pranshukesavmishra/SIH-2026/docs/media/site/hero_poster.jpg

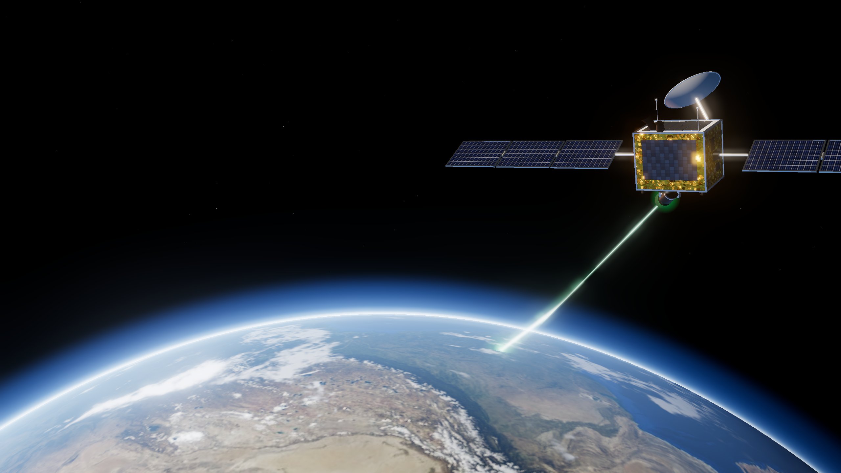
docs/media/site/hero_poster.jpg
