pranshukesavmishra/SIH-2026/docs/media/zerodrift_film_poster.jpg

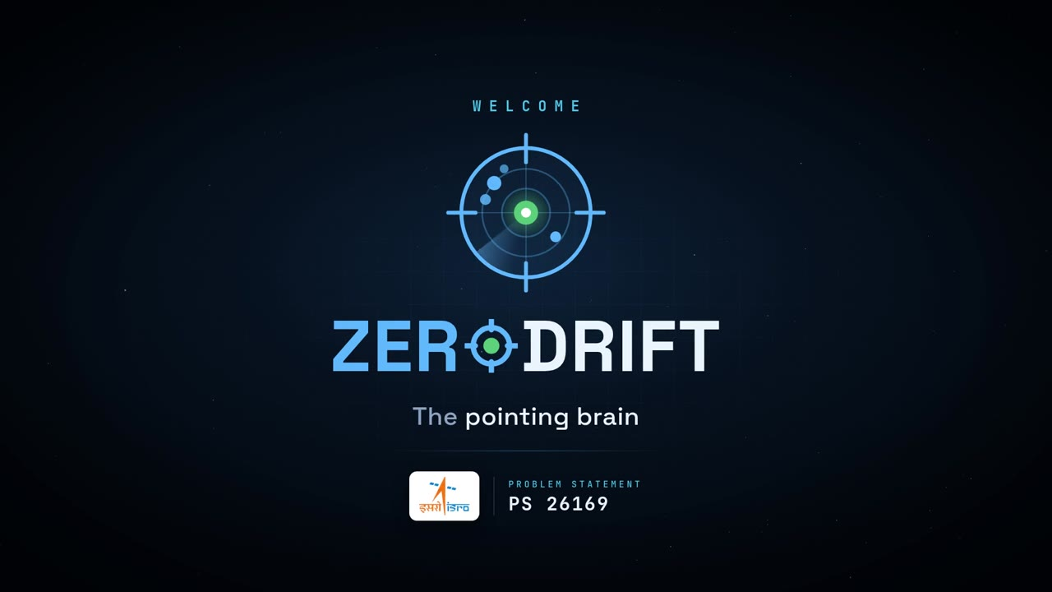
docs/media/zerodrift_film_poster.jpg
