pranshukesavmishra/SIH-2026/docs/cad/README.md

# ZeroDrift Mk3 — CAD

Parametric models of the build, written in OpenSCAD (free,
[openscad.org](https://openscad.org)) so they are text, diffable, and
regenerate from one source rather than being a binary someone has to
trust.

| File | What it is |
|---|---|
| `geometry.scad` | The numbers the mechanism imposes: the **picture-guide build** (no coupler, discs glued on with M-Seal, magnet on the shaft tip, M3 x 40 stilts under the bracket, head flat and centred on the small disc) |
| `geometry_legacy.scad` | Frozen copy of the earlier coupler + 14 mm riser + brass standoff layout, used only by `animate.scad`. The video and the PNG stills in `renders/` still show that earlier layout and have not been regenerated |
| `parts_lib.scad` | One module per BOM item, drawn at its real catalogue size |
| `zerodrift_full_assembly.scad` | Places those parts: rig, bench electronics, beacon, decoy |
| `animate.scad` | `$t` timeline: parts fly together, then the mechanism runs |
| `zerodrift_gimbal.scad` | Earlier single-axis model. **Superseded** by the full assembly; kept as a clean encoder illustration, and corrected so it no longer contradicts it |
| `renders/` | Rendered views, regenerated by the commands below |
| `*.stl` | Meshes for viewing or import; **see the printing warning** |

## Regenerating

`--colorscheme` is pinned on every line. Left off, OpenSCAD uses
whatever the local default is, and the four stills come back with
different backgrounds — which is exactly what happened once.

```sh
S="--colorscheme=Tomorrow --autocenter --viewall"
xvfb-run -a openscad -D 'view="all"'     $S -o renders/01_full_scene.png        --imgsize=2200,1400 zerodrift_full_assembly.scad
xvfb-run -a openscad -D 'view="rig"'     $S -o renders/02_rig.png               --imgsize=1600,1300 zerodrift_full_assembly.scad
xvfb-run -a openscad -D 'view="head"'    $S -o renders/03_head_detail.png       --imgsize=1500,1150 zerodrift_full_assembly.scad
xvfb-run -a openscad -D 'view="explode"' $S -o renders/04_exploded_labelled.png --imgsize=1700,2000 zerodrift_full_assembly.scad
```

## Regenerating the animation

```sh
for i in $(seq -w 0 179); do
  t=$(python3 -c "print($((10#$i))/180)")
  xvfb-run -a openscad -D "\$t=$t" -D 'LOWPOLY=true' --colorscheme=Tomorrow \
    --camera=0,-20,50,66,0,25,660 --imgsize=1120,840 \
    -o frames/f$i.png animate.scad
done
ffmpeg -framerate 30 -i frames/f%03d.png -c:v libx264 -pix_fmt yuv420p \
  renders/zerodrift_assembly.mp4
```

`LOWPOLY=true` is what makes this practical: it swaps the hulled
rounded boxes in `parts_lib.scad` for plain cubes, taking a frame from
111 s to about 0.9 s. The camera distance is set by the widest moment
of the fly-in, not by the assembled rig.

## Checking it

```sh
tools/cad/check_clearance.sh            # sweeps pan -180..180, tilt -25..25
```

It intersects the rig's three kinematic groups — `rig_fixed()`,
`rig_pan_deck()` and `rig_tilt_group()` — pair by pair at each pose,
and measures the **volume** of the overlap.

Volume, and compared against a baseline, because two kinds of honest
overlap exist. A shaft tip meeting the platform it drives appears as a
coplanar sheet of zero thickness. A shaft seated *inside* its hub — the
tilt magnet disc on the tilt motor shaft — is a real solid, a constant
~136 mm³ at every pose. Both are mounting interfaces. A mounting
interface is pose-independent; a clash shows up as **growth** above the
neutral-pose baseline, which is what the script flags.

The test drives the *shipped* modules rather than a simplified copy,
so it cannot drift away from the model it guards. That is also why
`geometry.scad` exists: the animation and the still model had already
drifted apart once, and both rendered perfectly while they did.

## Why there are no 3MF exports

OpenSCAD discards `color()` when it renders to a mesh, so a 3MF
exported from these files carries geometry and nothing else: its
colour groups come out empty. It would be the STL in a heavier
wrapper. Checked, not assumed — the head export had 21,525 triangles
and zero colour groups. For a coloured view, render a PNG or open the
`.scad` directly.

## Do not print the structural standoff

The STLs are for **viewing and fit-checking**, not for printing every
part. The head standoff specifically must be an **M3 brass standoff**
from the assortment already on the BOM. Printed in PLA at the 42 mm
length this build uses, carrying ~80 g of head:

| Material | Static droop | Natural frequency |
|---|---|---|
| Steel | 54 µrad (0.5 px) | 404 Hz |
| Aluminium / brass | 158 µrad (1.4 px) | 237 Hz |
| **PLA** | **3,109 µrad (28.5 px)** | **53 Hz** |

53 Hz sits on the 47 Hz platform mode `scenarios/ps26169_benchmark.yaml`
injects. A printed standoff is a resonator tuned to the disturbance the
whole design exists to reject.

## What building the model caught

Drawing the parts at real size next to each other surfaced four things
that reading the BOM did not:

1. **The 830-point breadboard does not fit on the base plate.** It is
   165 mm; the 6″ acrylic is 152.4 mm. It belongs on the bench beside
   the rig — which is better practice anyway, since §2E deliberately
   vibrates that plate and the control electronics are the last thing
   that should ride it.
2. **A 32 mm webcam PCB does not fit a 30 mm-tall box.** The head is
   72 × 46 × 42.
3. **The camera has to point out of the enclosure.** An early placement
   had the lens aimed into the box's own interior.
4. **A face-mounted stepper cannot sit shaft-up on a solid plate.** The
   shaft exits the same face that bolts down, so the pan motor hangs
   underneath and the shaft passes through a clearance hole.

## What the clearance sweep caught

Renders did not show any of these. Intersecting the kinematic groups
showed them:

5. **Both AS5600s were 12 mm off the axis they were measuring.** The
   arms reached part-way in and the chips were placed at the arms'
   inner ends rather than on the centreline. The AS5600 reads the
   *direction* of the field through its die; off-axis it returns a
   number that is not an angle, and it does so without complaint. Both
   feedback channels would have been dead on a rig that looked
   perfect. The placements are now derived from `geometry.scad`, with
   an `assert` on the air gap.
6. **The pan encoder post was inside the pan rotation.** It turned with
   the magnet it was supposed to measure — an encoder reading a
   constant.
7. **The tilt encoder arm reached down, through the pan platform.**
   It now reaches up over the shaft.
8. **The tilt bracket clipped the platform** because the platform was
   34 mm and the bracket 30 mm wide at 46 mm out. The platform is now
   60 mm, cut from the second sheet in the pack of two — no new part.
9. **The camera's service loop ran through the base plate.** Slack
   cable drawn to z = −4 mm, in 3 mm acrylic.
10. **The head hit the base plate at +17° of tilt.** The head hangs
    65 mm out from the tilt axis, so tilting down swings it into the
    table. The sweep showed it as interference at +25° at *every* pan
    angle at once, which is the signature of a range limit rather than
    a clash with one part. A plain L-bracket puts the tilt axis
    48 mm up; a **14 mm standoff riser** under the bracket lifts it to
    62 mm, which buys the full ±25° — and, as a side effect, lifts the
    whole tilt stage clear of the pan encoder post.
11. **The head clipped the pan platform at +21° of tilt** — and the
    first version of this test could not see it. It compared the frame
    against everything that moves, but the head and the platform are
    *both* carried by the pan shaft, so that pair was never compared.
    The rig is now split into three groups (frame, pan deck, tilt
    group) and all three pairs are tested.
12. **The superseded `zerodrift_gimbal.scad` had the same encoder
    fault** — chip 6.5 mm off-axis — and its "fixed" post stood at
    15–17 mm radius *inside* the 17 mm platform that sweeps past it.
    Worse, this README used to cite that file as the place to look for
    the encoder detail. Two models that disagree about the most
    failure-prone dimension in the build is how the drift started, so
    it is corrected rather than kept as a second opinion.

### Travel

Both limits below are measured by the sweep, not estimated. PS26169's
widest pattern asks for ±35° of pan and a few degrees of elevation, so
neither costs us anything — but they are real limits of the layout and
belong in the firmware as soft stops.

| Axis | Soft-limit to | First contact | Against |
|---|---|---|---|
| Pan | ±120° | −150° | the tilt bracket reaching the fixed encoder post |
| Tilt, toward the plate | +20° | +21° | **the pan platform** — the base plate is not reached until +30° |
| Tilt, away | −40° | clear past −45° | nothing within the swept range |

Tilt is asymmetric and the reason is worth knowing before anyone
"corrects" it: enlarging the platform to 60 mm, so the tilt bracket had
something to bolt to, is what put a ceiling on downward tilt. The head
meets the platform 9° before it would meet the base plate.

Each soft limit is the largest angle actually swept clear, not an
interpolation toward the contact. Re-run
`tools/cad/check_clearance.sh 10` to resolve the boundaries more finely
than the 30° grid.

Before the 14 mm riser, pan was bounded at +30° and tilt at +17°, which
is what made the riser worth four M3 standoffs from the assortment.

## The interactive page

`docs/assembly.html` is the model as a build guide you can scrub: the
picture guide's build, stage by stage (mechanics, then the wiring), each with the reason it goes there
and the mistake that part invites, then the mechanism runs and you can
orbit it freely.

It loads `docs/cad/web/*.stl` — one binary mesh per part, exported by
the `part=` mode in `zerodrift_full_assembly.scad`. Per part, because a
single fused mesh cannot be taken apart again, and **at zero pan and
zero tilt**, so the page articulates the two axes itself rather than
showing a frozen pose.

```sh
for p in base base_legs pan_motor pan_motor_screws platform platform_glue \
         pan_magnet_n pan_magnet_s pan_post pan_strip pan_sensor stilts bracket \
         tilt_motor tilt_motor_screws tilt_disc tilt_glue head_box head_camera \
         head_laser vibration; do
  xvfb-run -a openscad -D "part=\"$p\"" -D 'LOWPOLY=true' -o /tmp/$p.stl zerodrift_full_assembly.scad
  python3 ../../tools/cad/stl_to_binary.py /tmp/$p.stl web/$p.stl
done
```

Two decisions worth keeping:

- **Each part is exported in its final assembled position.** The page
  only animates an offset that decays to zero, so no transform chain is
  re-derived in JavaScript. Re-deriving one in a second language is
  exactly what put the camera on the ceiling the first time this model
  was built.
- **three.js is vendored under `docs/vendor/three`, not loaded from a
  CDN.** This page is meant to run at the demo table, and a demo that
  needs the internet is a demo that can fail on stage. It also pins the
  version instead of trusting whatever the CDN serves.

`stl_to_binary.py` exists because OpenSCAD only writes ASCII STL, which
is about five times the size. That is irrelevant for a file you open in
a viewer and very relevant for twelve of them over a network.
