pranshukesavmishra/SIH-2026/docs/LOCAL_HANDOFF_MOTORS.md

# Handoff: make the MK2 motors run + first live tracking test (local session)

Written 28 Sept 2026, updated same day once hardware moved to Aryan's **Windows PC**.
Read `CLAUDE.md` and `docs/LOCAL_HANDOFF.md` first (user, tone, tools). Commands below
give the Mac (`brew`, zsh) form first, Windows (PowerShell / Git Bash) form second —
check `arduino-cli version` / `echo $OS` or just ask Aryan which machine he's on before
running anything.

## Windows setup (if this is the Windows PC)
- Arduino CLI: easiest is the **Arduino IDE** installer (arduino.cc/en/software) — it can
  install boards/libraries with a GUI, and Aryan can watch it happen. `arduino-cli` alone
  also works: `winget install ArduinoSDA.arduino-cli` (or download the .zip and put
  `arduino-cli.exe` on PATH).
- `tools/rig/flash.sh` is a **bash script** — on Windows run it from **Git Bash** (installed
  with Git for Windows), not PowerShell/cmd directly. If Git Bash isn't installed, either
  install it, or drive `arduino-cli compile` / `arduino-cli upload` by hand with the same
  flags as in the script, or just use the Arduino IDE's own Upload button after opening
  `tools/rig/rig_firmware_v2.ino` and installing the **AccelStepper** and **Servo** libraries
  via Library Manager, board = "Arduino Nano", processor = **ATmega328P** (try "(Old
  Bootloader)" too if upload fails), port = whatever `COM#` shows up in Device Manager
  once the Nano is plugged in (CH340 driver may be needed for a clone Nano).
- Serial monitor from Git Bash: `arduino-cli monitor -p COM# -c baudrate=115200`.

## Where we are
- Aryan has wired the rig breadboard himself: Nano, 2× A4988 (red boards), TCA9548A mux,
  12 V adapter → 3-leg DC jack → toggle switch → TOP red rail. **His column layout is his own**,
  not `docs/wiring_plan.js`. Do not assume hole numbers; ask for a top-down photo if needed.
- 12 V chain: jack thin pin (+) → switch MIDDLE; switch outer → TOP red rail; jack round pin (−) → TOP blue rail.
- **AS5600 not wired yet.** Its header pins probably need soldering. Firmware runs fine without it
  (reports encoders=no / pan-only). Motors first, sensor later.

## Goal of this session
Motors turn on command from the laptop. Nothing else.

## Steps (do them in order, confirm each with Aryan)
1. **Wiring check with photos + multimeter, power OFF.** Per driver:
   VMOT→TOP red (+12 V), GND beside it→GND, VDD→5 V (NEVER 12 V), other GND→GND,
   EN→GND, MS1/MS2/MS3→5 V, RST↔SLP jumpered, STEP/DIR: pan D2/D3, tilt D4/D5.
   Blue rails joined; red rails NOT joined (beep test TOP red↔BOTTOM red = no beep).
   100 µF across VMOT/GND, stripe to GND. Heat sink on each A4988 chip, clear of the pot.
2. **Motor coil pairs:** multimeter Ω, pair = ~2–4 Ω. Pair 1 → 2B/2A, pair 2 → 1A/1B.
   Never plug/unplug a motor with 12 V on.
3. **Vref:** USB only, 12 V OFF. Black probe GND, red probe on the pot's metal top → 0.55 V. Both drivers.
4. **Flash:** `tools/rig/flash.sh rig` (installs AccelStepper). Serial 115200, newline endings.
5. **Power up:** USB in, then switch 12 V ON. Shafts should go stiff; nothing hot.
6. **Move** (serial monitor, e.g. `arduino-cli monitor -p <port> -c baudrate=115200`):
   `?` status · `!` self-test · `P200 T0` pan +200 steps · `P0 T0` back · `P0 T100` tilt ·
   `C` return to datum · `Z` zero here · `L1`/`L0` laser.
   200 steps = 22.5° at 1/16 microstep (8.889 steps/deg). Soft limits pan ±90°, tilt ±18°.
7. **Then the live page: CONNECT RIG → TEST MOTION.** No Python and no local server needed
   for this — `docs/live.html` does the webcam capture and the tracking math in the
   **browser** itself, and talks to the Nano straight from the page over the **Web Serial
   API**. That only works in **Chrome or Edge** (not Firefox/Safari), and only on a secure
   (https) or localhost page — the deployed site `https://zerodrift-fsoc-pat.netlify.app/live.html`
   already qualifies, so Aryan can just open that URL on the Windows PC, plug in the Nano,
   click **CONNECT RIG**, pick the Nano's port from the browser's own picker, allow the
   camera, then **TEST MOTION**. Pick **MK2** rig mode. Point the webcam at the beacon LED
   (blinking 4 Hz) to see it lock and track for real.
   - The separate Python engine (`pip install -e ".[gui,dev]"`, `python -m fsoc_pat.gui.app`)
     is for offline simulation/tests only — it is **not** part of this live hardware path.

## Troubleshooting
| Symptom | Likely cause |
|---|---|
| Motor buzzes, no turn | coil pair split across 1x/2x; re-pair |
| No holding torque | no 12 V at VMOT, EN not GND, RST↔SLP missing |
| Wrong direction | fine; or swap the two wires of ONE pair |
| Moves 16× too far/short | MS1-3 not all at 5 V |
| Driver hot / cuts out | Vref too high, heat sink missing |
| Upload fails | close other serial monitors; CH340 driver; try another cable |

## Status after 29 Sept 2026 night session — READ THIS FIRST next time

Confirmed working: Nano (COM5 on the Windows PC), firmware flash, serial link, laser
(direct-to-Nano-pin: D7 → laser S, a Nano GND pin → laser −). Motors NOT confirmed
moving yet. Do not repeat this session's mistakes:

1. **Driver 1 is likely damaged.** Its `VDD` pin got 12 V by accident (rail mix-up —
   there are two red rails, one 5 V one 12 V, easy to grab the wrong one) and it
   overheated hard, repeatedly, even on USB power alone afterwards. Set it aside.
   Don't reuse it until it's checked (resistance GND↔VDD and GND↔VMOT, both should be
   high/open, not near 0). Driver 2 (the one with the heatsink) is the one to build on.
2. **Vref was never set on either driver.** This is probably the real root cause of
   the overheating, more than the rail mix-up alone: the pot was left at factory
   default, so the driver was pulling far more current than the small NEMA17 needs.
   **Do not apply 12 V to any driver again until Vref is set to ~0.55 V** (USB only,
   12 V off, black probe GND, red probe on the pot's metal screw top). This needs a
   **small flat screwdriver/pick** (eyeglass-repair screwdriver, SIM eject tool, or
   similar) that wasn't available this session — get one before the next hardware
   session.
3. **A 12 V jumper wire melted** (the jack's − wire, thin dupont wire carrying motor
   current). Thin jumper wire is only rated for ~1 A logic signals, not the 1–2 A a
   NEMA17 can pull. **Get 18–22 AWG stranded hookup wire for the whole 12 V run**
   (jack → switch → VMOT/rail) before testing 12 V again — don't reuse the melted
   section. A cheap interim fix if no thick wire is on hand: 2–3 thin jumper wires
   twisted together in parallel for that run only.
4. **Testing gotcha (mine, not Aryan's):** closing a `System.IO.Ports.SerialPort`
   connection right after writing a command can reset the Nano via DTR before the
   command's effect is visible — looked like "nothing happened" several times when it
   was actually the test script wiping the command. Fix: set `DtrEnable = $false`
   before `Open()`, and hold the connection open for several seconds after sending a
   command before closing it, or don't close it at all until done testing.
5. **Breadboard note:** the first breadboard used had a real gap partway along its
   rails (visually near hole ~30) with no continuity across it, causing a lot of the
   early "nothing works" confusion. Aryan swapped to a second breadboard and confirmed
   its rails are continuous (multimeter continuity check) before rewiring. Use the new
   one; if in doubt on any board, re-check continuity before trusting a rail.

**Next session should do, in order:** get a small screwdriver + thick 12 V wire →
wire driver 2 fresh (VDD→5V rail, GND→5V-side blue, EN→blue, MS1-3→5V rail,
RST↔SLP jumpered, STEP→D2, DIR→D3, VMOT→12V-side red rail, GND-near-VMOT→12V-side
blue) → set Vref to 0.55 V *before* connecting 12 V → power up cautiously (12 V on
a few seconds at a time, checking heat each time) → `P200 T0` pan test.

## AS5600 (later, separate step)
Solder the header (short end into the board). Wire: mux VIN→5 V, GND→GND, SDA→A4, SCL→A5,
A0/A1/A2→GND; mux SD0/SC0 → AS5600 SDA/SCL; AS5600 VCC→5 V, GND→GND, DIR→GND.
Magnet 1–2 mm above the chip, centred. Firmware then reports `encoders=pan`.

## Rules
Power on: USB then 12 V. Off: 12 V then USB. Stop with the switch at any sign of heat or smell.
