pranshukesavmishra/SIH-2026/docs/DELIVERABLES.md

# ZeroDrift Mk3 — everything, in one place

Team ZeroDrift · Jabalpur Engineering College · SIH 2026 · **PS26169 (ISRO)**

---

## 1. Buy this

| File | What it is |
|---|---|
| `submission/ZeroDrift_BuyList_OnePage.pdf` | **₹6,709**, 35 items, one row each, with a picture per row, Amar/Blinkit/Online routing boxes, and 8 scannable QR codes for the parts where the wrong item looks like the right one. Page 2 is tools. |
| `submission/ZeroDrift_StillToBuy.pdf` | **₹1,747, 4 lines** — only what is still missing, one card each with why it's needed, what to check on the listing, and the trap that makes people buy the wrong thing. |
| `data/bom_tier_a.json` | The single source of truth. All three PDFs and the build doc's §2 table generate from it; `tests/test_bom_consistency.py` enforces that they agree. |

### Still to buy — ₹1,747
Full detail with traps and listing checks: **`submission/ZeroDrift_StillToBuy.pdf`**
(generated by `tools/bom/render_tobuy.py` from the same JSON as everything else).

| Item | Qty | Line | Note |
|---|---|---|---|
| AS5600 encoder | **2** | ₹498 | Both are fixed at I²C 0x36 — hence the mux |
| TCA9548A multiplexer | 1 | ₹199 | PCA9548A is interchangeable |
| USB webcam, UVC | 1 | ₹800 | An ordinary webcam, not an M12 "board camera" — those are an industrial category at ₹2,000–5,000, and OV7670/OV2640 are parallel DVP with no USB at all |
| 3S 12.6 V balance charger | 1 | ₹250 | **Not** a single-cell charger — your pack is 3 cells in series |

### Nothing new to buy after the CAD audit
The clearance sweep changed the geometry but **not the shopping list**.
The pan platform grew from 34 mm to 60 mm — cut it from the **second
sheet in the acrylic pack of 2** you are already buying. Both encoder
arms are M3 brass standoff plus an acrylic offcut, from the ₹150
assortment. **Total stays ₹6,709.**

### Three that stop the build dead
1. **Magnets must say DIAMETRIC.** Axial looks identical, reads a constant, both feedback axes dead. Spin one next to a phone compass: the needle must flip twice per rotation.
2. **Buy the 100 µF caps.** ₹20. Without them both A4988s die on first power-up.
3. **Set A4988 Vref to 0.5–0.6 V before attaching a motor.** Needs the multimeter; there is no way to do it by eye.

---

## 2. Build it

| File | What it is |
|---|---|
| `submission/ZeroDrift_Mk3_Build_Guide.pdf` | Full guide: BOM, wiring, build order, calibration |
| `TERMINAL_MK3.md` | The source of that guide, and the authority |
| `cad/renders/04_exploded_labelled.png` | **Start here.** Exploded, numbered 1–9 in the same order as the build stages |
| `cad/renders/05_encoder_detail.png` | The encoder mount close up — match this before gluing a magnet |
| `cad/renders/zerodrift_assembly.mp4` | The assembly animating together, then the mechanism tracking |
| `cad/README.md` | What building and sweeping the model caught — nine faults, none visible in a render |
| `../tools/cad/check_clearance.sh` | Re-runs the interference sweep against the shipped model |
| `cad/renders/01_full_scene.png` | Rig + bench electronics + beacon + decoy |
| `cad/*.scad` | Editable source — `geometry.scad` holds the numbers the mechanism imposes |
| `cad/*.stl` | Meshes for viewing or import. Regenerate after any source change: the ones committed before the clearance audit had both encoders off-axis |

**Travel is mechanically limited — soft-limit it in firmware.**

| Axis | Limit | Stopped by |
|---|---|---|
| Pan | ±120° | tilt bracket vs the fixed encoder post |
| Tilt, down | +20° | **the pan platform** (the base plate is 9° further) |
| Tilt, up | −40° | nothing in range |

The benchmark's widest pattern asks for ±35° of pan and a few degrees
of elevation, so none of this costs us anything — but they are real
limits of the layout, measured by `tools/cad/check_clearance.sh`, not
estimated.

**Do not print the head standoff.** Use an M3 brass standoff from the
assortment. In PLA it droops 28.5 px and resonates at 53 Hz — sitting on
the 47 Hz platform mode the benchmark injects.

---

## 3. Present it

| File | What it is |
|---|---|
| `submission/ZeroDrift_SIH26169.pptx` | The deck. Slide 6 is the PS26169 compliance table |
| `PS26169_COMPLIANCE.md` | Every spec row, what we measured, and what is still open |
| `PPT_COMPLIANCE_SLIDE.md` | Why the compliance table belongs in the deck and the PS text does not |

### Where we stand against the spec — honestly

**Met (11):** camera resolution, FOV, update rate, pan/tilt speed, target
shape and size, ≥4 motion patterns including Figure-of-8, all three noise
types with salt-and-pepper at the specified 10%, camera jitter, linear
platform motion, all five atmospheric conditions, MP4 input bypassing the
PTZ camera.

**Open (3):**

| Row | Spec | Ours |
|---|---|---|
| Acquisition time | ≤ 2 s | 25.3 s → **3.53 s** |
| Tracking error (median) | ≤ 10 px | 2,367 → **170 px** |
| Processing speed | ≥ 20 FPS | **9.2 FPS** |

The arrows are before → after our own fix, **both measured with the full
specified disturbance present**. A constant-velocity platform drift is a
ramp, and a PD loop has finite steady-state error to a ramp — wrong loop
order, not bad tuning. Adding a second integrator (type 2, leaky) cut
acquisition 7× and median error 14×. It is implemented and shipped. It is
not yet enough, and the slide says so.

---

## 4. Run it

```sh
fsoc-pat scenarios/ps26169_benchmark.yaml          # GUI
python -m fsoc_pat.runner scenarios/ps26169_benchmark.yaml   # headless report
python -m fsoc_pat.runner scenarios/ps26169_benchmark.yaml --atmosphere fog
python -m fsoc_pat.hil.serve --video clip.mp4     # Benchmark-2 path
pytest tests/ -q                                   # full suite
```

`scenarios/ps26169_benchmark.yaml` encodes the evaluators' table and
nothing else. Every performance number we publish is measured on it.
