pranshukesavmishra/SIH-2026/docs/submission/ZeroDrift_SIH26169.pptx

## SMART INDIA HACKATHON 2026

TITLE PAGE

- Problem Statement ID – 26169
- Problem Statement Title – AI-Based Virtual Camera Tracking System for Coarse Alignment of Mobile FSOC Terminals
- Theme – Smart Automation
- PS Category – Software
- Team ID – —
- Team Name – ZeroDrift

The problem in one line: a mobile laser (FSOC) terminal must find, verify and continuously point at its partner's beacon with hair-thin accuracy — ISRO asks for this coarse-alignment brain, proven entirely in software.

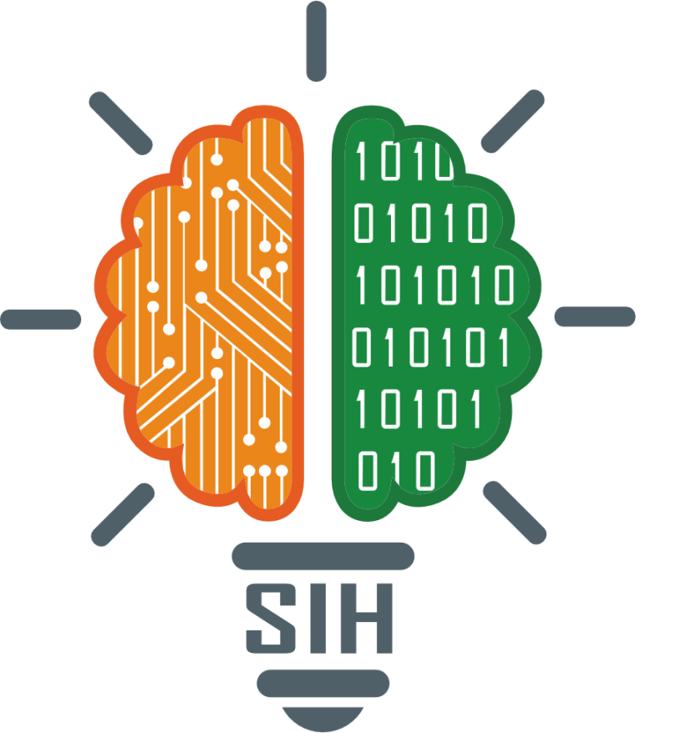
[picture p3: figure]
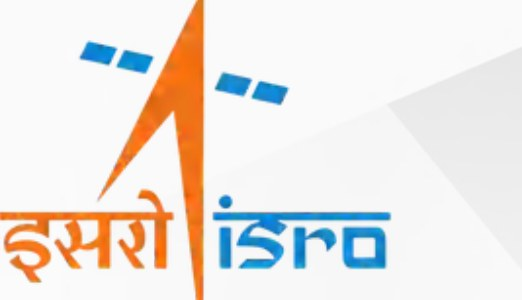
[picture p4: figure]
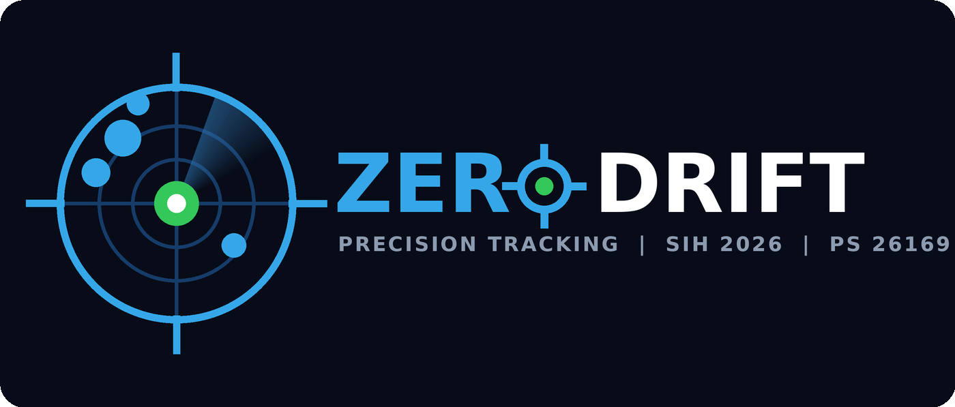
[picture p5: figure]

## IDEA TITLE

- Proposed Solution (Describe your Idea/Solution/Prototype)
- Detailed explanation of the proposed solution
- How it addresses the problem
- Innovation and uniqueness of the solution

ZeroDrift

Problem in one line: find the partner's blinking beacon among stars and glints, verify it, and hold it centred to micro-radian accuracy — automatically, in software.

Our answer — the eyes & neck of a laser terminal: simulate the sky · verify the beacon · track & predict. Built, measured, live.

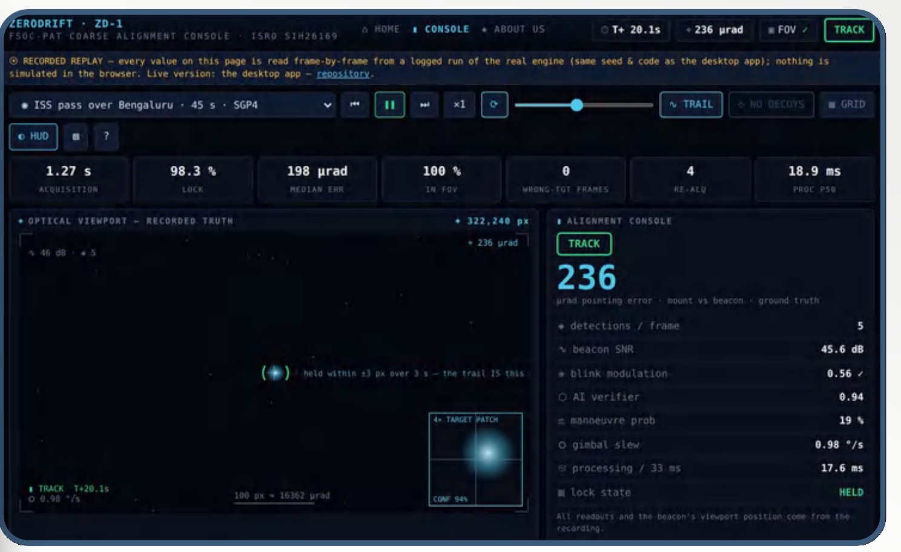
[picture p6: figure]
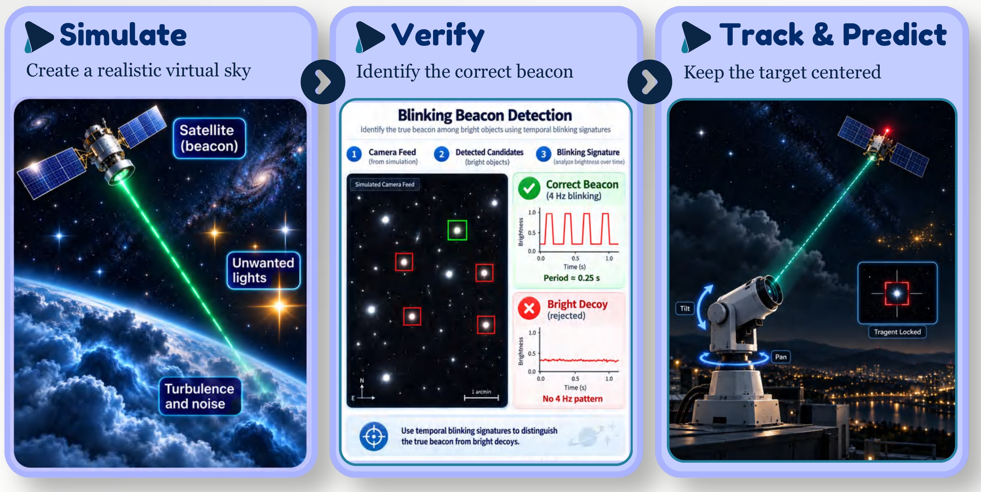
[picture p7: figure]

Our console locked on the beacon — the exact view the live demo link opens

Measured: median 198 µrad in lock · in-FOV 100% · the live-demo run

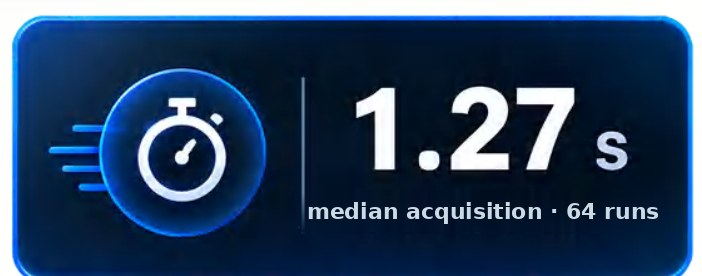
[picture p8: figure]
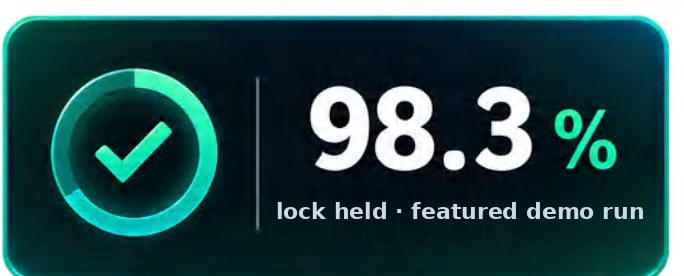
[picture p9: figure]
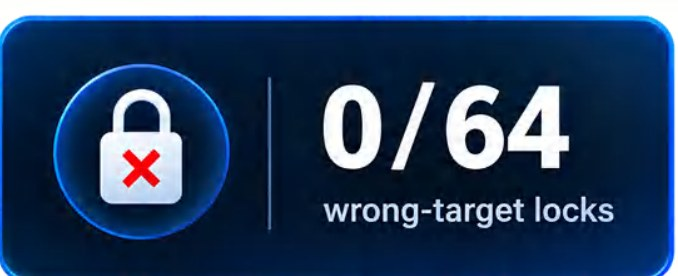
[picture p10: figure]
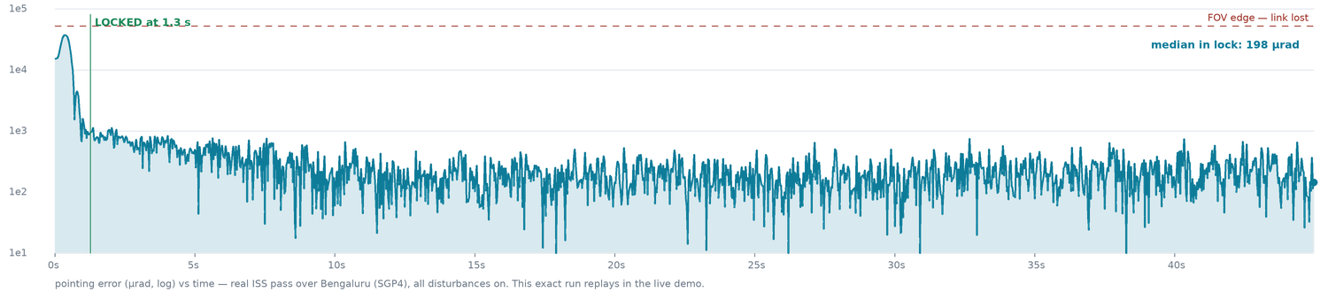
[picture p11: figure]

Team ZeroDrift · SIH 2026 · PS 26169

## TECHNICAL APPROACH

ZeroDrift

- Technologies to be used (e.g. programming languages, frameworks, hardware)
- Methodology and process for implementation (Flow Charts/Images/ working prototype)

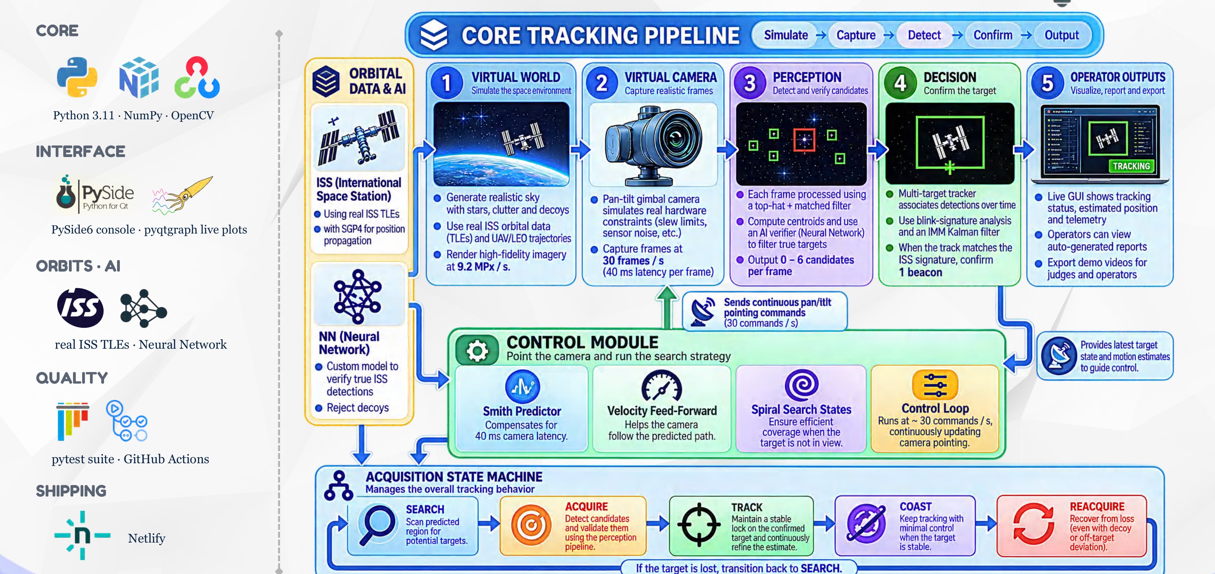
[picture p12: figure]

## FEASIBILITY AND VIABILITY

ZeroDrift

- Analysis of the feasibility of the idea
- Potential challenges and risks
- Strategies for overcoming these challenges

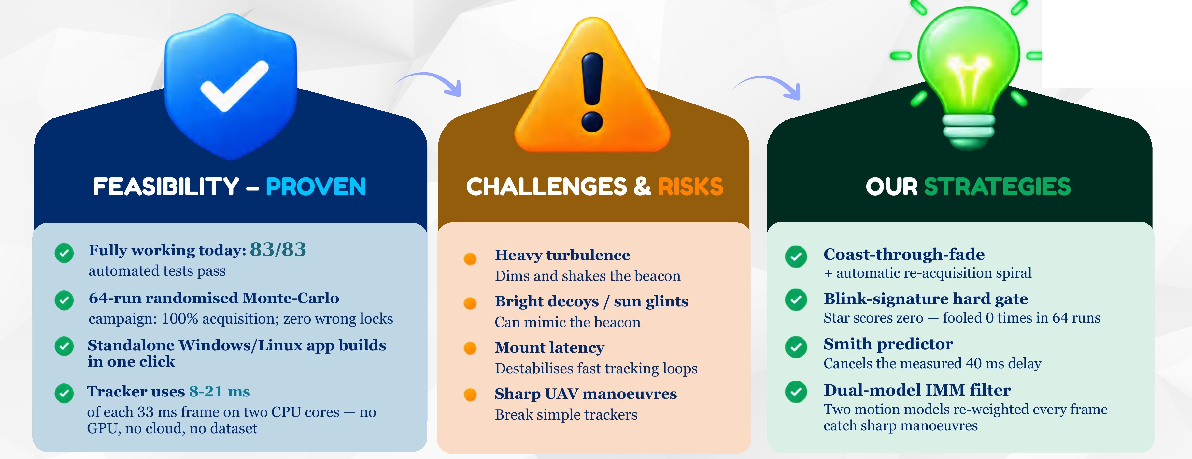
[picture p13: figure]

Worst case, 64 runs → never a wrong lock, never a failed acquisition.

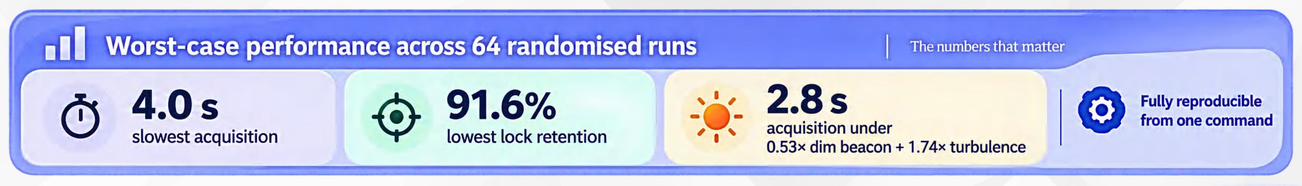
[picture p14: figure]

Reproducible: every number regenerates from one command.

## IMPACT AND BENEFITS

ZeroDrift

ECONOMIC FEASIBILITY — the arithmetic that removes the cost barrier

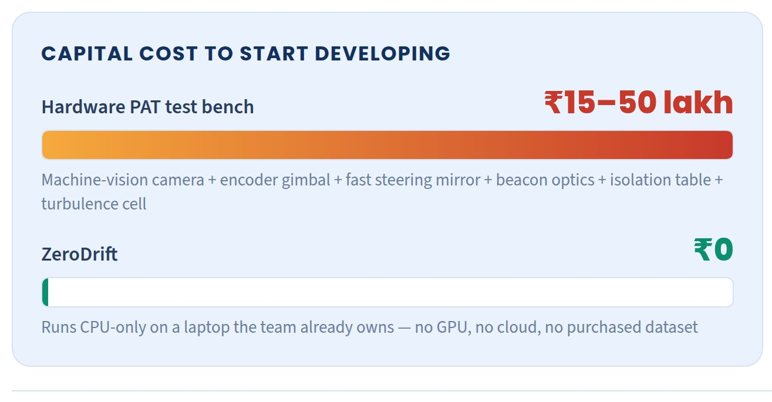
[picture p15: figure]

- Potential impact on the target audience
- Benefits of the solution (social, economic, environmental, etc.)

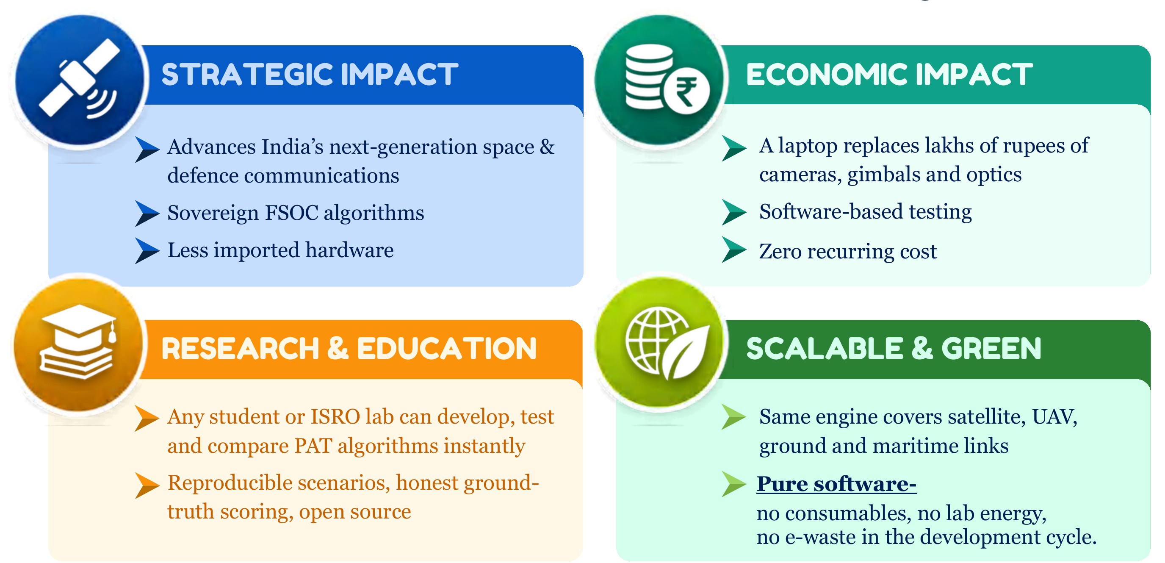
[picture p16: figure]
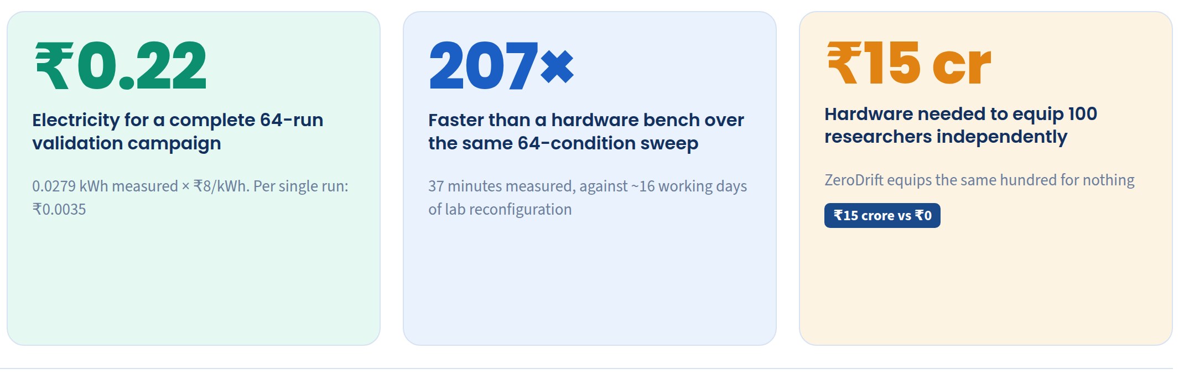
[picture p17: figure]
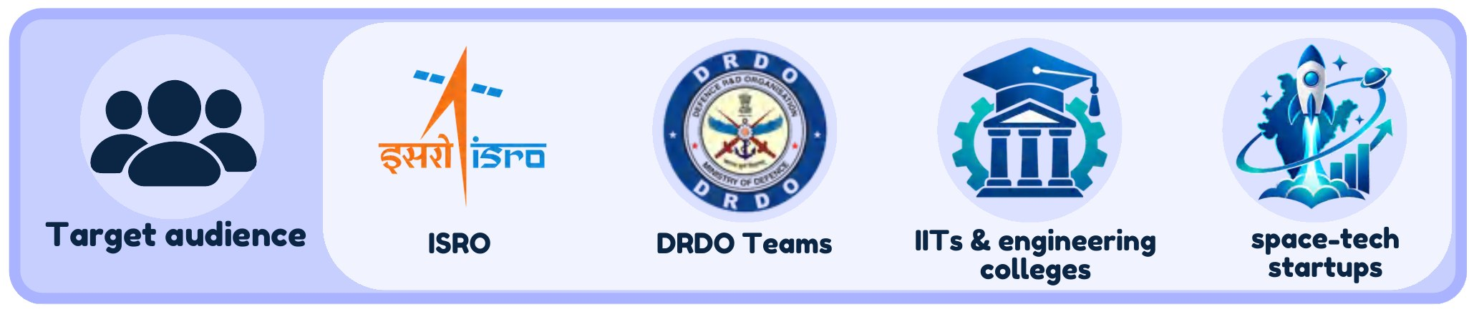
[picture p18: figure]
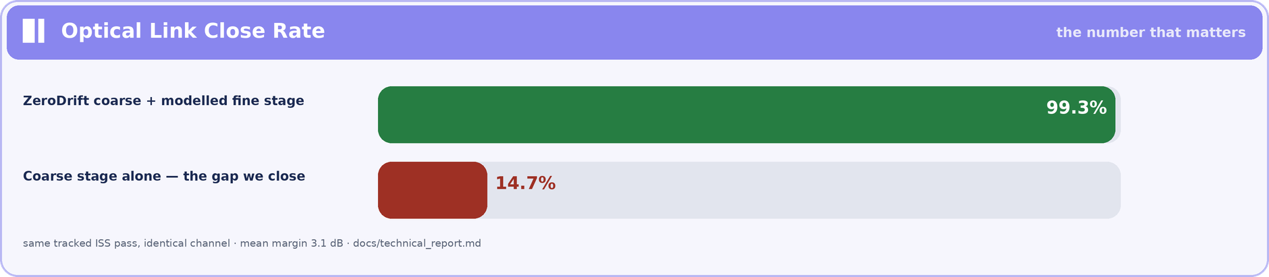
[picture p19: figure]

## RESEARCH AND REFERENCES

ZeroDrift

Research foundations

Kaymak et al., “A Survey on Acquisition, Tracking and Pointing Mechanisms for Mobile FSO,” IEEE Comm. Surveys & Tutorials, 2018. [link] (https://scholar.google.com/scholar)
Kaushal & Kaddoum, “Optical Communication in Space: Challenges and Mitigation Techniques,” IEEE CS&T, 2017. [link] (https://scholar.google.com/scholar)
Blackman & Popoli, Design and Analysis of Modern Tracking Systems — IMM filtering, CFAR detection. [link] (https://scholar.google.com/scholar)
Bar-Shalom et al., Estimation with Applications to Tracking and Navigation — Kalman/IMM theory. [link] (https://scholar.google.com/scholar)
Smith, O.J.M., “Closer Control of Loops with Dead Time” — the Smith predictor, 1957. [link] (https://scholar.google.com/scholar?q=%22Closer+Control+of+Loops+with+Dead+Time+Smith%22)
Vallado & Crawford, “SGP4 Orbit Determination” — AIAA 2008; real ISS TLE propagation. [link] (https://scholar.google.com/scholar?q=%22SGP4+Orbit+Determination+Vallado+Crawford%22)
Andrews & Phillips, Laser Beam Propagation through Random Media — turbulence & scintillation. [link] (https://scholar.google.com/scholar)

- Details / Links of the reference and research work

Our work — open and verifiable

Repository: github.com/pranshukesavmishra/SIH-2026
Live demo (replay console): zerodrift-fsoc-pat.netlify.app
Inside: 5,500+ documented lines · 83 automated tests · 6 validated scenarios · Monte-Carlo logs · technical report · user manual · demo video.
Reproducible: every figure regenerates from one command; every random draw is logged and replayable.

Compared with existing approaches

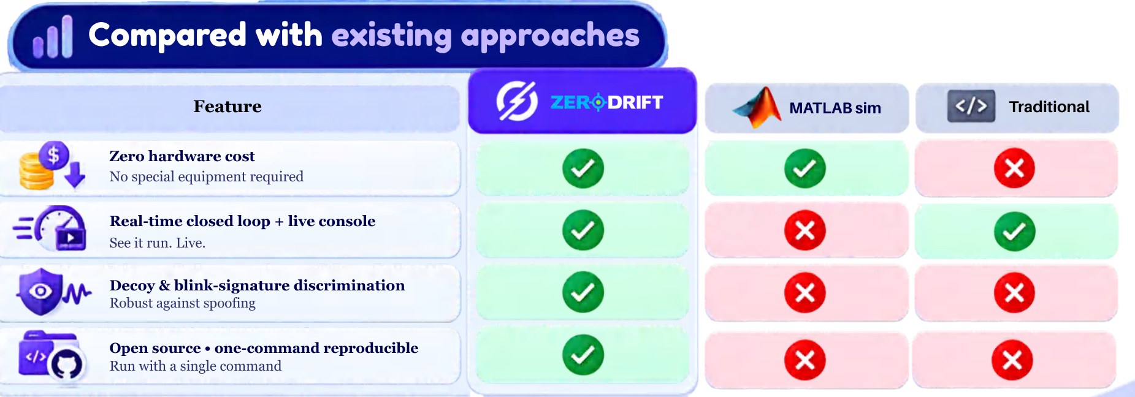
[picture p20: figure]

Why ZeroDrift wins on this problem
✓ All six mandatory deliverables already exist today
✓ Judged numbers, honestly measured against hidden ground truth
✓ AI where it earns its place — benchmarked against classical methods

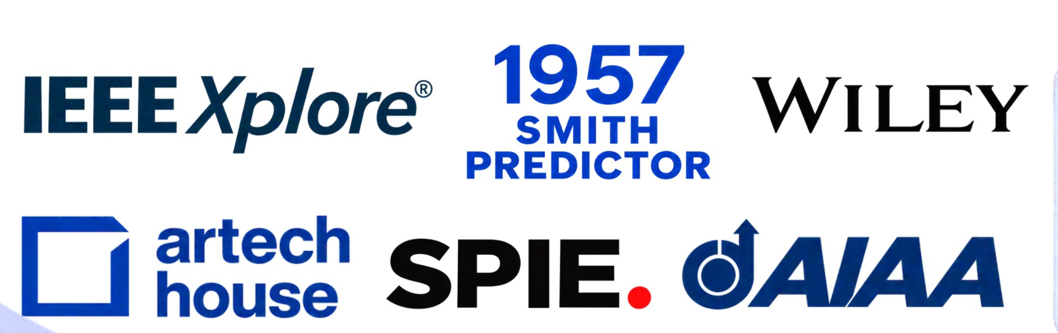
[picture p21: figure]
