pranshukesavmishra/SIH-2026/docs/submission/deck_src/ZeroDrift_SIH26169.pptx

## SMART INDIA HACKATHON 2026

TITLE PAGE

- Problem Statement ID – 26169
- Problem Statement Title – AI-Based Virtual Camera Tracking System for Coarse Alignment of Mobile FSOC Terminals
- Theme – Smart Automation
- PS Category – Software
- Team ID – —
- Team Name – ZeroDrift

The problem in one line: a mobile laser (FSOC) terminal must find, verify and continuously point at its partner's beacon with hair-thin accuracy — ISRO asks for this coarse-alignment brain, proven entirely in software.


## IDEA TITLE

- Proposed Solution (Describe your Idea/Solution/Prototype)
- Detailed explanation of the proposed solution
- How it addresses the problem
- Innovation and uniqueness of the solution

ZeroDrift

THE PROBLEM why pointing is the hard part

Laser beams are hair-thin. Both terminals must stay pointed at each other to micro-radians, on platforms that move and shake.

Kaymak et al., IEEE Commun. Surveys & Tutorials 20(2), 2018

µrad

OUR SOLUTION — ZERODRIFT the eyes and neck of a laser terminal


The record 100 Gbps link to a moving drone stayed up only because a camera tracked the target (10 Hz vision + 200 Hz tip/tilt).

Walsh et al., Scientific Reports 12, 2022

100 Gbps


64 simulated LEO passes

03
Measured, not claimed
250 passing tests. Every number on these slides regenerates from one command.

Free-space optics costs about one-fifth of laying fibre and deploys in hours — India's last-mile and disaster links need it mobile.

TEC / DoT, White Paper on Free Space Optics

ISRO PS26169 asks for the coarse-alignment brain:
find the partner's beacon among stars, glints and decoys, prove it is the right one, and hold it centred — in software.

1/5 cost

01
Identity, not brightness
Locks only on the 4 Hz blink. Lamps, stars, glints and wrong-rate strobes are rejected.

Team ZeroDrift · SIH 2026 · PS 26169

02
Built and running
Live webcam demo, MK1 servo rig, MK2 stepper terminal — ₹6,709 bill of materials.

≤ 2 s acquire

≤ 10 px error

≥ 20 FPS

## TECHNICAL APPROACH

ZeroDrift

6 Gimbal
2× NEMA17 steppers
AS5600 angle feedback

1 Camera
640×480 · 30 fps
rides the gimbal, boresighted

- Technologies to be used (e.g. programming languages, frameworks, hardware)
- Methodology and process for implementation (Flow Charts/Images/ working prototype)

2 Detect
salt & pepper filter
sub-pixel spots · CFAR

3 Identify
4 Hz blink test
decoys + wrong rates vetoed

4 Track
IMM Kalman filter
coasts the dark half-cycle

5 Control
Smith predictor
type-2 loop cancels drift

closed optical loop — the camera moves with the laser, so the error is measured on the image itself

STATE MACHINE

SEARCH

→

ACQUIRE

→

TRACK

⇄

COAST

→

REACQUIRE

BUILT WITH
Engine
Python · NumPy · OpenCV
Web demo
JavaScript · three.js · Web Serial
Hardware
Arduino Nano · A4988 · AS5600
Proof
pytest · 250 tests · GitHub Actions
Acquisition
0.55–1.1 s in the live demo

## FEASIBILITY AND VIABILITY

ZeroDrift

- Analysis of the feasibility of the idea
- Potential challenges and risks
- Strategies for overcoming these challenges

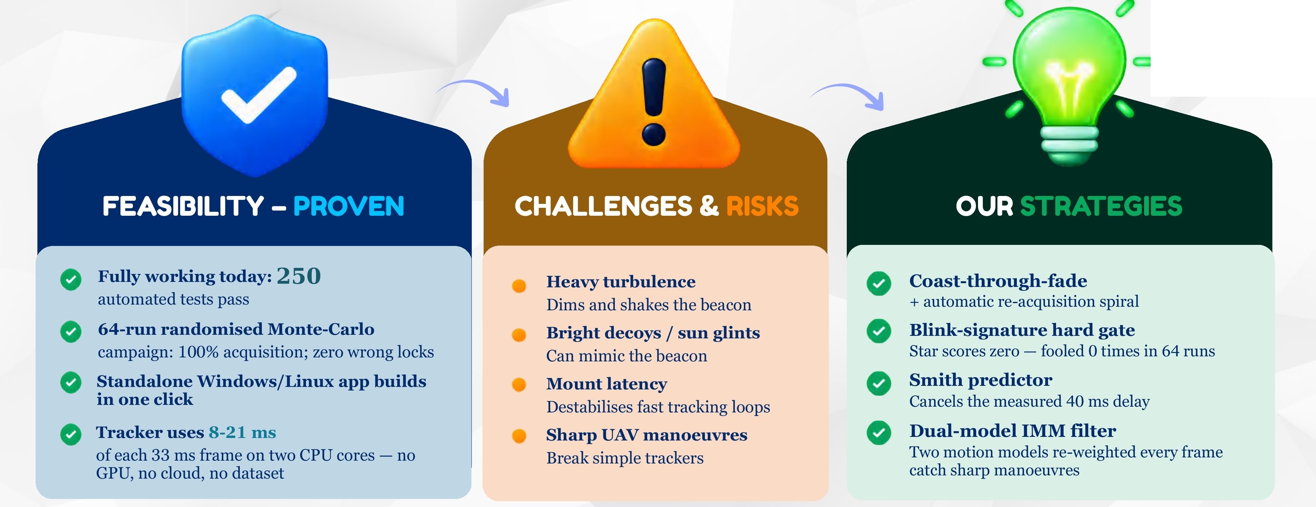
[picture p22: figure]

64 runs, our LEO scenarios → never a wrong lock, never a failed acquisition.


Reproducible: every number regenerates from one command.

## IMPACT AND BENEFITS

ZeroDrift

ECONOMIC FEASIBILITY — the arithmetic that removes the cost barrier


- Potential impact on the target audience
- Benefits of the solution (social, economic, environmental, etc.)


## PS26169 compliance: their table, our values

ZeroDrift

PS26169 PARAMETER

SPECIFIED

ZERODRIFT

Camera resolution

Camera FOV

640 x 480

4° x 3° default

640 x 480

4° x 3°

✓

✓

Camera update rate

Max pan / tilt speed

≥ 30 Hz

5-10°/s, default 5

30 Hz

5°/s

✓

✓

Target shape / size

Motion patterns

square, 10 x 10 px

≥ 4, incl. Figure-of-8

square, 10 x 10 px

7, incl. Figure-of-8

✓

✓

Image noise

Camera jitter

S&P ~10%, Gaussian, Poisson

± 20 px / frame

all three, S&P at 10%

19.8 px p99, measured

✓

✓

Platform motion

Atmospheric conditions

± 20 px / frame, linear

Clear / Haze / Fog / Rain / Low light

linear drift, 6 px / frame

all five

✓

✓

MP4 input, bypassing PTZ

Acquisition time

required (Benchmark-2)

≤ 2 s

--video, working

25.3 s → 3.53 s — open

✓

✗

Tracking error (median)

Processing speed

≤ 10 px

≥ 20 FPS

2,367 → 170 px — open

9.2 → 14.7 FPS — open

✗

✗

The three open rows are open, not footnoted. Arrows are before → after our own fix, both measured with the full specified disturbance present. A constant-velocity platform drift is a ramp, and a PD loop has finite steady-state error to a ramp — wrong loop order, not bad tuning. Adding a second integrator (type 2, leaky) cut acquisition 7x and median error 14x. It is implemented and shipped; it is not yet enough.
Every figure regenerates from scenarios/ps26169_benchmark.yaml, which encodes their table and nothing else.

## RESEARCH AND REFERENCES

ZeroDrift

Research foundations

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

- Details / Links of the reference and research work

Our work — open and verifiable

Repository: github.com/pranshukesavmishra/SIH-2026
Live demo (replay console): zerodrift-fsoc-pat.netlify.app
Inside: 5,500+ documented lines · 250 passing tests · 6 validated scenarios · Monte-Carlo logs · technical report · user manual · demo video.
Reproducible: every figure regenerates from one command; every random draw is logged and replayable.

Compared with existing approaches


Why ZeroDrift wins on this problem
✓ All six mandatory deliverables already exist today
✓ Judged numbers, honestly measured against hidden ground truth
✓ AI where it earns its place — benchmarked against classical methods
