pranshukesavmishra/SIH-2026/docs/submission/ZeroDrift_Slides_2_3.pdf

ZeroDrift | ZERODRIFT

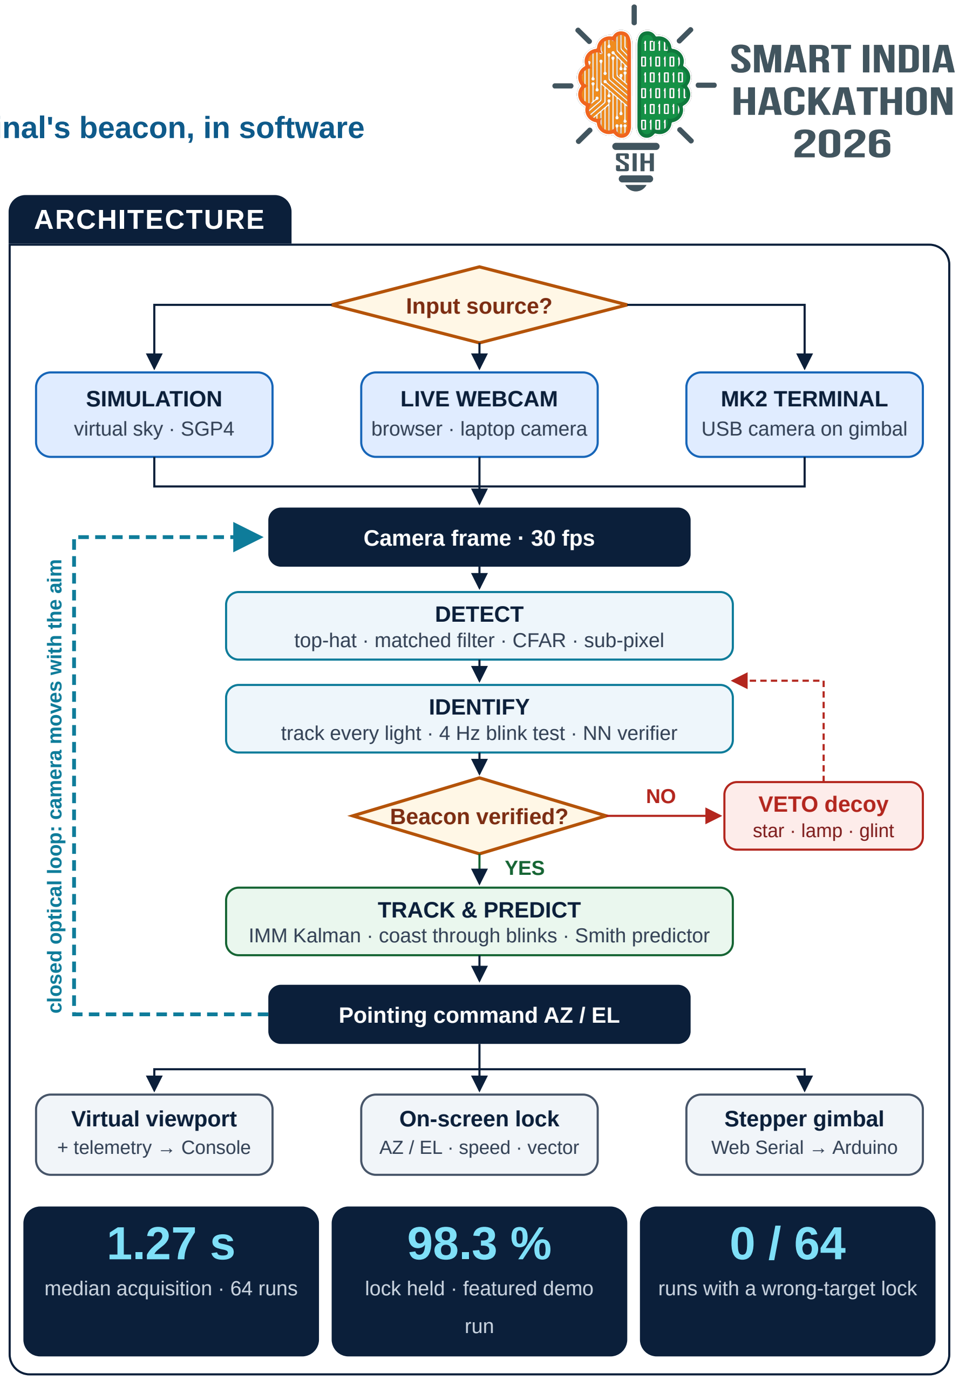
[picture p75: figure]
ARCHITECTURE; Input source?; SIMULATION virtual sky · SGP4; LIVE WEBCAM browser · laptop camera; MK2 TERMINAL USB camera on gimbal; Camera frame · 30 fps; DETECT; IDENTIFY; Beacon verified?; VETO decoy; star · lamp · glint; YES; TRACK & PREDICT; Pointing command AZ / EL; Virtual viewport + telemetry → Console; On-screen lock AZ / EL · speed · vector; Stepper gimbal Web Serial → Arduino; median acquisition · 64 runs; lock held · featured demo; run; runs with a wrong-target lock

| AI virtual-camera tracking that finds, identifies and holds the partner terminal's beacon, in software ❖ Proposed solution · Detailed explanation · How it addresses the problem · Innovation and uniqueness

## PROBLEM EXISTING

## Micro-radian aim

### A hair-thin laser must stay on target while vehicles, drones and masts

move. (Kaymak 2018)

## Wrong-target lock

| Stars, glints and lamps look like the

### beacon; brightness-only trackers

lock the wrong light.

| Delay & dropouts ≈40 ms command lag and blink gaps drop the beam, forcing slow manual re-alignment.

## PROPOSED SOLUTION

We propose ZeroDrift: software that finds the partner's 4 Hz beacon in a camera image, proves it is the right light and steers the terminal to hold it centred: PS26169 solved without special hardware.

### Physics-true virtual camera

SGP4 orbits, turbulence, decoys: tested before hardware

### Detect

| top-hat · matched filter · CFAR · sub-pixel
Identify 4 Hz blink test + neural verifier: 0 / 64 wrong locks | Track & coast IMM Kalman holds through blinks: 98.3 % held

### Control

Smith predictor cancels the command delay: 198 µrad median error, lock in 1.27 s

## UVP (UNIQUE VALUE PROPOSITION)

### Identity, not brightness

Locks only on the blink signature

### Delay-cancelled loop

Error measured on the image itself

### One engine, 3 modes

Simulation · webcam · MK2
terminal

### Measured, not claimed

Open source · 250 passing tests top-hat · matched filter · CFAR · sub-pixel

track every light · 4 Hz blink test · NN verifier

IMM Kalman · coast through blinks · Smith predictor closed optical loop: camera moves with the aim

Team ZeroDrift · SIH 2026 · PS 26169 | 2

ZeroDrift | TECHNICAL APPROACH From camera frame to laser command: the flowchart, the architecture and the stack behind it ❖ Technologies to be used · Methodology and process for implementation (flow charts / images / working prototype)

### SOFTWARE FLOWCHART · src/fsoc_pat (pipeline · detection · tracking · control)

① SENSE: every frame

② DECIDE: identify the beacon

③ ACT: state machine SEARCH → ACQUIRE → TRACK ⇄ COAST → REACQUIRE

START
new frame (33 ms)

PREPROCESS
top-hat removes sky glow,
cloud, sun halo

DETECT
matched filter + CFAR
threshold (fixed false-alarm)

EXTRACT
sub-pixel centroid of
each point (~6 / frame)

Any
candidate? | NO: nothing in view

YES

TRACK ALL
one IMM Kalman
per light

IDENTIFY
Goertzel 4 Hz blink power
+ neural verifier score

Blink signature
matches?
NO | VETO star · lamp · glint · wrong-rate strobe

next candidate

YES: this is the beacon

Error small
for N frames?

NO

ACQUIRE
steer toward it → next frame
YES | TRACK lock confirmed, error measured on the image
PREDICT
Smith predictor + IMM
feed-forward cancel 40 ms

OUTPUT
AZ / EL command to the
gimbal or virtual viewport camera moves with the aim → next frame

checked every frame

Beacon dark /
not detected?
YES | COAST keep following the prediction
Seen again in
coast window?

YES → back to TRACK

NO

REACQUIRE
small spiral at the
last good position

Found?

YES

NO

SEARCH
spiral scan, widens ×1.5 per empty cycle (≤ 25°) → next frame

EVERY FRAME → TELEMETRY LOG

state · error µrad · detections · blink score slew rate · compute time (8–21 ms)

→ Console replay + test record
→ 64-run Monte-Carlo campaign → acceptance tests (pytest, CI)

### SYSTEM ARCHITECTURE · WHAT HAPPENS TO EVERY FRAME

ORBITAL DATA & AI

ORBIT DATA
real ISS TLEs + SGP4

NEURAL VERIFIER
rejects false candidates
CORE TRACKING PIPELINE | one frame every 33 ms

### 1 VIRTUAL WORLD

- decoys

stars, clutter + decoys

### 9.2 MPx / s

### 2 VIRTUAL CAMERA

gimbal limits · sensor noise

### 30 fps · 40 ms lag

### 3 PERCEPTION

top-hat · matched filter · CFAR

≈ 6 candidates / frame

### 4 DECISION

LOCK 4.0 Hz

blink signature + IMM

### 1 verified beacon

### 5 OPERATOR OUTPUTS

TRACK

live status + telemetry

Console + video

⚙ CONTROL MODULE

SMITH PREDICTOR
cancels 40 ms delay

VELOCITY FEED-FWD
follows predicted motion

SPIRAL SEARCH
finds unseen targets

CONTROL LOOP
≈ 30 commands / s

◎ ACQUISITION STATE MACHINE

SEARCH
scan predicted region

ACQUIRE
detect + validate

TRACK
hold lock

COAST
ride the prediction

REACQUIRE
recover target

target lost → SEARCH

### TECH STACK · every item used in the code

ENGINE
Py Python 3.11

Np NumPy

CV OpenCV

Or SGP4 · ISS TLEs

Ym PyYAML scenes

AI / LOGIC
Cf CFAR detector

Km IMM Kalman

Hz Goertzel 4 Hz

NN Neural verifier

Sp Smith predictor

APPS & WEB
Qt PySide6 GUI

Pg PyQtGraph

JS JavaScript

3D three.js twin

Rt WebRTC camera

Se Web Serial

HARDWARE
Ar Arduino C++

As AccelStepper

St A4988 + NEMA17

I2 AS5600 · I²C

QUALITY & DEPLOY
Pt pytest · 250 pass

CI GitHub Actions

Ex PyInstaller app

Nf Netlify site

### PROOF > PROMISE · WORKING PROTOTYPE

Console replay Webcam lock 4 Hz

MK1 closed loop

## 1.27 s

median lock · 64 runs

0 / 64

wrong-target locks

## 198 µrad

median error

8–21 ms

per 33 ms frame

Team ZeroDrift · SIH 2026 · PS 26169 | 3
