pranshukesavmishra/SIH-2026/docs/brand/isro.png

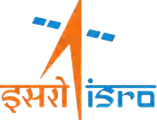
docs/brand/isro.png
