pranshukesavmishra/SIH-2026/docs/brand/sih2026.png

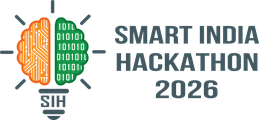
docs/brand/sih2026.png
