pranshukesavmishra/SIH-2026/docs/brand/zerodrift_mark.png

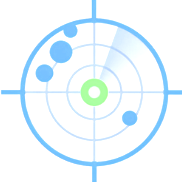
docs/brand/zerodrift_mark.png
