pranshukesavmishra/SIH-2026/docs/cad/renders/01_full_scene.png

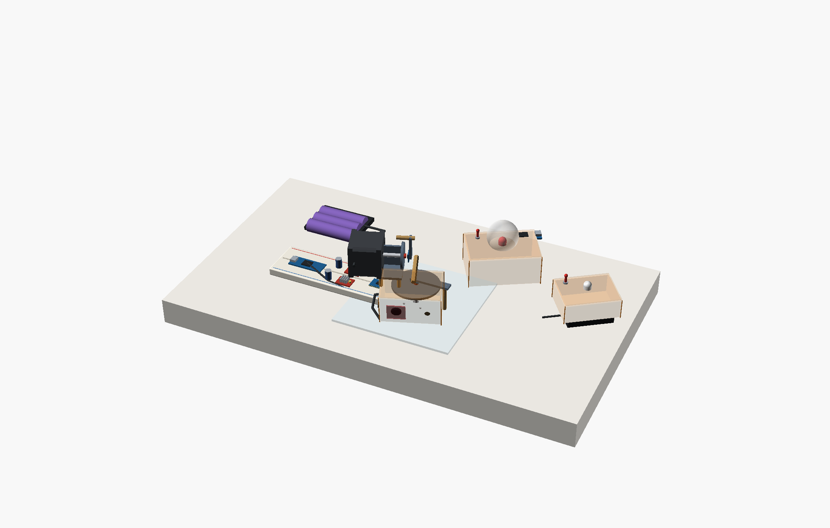
docs/cad/renders/01_full_scene.png
