pranshukesavmishra/SIH-2026/docs/cad/renders/02_rig.png

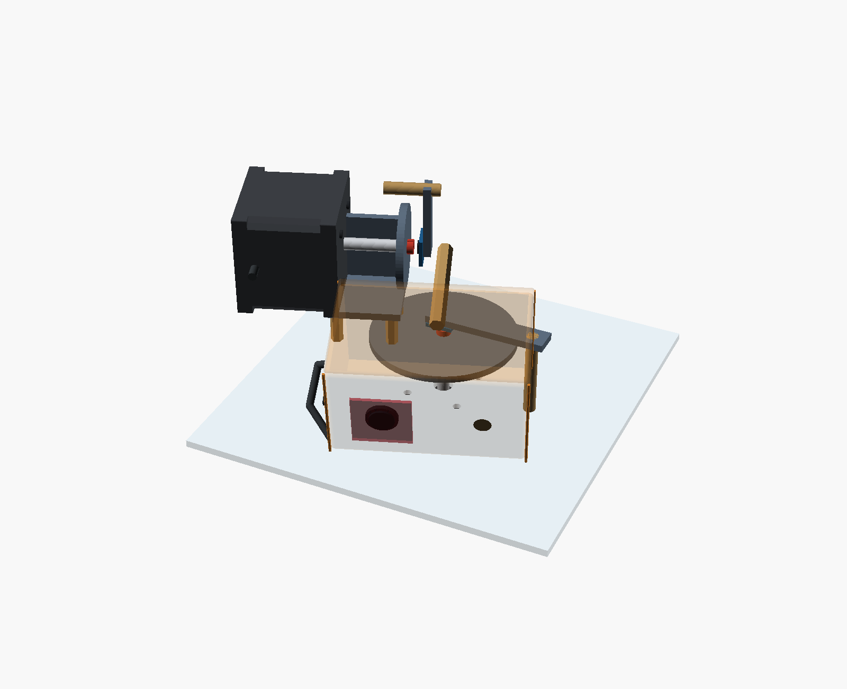
docs/cad/renders/02_rig.png
