pranshukesavmishra/SIH-2026/docs/cad/renders/03_head_detail.png

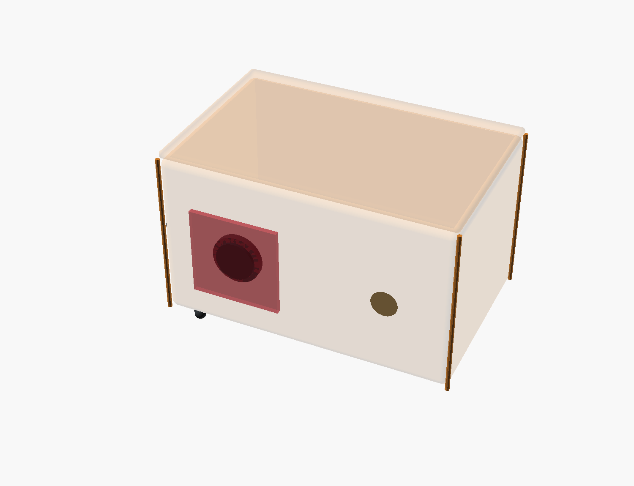
docs/cad/renders/03_head_detail.png
