pranshukesavmishra/SIH-2026/docs/cad/renders/04_exploded_labelled.png

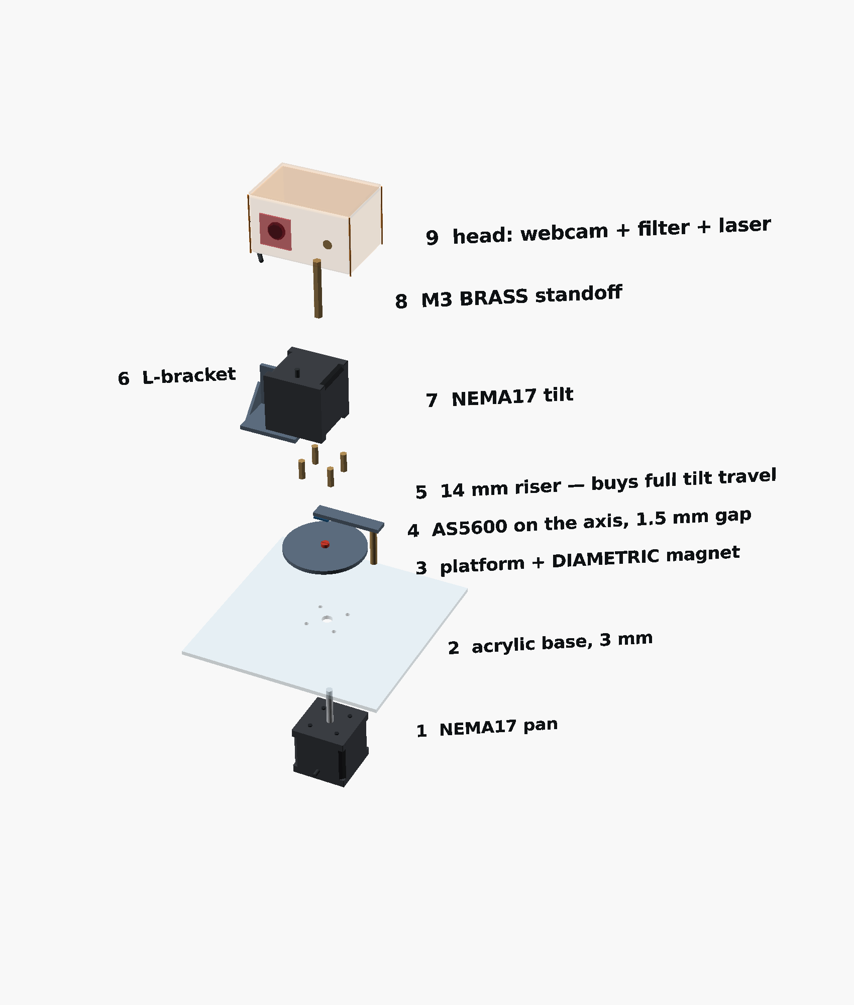
docs/cad/renders/04_exploded_labelled.png
