pranshukesavmishra/SIH-2026/docs/cad/renders/05_encoder_detail.png

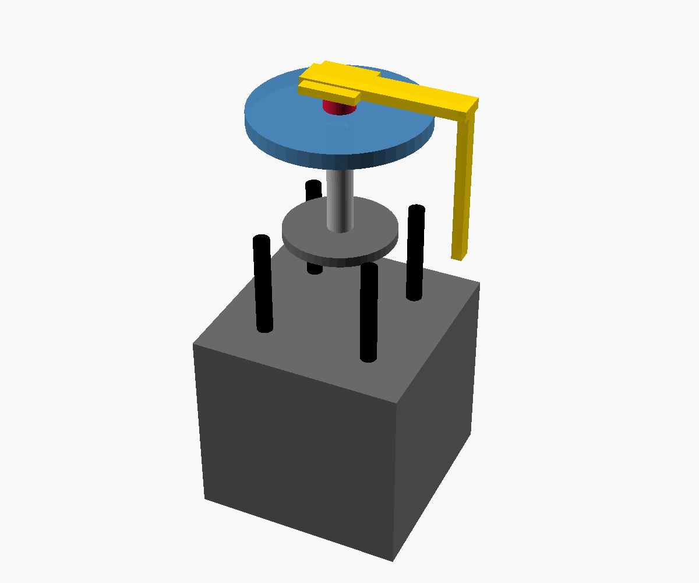
docs/cad/renders/05_encoder_detail.png
