pranshukesavmishra/SIH-2026/docs/media/award_1.jpg

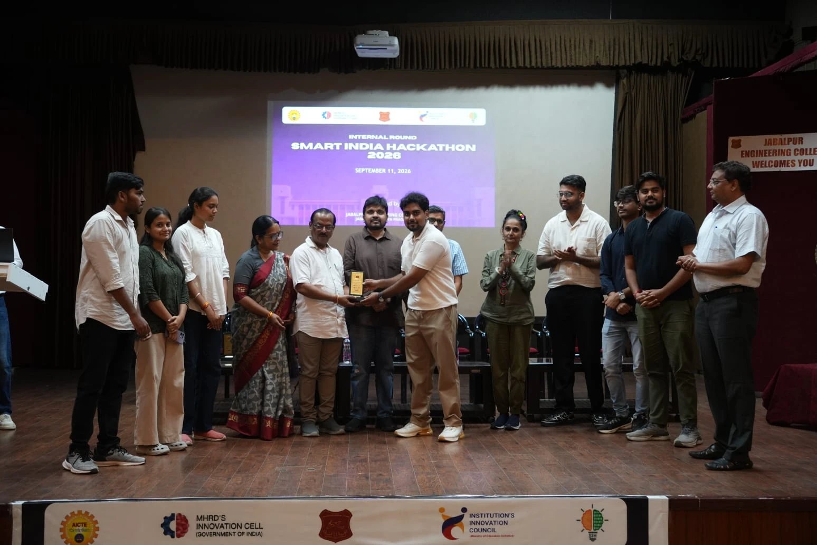
docs/media/award_1.jpg
