pranshukesavmishra/SIH-2026/docs/media/award_2.jpg

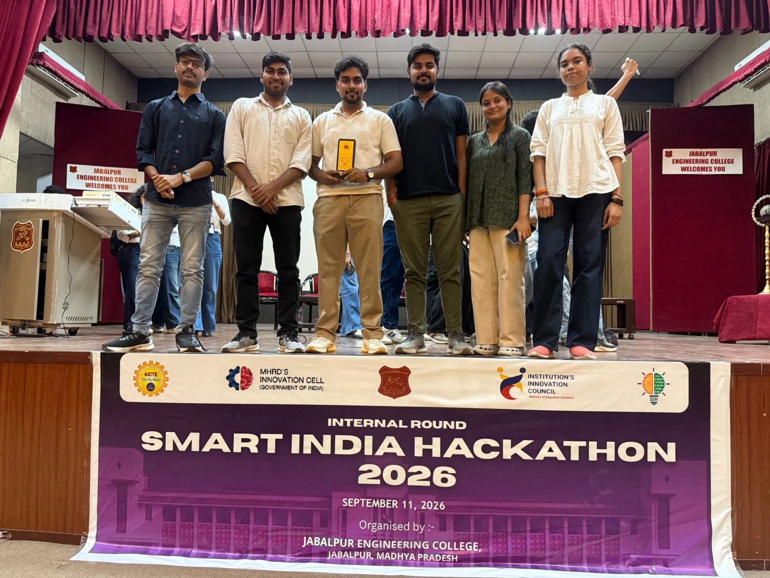
docs/media/award_2.jpg
