pranshukesavmishra/SIH-2026/docs/media/award_3.jpg

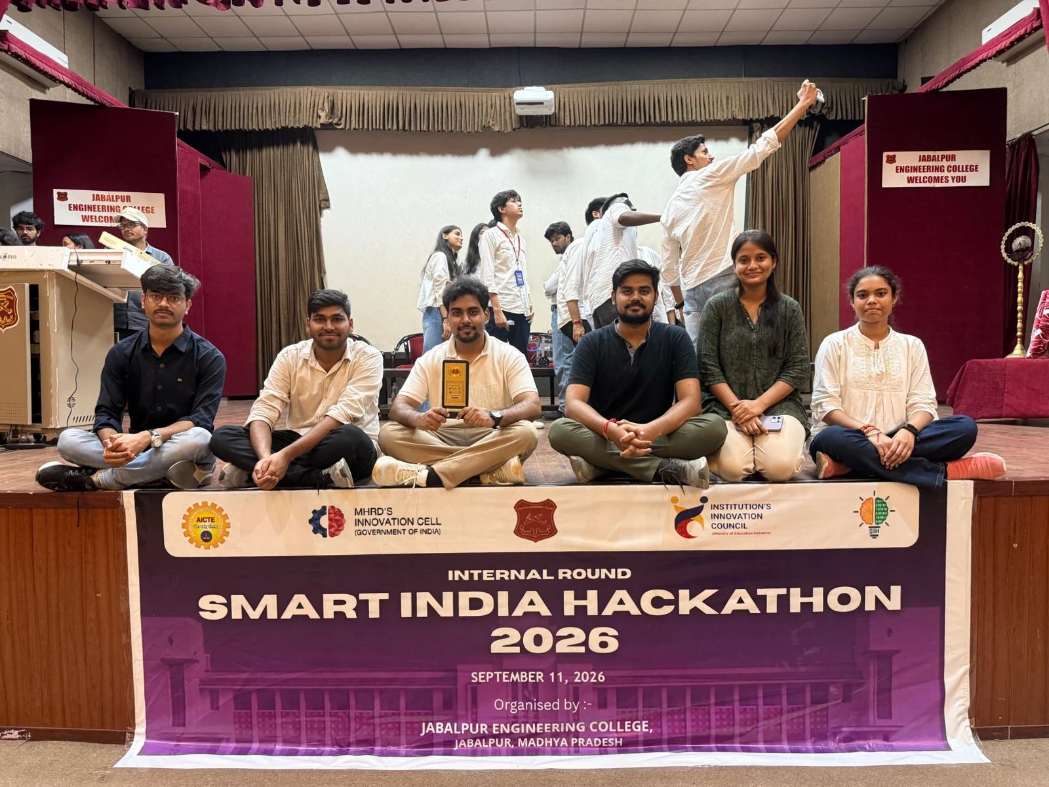
docs/media/award_3.jpg
