pranshukesavmishra/SIH-2026/docs/media/award_4.jpg

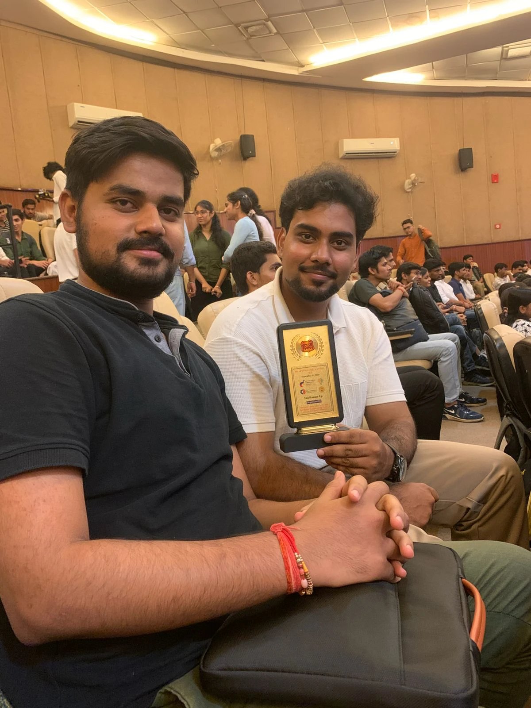
docs/media/award_4.jpg
