pranshukesavmishra/SIH-2026/docs/media/award_5.jpg

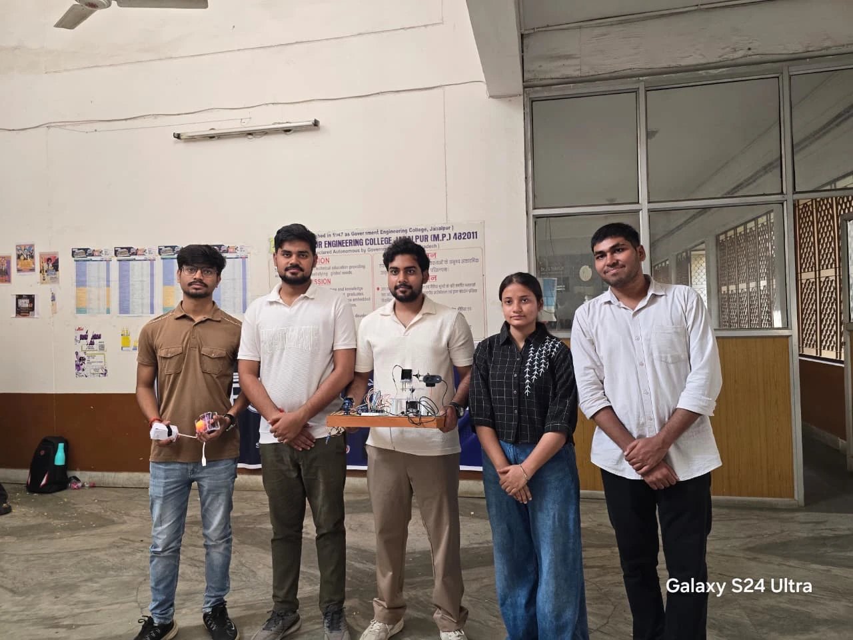
docs/media/award_5.jpg
