pranshukesavmishra/SIH-2026/docs/media/hl/decoy.jpg

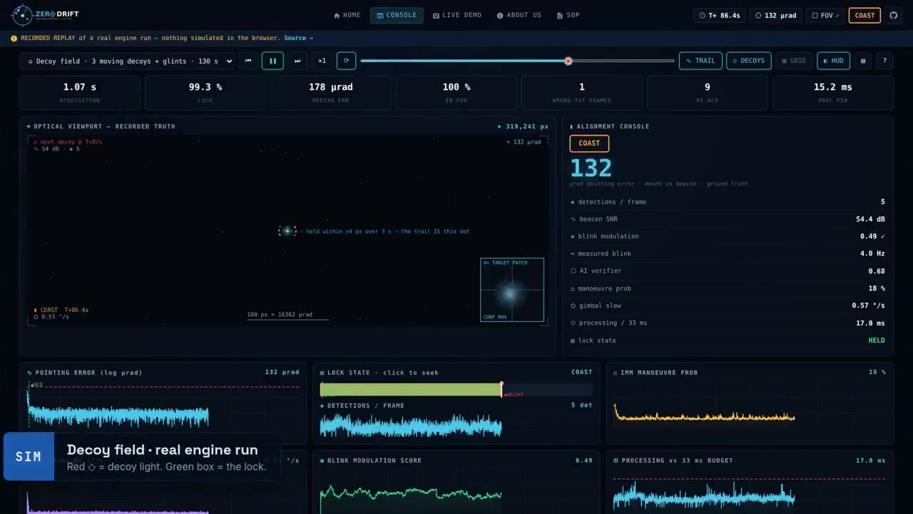
docs/media/hl/decoy.jpg
