pranshukesavmishra/SIH-2026/docs/media/hl/link.jpg

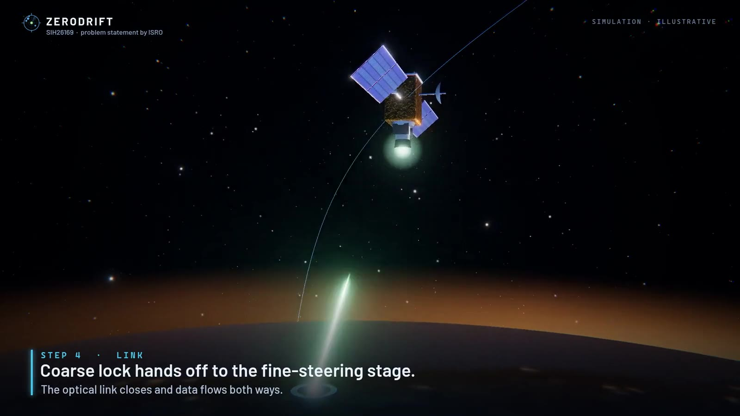
docs/media/hl/link.jpg
