pranshukesavmishra/SIH-2026/docs/media/hl/lock.jpg

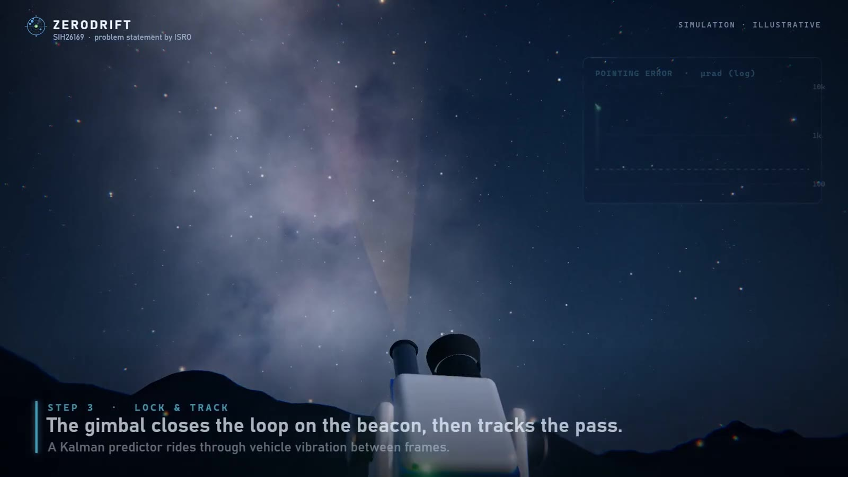
docs/media/hl/lock.jpg
