pranshukesavmishra/SIH-2026/docs/media/hl/mk1.jpg

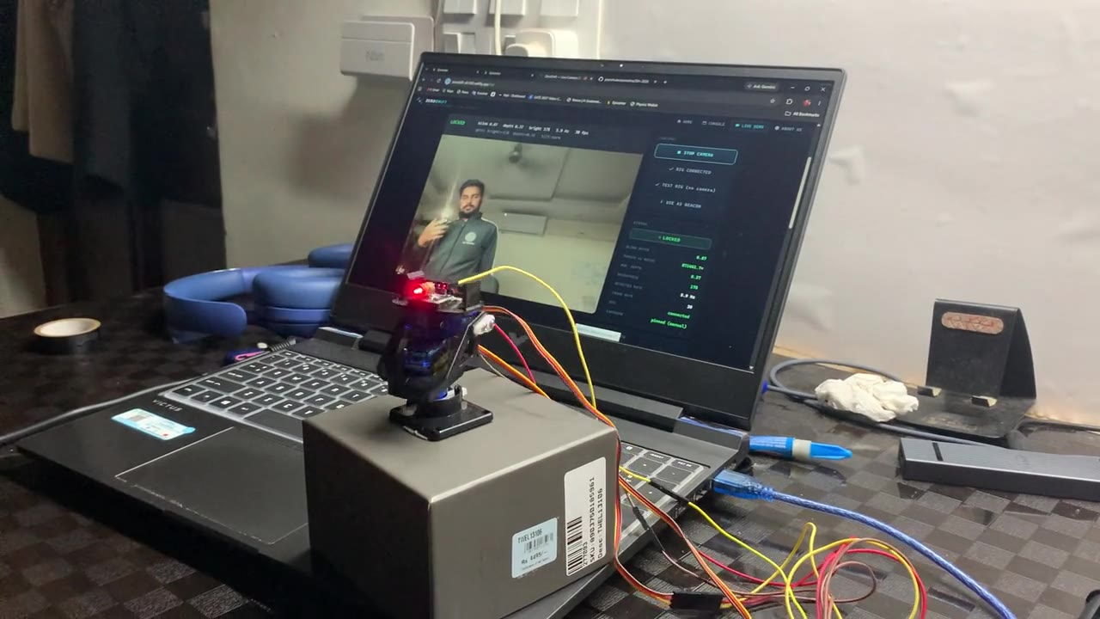
docs/media/hl/mk1.jpg
