pranshukesavmishra/SIH-2026/docs/media/sim3d_poster.jpg

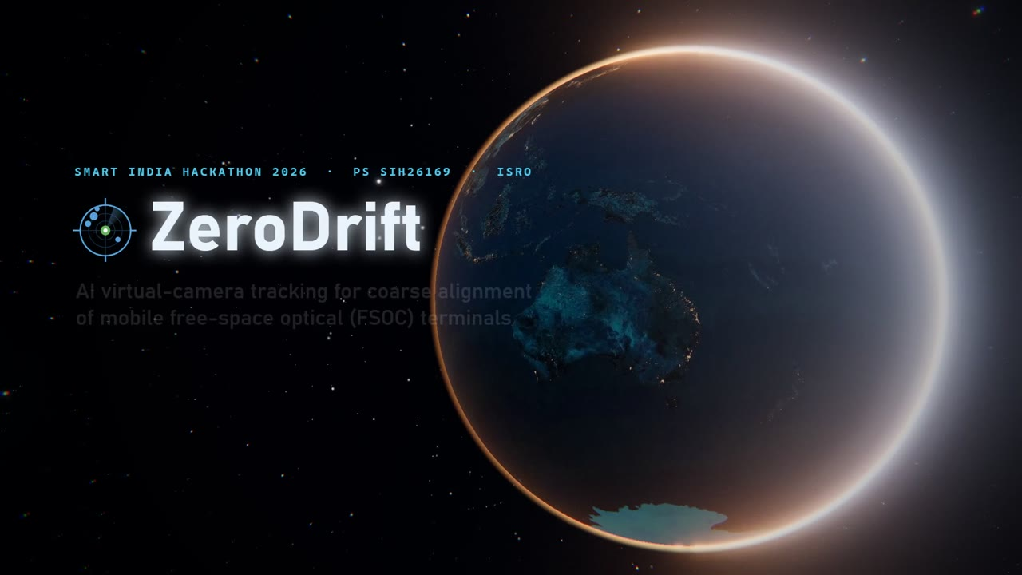
docs/media/sim3d_poster.jpg
