pranshukesavmishra/SIH-2026/docs/media/site/about_poster.jpg

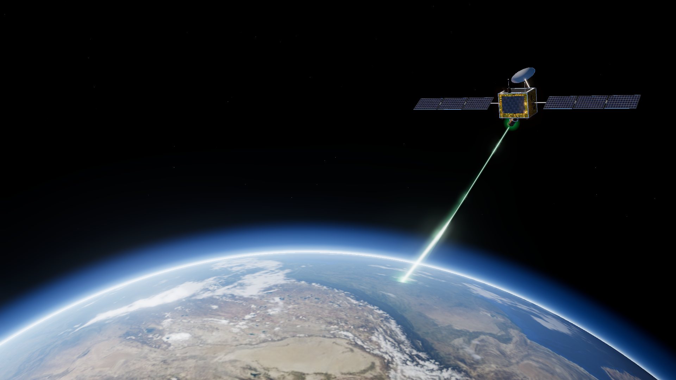
docs/media/site/about_poster.jpg
