pranshukesavmishra/SIH-2026/docs/media/site/earth_data.jpg

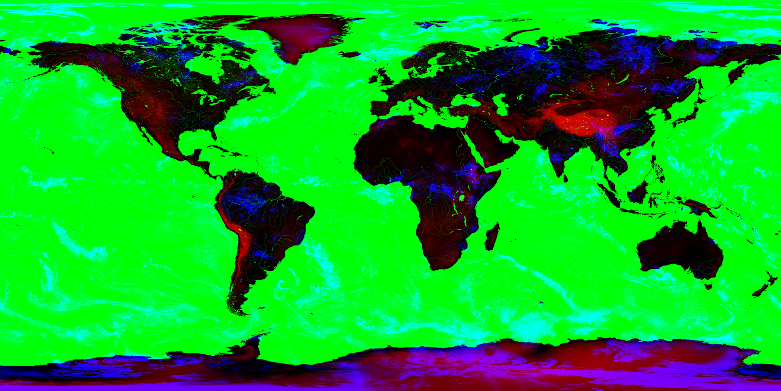
docs/media/site/earth_data.jpg
