pranshukesavmishra/SIH-2026/docs/media/site/earth_end.jpg

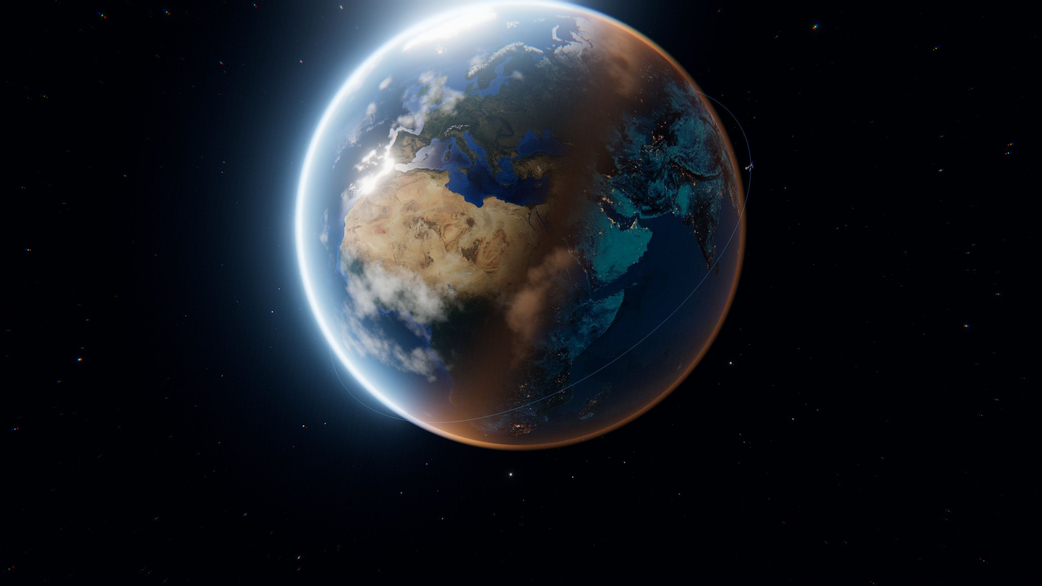
docs/media/site/earth_end.jpg
