pranshukesavmishra/SIH-2026/docs/media/site/gimbal_beam.jpg

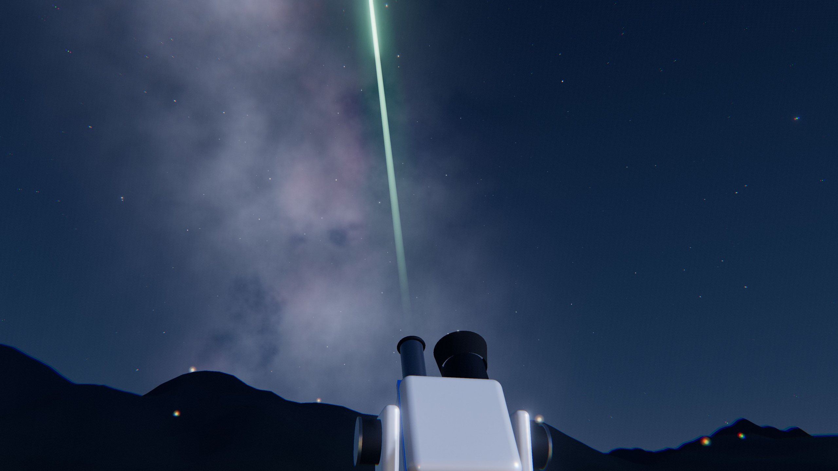
docs/media/site/gimbal_beam.jpg
