pranshukesavmishra/SIH-2026/docs/media/site/hero_link.jpg

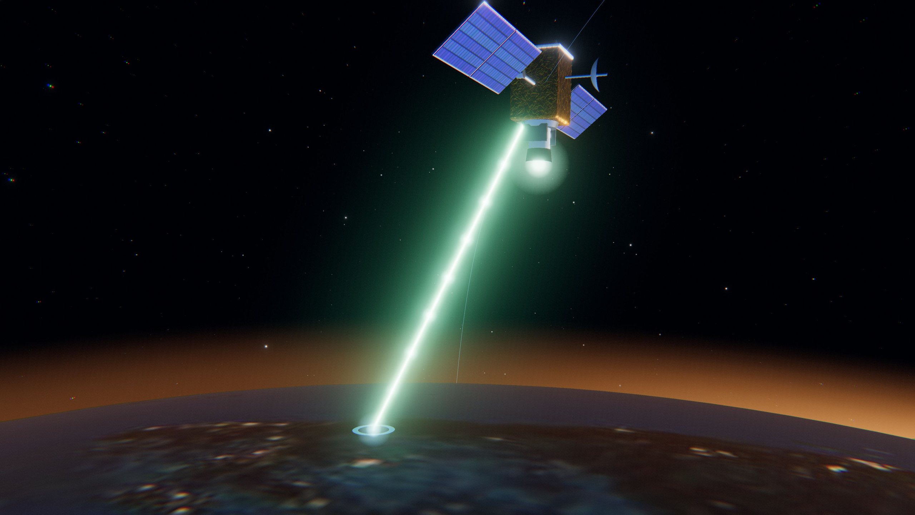
docs/media/site/hero_link.jpg
