pranshukesavmishra/SIH-2026/docs/media/site/leo_sat.jpg

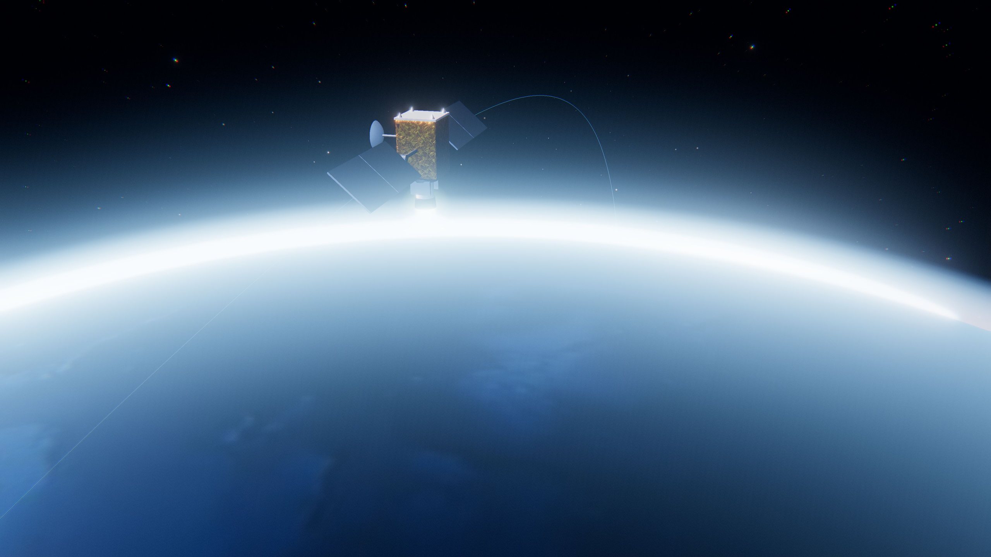
docs/media/site/leo_sat.jpg
