pranshukesavmishra/SIH-2026/docs/media/site/live_poster.jpg

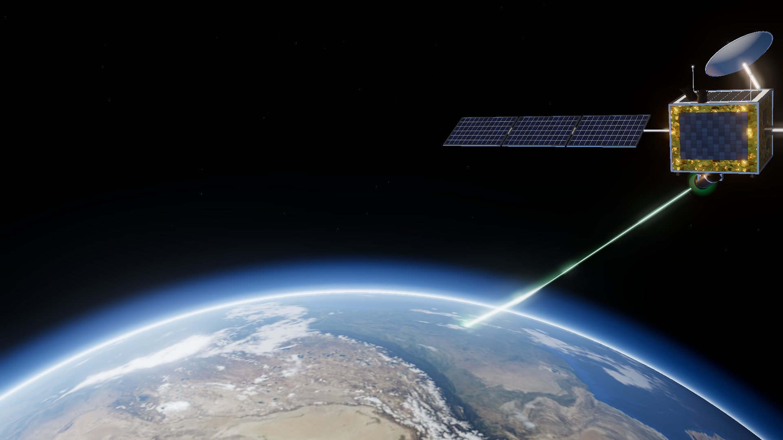
docs/media/site/live_poster.jpg
