pranshukesavmishra/SIH-2026/docs/media/site/orbit_india.jpg

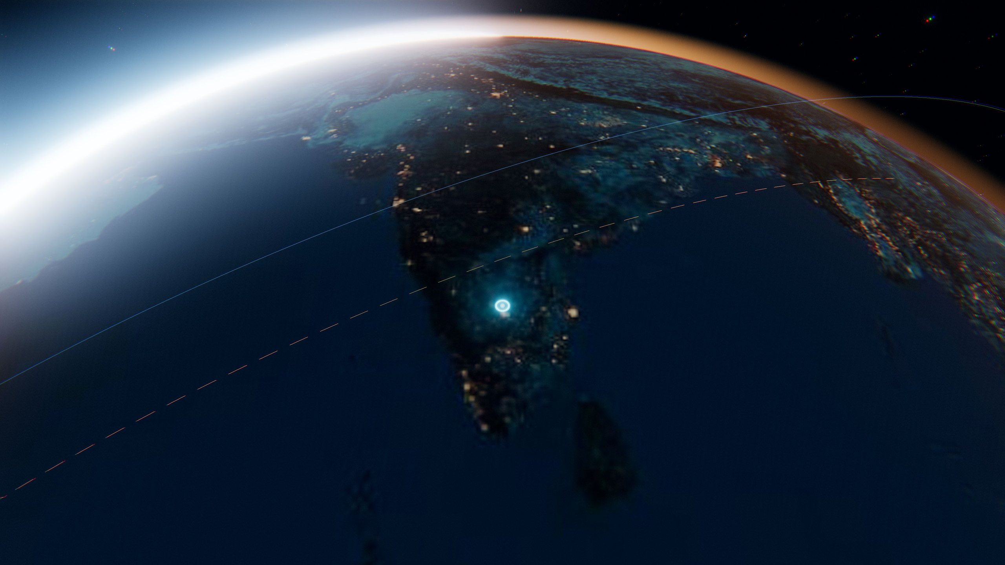
docs/media/site/orbit_india.jpg
