pranshukesavmishra/SIH-2026/docs/media/site/terminal_van.jpg

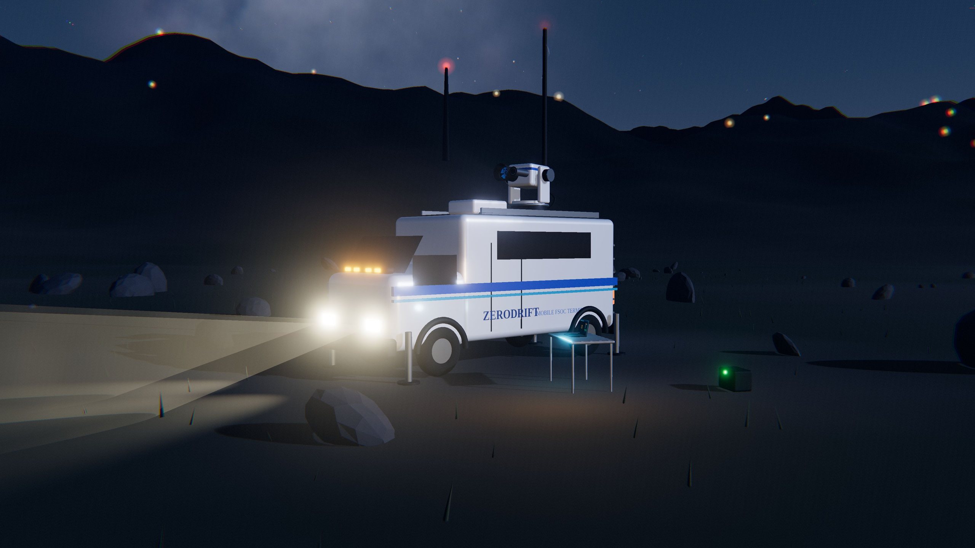
docs/media/site/terminal_van.jpg
