pranshukesavmishra/SIH-2026/docs/media/sop/console.jpg

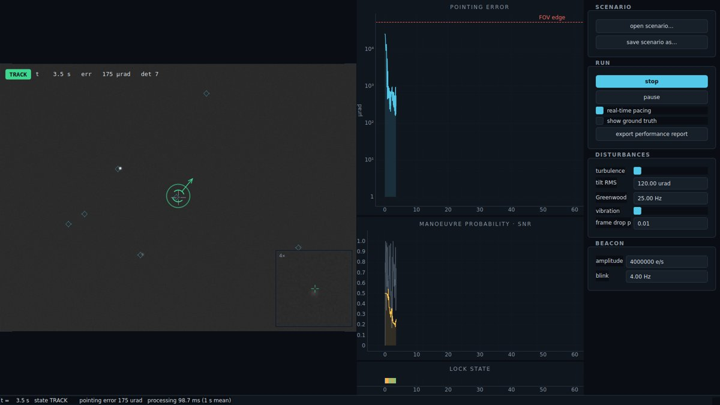
docs/media/sop/console.jpg
