pranshukesavmishra/SIH-2026/docs/media/sop/encoder_card.jpg

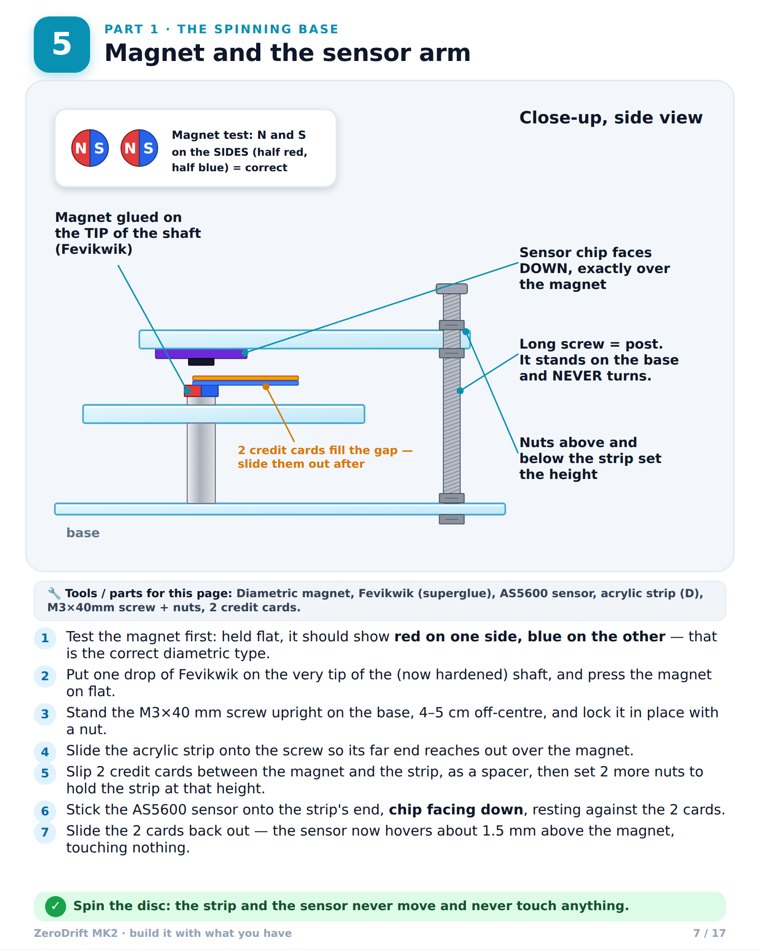
docs/media/sop/encoder_card.jpg
