pranshukesavmishra/SIH-2026/docs/media/sop/mk1_circuit.jpg

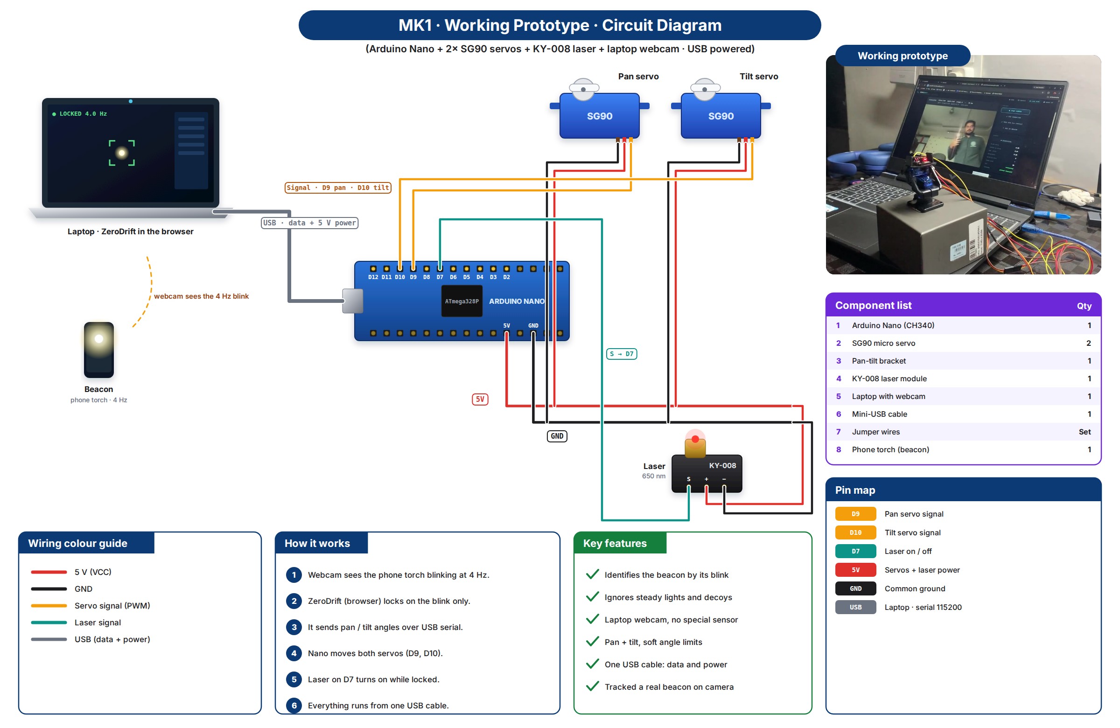
docs/media/sop/mk1_circuit.jpg
