pranshukesavmishra/SIH-2026/docs/media/sop/proof_blink.png

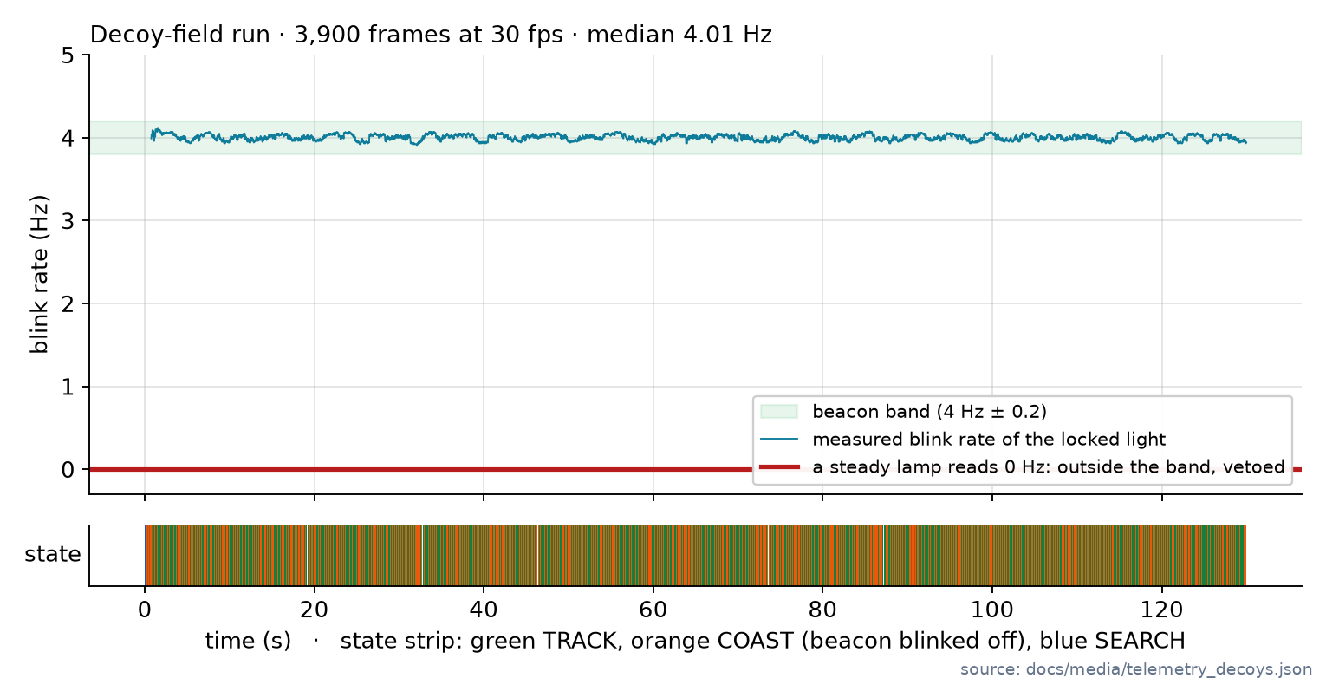
docs/media/sop/proof_blink.png
