pranshukesavmishra/SIH-2026/docs/media/sop/proof_campaign.png

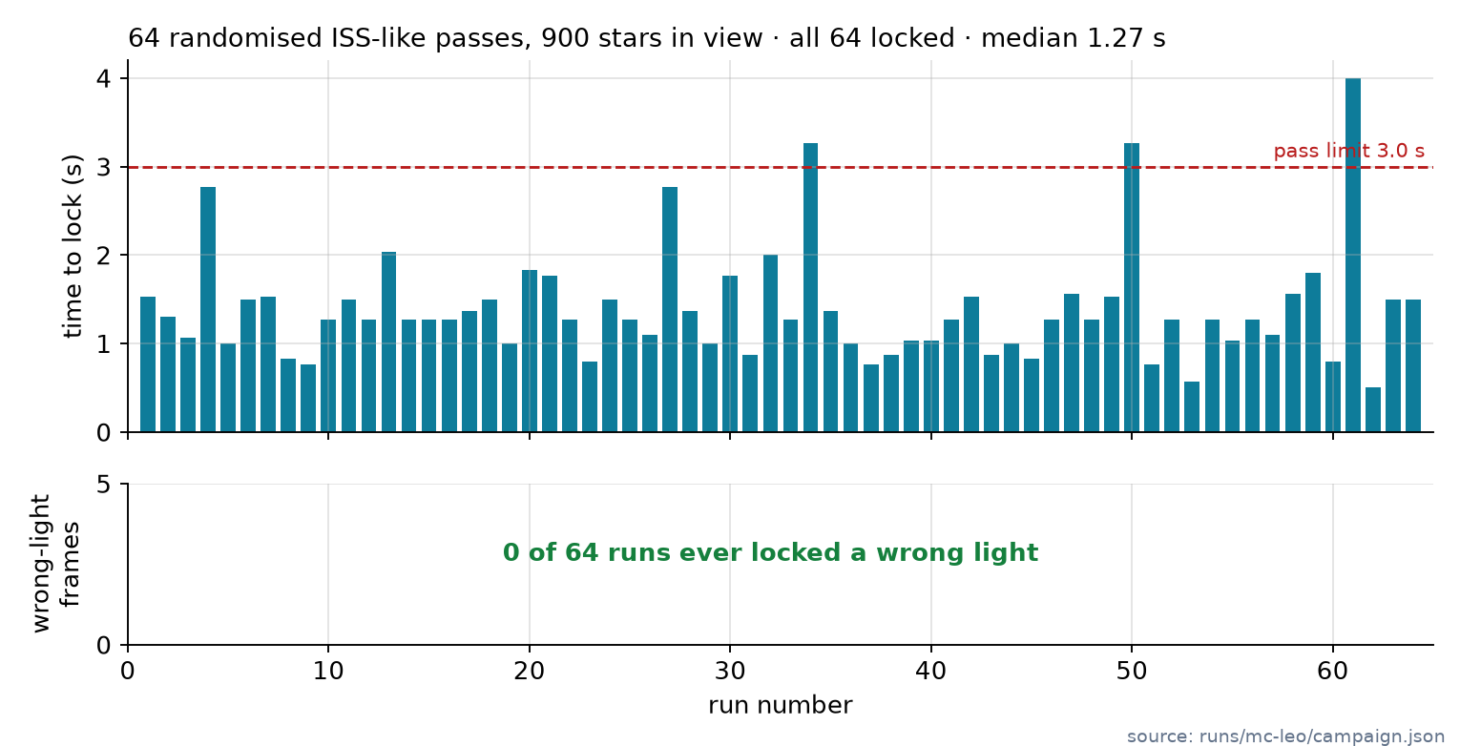
docs/media/sop/proof_campaign.png
