pranshukesavmishra/SIH-2026/docs/mk3/img/asm_head.jpg

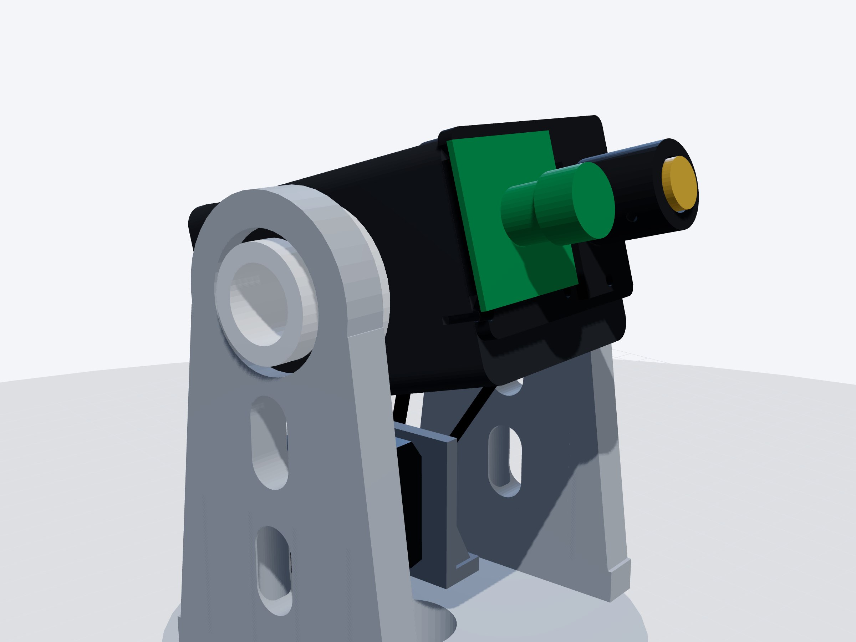
docs/mk3/img/asm_head.jpg
