pranshukesavmishra/SIH-2026/docs/mk3/img/asm_side.jpg

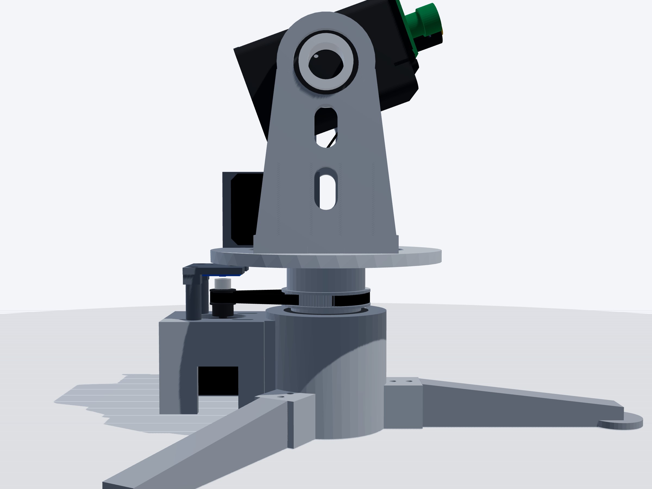
docs/mk3/img/asm_side.jpg
