pranshukesavmishra/SIH-2026/docs/mk3/img/asm_top.jpg

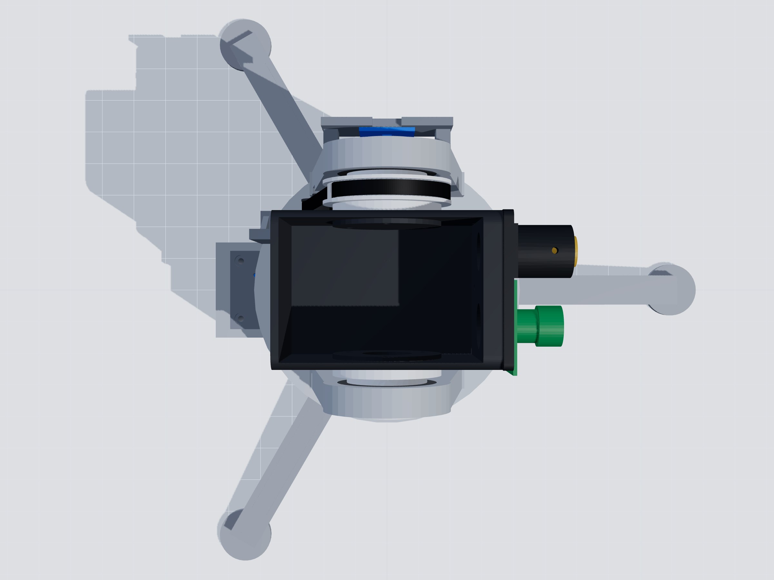
docs/mk3/img/asm_top.jpg
