pranshukesavmishra/SIH-2026/docs/mk3/img/parts/16_electronics_box.jpg

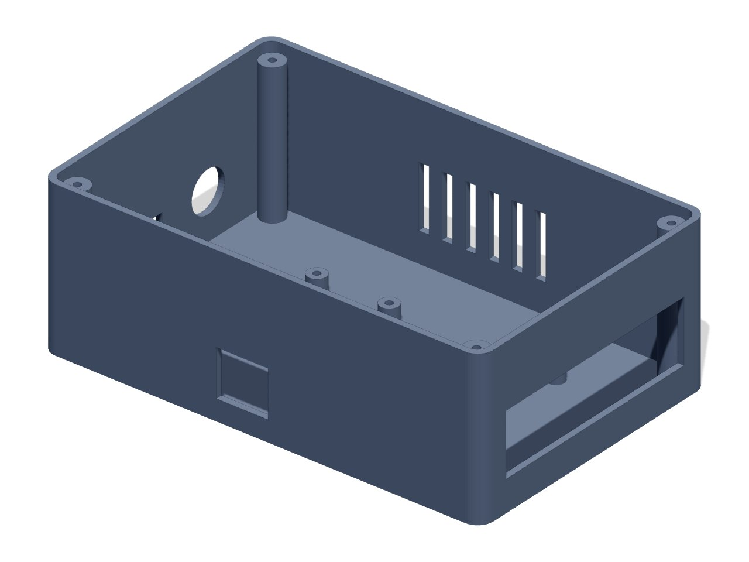
docs/mk3/img/parts/16_electronics_box.jpg
