pranshukesavmishra/SIH-2026/docs/mk3/img/parts/17_electronics_lid.jpg

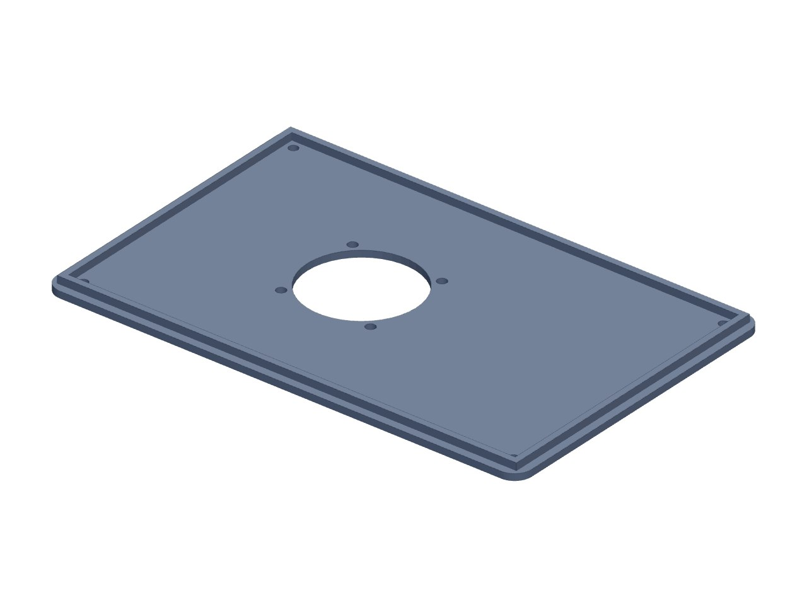
docs/mk3/img/parts/17_electronics_lid.jpg
