pranshukesavmishra/SIH-2026/docs/submission/assets/ref_turret_a.jpg

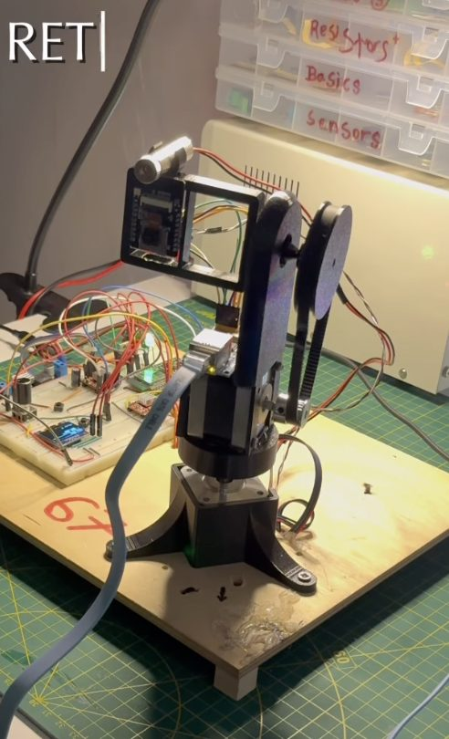
docs/submission/assets/ref_turret_a.jpg
