pranshukesavmishra/SIH-2026/docs/submission/assets/ref_turret_b.jpg

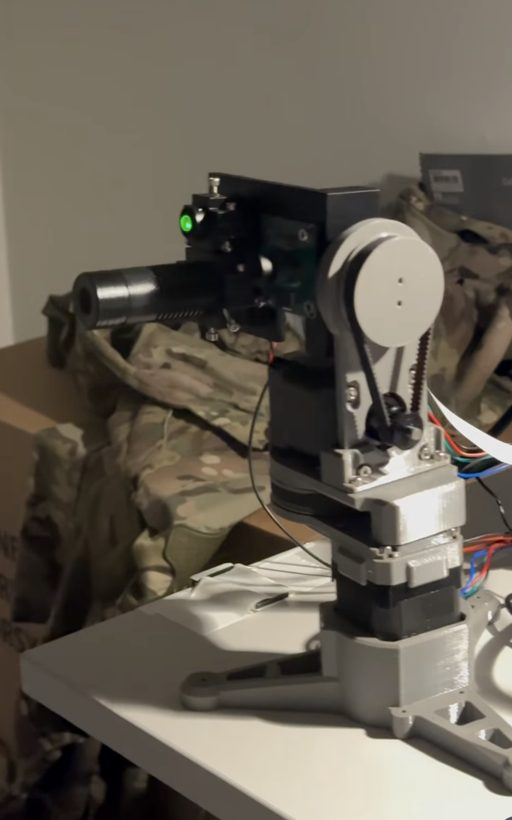
docs/submission/assets/ref_turret_b.jpg
