pranshukesavmishra/SIH-2026/docs/submission/assets/ref_turret_b_pan.jpg

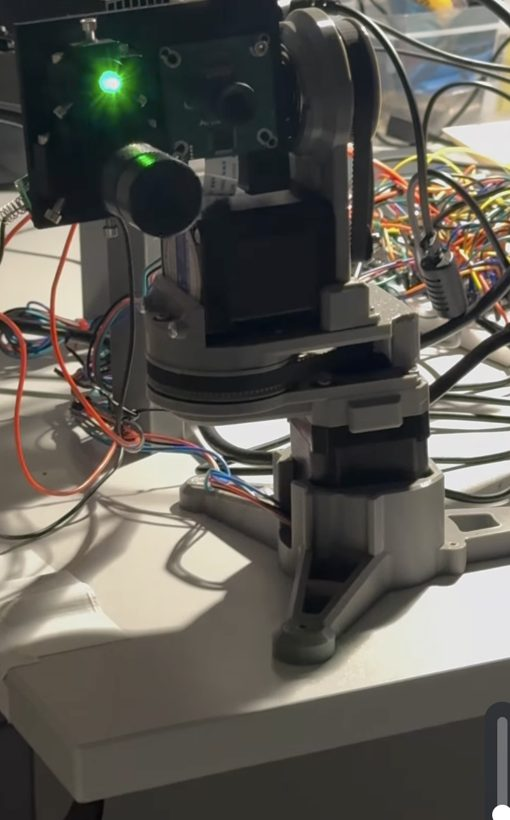
docs/submission/assets/ref_turret_b_pan.jpg
