pranshukesavmishra/SIH-2026/docs/submission/deck_src/slides23/mk1_photo.jpg

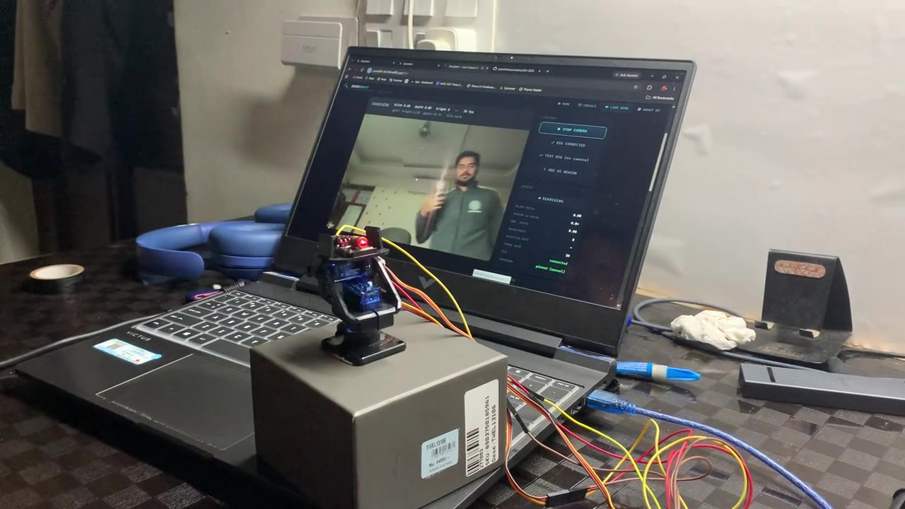
docs/submission/deck_src/slides23/mk1_photo.jpg
