pranshukesavmishra/SIH-2026/docs/submission/deck_src/slides23/software_demo_poster.jpg

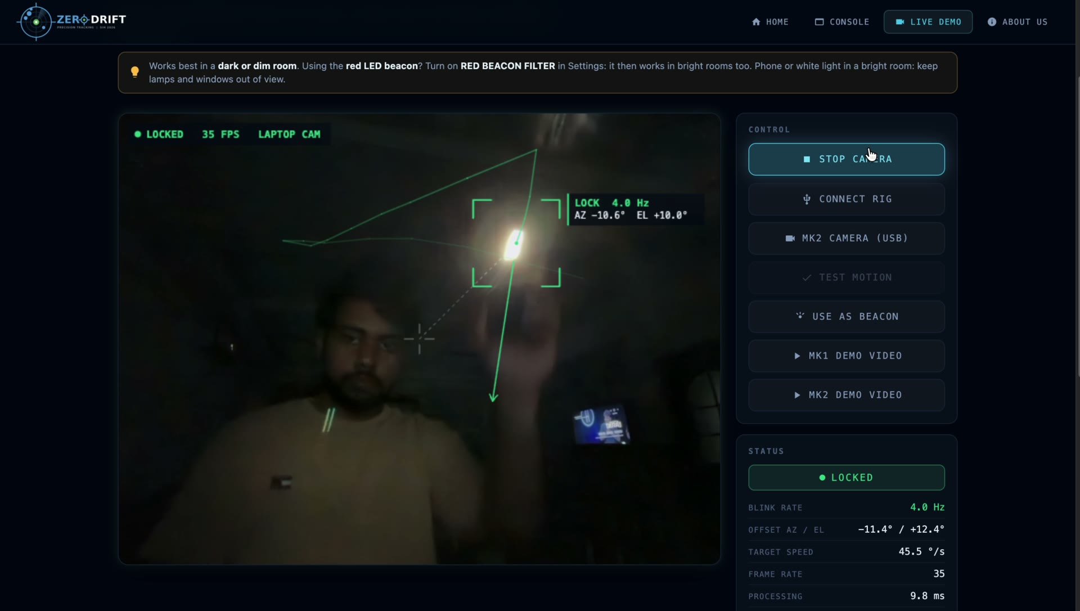
docs/submission/deck_src/slides23/software_demo_poster.jpg
