pranshukesavmishra/SIH-2026/docs/submission/review/s1_marked.png

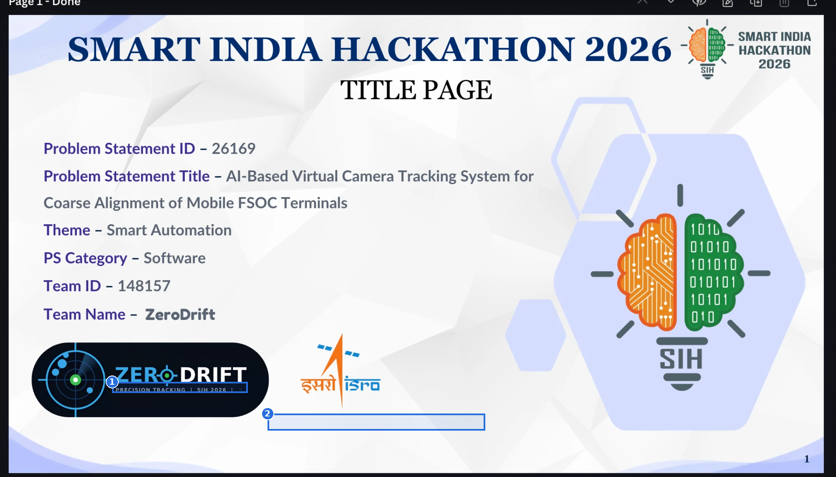
docs/submission/review/s1_marked.png
