pranshukesavmishra/SIH-2026/docs/submission/review/s3_marked.png

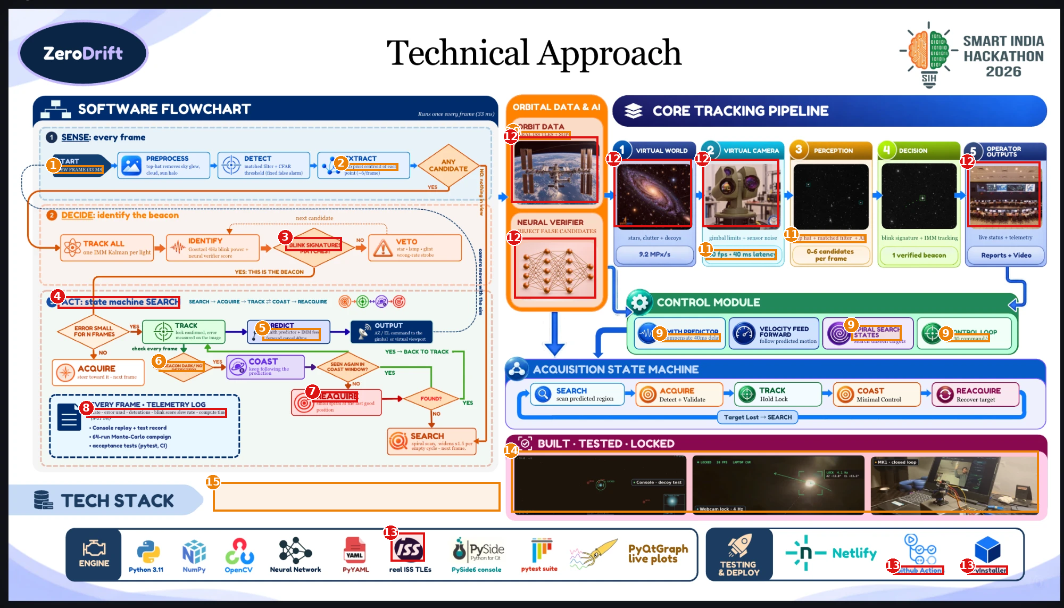
docs/submission/review/s3_marked.png
