pranshukesavmishra/SIH-2026/docs/submission/review/s4_marked.png

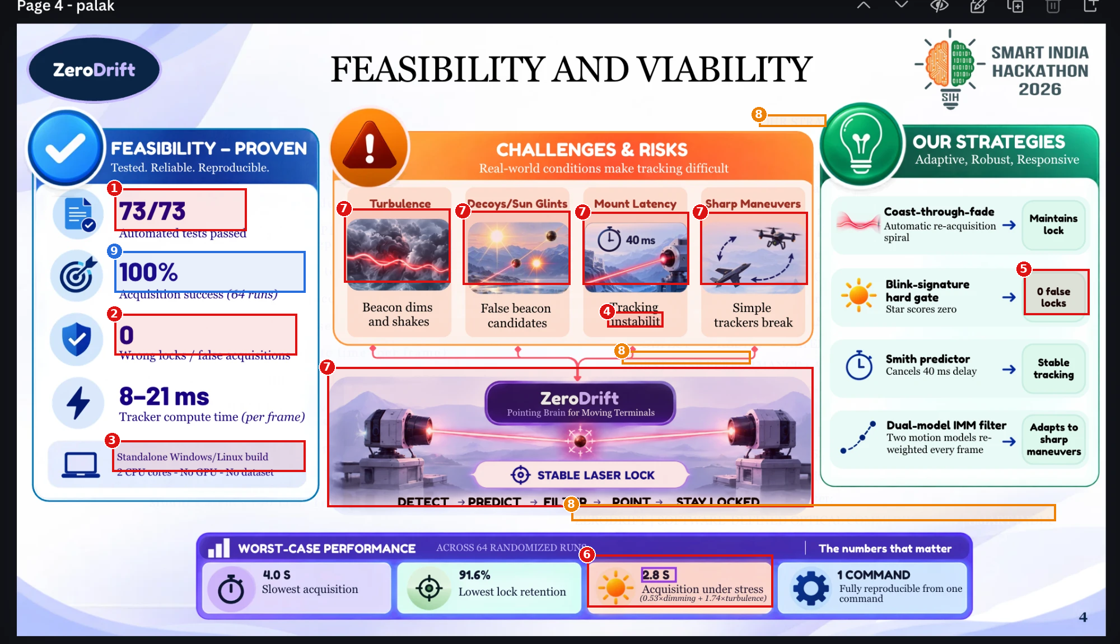
docs/submission/review/s4_marked.png
