pranshukesavmishra/SIH-2026/docs/submission/review/s5_marked.png

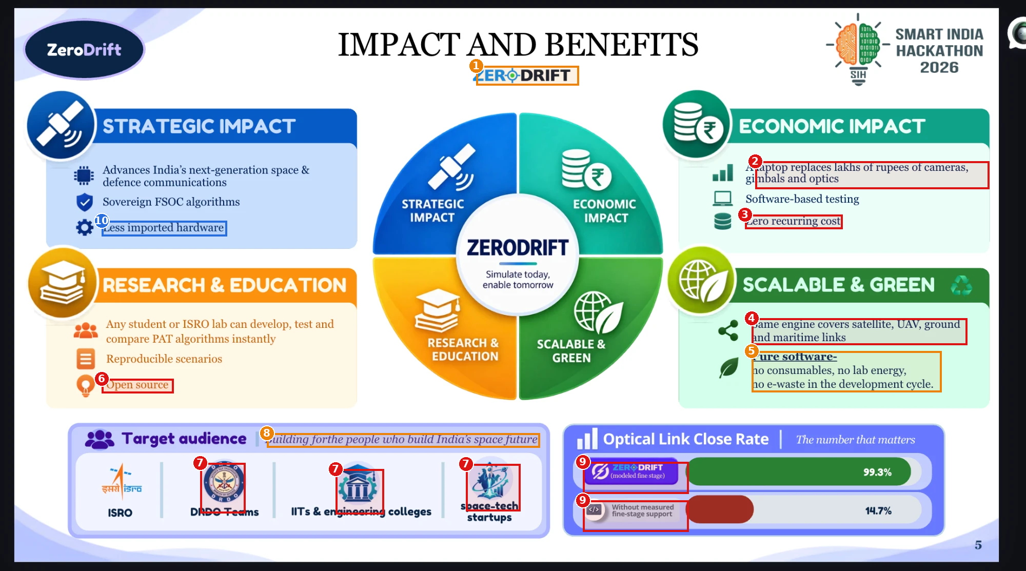
docs/submission/review/s5_marked.png
