pranshukesavmishra/SIH-2026/docs/submission/review/s6_marked.png

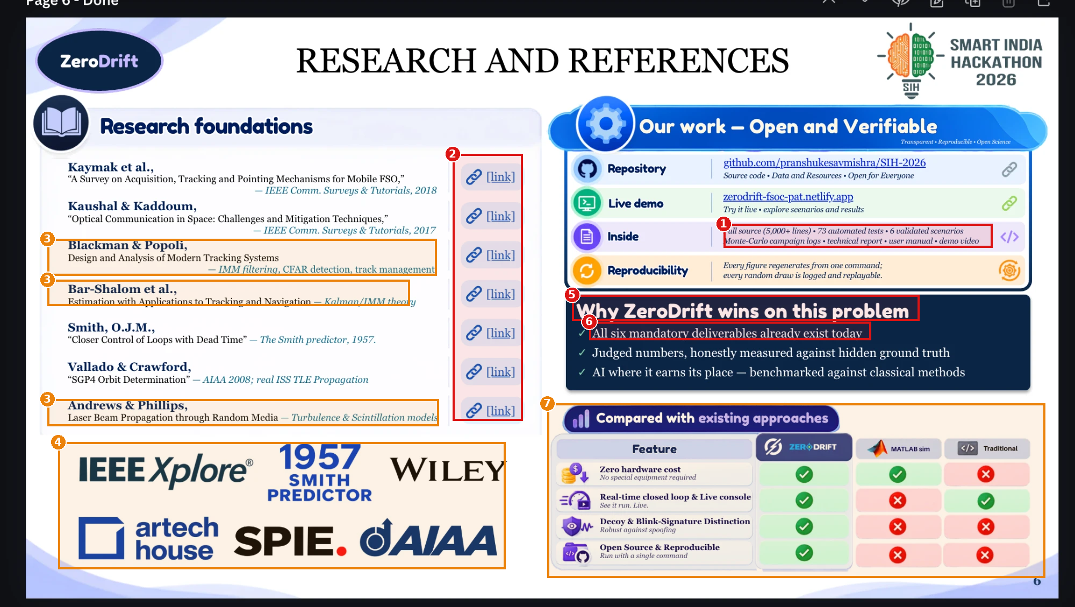
docs/submission/review/s6_marked.png
