pranshukesavmishra/SIH-2026/docs/submission/review/ZeroDrift_IdeaSlide_fixed.png

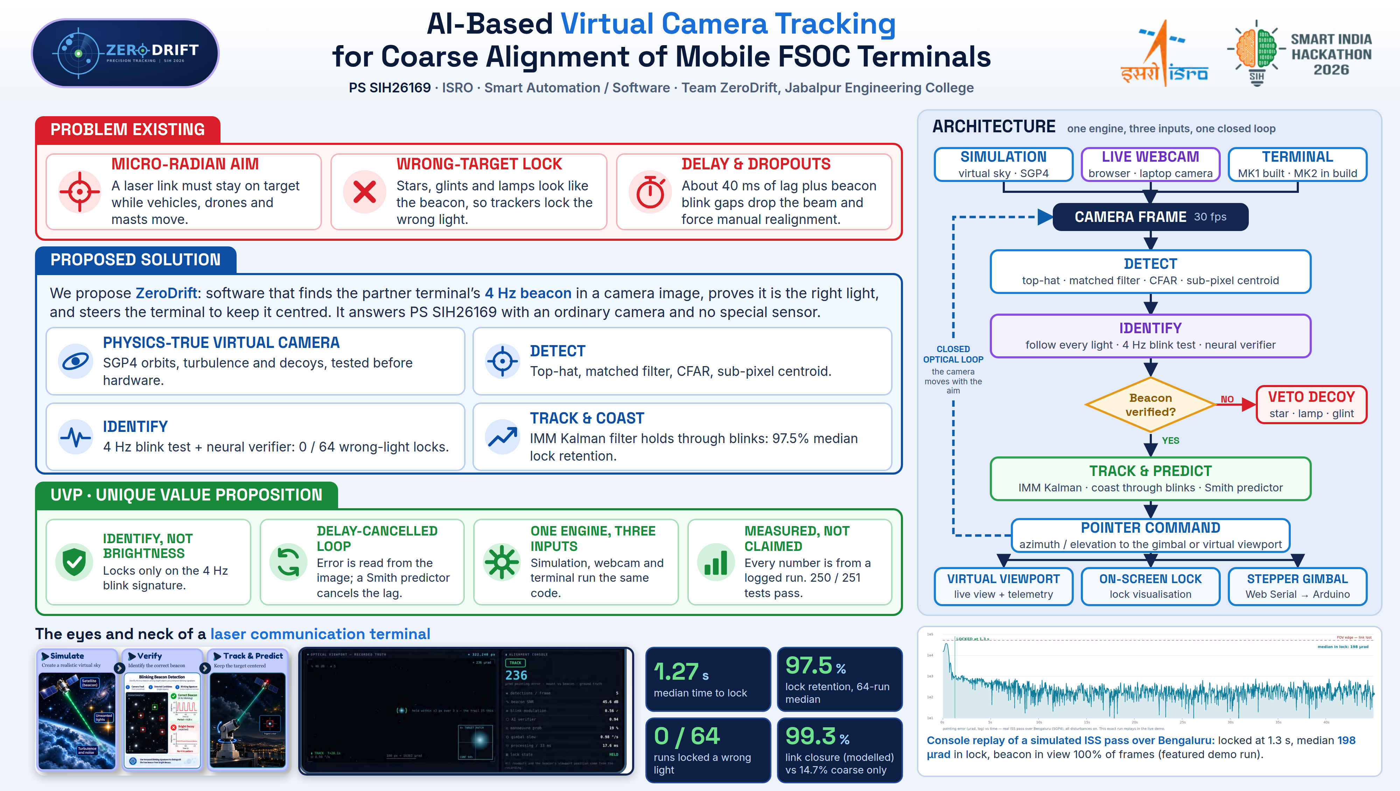
docs/submission/review/ZeroDrift_IdeaSlide_fixed.png
