pranshukesavmishra/SIH-2026/docs/submission/review/ZeroDrift_IdeaSlide_MARKED.png

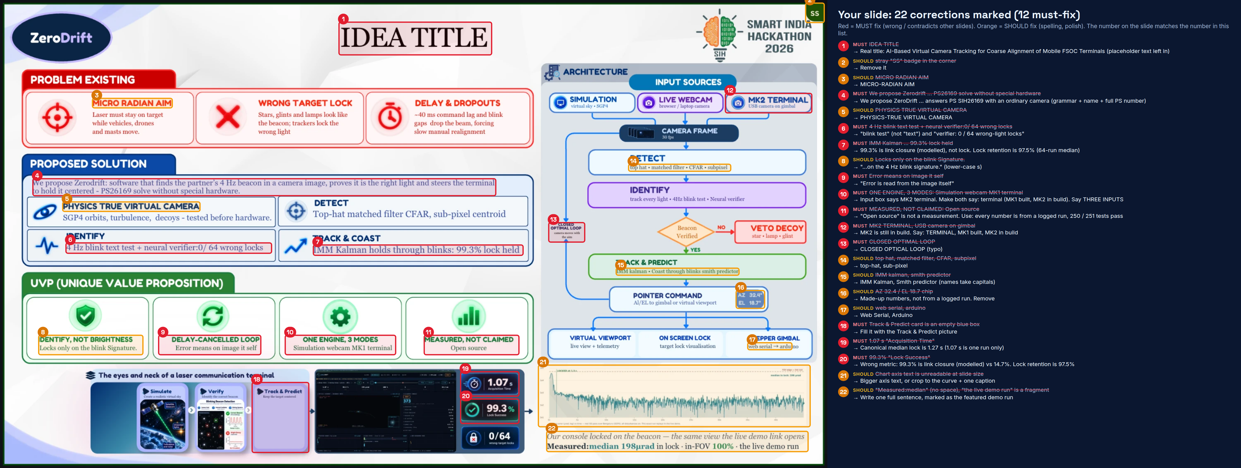
docs/submission/review/ZeroDrift_IdeaSlide_MARKED.png
