pranshukesavmishra/SIH-2026/docs/submission/slide3_own_images/1_orbit_data.png

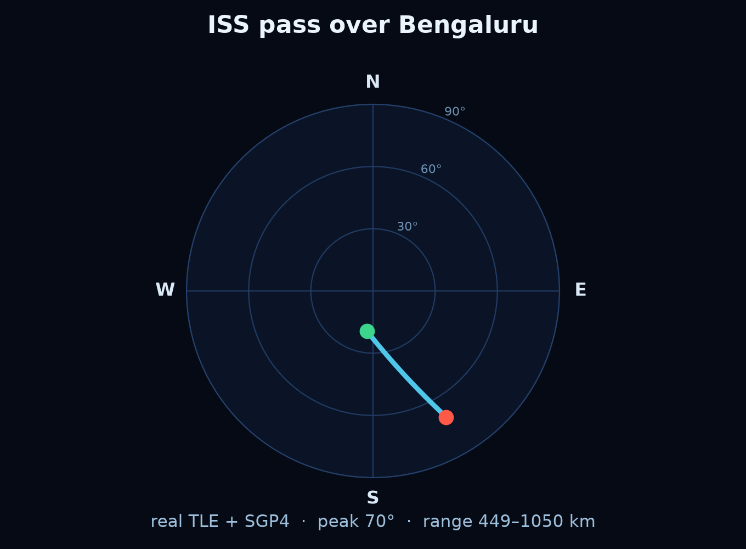
docs/submission/slide3_own_images/1_orbit_data.png
