pranshukesavmishra/SIH-2026/docs/submission/slide3_own_images/3_virtual_world.png

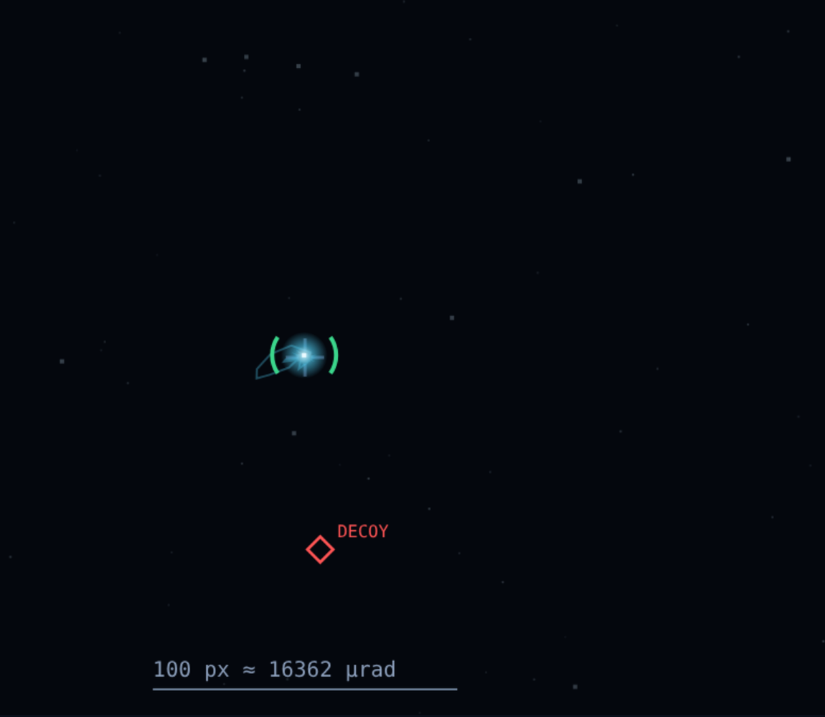
docs/submission/slide3_own_images/3_virtual_world.png
