pranshukesavmishra/SIH-2026/docs/submission/slide3_own_images/4_virtual_camera.png

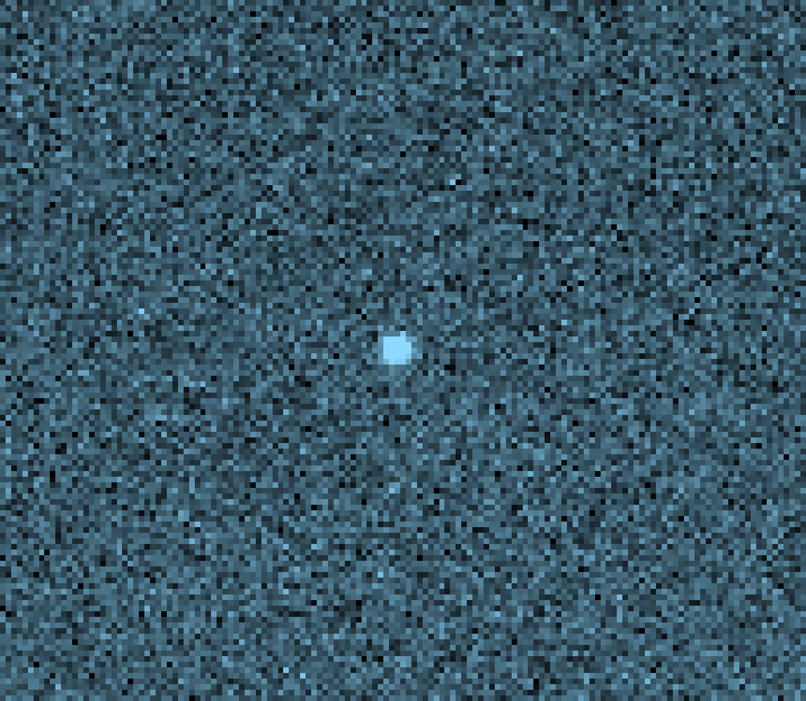
docs/submission/slide3_own_images/4_virtual_camera.png
