pranshukesavmishra/SIH-2026/docs/submission/slide3_own_images/5_operator_outputs.png

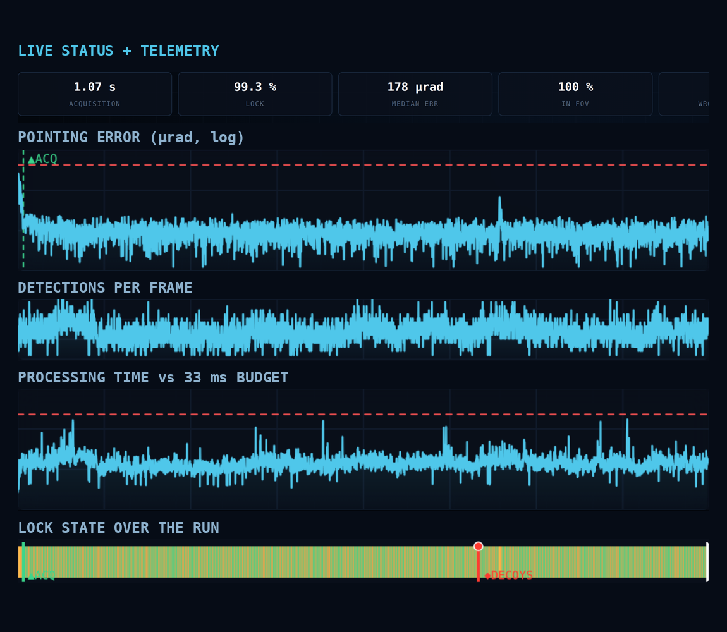
docs/submission/slide3_own_images/5_operator_outputs.png
