pranshukesavmishra/SIH-2026/tools/mk3/tower/img/expl.jpg

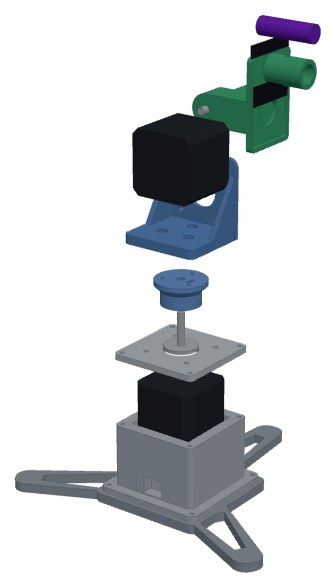
tools/mk3/tower/img/expl.jpg
