pranshukesavmishra/SIH-2026/tools/mk3/tower/img/front.jpg

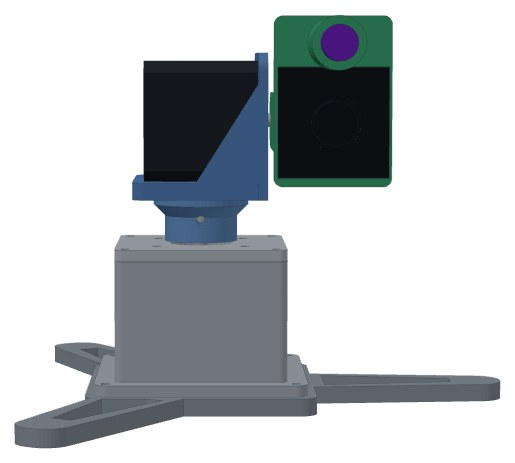
tools/mk3/tower/img/front.jpg
