pranshukesavmishra/SIH-2026/tools/mk3/tower/img/p02.jpg

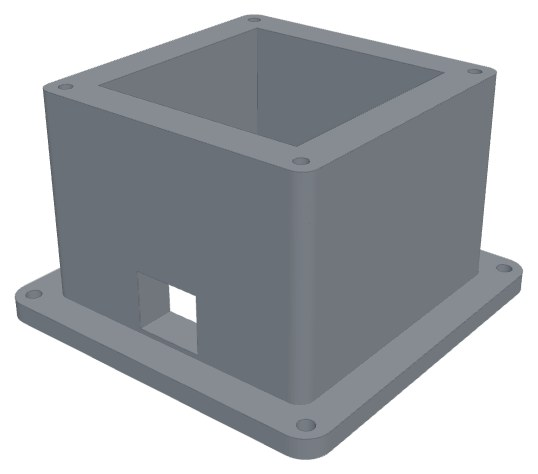
tools/mk3/tower/img/p02.jpg
