pranshukesavmishra/SIH-2026/tools/mk3/tower/img/p05.jpg

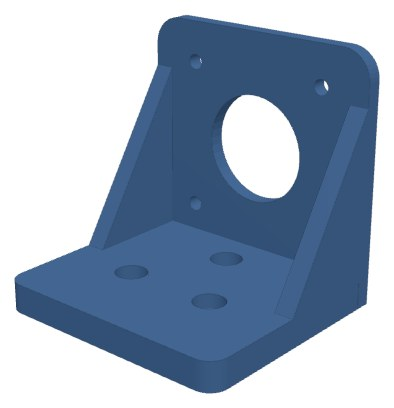
tools/mk3/tower/img/p05.jpg
