pranshukesavmishra/SIH-2026/tools/mk3/tower/img/p06.jpg

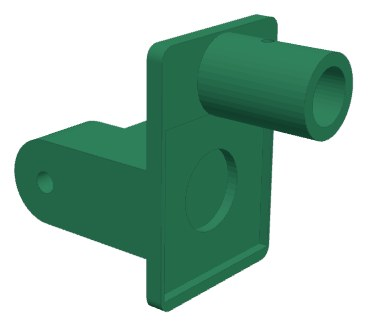
tools/mk3/tower/img/p06.jpg
