pranshukesavmishra/SIH-2026/tools/mk3/tower/img/pan_m90.jpg

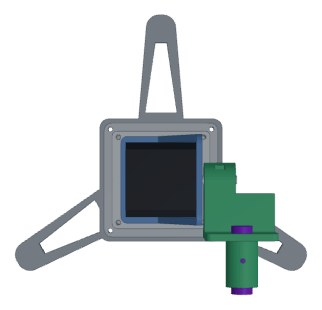
tools/mk3/tower/img/pan_m90.jpg
