pranshukesavmishra/SIH-2026/tools/mk3/tower/img/pan_p90.jpg

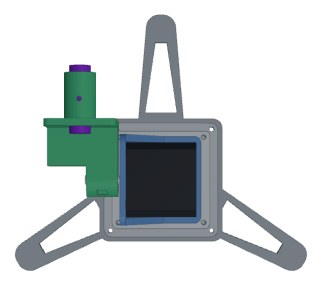
tools/mk3/tower/img/pan_p90.jpg
