pranshukesavmishra/SIH-2026/tools/mk3/tower/img/side_0.jpg

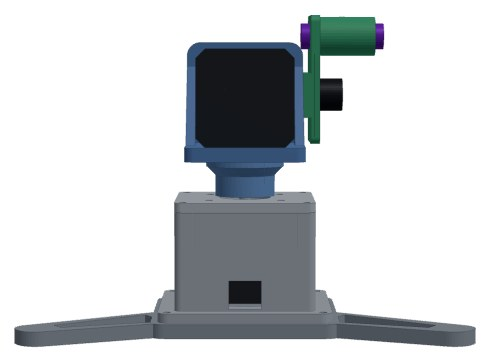
tools/mk3/tower/img/side_0.jpg
