pranshukesavmishra/SIH-2026/tools/mk3/tower/img/side_m30.jpg

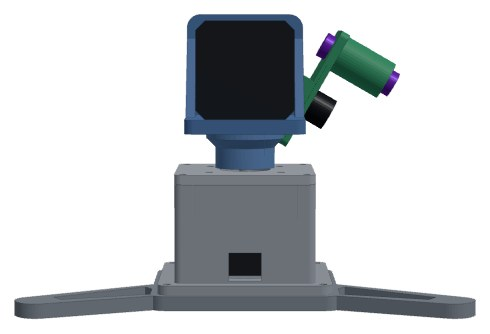
tools/mk3/tower/img/side_m30.jpg
