pranshukesavmishra/SIH-2026/tools/mk3/tower/img/side_p30.jpg

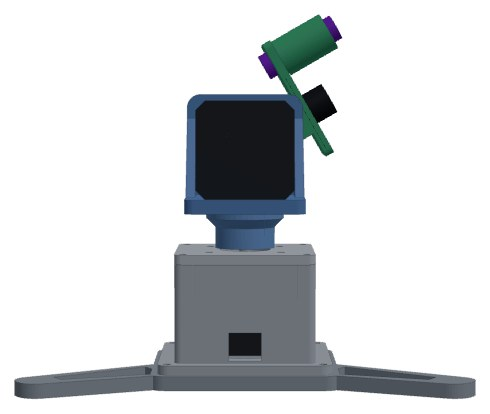
tools/mk3/tower/img/side_p30.jpg
