pranshukesavmishra/SIH-2026/tools/mk3/tower/img/top0.jpg

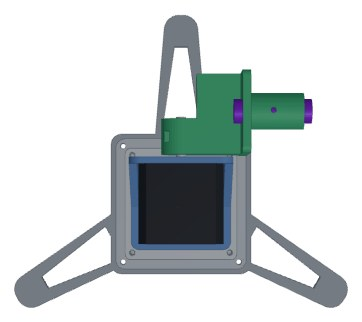
tools/mk3/tower/img/top0.jpg
