pranshukesavmishra/SIH-2026/tools/rig/MK2_connection_diagram.png

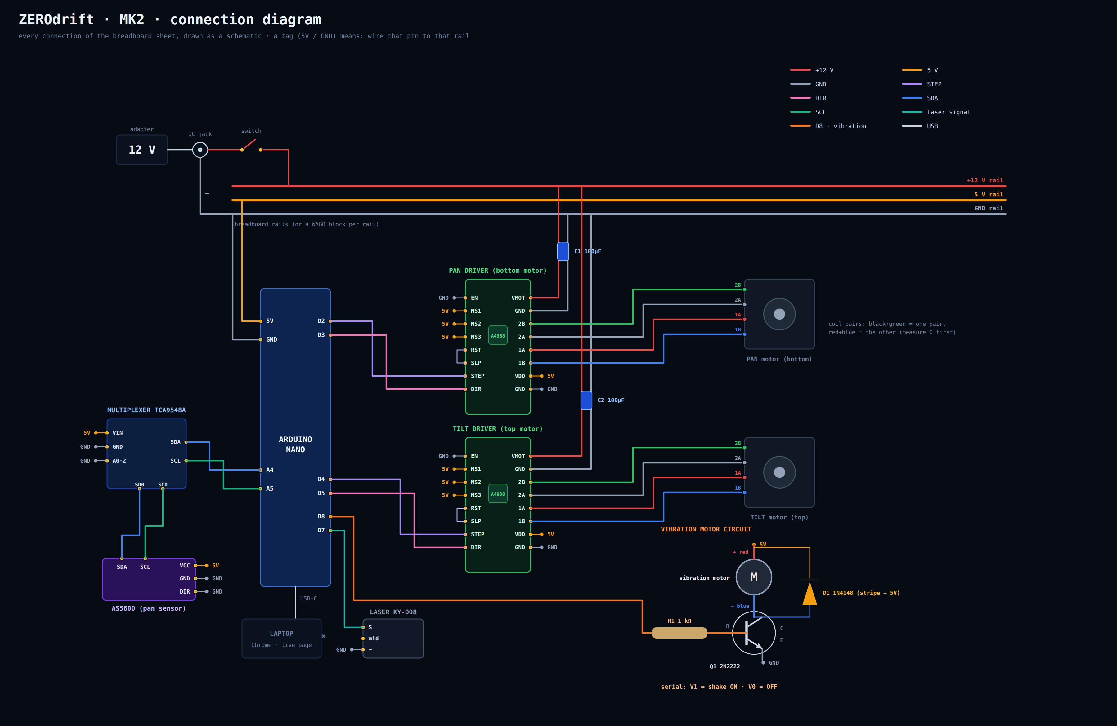
tools/rig/MK2_connection_diagram.png
