pranshukesavmishra/SIH-2026/tools/rig/mk2_infographic.png

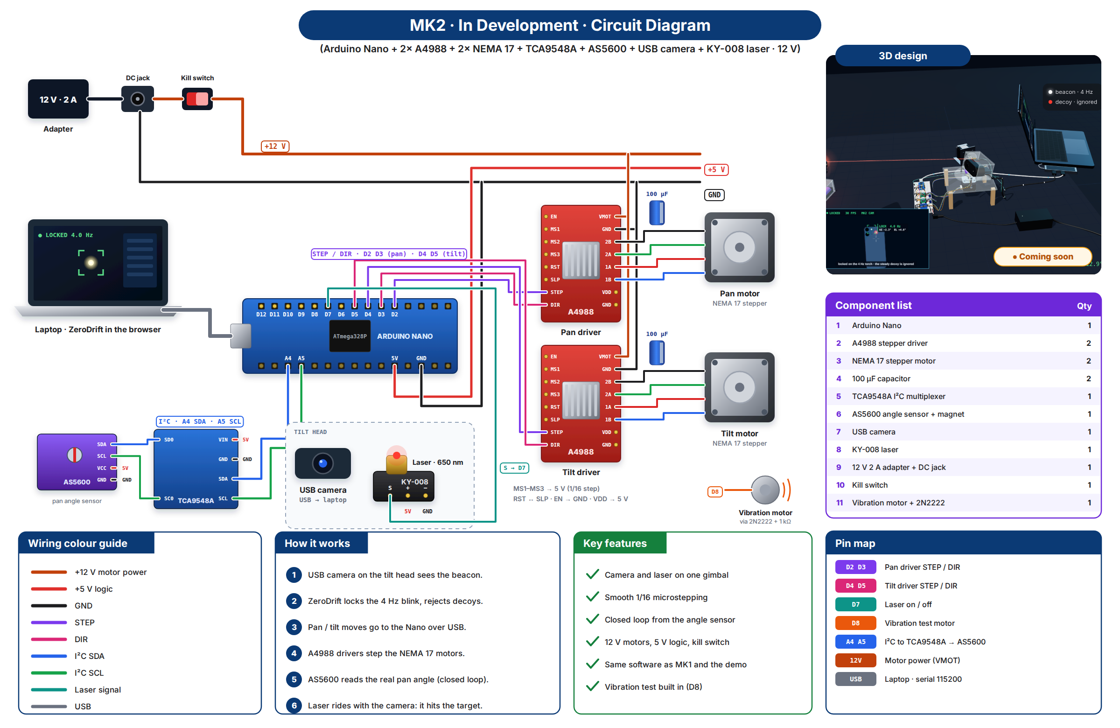
tools/rig/mk2_infographic.png
