pranshukesavmishra/SIH-2026/tools/rig/mk2_render.png

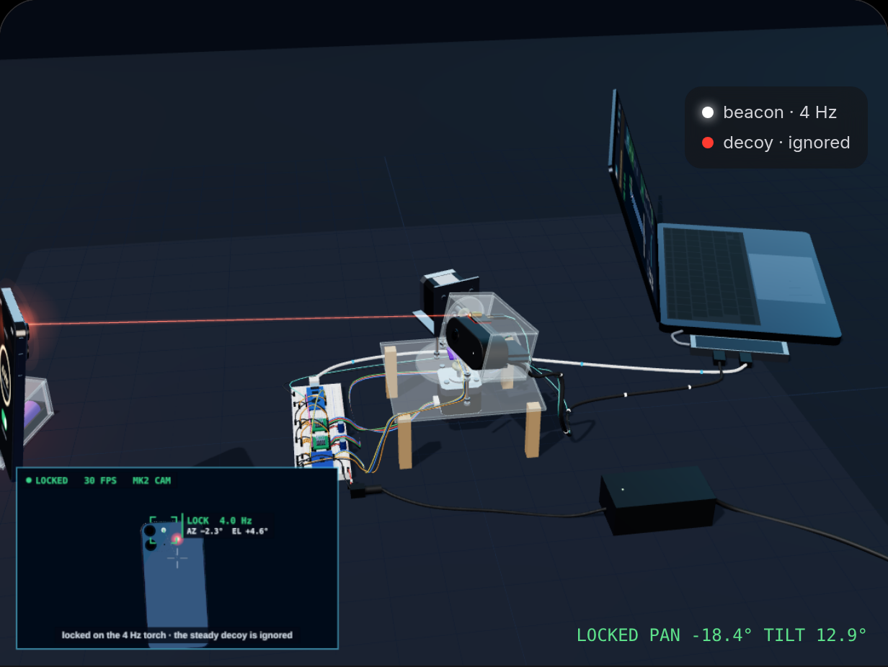
tools/rig/mk2_render.png
