pranshukesavmishra/SIH-2026/tools/rig/MK2_vibration_motor.png

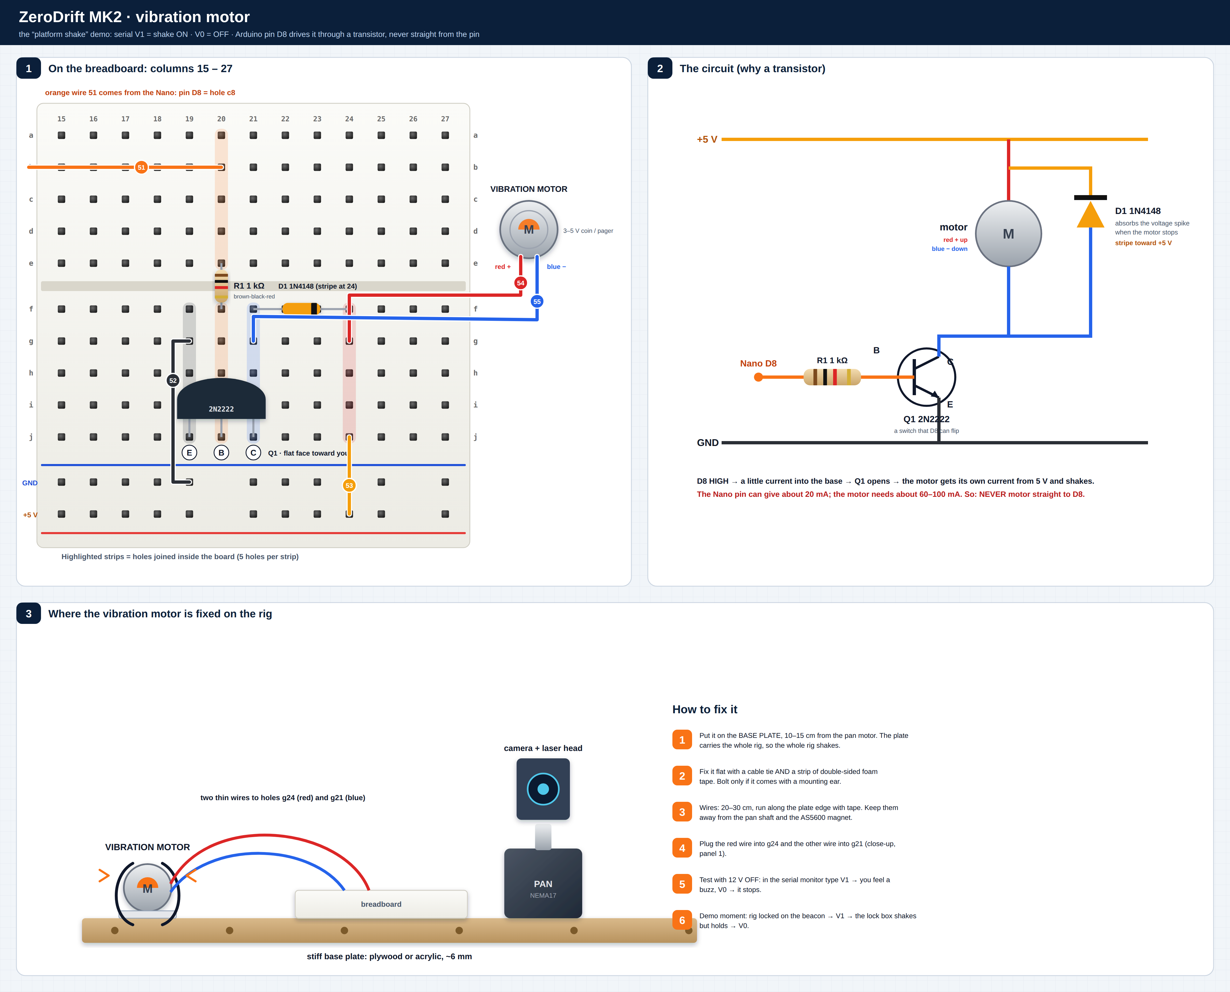
tools/rig/MK2_vibration_motor.png
