pranshukesavmishra/SIH-2026/docs/mk3/img/parts/01_base_hub.jpg

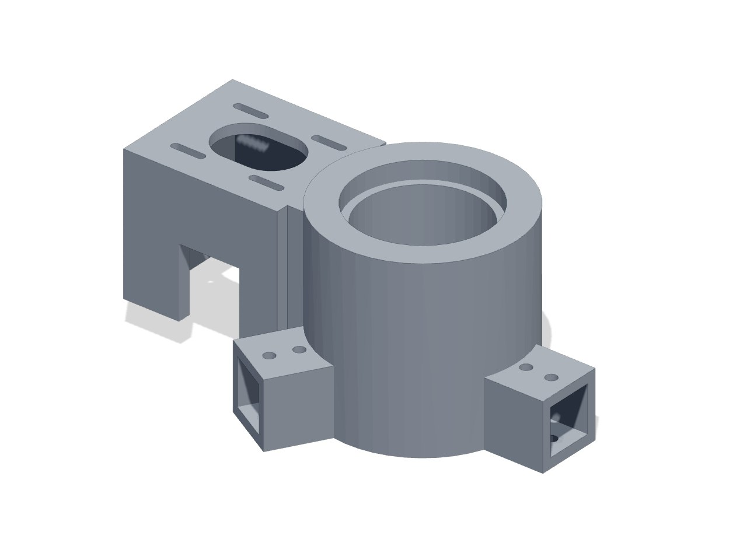
docs/mk3/img/parts/01_base_hub.jpg
