pranshukesavmishra/SIH-2026/docs/mk3/img/parts/02_leg.jpg

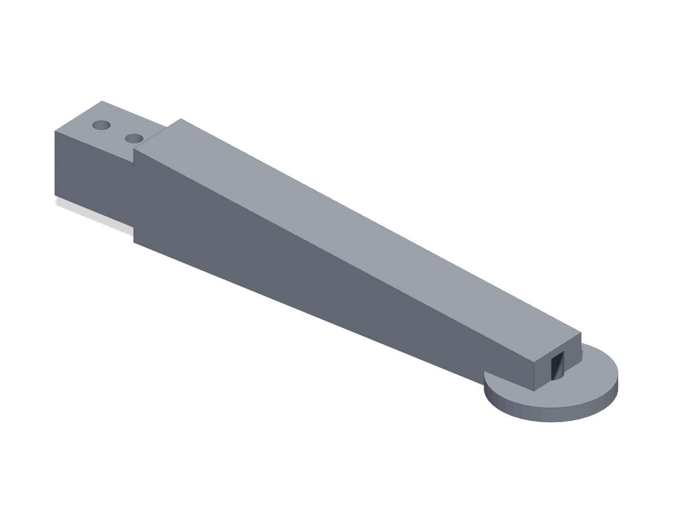
docs/mk3/img/parts/02_leg.jpg
