pranshukesavmishra/SIH-2026/docs/mk3/img/parts/03_pan_sensor_bridge.jpg

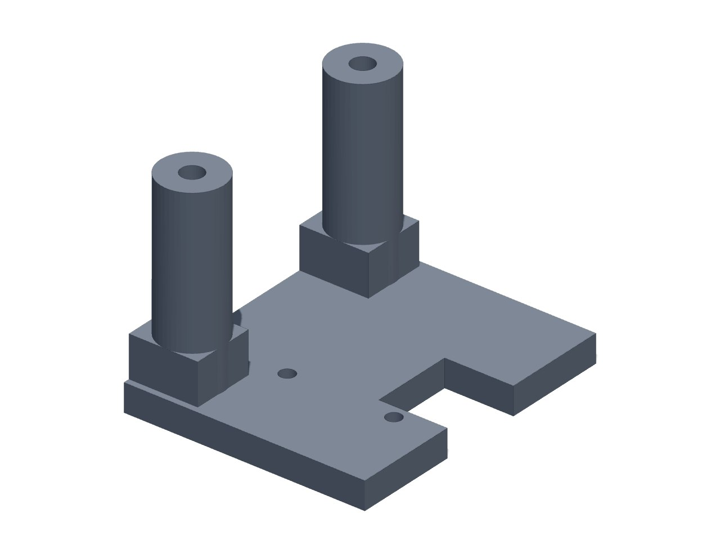
docs/mk3/img/parts/03_pan_sensor_bridge.jpg
