pranshukesavmishra/SIH-2026/docs/mk3/img/parts/04_magnet_cap.jpg

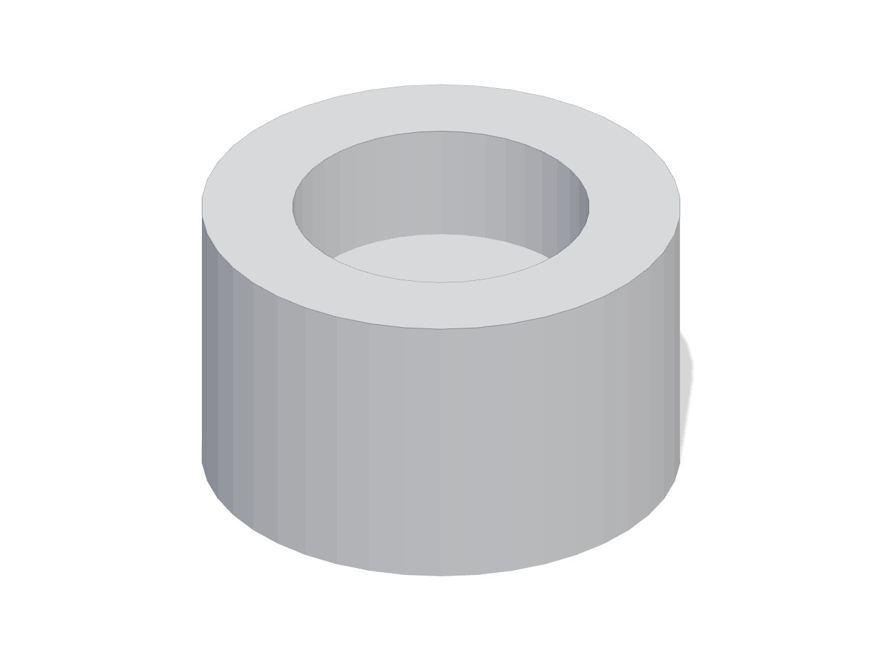
docs/mk3/img/parts/04_magnet_cap.jpg
