pranshukesavmishra/SIH-2026/docs/mk3/img/parts/05_spindle_washer.jpg

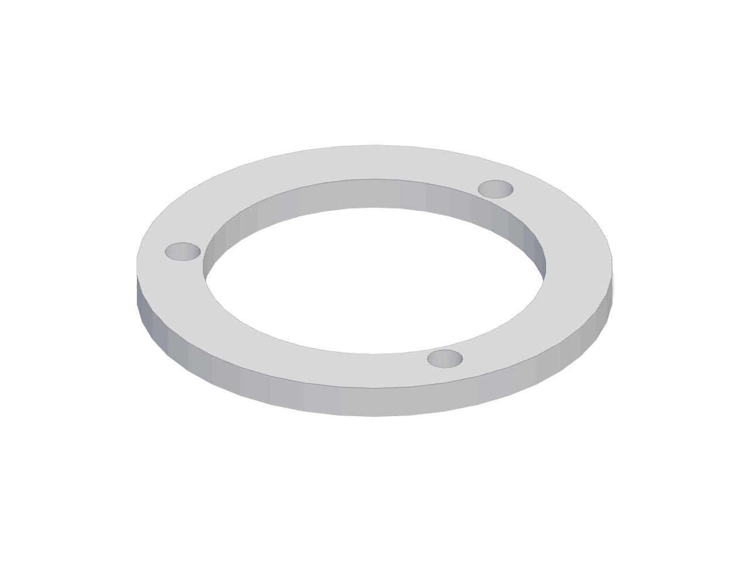
docs/mk3/img/parts/05_spindle_washer.jpg
