pranshukesavmishra/SIH-2026/docs/mk3/img/parts/06_pan_turntable.jpg

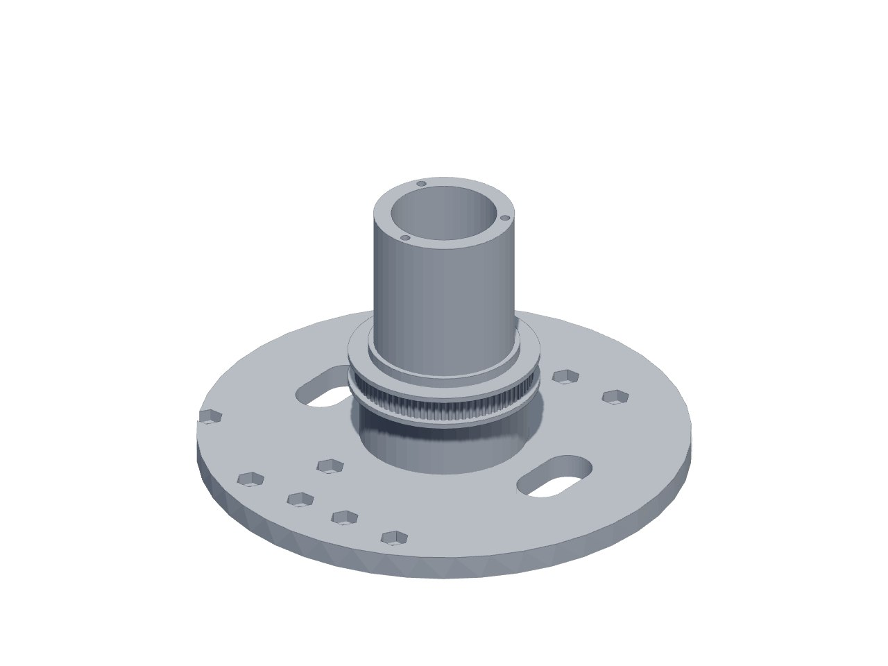
docs/mk3/img/parts/06_pan_turntable.jpg
