pranshukesavmishra/SIH-2026/docs/mk3/img/parts/07_arm_right.jpg

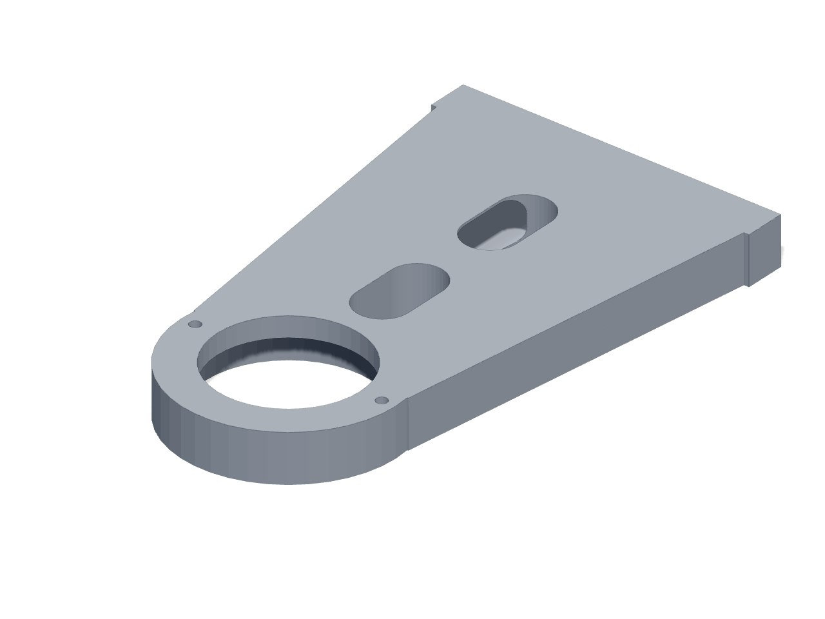
docs/mk3/img/parts/07_arm_right.jpg
