pranshukesavmishra/SIH-2026/docs/mk3/img/parts/09_tilt_motor_plate.jpg

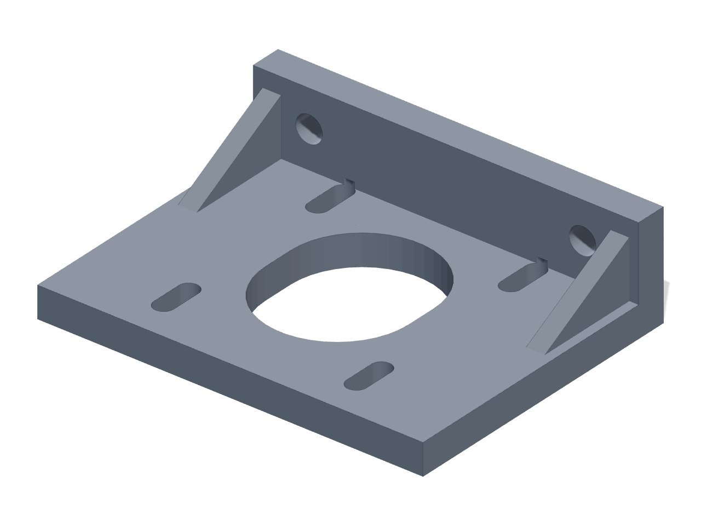
docs/mk3/img/parts/09_tilt_motor_plate.jpg
