pranshukesavmishra/SIH-2026/docs/mk3/img/parts/10_tilt_sensor_bracket.jpg

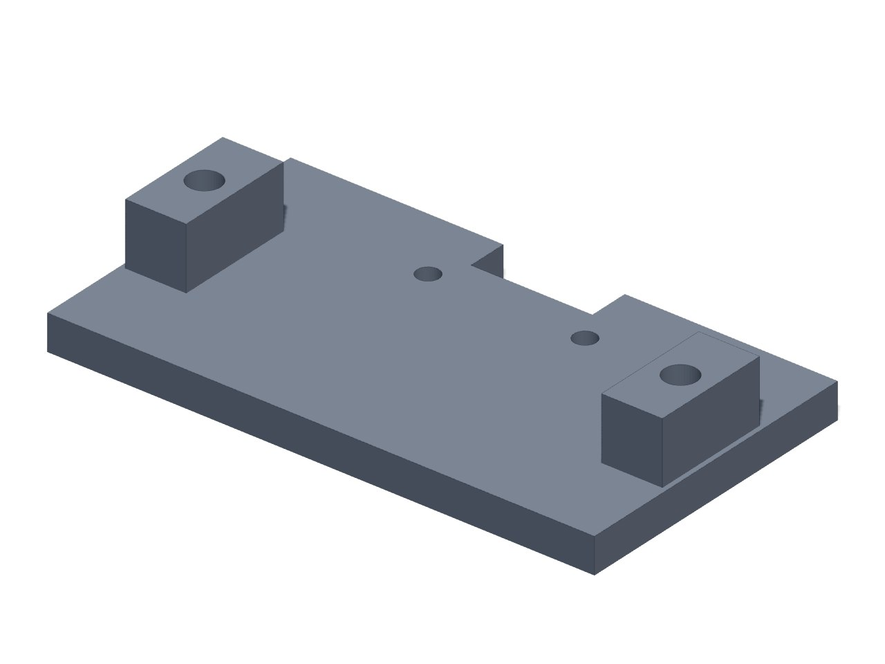
docs/mk3/img/parts/10_tilt_sensor_bracket.jpg
