pranshukesavmishra/SIH-2026/docs/mk3/img/parts/11_head.jpg

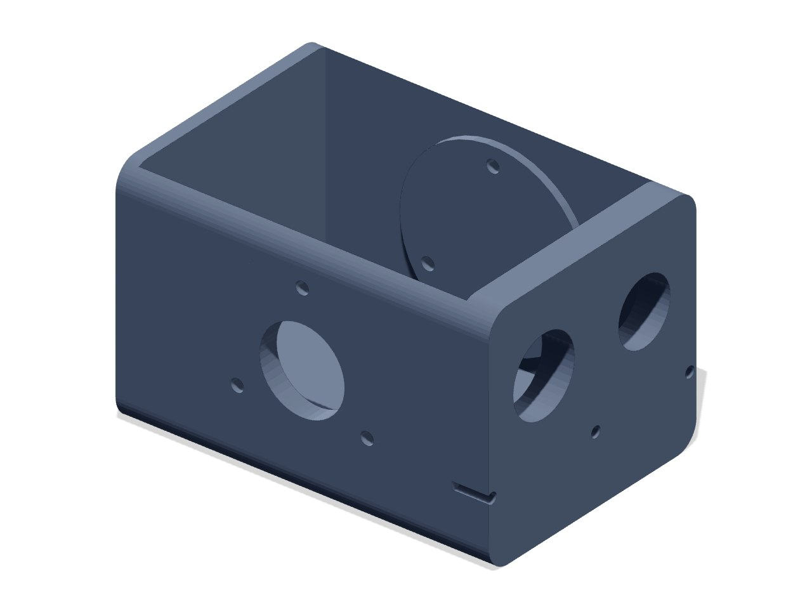
docs/mk3/img/parts/11_head.jpg
