pranshukesavmishra/SIH-2026/docs/mk3/img/parts/12_front_plate.jpg

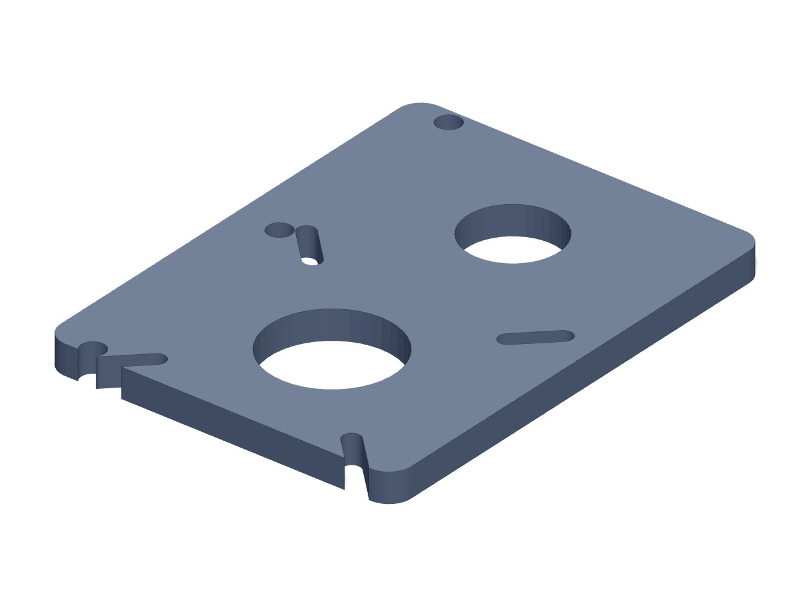
docs/mk3/img/parts/12_front_plate.jpg
