pranshukesavmishra/SIH-2026/docs/mk3/img/parts/13_laser_holder.jpg

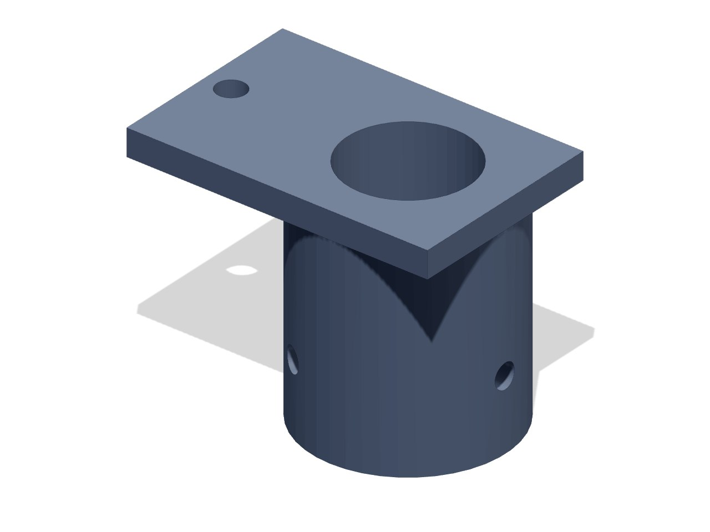
docs/mk3/img/parts/13_laser_holder.jpg
