pranshukesavmishra/SIH-2026/docs/mk3/img/parts/14_trunnion_left.jpg

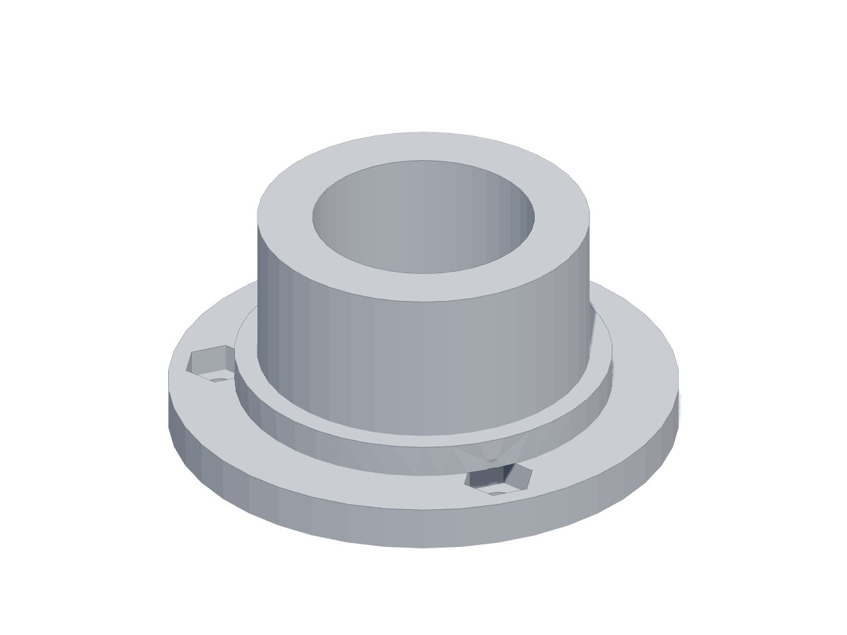
docs/mk3/img/parts/14_trunnion_left.jpg
