pranshukesavmishra/SIH-2026/docs/mk3/img/parts/15_trunnion_right.jpg

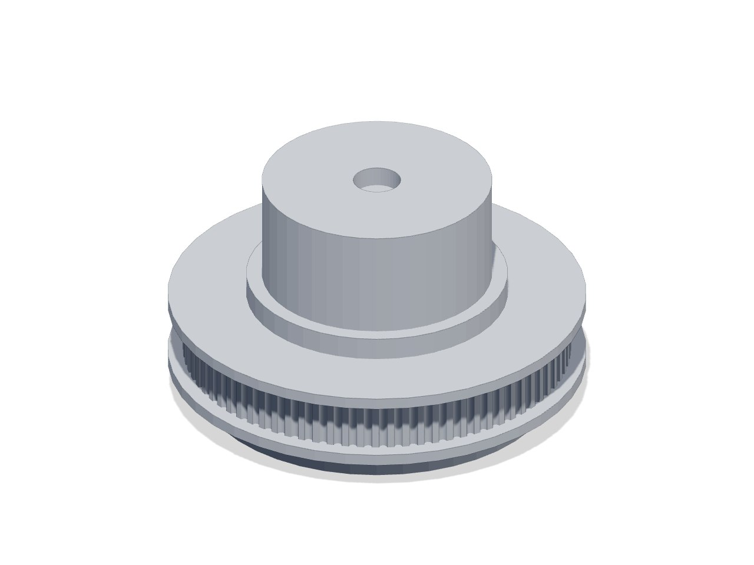
docs/mk3/img/parts/15_trunnion_right.jpg
