pranshukesavmishra/SIH-2026/docs/cad/zerodrift_gimbal_assembly.stl

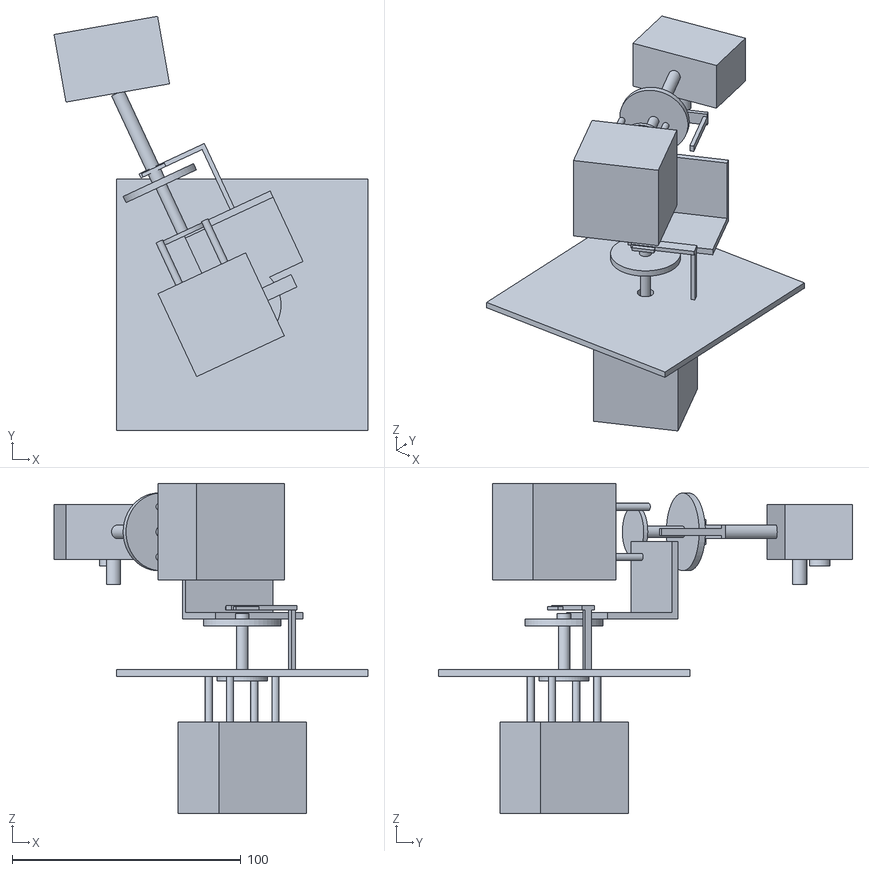
[picture p179: CAD file, 2026-09-24]
docs/cad/zerodrift_gimbal_assembly.stl
137.3 x 181.2 x 144.3
