pranshukesavmishra/SIH-2026/docs/cad/web/pan_strip.stl

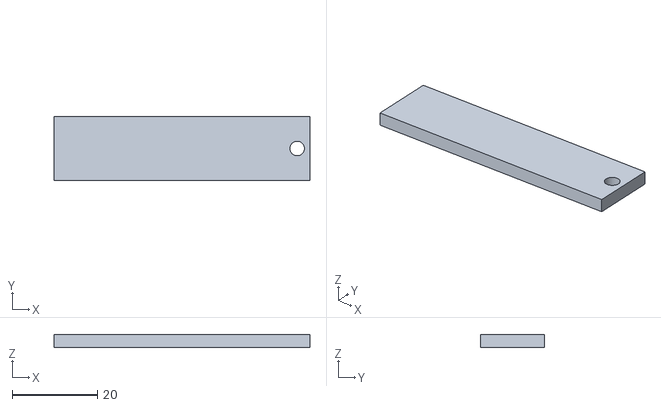
[picture p180: CAD file, 2026-09-26]
docs/cad/web/pan_strip.stl
60.0 x 15.0 x 3.00
