pranshukesavmishra/SIH-2026/docs/cad/zerodrift_head.stl

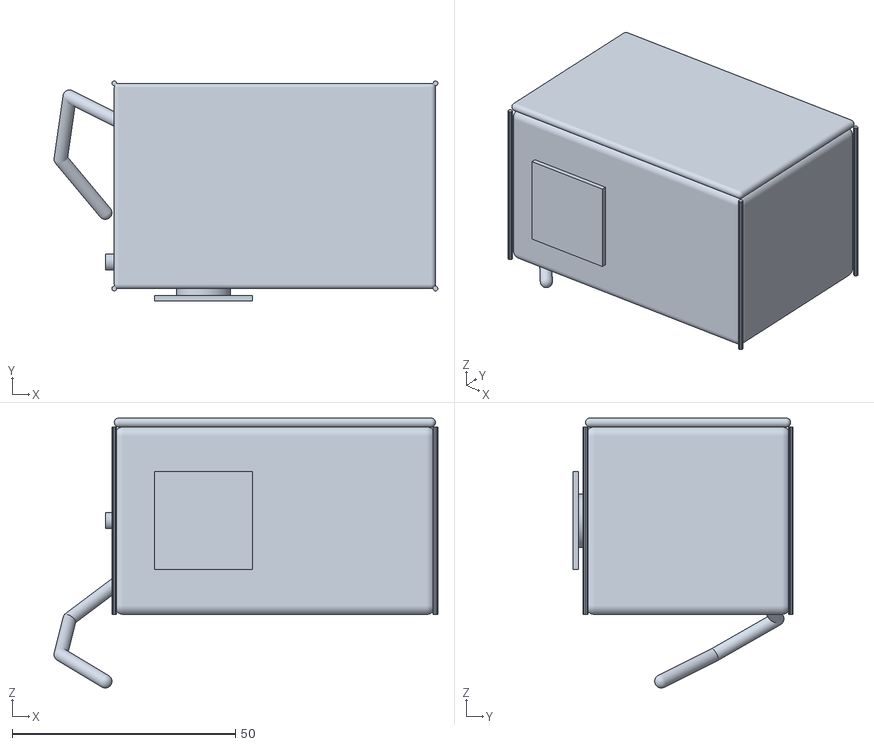
[picture p181: CAD file, 2026-09-24]
docs/cad/zerodrift_head.stl
86.0 x 49.3 x 60.5
