pranshukesavmishra/SIH-2026/docs/mk3/models/13_laser_holder.stl

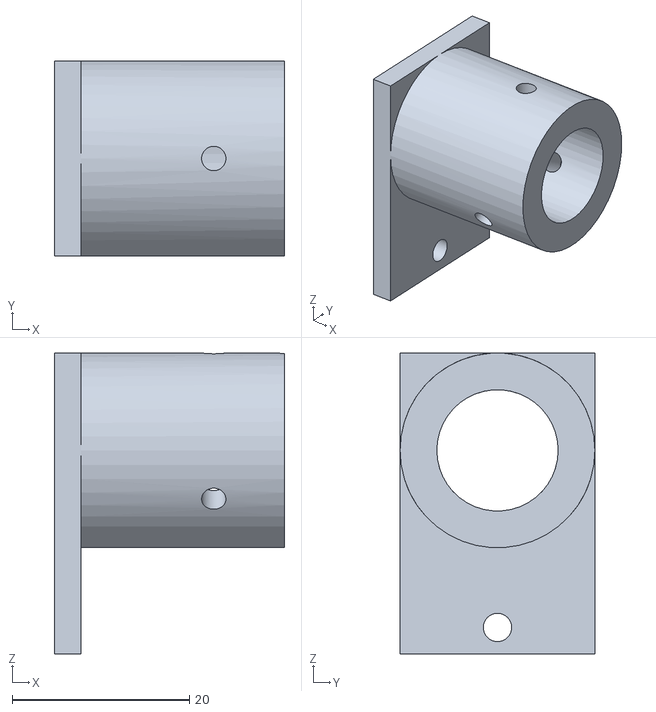
[picture p182: CAD file, 2026-09-30]
docs/mk3/models/13_laser_holder.stl
26.0 x 22.0 x 34.0
