pranshukesavmishra/SIH-2026/tools/mk3/out/step/09_tilt_motor_plate.step

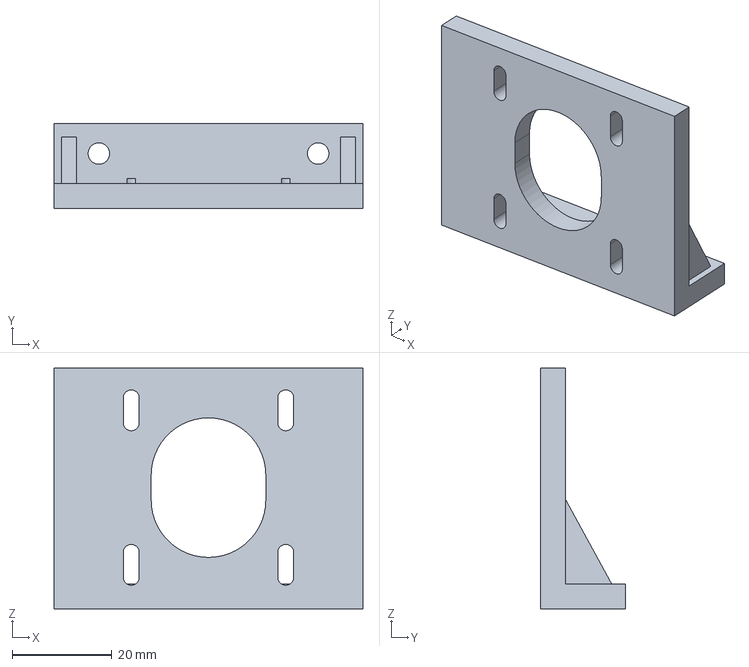
[picture p183: CAD file, 2026-09-30]
tools/mk3/out/step/09_tilt_motor_plate.step
62.0 x 17.0 x 48.3 mm
