pranshukesavmishra/SIH-2026/tools/mk3/tower/out/assembly/06_head.stl

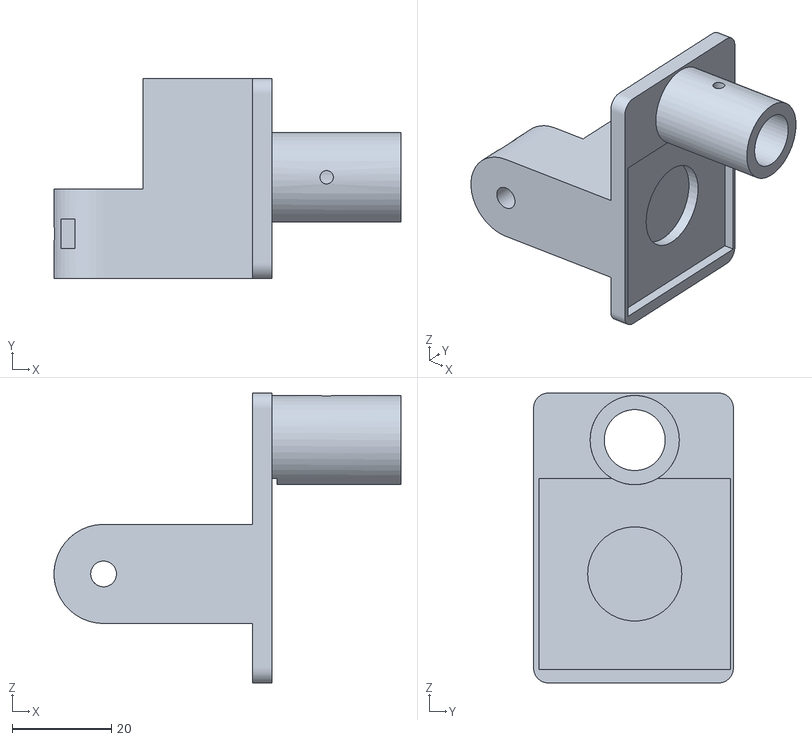
[picture p184: CAD file, 2026-10-03]
tools/mk3/tower/out/assembly/06_head.stl
70.0 x 40.3 x 58.5
