pranshukesavmishra/SIH-2026/tools/mk3/tower/out/step/01_tripod_base.step

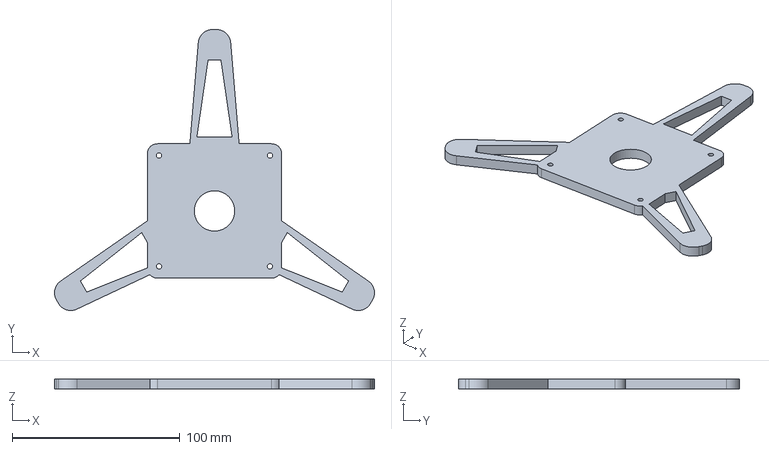
[picture p185: CAD file, 2026-10-03]
tools/mk3/tower/out/step/01_tripod_base.step
190.5 x 167.3 x 6.00 mm
