pranshukesavmishra/SIH-2026/docs/cad/web/pan_sensor.stl

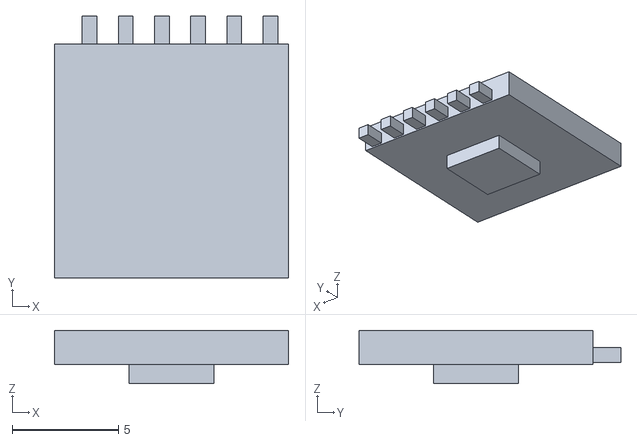
[picture p186: CAD file, 2026-09-26]
docs/cad/web/pan_sensor.stl
11.0 x 12.3 x 2.50
