pranshukesavmishra/SIH-2026/docs/cad/zerodrift_rig.stl

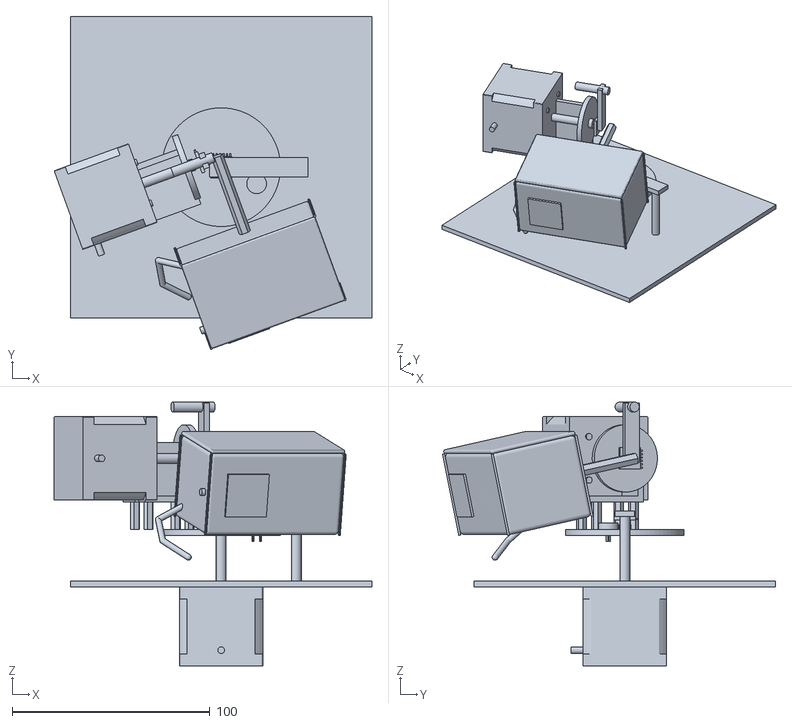
[picture p187: CAD file, 2026-09-24]
docs/cad/zerodrift_rig.stl
160.7 x 168.4 x 133.5
