pranshukesavmishra/SIH-2026/docs/mk3/models/m_pan_belt.stl

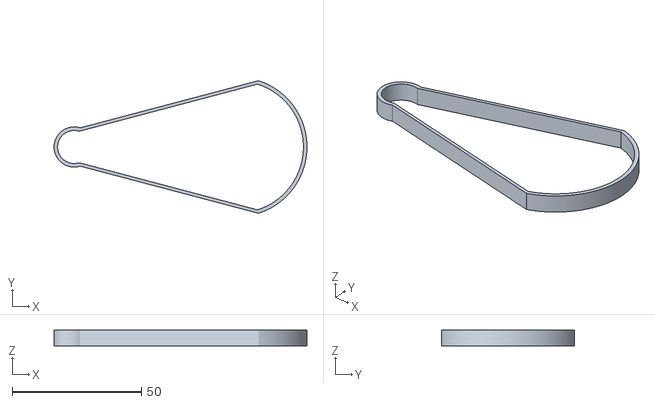
[picture p188: CAD file, 2026-09-30]
docs/mk3/models/m_pan_belt.stl
97.7 x 51.2 x 6.00
