pranshukesavmishra/SIH-2026/tools/mk3/out/step/02_leg_3.step

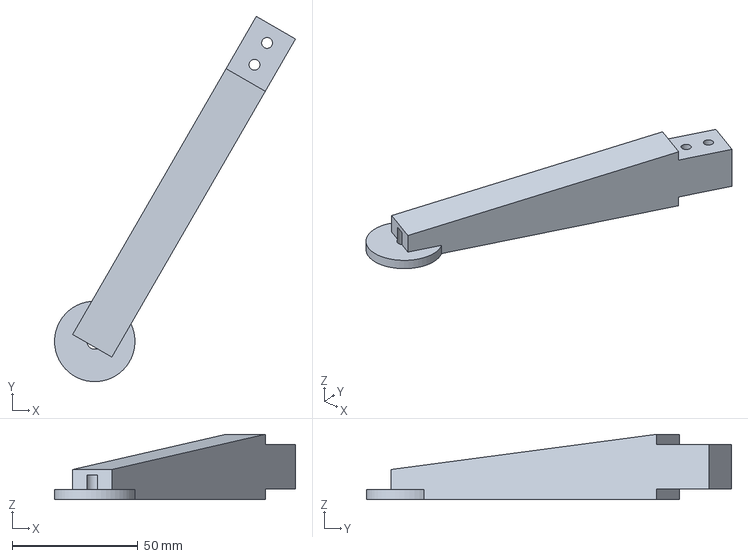
[picture p189: CAD file, 2026-09-30]
tools/mk3/out/step/02_leg_3.step
95.8 x 145.2 x 26.0 mm
