pranshukesavmishra/SIH-2026/tools/mk3/tower/out/assembly/05_tilt_mount.stl

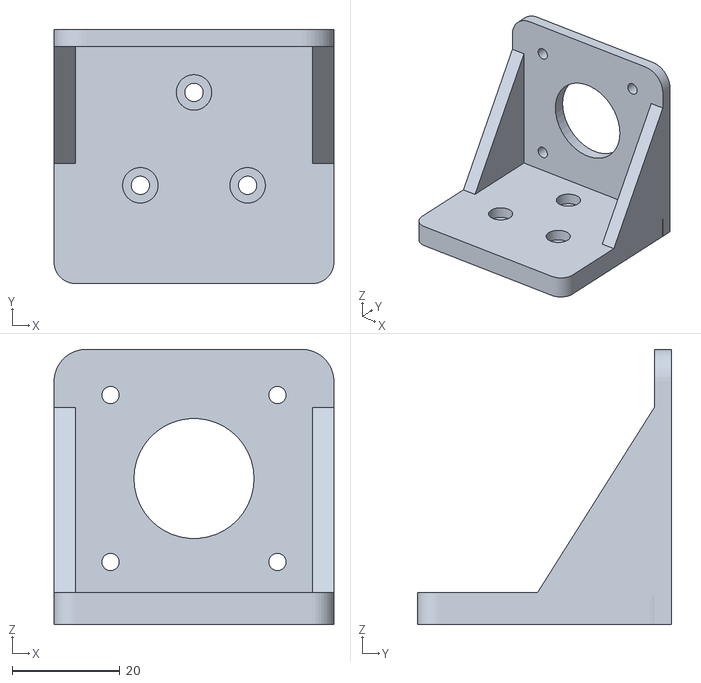
[picture p190: CAD file, 2026-10-03]
tools/mk3/tower/out/assembly/05_tilt_mount.stl
52.0 x 47.2 x 51.2
