pranshukesavmishra/SIH-2026/tools/mk3/tower/out/step/03_tower_cap.step

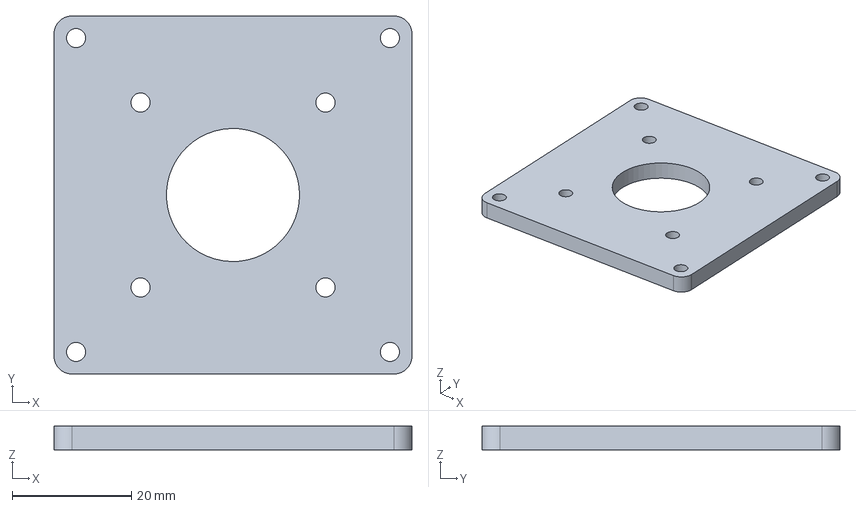
[picture p191: CAD file, 2026-10-03]
tools/mk3/tower/out/step/03_tower_cap.step
60.0 x 60.0 x 4.00 mm
