pranshukesavmishra/SIH-2026/docs/cad/web/tilt_motor.stl

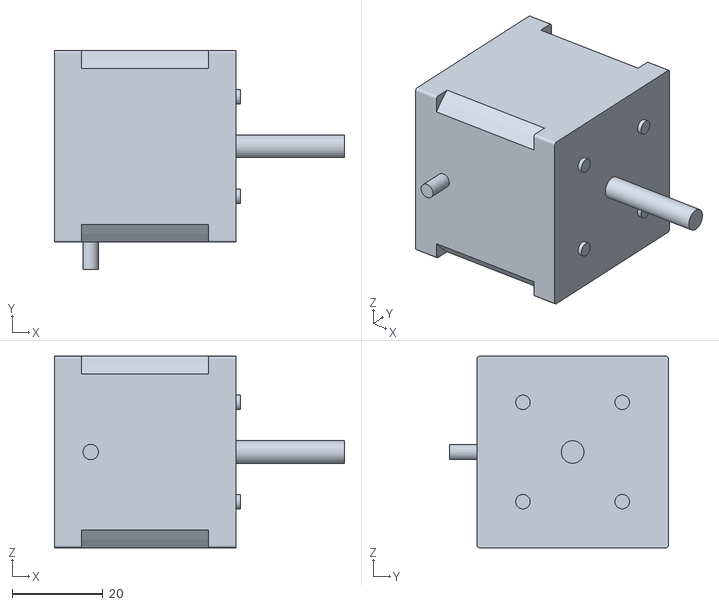
[picture p192: CAD file, 2026-09-26]
docs/cad/web/tilt_motor.stl
64.0 x 48.3 x 42.3
