pranshukesavmishra/SIH-2026/docs/mk3/models/15_trunnion_right.stl

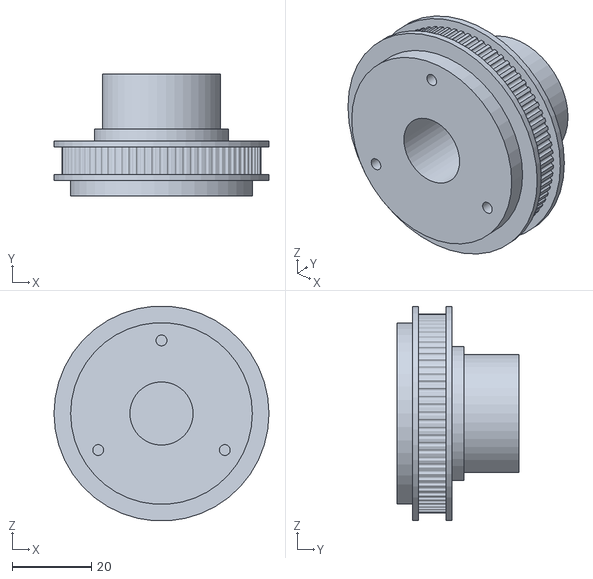
[picture p193: CAD file, 2026-09-30]
docs/mk3/models/15_trunnion_right.stl
54.4 x 31.0 x 54.3
