pranshukesavmishra/SIH-2026/tools/mk3/out/step/07_arm_right.step

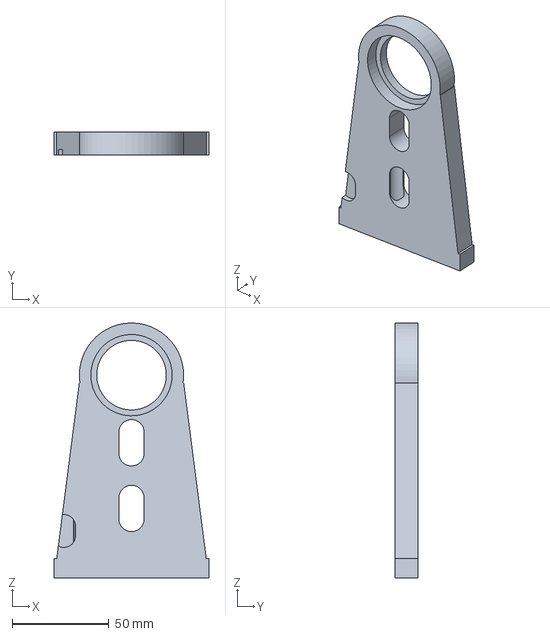
[picture p194: CAD file, 2026-09-30]
tools/mk3/out/step/07_arm_right.step
80.0 x 12.0 x 132.0 mm
