pranshukesavmishra/SIH-2026/tools/mk3/tower/out/assembly/04_pan_hub.stl

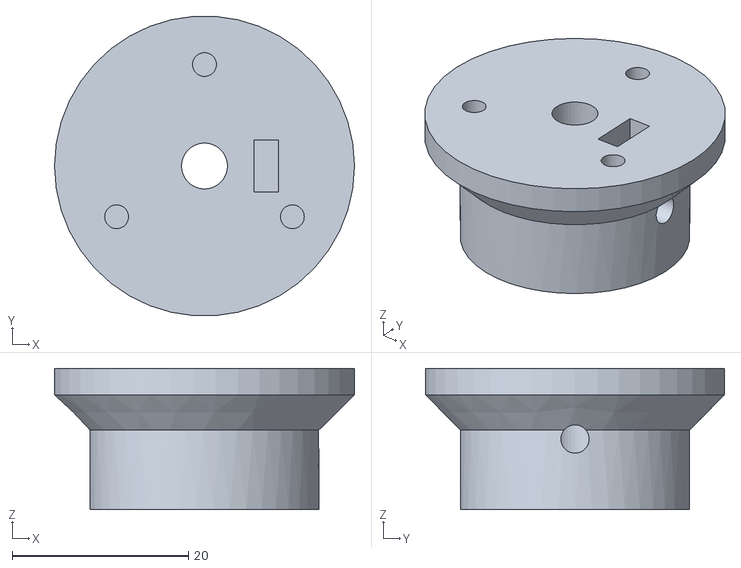
[picture p195: CAD file, 2026-10-03]
tools/mk3/tower/out/assembly/04_pan_hub.stl
34.0 x 33.9 x 16.0
