pranshukesavmishra/SIH-2026/docs/cad/zerodrift_encoder_detail.stl

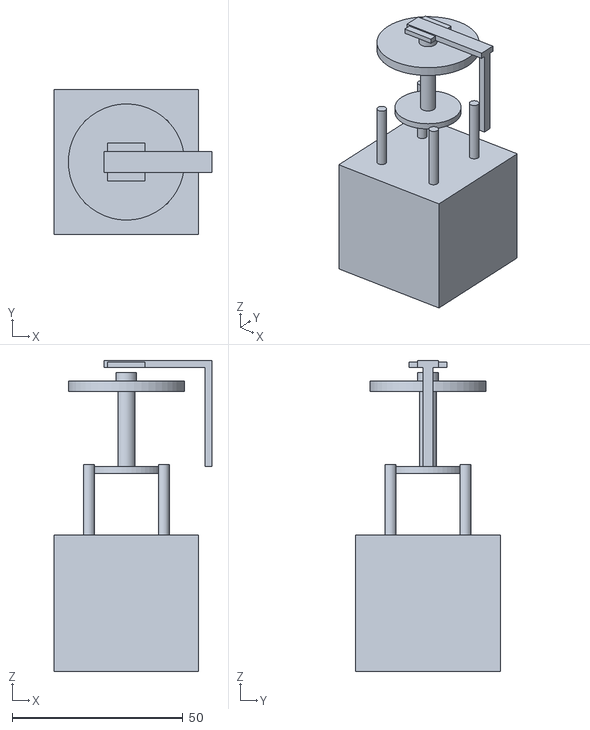
[picture p196: CAD file, 2026-09-24]
docs/cad/zerodrift_encoder_detail.stl
46.1 x 42.3 x 91.0
