pranshukesavmishra/SIH-2026/docs/mk3/models/m_tilt_belt.stl

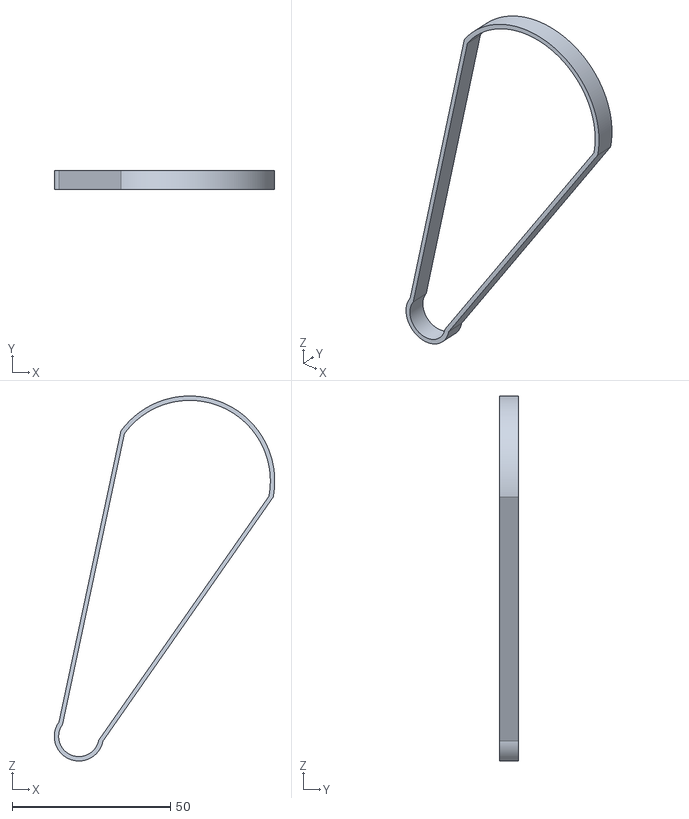
[picture p197: CAD file, 2026-09-30]
docs/mk3/models/m_tilt_belt.stl
69.6 x 6.00 x 115.3
