pranshukesavmishra/SIH-2026/tools/mk3/out/step/14_trunnion_left.step

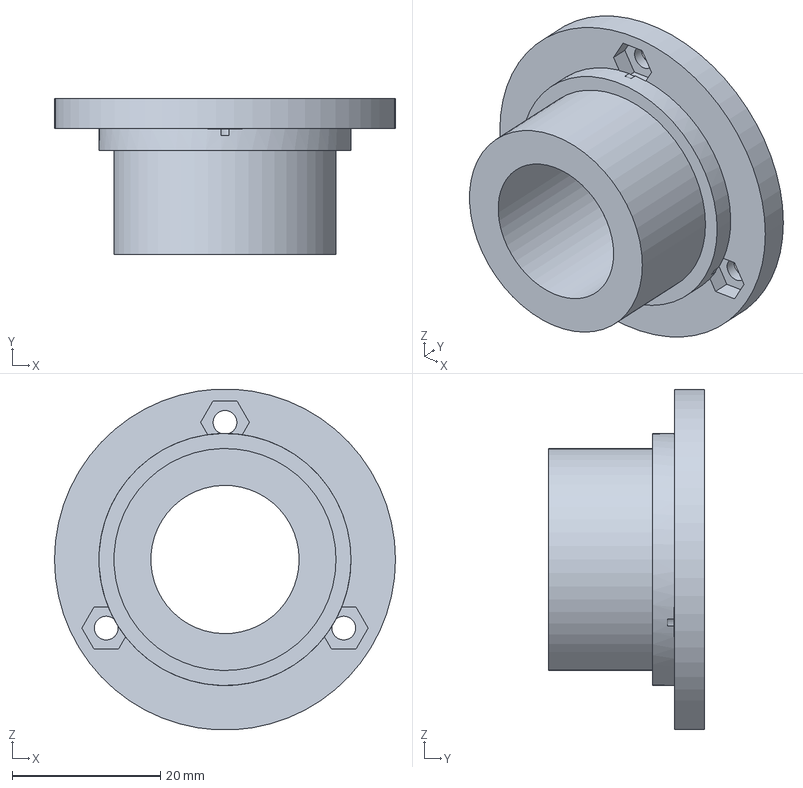
[picture p198: CAD file, 2026-09-30]
tools/mk3/out/step/14_trunnion_left.step
46.0 x 21.0 x 45.9 mm
