pranshukesavmishra/SIH-2026/tools/mk3/tower/out/assembly/m_camera.stl

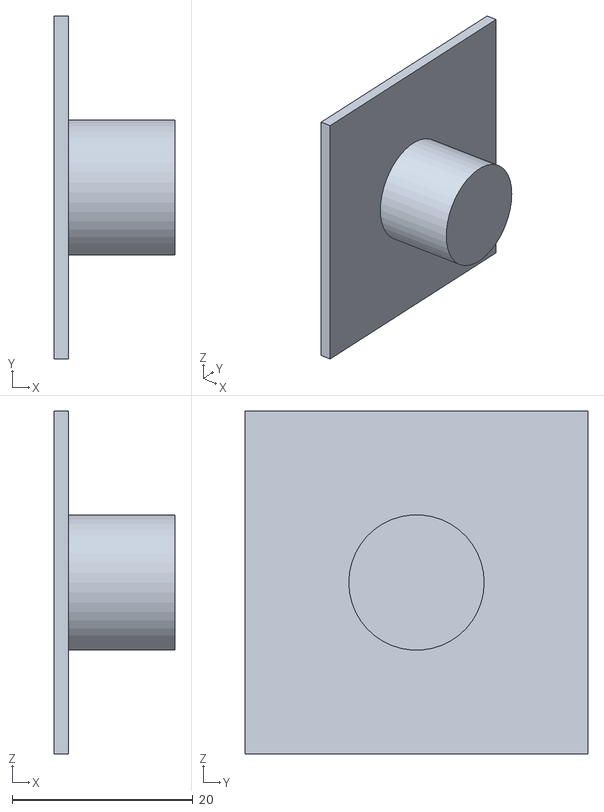
[picture p199: CAD file, 2026-10-03]
tools/mk3/tower/out/assembly/m_camera.stl
13.4 x 38.0 x 38.0
