pranshukesavmishra/SIH-2026/tools/mk3/tower/out/step/02_tower_sleeve.step

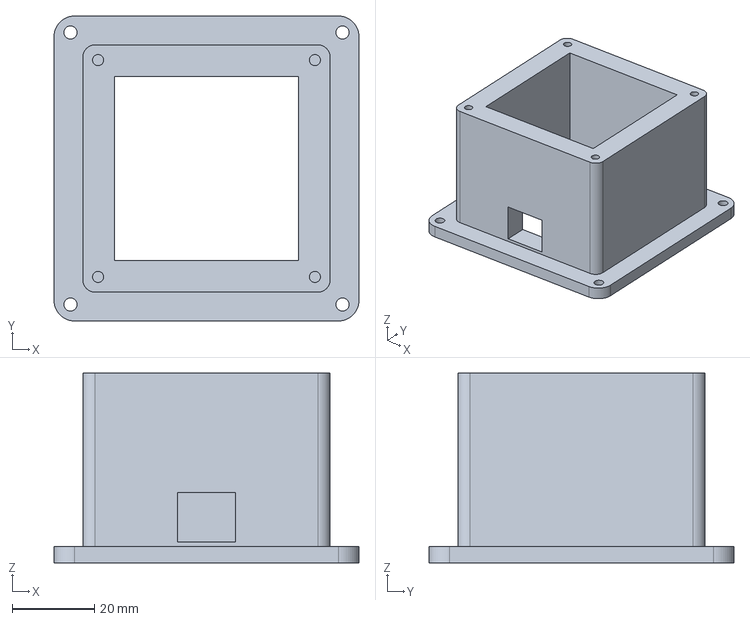
[picture p200: CAD file, 2026-10-03]
tools/mk3/tower/out/step/02_tower_sleeve.step
74.0 x 74.0 x 46.0 mm
