pranshukesavmishra/SIH-2026/docs/cad/web/head_laser.stl

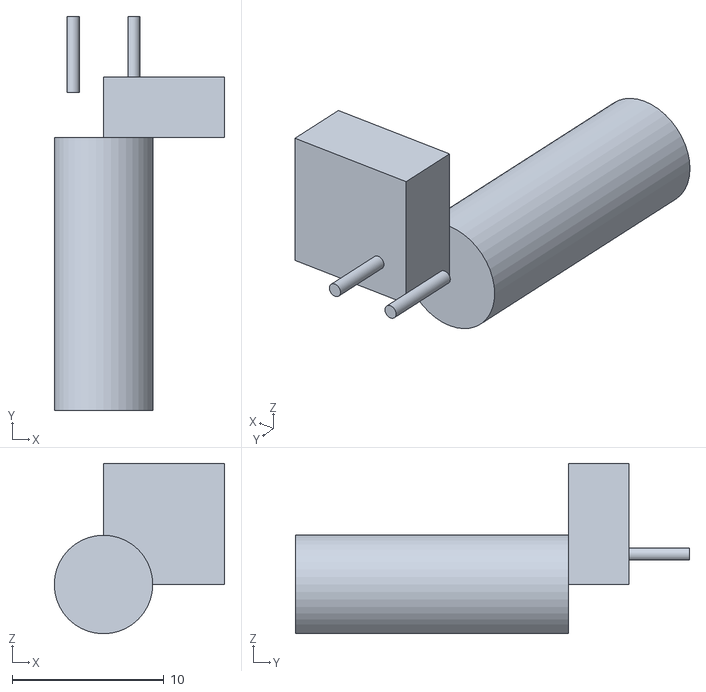
[picture p201: CAD file, 2026-09-26]
docs/cad/web/head_laser.stl
11.2 x 26.0 x 11.2
