pranshukesavmishra/SIH-2026/docs/mk3/models/m_tilt_as5600.stl

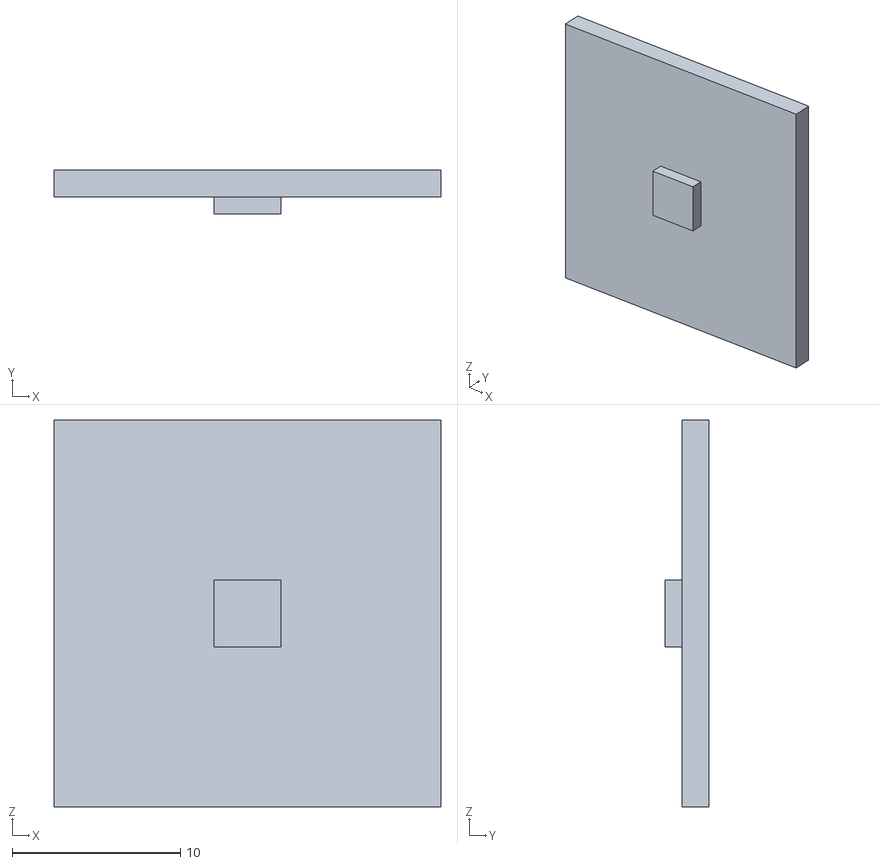
[picture p202: CAD file, 2026-09-30]
docs/mk3/models/m_tilt_as5600.stl
23.0 x 2.60 x 23.0
