pranshukesavmishra/SIH-2026/tools/mk3/out/step/02_leg_1.step

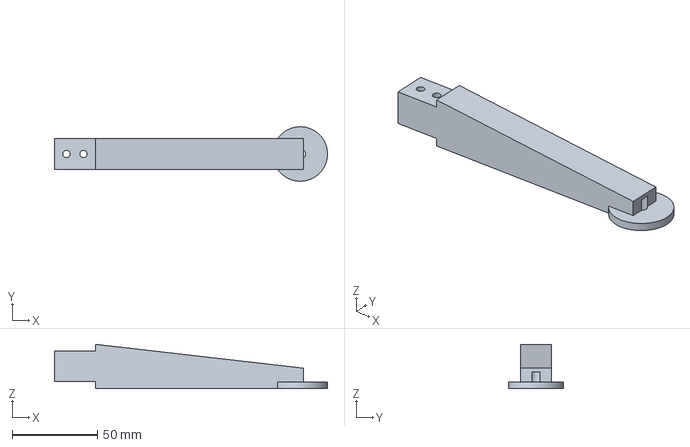
[picture p203: CAD file, 2026-09-30]
tools/mk3/out/step/02_leg_1.step
160.0 x 32.0 x 26.0 mm
