pranshukesavmishra/SIH-2026/tools/mk3/tower/out/assembly/m_pan_motor.stl

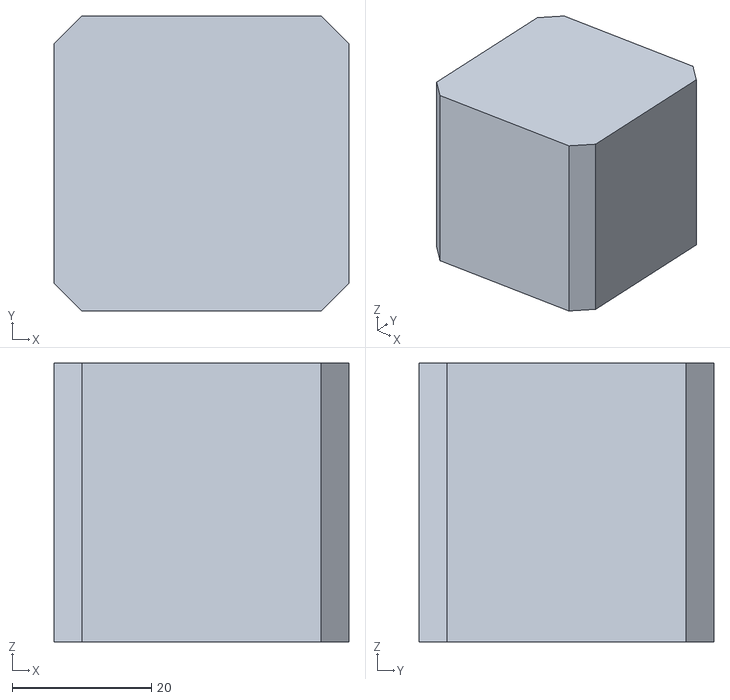
[picture p204: CAD file, 2026-10-03]
tools/mk3/tower/out/assembly/m_pan_motor.stl
42.3 x 42.3 x 40.0
