pranshukesavmishra/SIH-2026/docs/cad/web/head_camera.stl

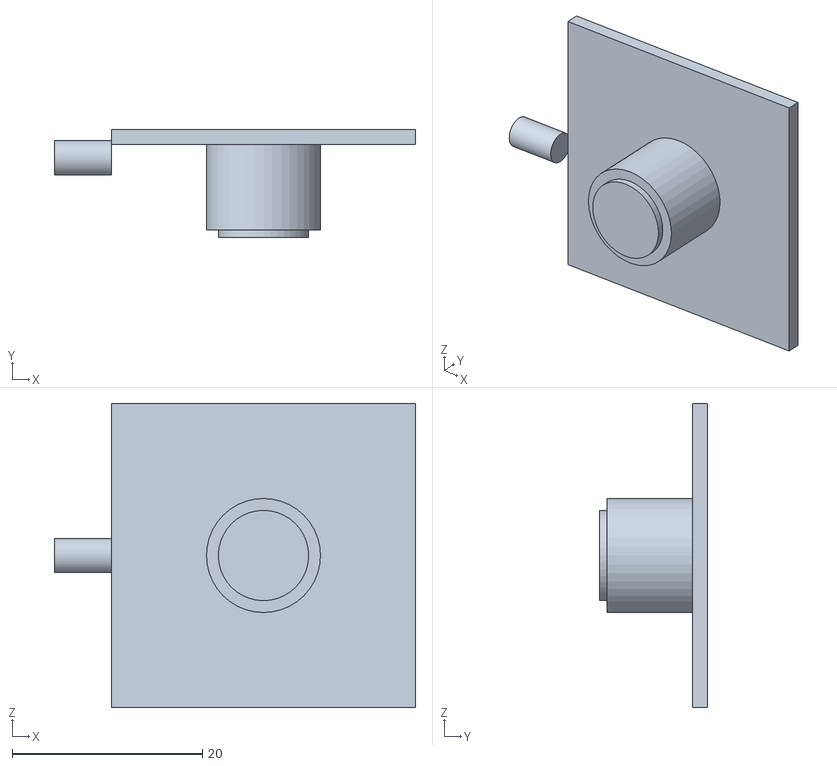
[picture p205: CAD file, 2026-09-26]
docs/cad/web/head_camera.stl
38.0 x 11.4 x 32.0
