pranshukesavmishra/SIH-2026/tools/mk3/out/step/00_test_coupon.step

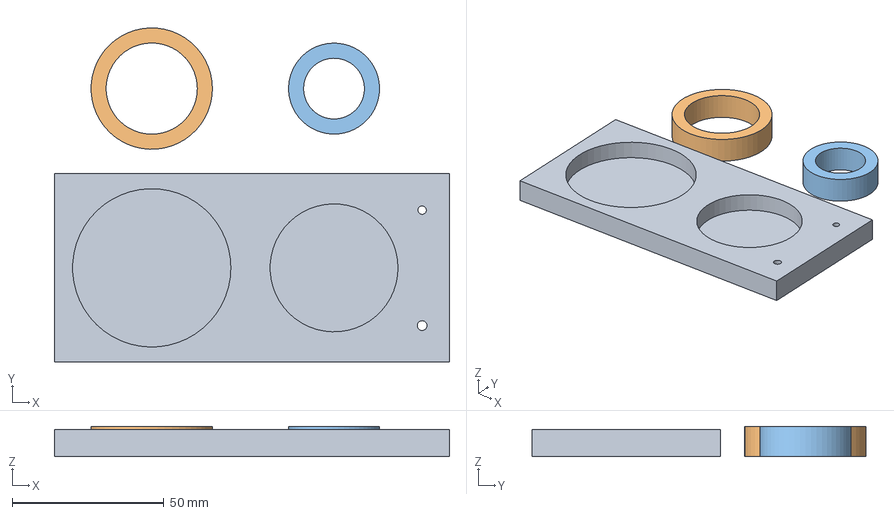
[picture p206: CAD file, 2026-09-30]
tools/mk3/out/step/00_test_coupon.step
130.0 x 110.0 x 10.0 mm
