pranshukesavmishra/SIH-2026/docs/cad/web/base.stl

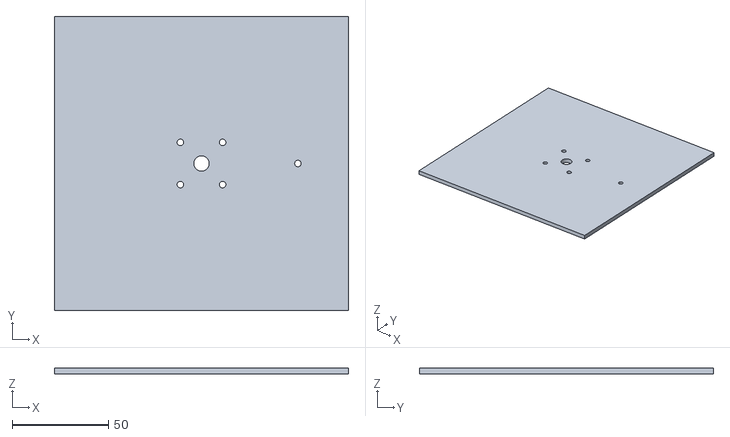
[picture p207: CAD file, 2026-09-26]
docs/cad/web/base.stl
152.4 x 152.4 x 3.00
