pranshukesavmishra/SIH-2026/tools/mk3/out/step/06_pan_turntable.step

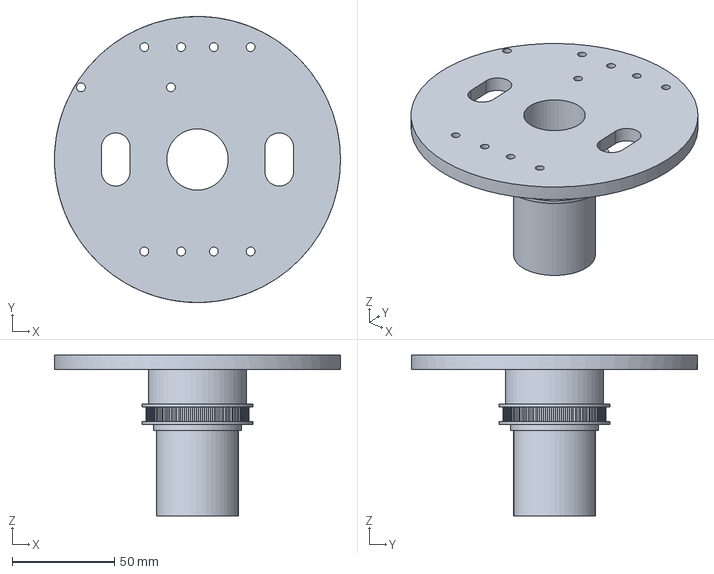
[picture p208: CAD file, 2026-09-30]
tools/mk3/out/step/06_pan_turntable.step
140.0 x 140.0 x 78.7 mm
