pranshukesavmishra/SIH-2026/tools/mk3/tower/out/assembly/m_tilt_boss.stl

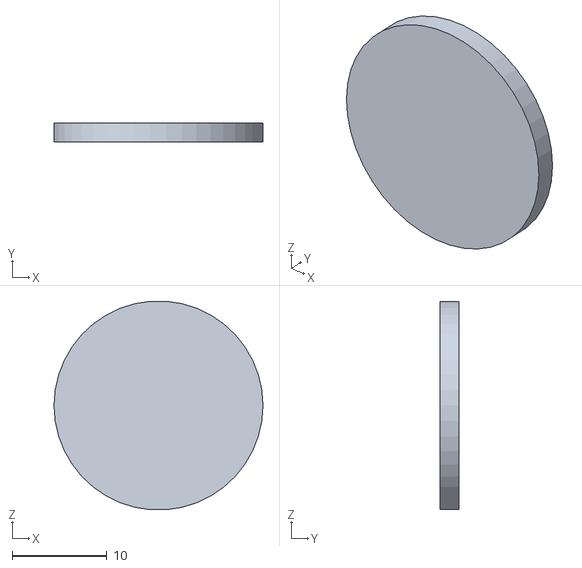
[picture p209: CAD file, 2026-10-03]
tools/mk3/tower/out/assembly/m_tilt_boss.stl
22.0 x 2.00 x 21.9
