pranshukesavmishra/SIH-2026/tools/mk3/tower/out/step/00_test_coupon.step

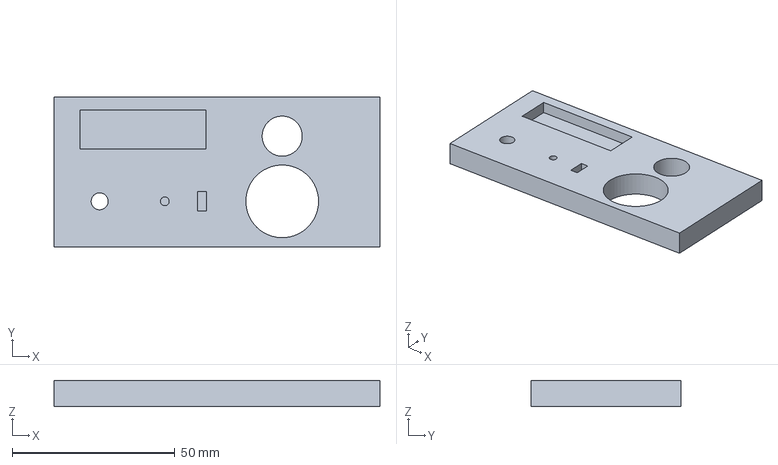
[picture p210: CAD file, 2026-10-03]
tools/mk3/tower/out/step/00_test_coupon.step
100.0 x 46.0 x 8.00 mm
