pranshukesavmishra/SIH-2026/docs/cad/web/vibration.stl

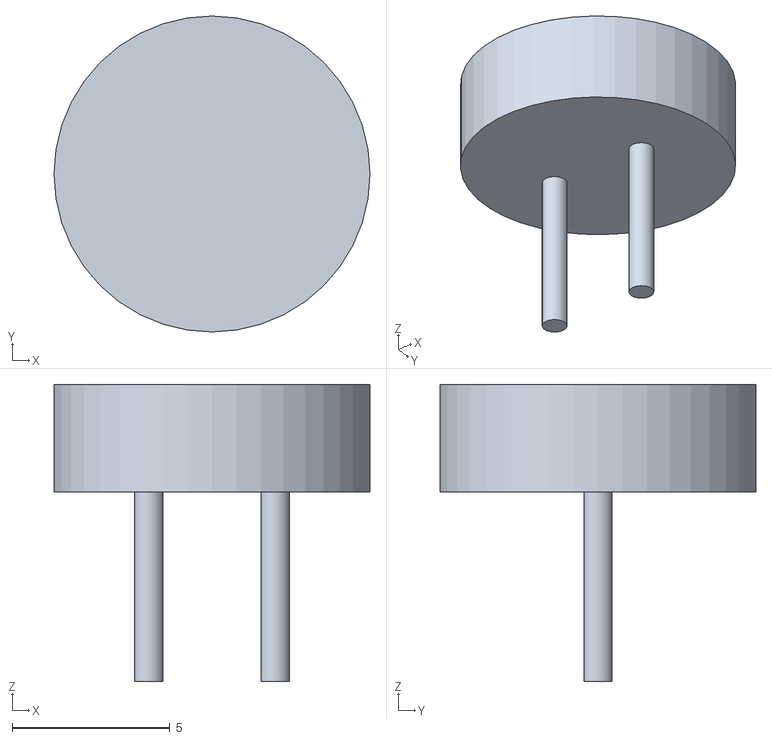
[picture p211: CAD file, 2026-09-26]
docs/cad/web/vibration.stl
10.0 x 10.0 x 9.40
