pranshukesavmishra/SIH-2026/tools/mk3/out/step/11_head.step

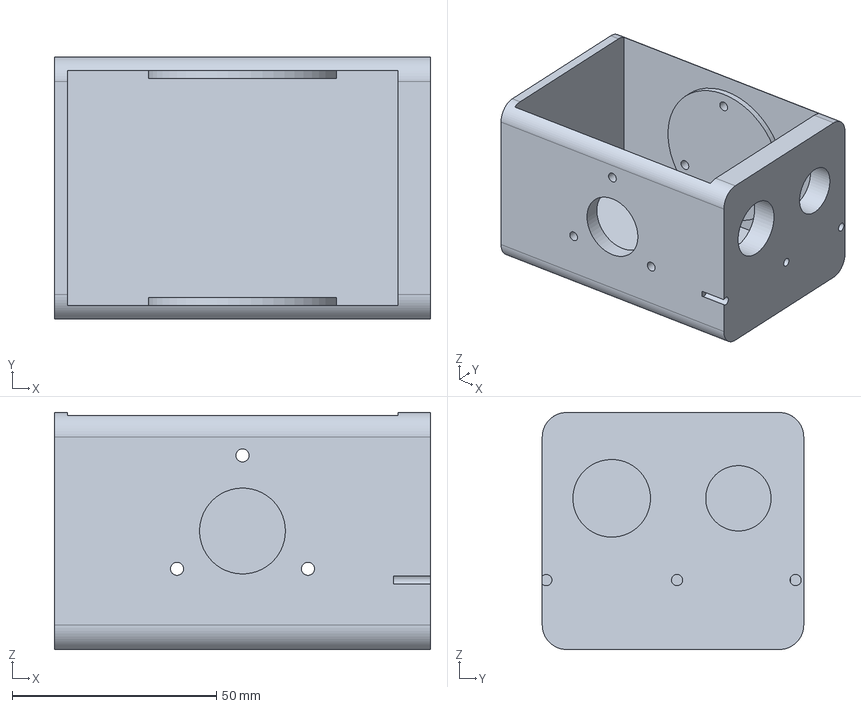
[picture p212: CAD file, 2026-09-30]
tools/mk3/out/step/11_head.step
92.0 x 64.0 x 58.0 mm
