pranshukesavmishra/SIH-2026/docs/cad/web/base_legs.stl

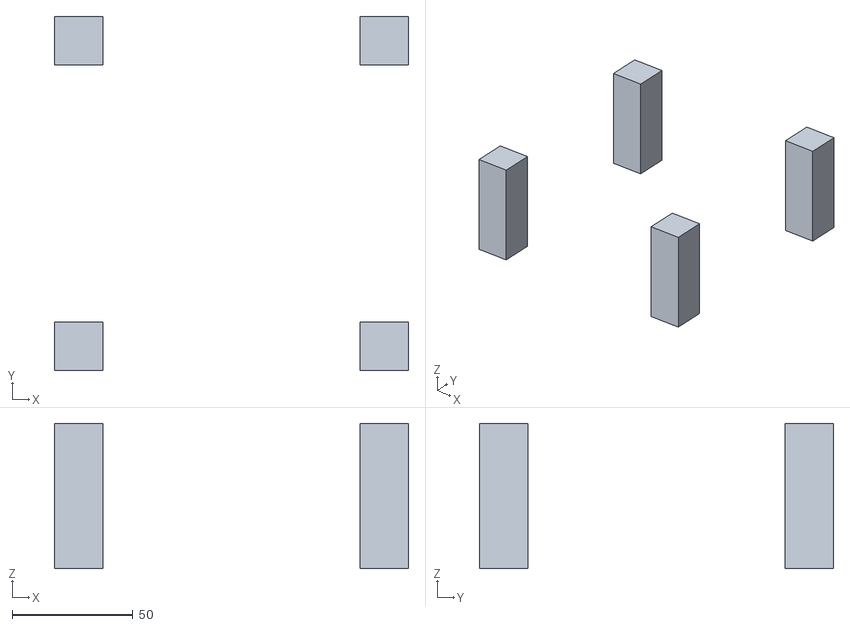
[picture p213: CAD file, 2026-09-26]
docs/cad/web/base_legs.stl
146.4 x 146.4 x 60.0
