pranshukesavmishra/SIH-2026/docs/mk3/models/m_tilt_motor_shaft.stl

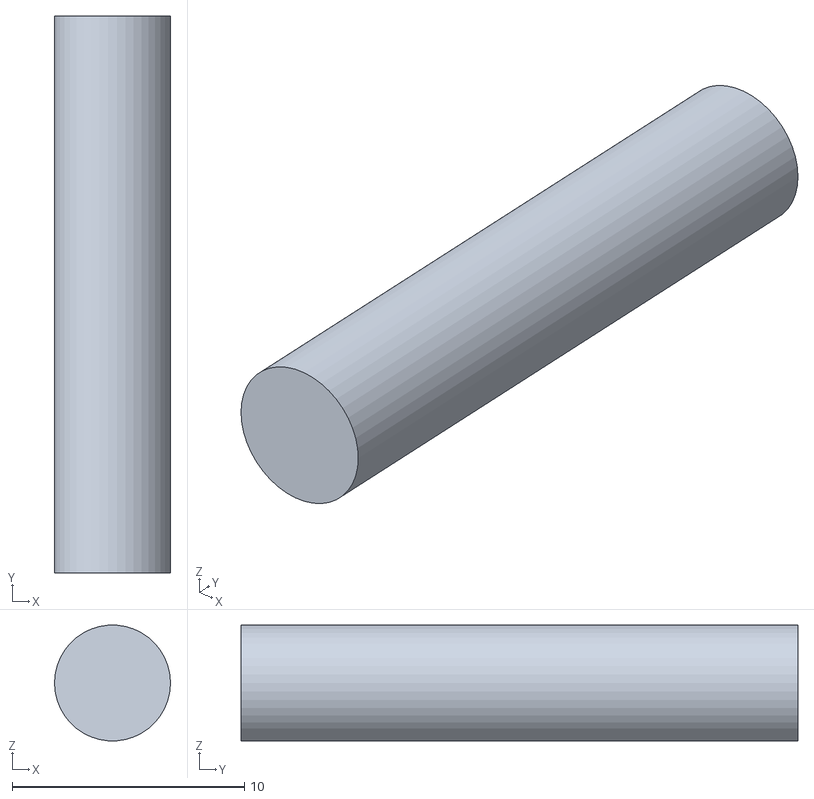
[picture p214: CAD file, 2026-09-30]
docs/mk3/models/m_tilt_motor_shaft.stl
5.00 x 24.0 x 4.99
