pranshukesavmishra/SIH-2026/docs/cad/web/head_box.stl

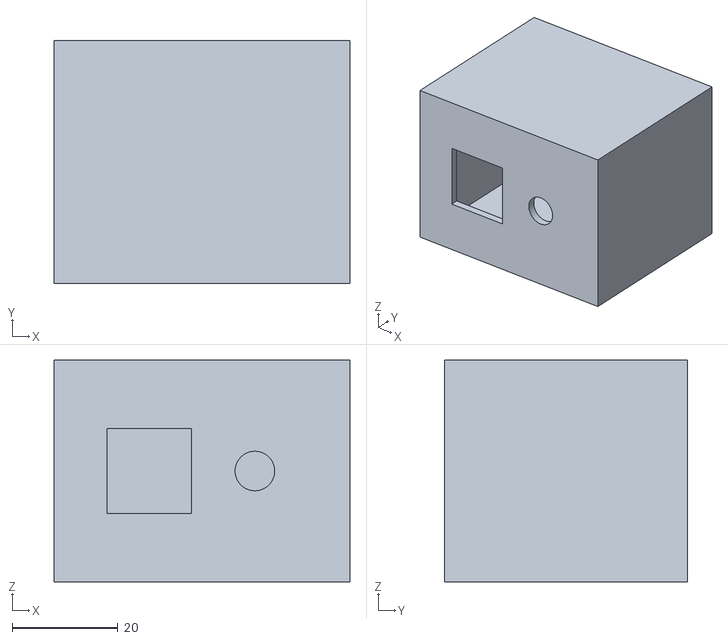
[picture p215: CAD file, 2026-09-26]
docs/cad/web/head_box.stl
56.0 x 46.0 x 42.0
