pranshukesavmishra/SIH-2026/tools/mk3/out/step/10_tilt_sensor_bracket.step

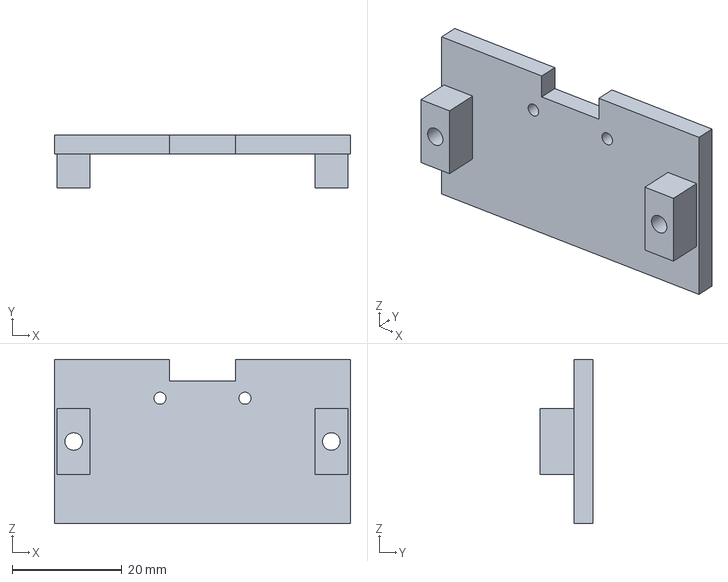
[picture p216: CAD file, 2026-09-30]
tools/mk3/out/step/10_tilt_sensor_bracket.step
54.0 x 9.70 x 30.0 mm
