pranshukesavmishra/SIH-2026/tools/mk3/tower/out/assembly/m_laser.stl

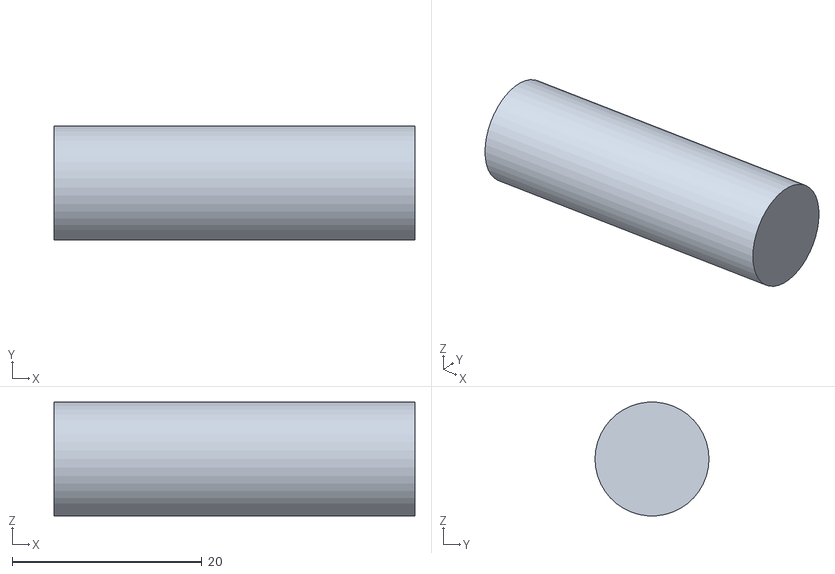
[picture p217: CAD file, 2026-10-03]
tools/mk3/tower/out/assembly/m_laser.stl
38.0 x 12.0 x 12.0
