pranshukesavmishra/SIH-2026/docs/cad/web/platform_glue.stl

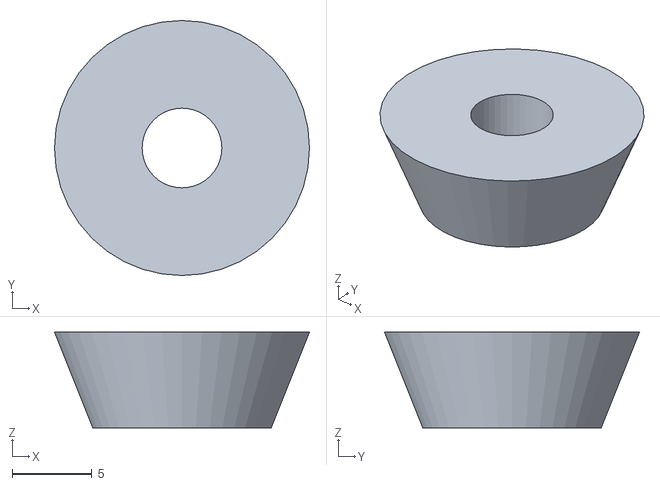
[picture p218: CAD file, 2026-09-26]
docs/cad/web/platform_glue.stl
16.0 x 16.0 x 6.00
