pranshukesavmishra/SIH-2026/tools/mk3/tower/out/assembly/m_pan_shaft.stl

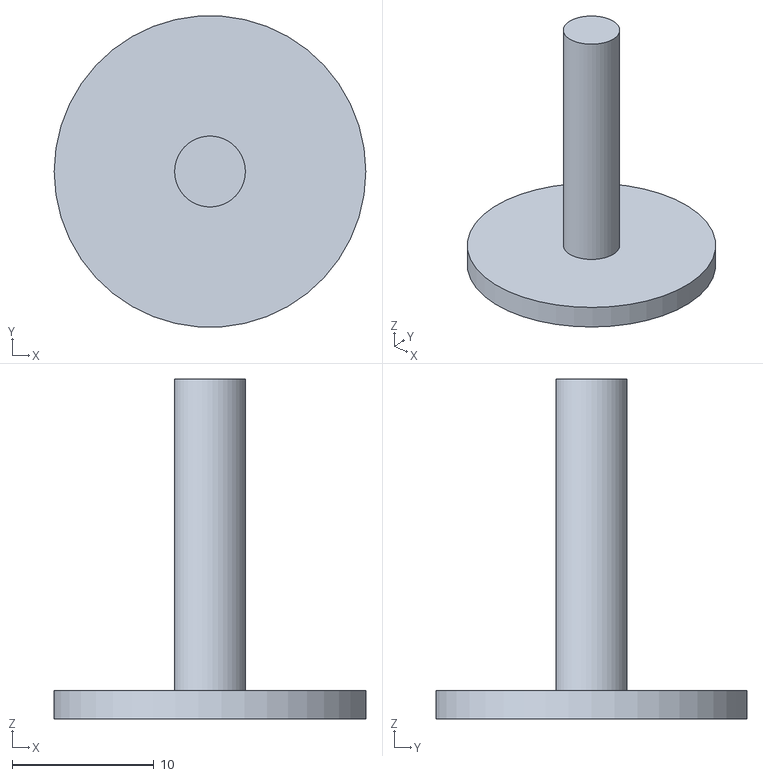
[picture p219: CAD file, 2026-10-03]
tools/mk3/tower/out/assembly/m_pan_shaft.stl
22.0 x 21.9 x 24.0
