pranshukesavmishra/SIH-2026/docs/mk3/models/01_base_hub.stl

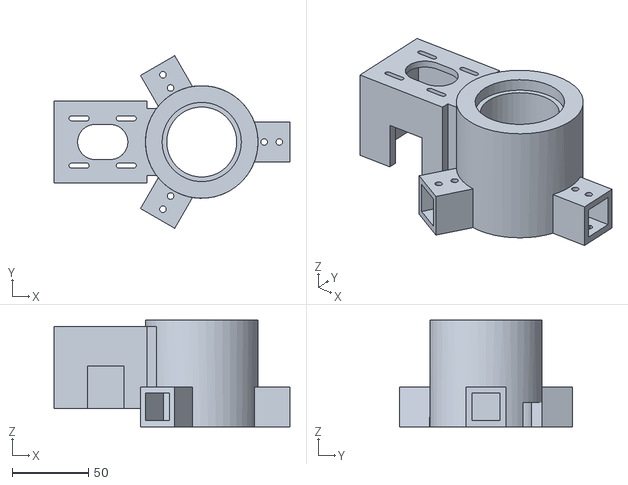
[picture p220: CAD file, 2026-09-30]
docs/mk3/models/01_base_hub.stl
155.1 x 113.5 x 70.0
