pranshukesavmishra/SIH-2026/docs/cad/web/stilts.stl

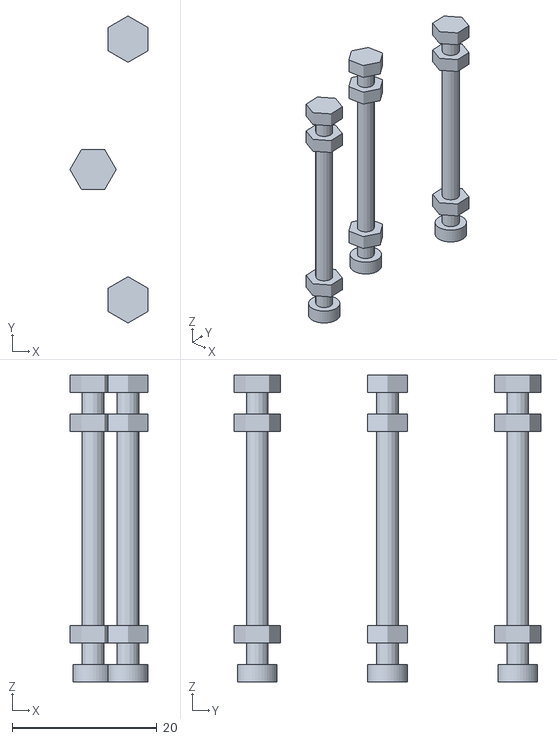
[picture p221: CAD file, 2026-09-26]
docs/cad/web/stilts.stl
10.8 x 42.4 x 42.4
