pranshukesavmishra/SIH-2026/docs/mk3/models/04_magnet_cap.stl

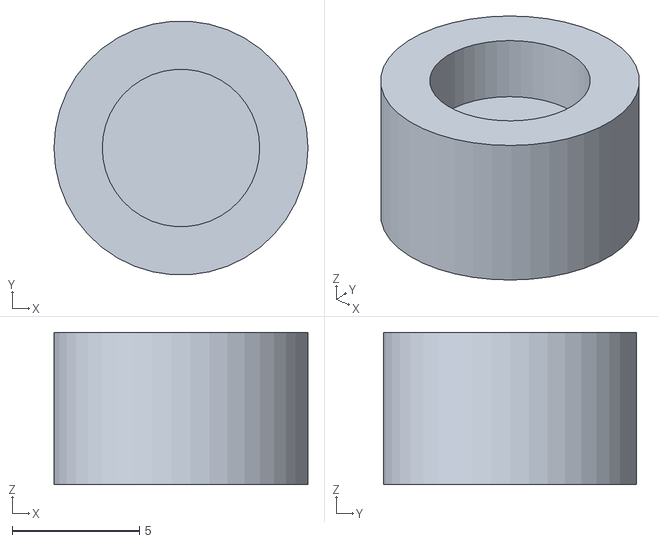
[picture p222: CAD file, 2026-09-30]
docs/mk3/models/04_magnet_cap.stl
10.00 x 9.97 x 6.00
