pranshukesavmishra/SIH-2026/tools/mk3/out/step/16_electronics_box.step

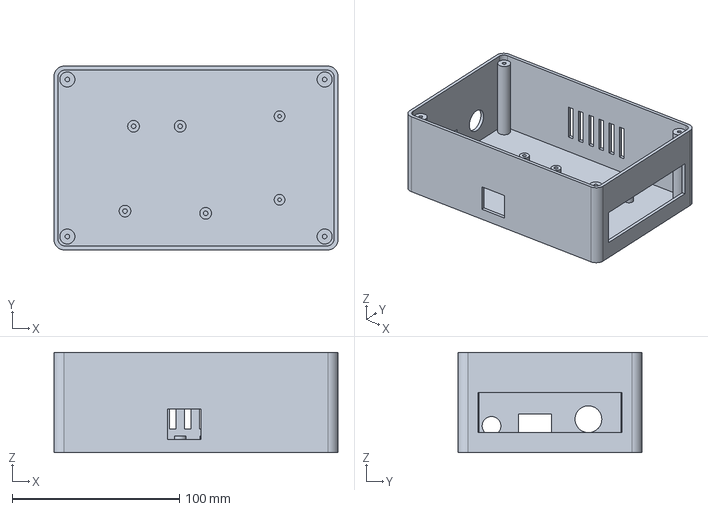
[picture p223: CAD file, 2026-09-30]
tools/mk3/out/step/16_electronics_box.step
170.0 x 110.0 x 60.0 mm
