pranshukesavmishra/SIH-2026/docs/cad/web/tilt_glue.stl

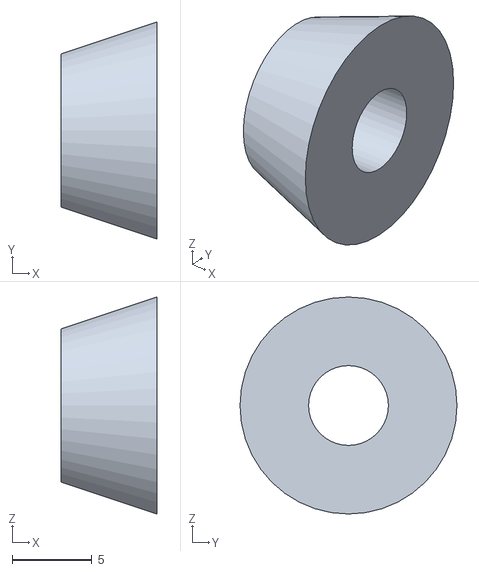
[picture p224: CAD file, 2026-09-26]
docs/cad/web/tilt_glue.stl
6.00 x 13.6 x 13.6
