pranshukesavmishra/SIH-2026/docs/cad/web/pan_magnet_n.stl

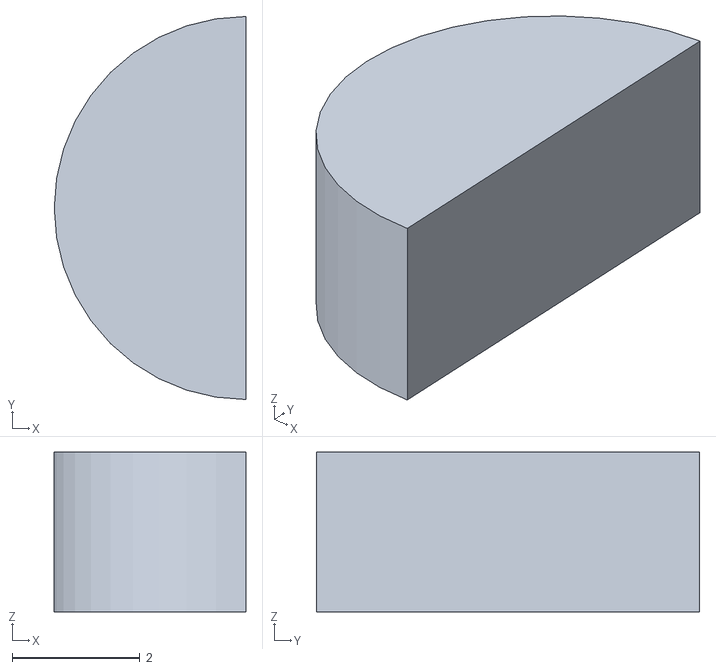
[picture p225: CAD file, 2026-09-26]
docs/cad/web/pan_magnet_n.stl
3.00 x 6.00 x 2.50
