pranshukesavmishra/SIH-2026/tools/mk3/out/step/12_front_plate.step

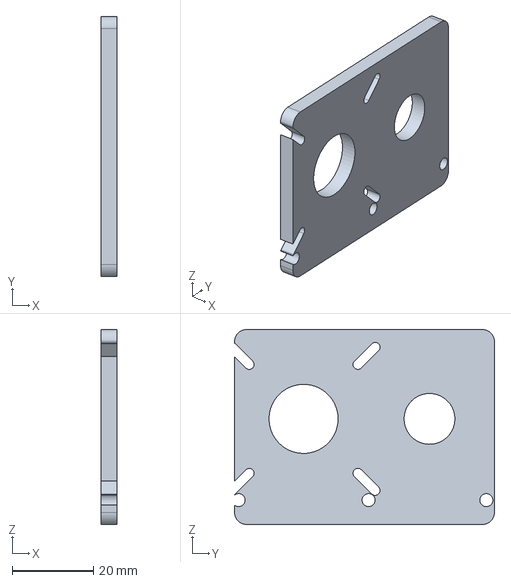
[picture p226: CAD file, 2026-09-30]
tools/mk3/out/step/12_front_plate.step
4.00 x 64.0 x 48.0 mm
