pranshukesavmishra/SIH-2026/docs/cad/web/platform.stl

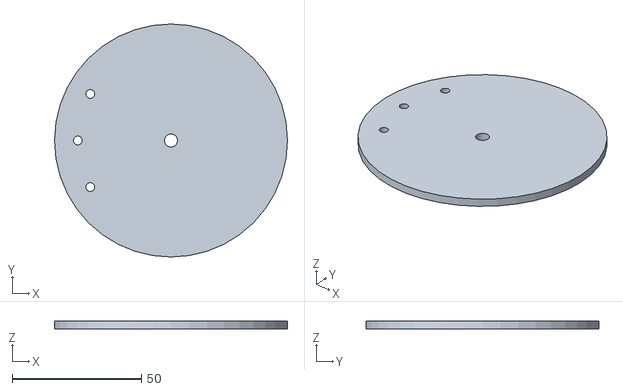
[picture p227: CAD file, 2026-09-26]
docs/cad/web/platform.stl
90.0 x 90.0 x 3.00
