pranshukesavmishra/SIH-2026/docs/mk3/models/m_brg_tilt_r.stl

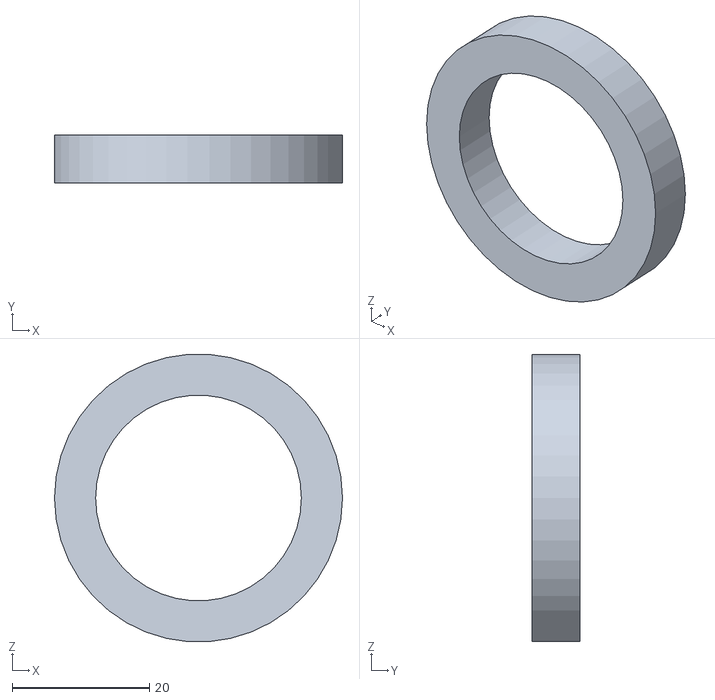
[picture p228: CAD file, 2026-09-30]
docs/mk3/models/m_brg_tilt_r.stl
42.0 x 7.00 x 41.9
