pranshukesavmishra/SIH-2026/docs/cad/web/tilt_disc.stl

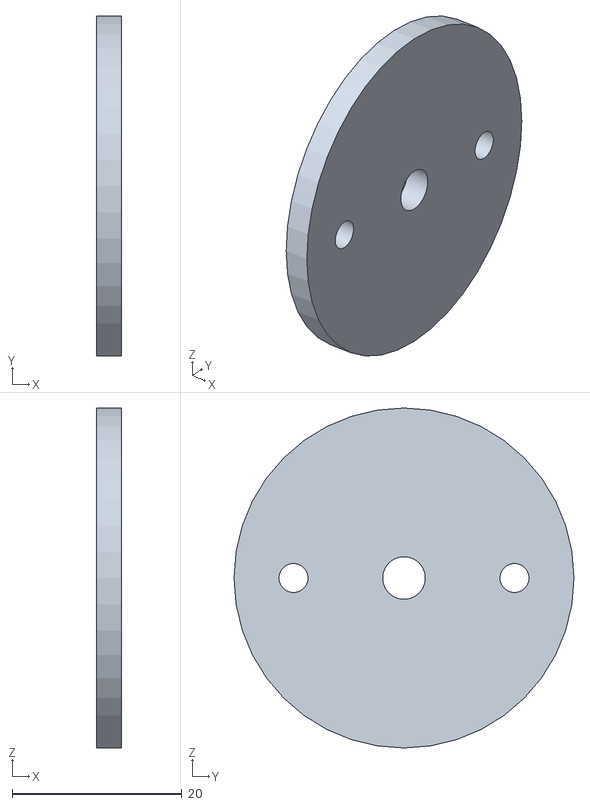
[picture p229: CAD file, 2026-09-26]
docs/cad/web/tilt_disc.stl
3.00 x 40.0 x 40.0
