pranshukesavmishra/SIH-2026/docs/mk3/models/17_electronics_lid.stl

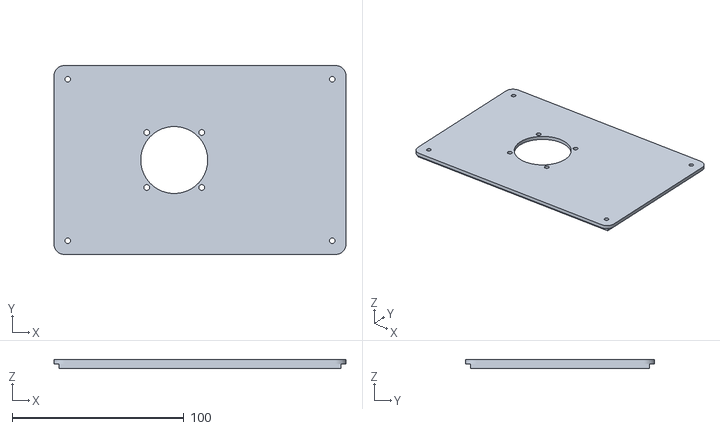
[picture p230: CAD file, 2026-09-30]
docs/mk3/models/17_electronics_lid.stl
170.0 x 110.0 x 5.00
