pranshukesavmishra/SIH-2026/docs/mk3/models/m_tilt_pulley20.stl

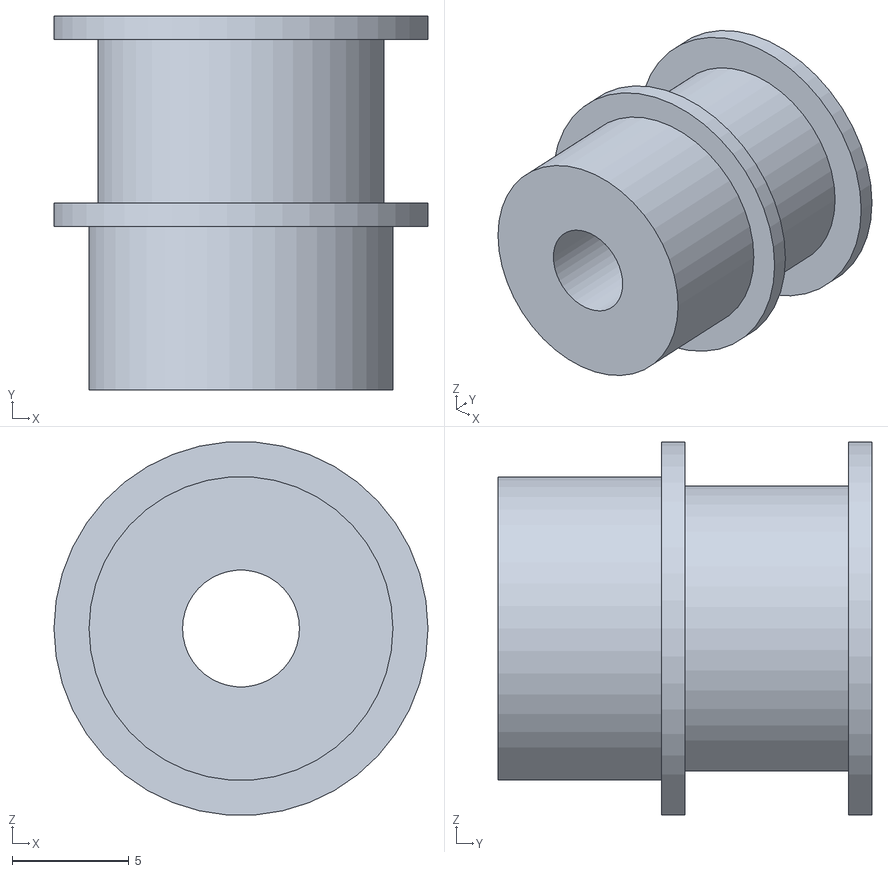
[picture p231: CAD file, 2026-09-30]
docs/mk3/models/m_tilt_pulley20.stl
16.0 x 16.0 x 16.0
