pranshukesavmishra/SIH-2026/docs/cad/web/pan_post.stl

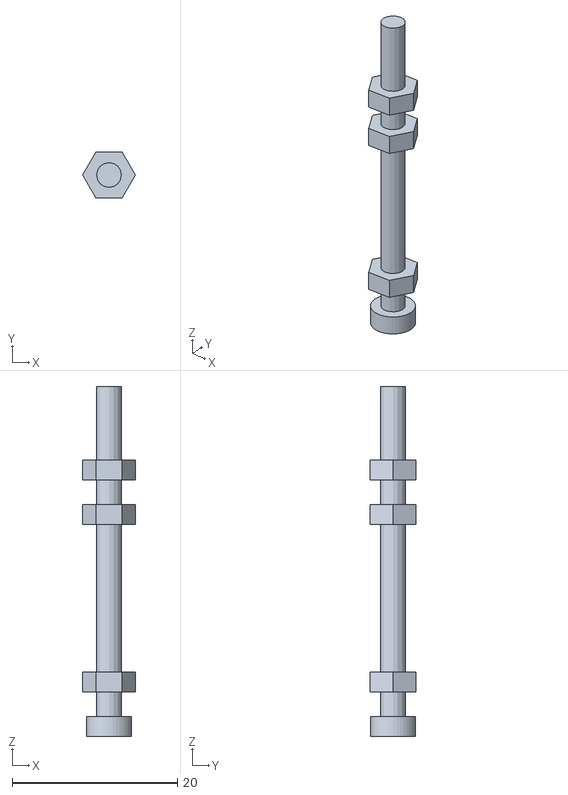
[picture p232: CAD file, 2026-09-26]
docs/cad/web/pan_post.stl
6.40 x 5.54 x 42.4
