pranshukesavmishra/SIH-2026/tools/mk3/out/step/03_pan_sensor_bridge.step

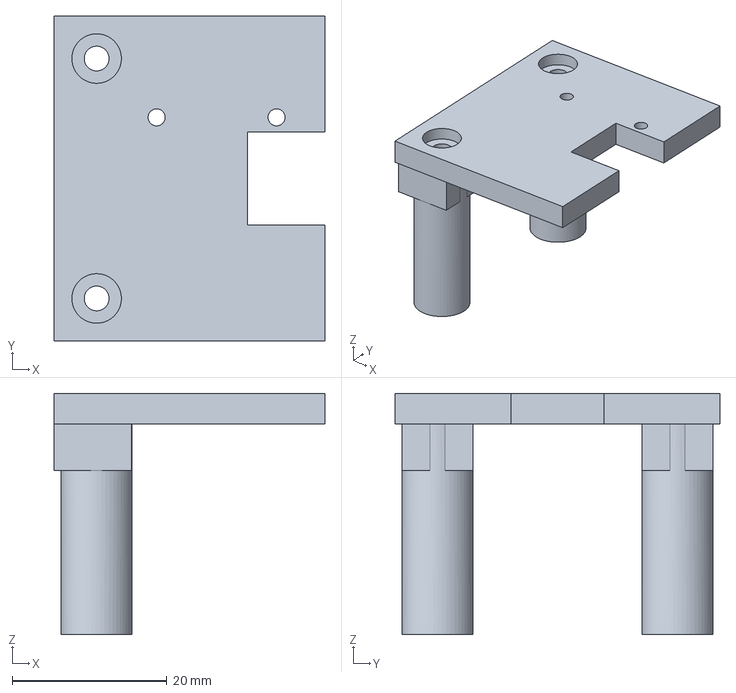
[picture p233: CAD file, 2026-09-30]
tools/mk3/out/step/03_pan_sensor_bridge.step
35.0 x 42.0 x 31.2 mm
