pranshukesavmishra/SIH-2026/docs/cad/web/bracket.stl

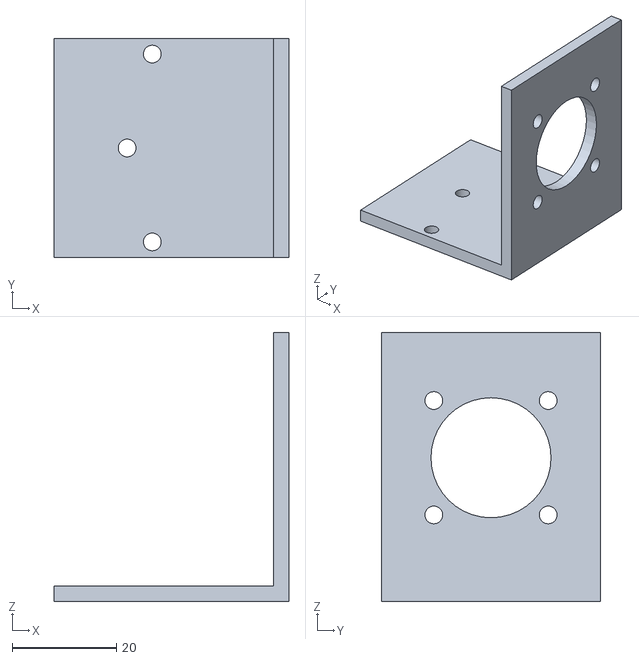
[picture p234: CAD file, 2026-09-26]
docs/cad/web/bracket.stl
45.0 x 42.0 x 51.5
