pranshukesavmishra/SIH-2026/docs/cad/web/decoy_case.stl

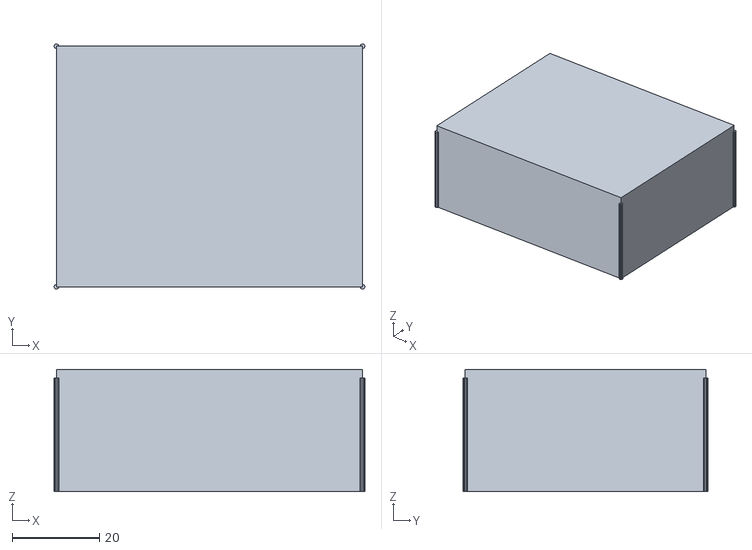
[picture p235: CAD file, 2026-09-24]
docs/cad/web/decoy_case.stl
71.1 x 56.0 x 28.0
