pranshukesavmishra/SIH-2026/docs/cad/web/decoy_switch.stl

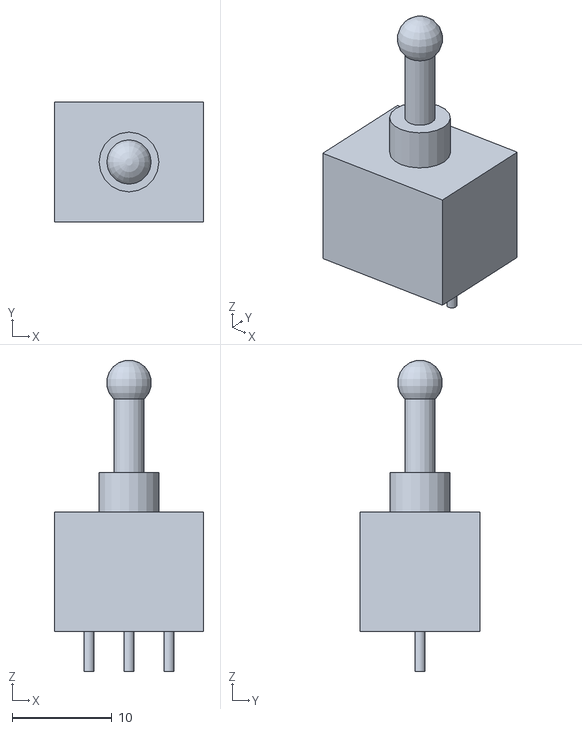
[picture p236: CAD file, 2026-09-24]
docs/cad/web/decoy_switch.stl
15.0 x 12.0 x 31.2
