pranshukesavmishra/SIH-2026/docs/cad/web/beacon_led.stl

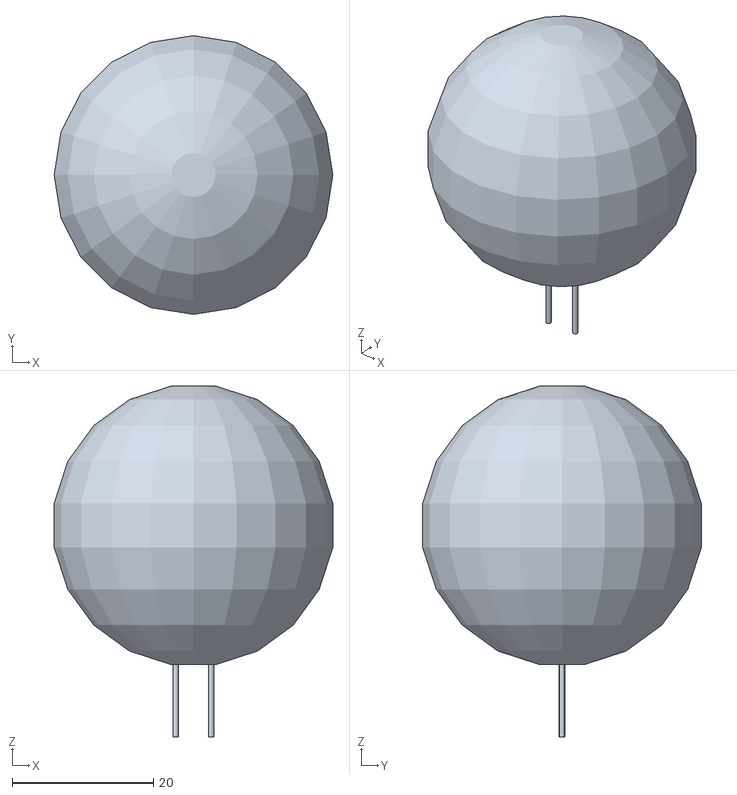
[picture p237: CAD file, 2026-09-24]
docs/cad/web/beacon_led.stl
39.5 x 39.5 x 49.8
