pranshukesavmishra/SIH-2026/docs/mk3/models/m_brg_pan_top.stl

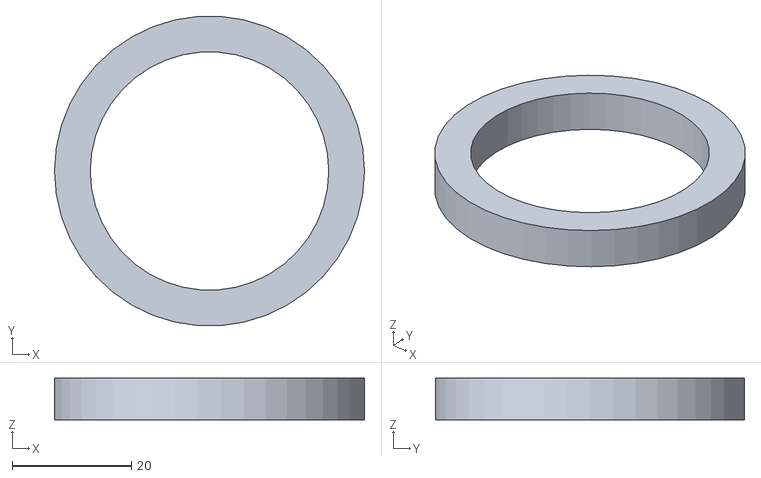
[picture p238: CAD file, 2026-09-30]
docs/mk3/models/m_brg_pan_top.stl
52.0 x 51.9 x 7.00
