pranshukesavmishra/SIH-2026/docs/cad/web/decoy_cells.stl

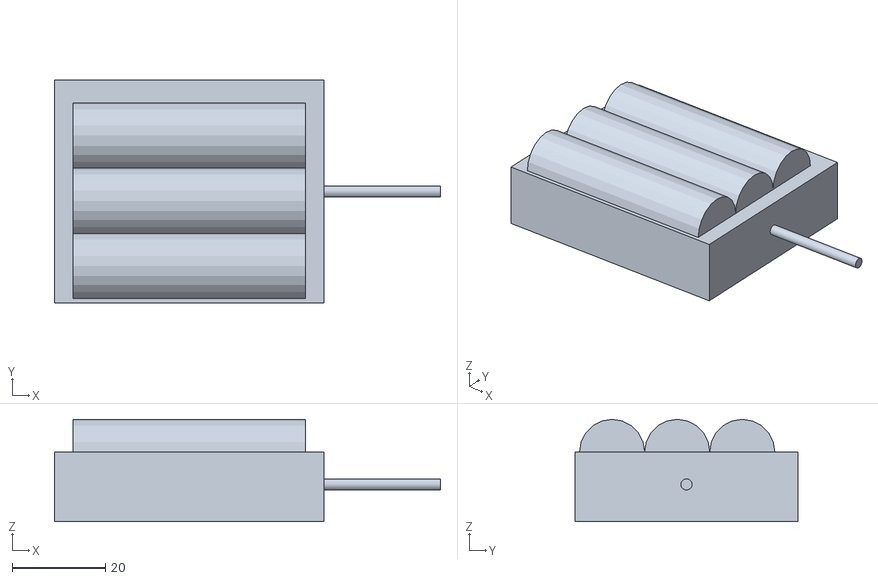
[picture p239: CAD file, 2026-09-24]
docs/cad/web/decoy_cells.stl
83.0 x 48.0 x 22.0
