pranshukesavmishra/SIH-2026/docs/cad/web/beacon_case.stl

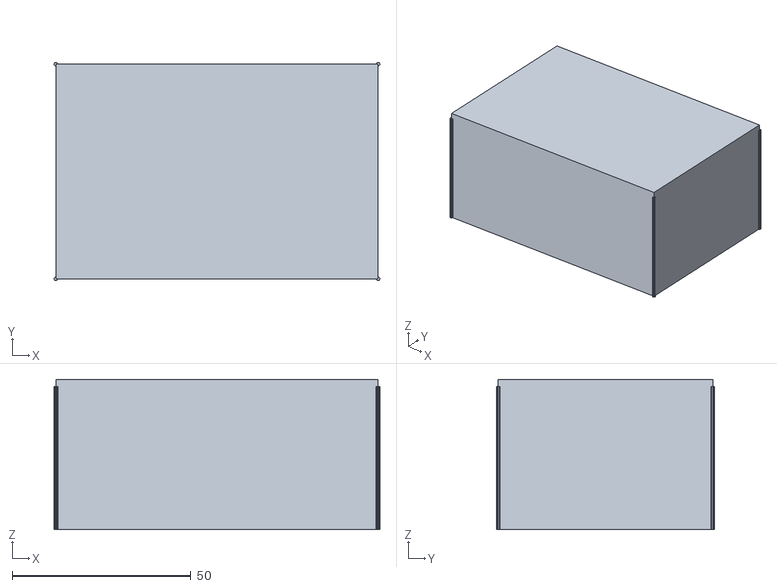
[picture p240: CAD file, 2026-09-24]
docs/cad/web/beacon_case.stl
91.1 x 61.0 x 42.0
