pranshukesavmishra/SIH-2026/docs/cad/web/beacon_nano.stl

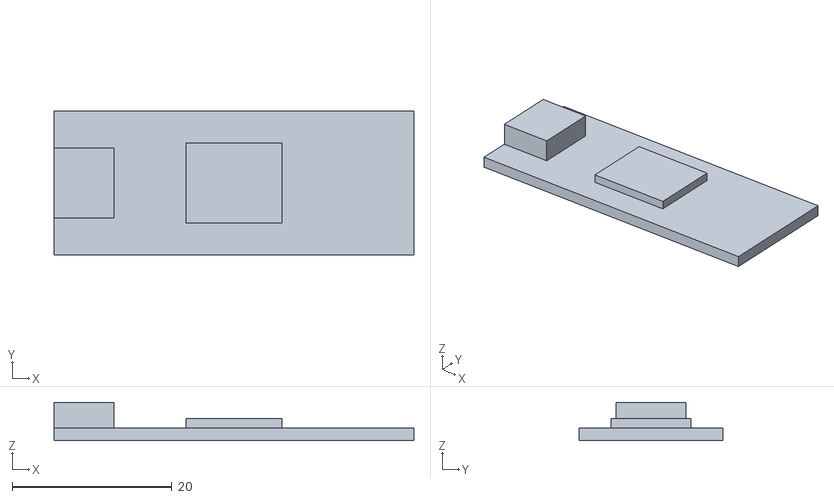
[picture p241: CAD file, 2026-09-24]
docs/cad/web/beacon_nano.stl
45.0 x 18.0 x 4.80
