pranshukesavmishra/SIH-2026/docs/cad/web/decoy_led.stl

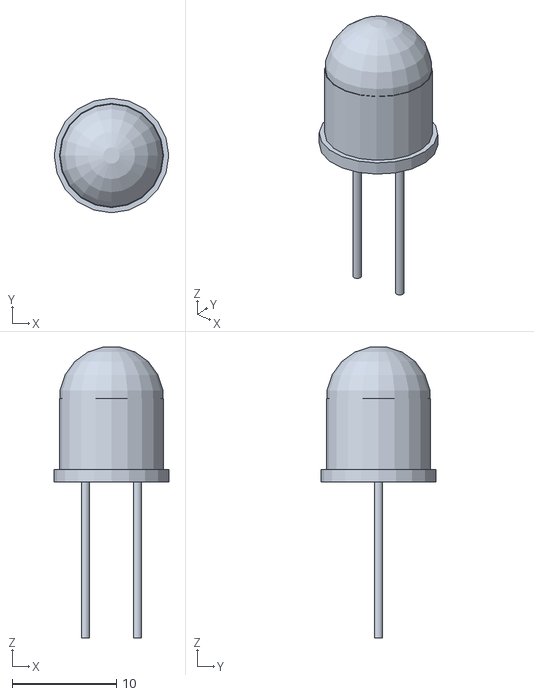
[picture p242: CAD file, 2026-09-24]
docs/cad/web/decoy_led.stl
11.0 x 11.0 x 27.9
