pranshukesavmishra/SIH-2026/docs/mk3/models/m_laser.stl

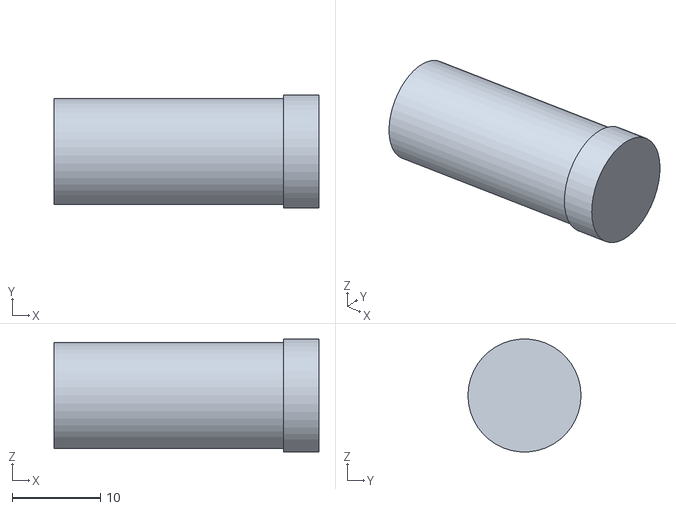
[picture p243: CAD file, 2026-09-30]
docs/mk3/models/m_laser.stl
30.0 x 12.8 x 12.8
