pranshukesavmishra/SIH-2026/docs/mk3/models/m_camera.stl

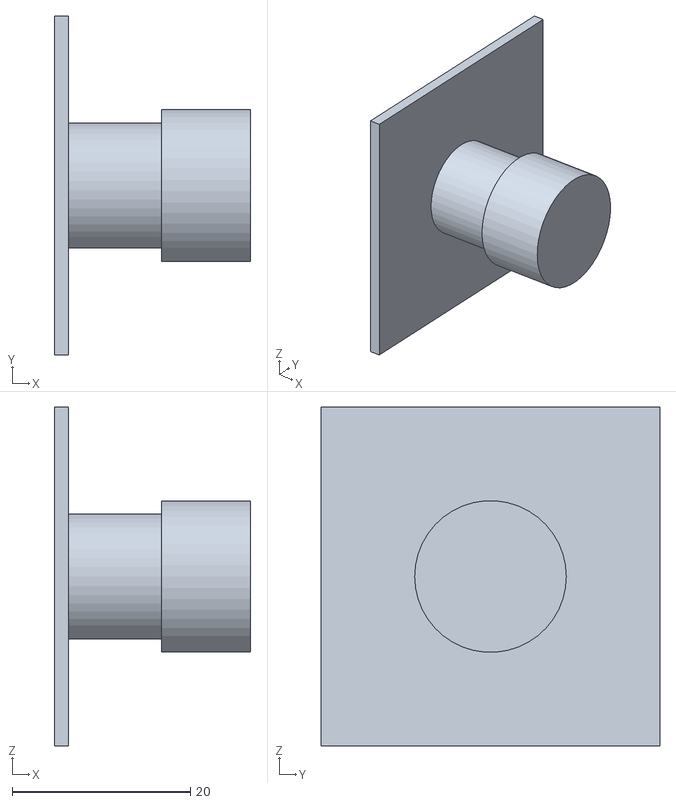
[picture p244: CAD file, 2026-09-30]
docs/mk3/models/m_camera.stl
22.0 x 38.0 x 38.0
