pranshukesavmishra/SIH-2026/(list of files, cad)

Other CAD files:
tools/mk3/tower/out/step/05_tilt_mount.step
tools/mk3/tower/out/step/04_pan_hub.step
docs/mk3/models/08_arm_left.stl
tools/mk3/tower/out/assembly/01_tripod_base.stl
tools/mk3/tower/out/step/06_head.step
docs/mk3/models/02_leg_3.stl
docs/mk3/models/07_arm_right.stl
tools/mk3/tower/out/assembly/02_tower_sleeve.stl
tools/mk3/out/step/08_arm_left.step
tools/mk3/tower/out/assembly/m_tilt_motor.stl
docs/mk3/models/09_tilt_motor_plate.stl
docs/mk3/models/10_tilt_sensor_bracket.stl
tools/mk3/out/step/13_laser_holder.step
docs/cad/web/pan_motor.stl
tools/mk3/out/step/01_base_hub.step
tools/mk3/tower/out/assembly/m_tilt_shaft.stl
tools/mk3/tower/out/assembly/03_tower_cap.stl
docs/mk3/models/m_pan_as5600.stl
docs/mk3/models/m_pan_motor.stl
tools/mk3/out/step/15_trunnion_right.step
docs/cad/web/pan_magnet_s.stl
docs/mk3/models/m_tilt_motor.stl
tools/mk3/out/step/02_leg_2.step
tools/mk3/out/step/17_electronics_lid.step
tools/mk3/out/step/04_magnet_cap.step
docs/mk3/models/06_pan_turntable.stl
docs/mk3/models/m_pan_motor_shaft.stl
docs/mk3/models/12_front_plate.stl
docs/mk3/models/m_pan_pulley20.stl
docs/mk3/models/14_trunnion_left.stl
docs/cad/web/beacon_switch.stl
docs/mk3/models/m_brg_pan_low.stl
docs/mk3/models/16_electronics_box.stl
docs/mk3/models/00_test_coupon.stl
docs/mk3/models/11_head.stl
docs/mk3/models/m_brg_tilt_l.stl
docs/mk3/models/02_leg_1.stl
docs/mk3/models/03_pan_sensor_bridge.stl
docs/mk3/models/02_leg_2.stl
docs/cad/geometry_legacy.scad
docs/cad/web/pan_motor_screws.stl
docs/cad/web/tilt_motor_screws.stl
docs/mk3/models/05_spindle_washer.stl
docs/mk3/print/00_test_coupon.stl
docs/mk3/print/01_base_hub.stl
docs/mk3/print/02_leg_1.stl
docs/mk3/print/02_leg_2.stl
docs/mk3/print/02_leg_3.stl
docs/mk3/print/03_pan_sensor_bridge.stl
docs/mk3/print/04_magnet_cap.stl
docs/mk3/print/05_spindle_washer.stl
docs/mk3/print/06_pan_turntable.stl
docs/mk3/print/07_arm_right.stl
docs/mk3/print/08_arm_left.stl
docs/mk3/print/09_tilt_motor_plate.stl
docs/mk3/print/10_tilt_sensor_bracket.stl
docs/mk3/print/11_head.stl
docs/mk3/print/12_front_plate.stl
docs/mk3/print/13_laser_holder.stl
docs/mk3/print/14_trunnion_left.stl
docs/mk3/print/15_trunnion_right.stl
docs/mk3/print/16_electronics_box.stl
docs/mk3/print/17_electronics_lid.stl
tools/mk3/out/print/00_test_coupon.stl
tools/mk3/out/print/01_base_hub.stl
tools/mk3/out/print/02_leg_1.stl
tools/mk3/out/print/02_leg_2.stl
tools/mk3/out/print/02_leg_3.stl
tools/mk3/out/print/03_pan_sensor_bridge.stl
tools/mk3/out/print/04_magnet_cap.stl
tools/mk3/out/print/05_spindle_washer.stl
tools/mk3/out/print/06_pan_turntable.stl
tools/mk3/out/print/07_arm_right.stl
tools/mk3/out/print/08_arm_left.stl
tools/mk3/out/print/09_tilt_motor_plate.stl
tools/mk3/out/print/10_tilt_sensor_bracket.stl
tools/mk3/out/print/11_head.stl
tools/mk3/out/print/12_front_plate.stl
tools/mk3/out/print/13_laser_holder.stl
tools/mk3/out/print/14_trunnion_left.stl
tools/mk3/out/print/15_trunnion_right.stl
tools/mk3/out/print/16_electronics_box.stl
tools/mk3/out/print/17_electronics_lid.stl
tools/mk3/out/step/05_spindle_washer.step
tools/mk3/tower/out/print/00_test_coupon.stl
tools/mk3/tower/out/print/01_tripod_base.stl
tools/mk3/tower/out/print/02_tower_sleeve.stl
tools/mk3/tower/out/print/03_tower_cap.stl
tools/mk3/tower/out/print/04_pan_hub.stl
tools/mk3/tower/out/print/05_tilt_mount.stl
tools/mk3/tower/out/print/06_head.stl
