pranshukesavmishra/SIH-2026/docs/mk3/Plan_Urena_print_shop.pdf

## FOR THE PRINT SHOP

3D printing job: 20 files,

# ≈1,074 g PETG

Hello! These are parts for a student robotics project (Team ZeroDrift, Jabalpur Engineering College). Please print the test coupon first; we will check it and confirm before you print the rest.

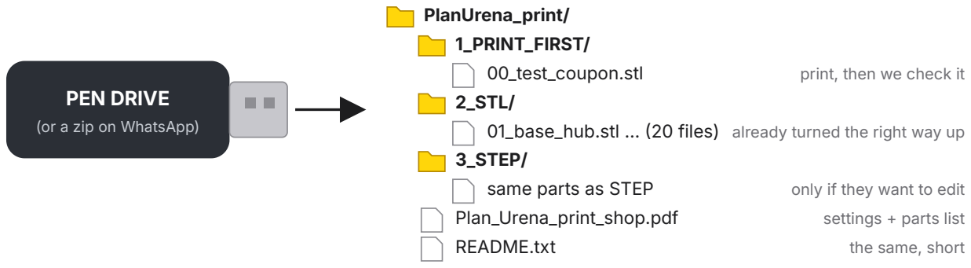
[picture p245: figure]
PEN DRIVE; (or a zip on WhatsApp); PlanUrena_print/ 1_PRINT_FIRST/; 00_test_coupon.stl; print, then we check it; 2_STL/; 3_STEP/; Plan_Urena_print_shop.pdf; settings + parts list; README.txt; the same, short

01_base_hub.stl … (20 files) already turned the right way up

same parts as STEP | only if they want to edit

## Settings for every part

Material | PETG. Black for: head, front plate, laser holder. Any colour for the rest (grey preferred).
Layers / nozzle | 0.2 mm layers, 0.4 mm nozzle
Walls / top / bottom | 4 walls, 5 top, 5 bottom
Infill | 40 % gyroid
Supports | None, except inside the motor pocket of 01_base_hub
Orientation | Keep as in the files. Every part is already placed flat on the bed.
Scale | 100 %. Please do not rescale: the bearing holes are exact.

Fit check. The test coupon has two bearing holes (52 and 42 mm) and two rings (40 and 30 mm). If your printer runs a little big or small, tell us the measured sizes. We can adjust the files, or you can set horizontal expansion.

Plan Urena · print shop · internal | 1 / 3

## The parts

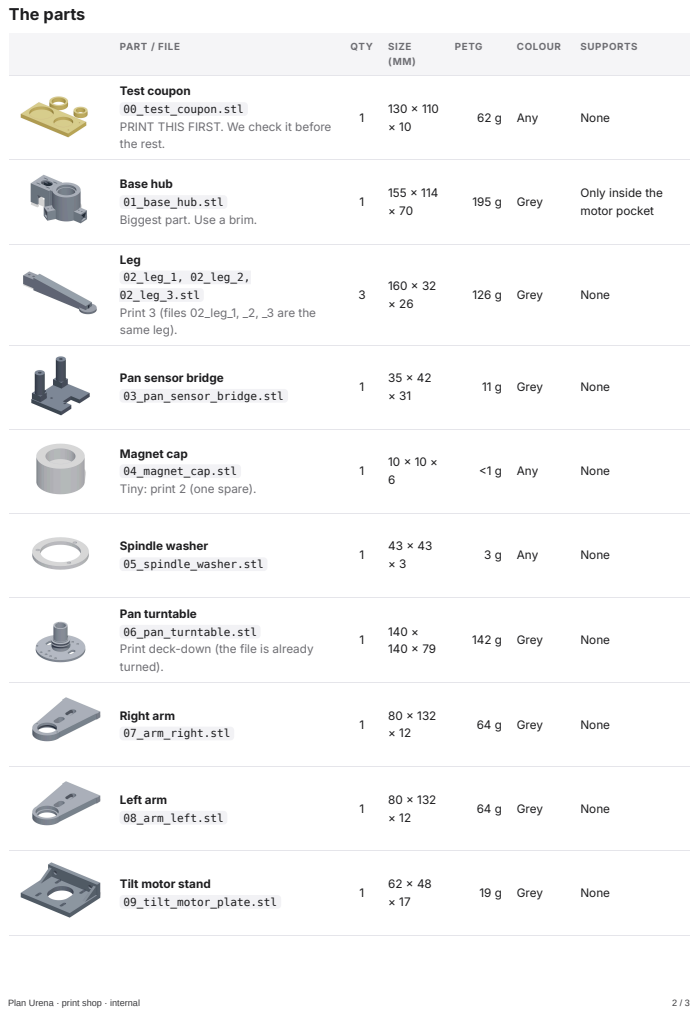
[picture p246: page 2]
PART / FILE; QTY; SIZE; PETG; COLOUR; SUPPORTS; 62 g Any; None; 195 g Grey; 126 g Grey; 11 g Grey; <1 g Any; Spindle washer 05_spindle_washer.stl; 3 g Any; 142 g Grey; Right arm 07_arm_right.stl; 64 g Grey; Left arm 08_arm_left.stl; 19 g Grey

Test coupon
00_test_coupon.stl
PRINT THIS FIRST. We check it before
the rest.

Base hub
01_base_hub.stl
Biggest part. Use a brim.

Only inside the
motor pocket

Leg
02_leg_1, 02_leg_2,
02_leg_3.stl
Print 3 (files 02_leg_1, _2, _3 are the
same leg).

Pan sensor bridge
03_pan_sensor_bridge.stl

Magnet cap
04_magnet_cap.stl
Tiny: print 2 (one spare).

Pan turntable
06_pan_turntable.stl
Print deck-down (the file is already
turned).

Tilt motor stand
09_tilt_motor_plate.stl

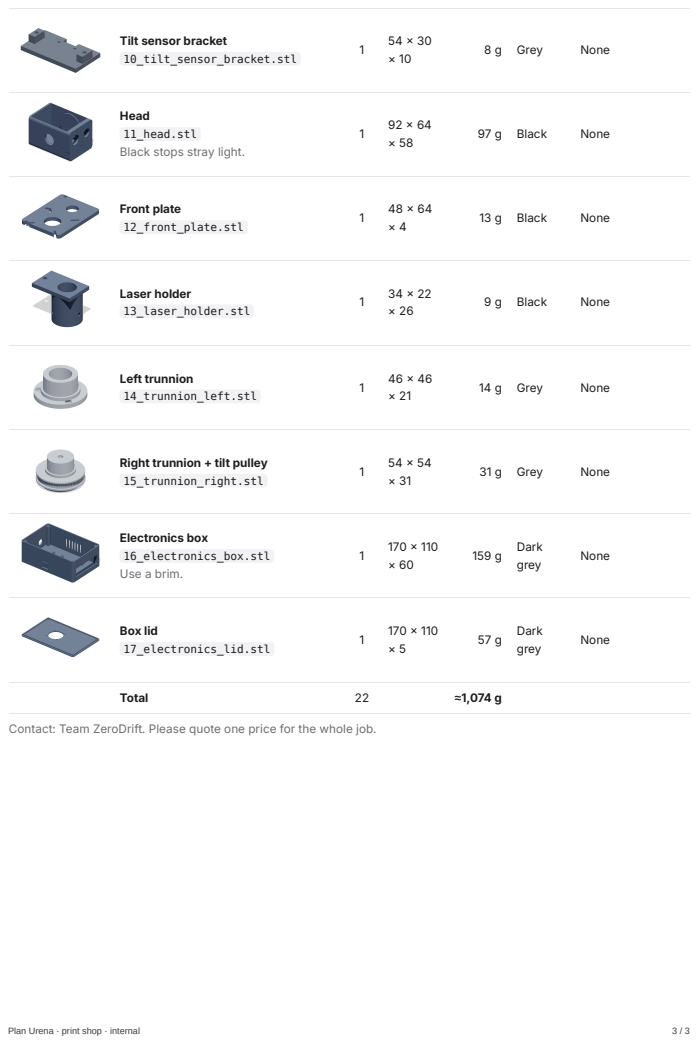
[picture p247: page 3]
8 g Grey; None; 97 g Black; Front plate 12_front_plate.stl; 13 g Black; Laser holder 13_laser_holder.stl; 9 g Black; Left trunnion 14_trunnion_left.stl; 14 g Grey; 31 g Grey; Electronics box 16_electronics_box.stl Use a brim.; 159 g Dark grey; Box lid 17_electronics_lid.stl; Dark grey; Total

Tilt sensor bracket
10_tilt_sensor_bracket.stl

Head
11_head.stl
Black stops stray light.

Right trunnion + tilt pulley
15_trunnion_right.stl

Contact: Team ZeroDrift. Please quote one price for the whole job.
