pranshukesavmishra/SIH-2026/tools/rig/ZeroDrift_MK2_Wiring_3in1.pdf

# ZeroDrift MK2 · full breadboard wiring (830-point board)

56 numbered wires · every hole named (column 1–63, row a–j) · pins match rig_firmware_v2.ino · wire with EVERYTHING unplugged

## pan D2/D3 · tilt D4/D5 · laser D7 · vibration D8 I²C: A4 = SDA · A5 = SCL · multiplexer 0x70

+ | +
− | −
− | −
+ | +

### 12 V

GND

GND

### 5 V

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
## LASER KY-008

on the tilt head

S | mid | -
| no wire

## PAN MOTOR

NEMA17 · bottom

## TILT MOTOR

NEMA17 · in the head

KILL
SWITCH

## TOGGLE SWITCH

OUT MID spare

DC JACK

## DC JACK

3 legs: + pin · − sleeve · empty

+ | - | x

### 12 V · 2 A

adapter

plug into the wall LAST

## MULTIPLEXER TCA9548A

stays OFF the breadboard · male-female jumpers

VIN | GND | SDA | SCL | RST | A0 | A1 | A2
SD0 | SC0 no wire
channel 0 → AS5600

## AS5600 ANGLE SENSOR

on the rig, under the pan shaft magnet

SDA | SCL | VCC | GND | DIR

## VIBRATION MOTOR

small 3-5 V coin / pager motor · on the rig base

M

red + | blue −

## LAPTOP

Chrome · live page

D12 | D11 | D10 | D9 | D8 | D7 | D6 | D5 | D4 | D3 | D2 | GND | RST | RX0 | TX1
D13 | 3V3 | REF | A0 | A1 | A2 | A3 | A4 | A5 | A6 | A7 | 5V | RST | GND | VIN

## ARDUINO NANO

USB-C

VMOT | GND | 2B | 2A | 1A | 1B | VDD | GND
EN | MS1 | MS2 | MS3 | RST | SLP | STEP | DIR

PAN DRIVER A4988

VMOT | GND | 2B | 2A | 1A | 1B | VDD | GND
EN | MS1 | MS2 | MS3 | RST | SLP | STEP | DIR

TILT DRIVER A4988

−

C1 100 µF

+ | − C2 100 µF

+

Q1

R1 1 kΩ
D1 1N4148

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
12 | 13 | 14

15

16
17

18

19

20
21 | 22 | 23

24

25
26

27

28

29 | 30 | 31 | 32 | 33 | 34 | 35 | 36

37

38

39 40

41 | 42 | 43

44 45

46

47 48

49

50

51

52

53

55 54

56

Tick every wire go in order: power → drivers → STEP/DIR → motors → sensor → laser → vibration → USB

### 1 DC jack + screw → switch MIDDLE pin

### 2 switch outer pin → TOP red rail (+12 V) [col 53]

### 3 DC jack − screw → TOP blue rail (GND) [col 61]

### 4 Nano 5V [j15] → BOTTOM red rail (+5 V) [col 15]

### 5 Nano GND [j17] → BOTTOM blue rail (GND) [col 17]

### 6 TOP blue rail [col 59] → BOTTOM blue rail (joins the grounds) [col 59]

### 7 pan VMOT [a27] → TOP red rail (+12 V) [col 27]

### 8 pan GND (next to VMOT) [a28] → TOP blue rail (GND) [col 28]

### 9 pan VDD [c33] → BOTTOM red rail (+5 V) · NEVER 12 V [col 35]

### 10 pan GND (next to VDD) [a34] → TOP blue rail (GND) [col 34]

### 11 pan EN [j27] → BOTTOM blue rail (GND) [col 27]

### 12 pan MS1 [j28] → BOTTOM red rail (+5 V) [col 28]

### 13 pan MS2 [j29] → BOTTOM red rail (+5 V) [col 29]

### 14 pan MS3 [j30] → BOTTOM red rail (+5 V) [col 30]

### 15 pan RST [j31] → pan SLP (short jumper) [j32]

### 16 tilt VMOT [a39] → TOP red rail (+12 V) [col 39]

### 17 tilt GND (next to VMOT) [a40] → TOP blue rail (GND) [col 40]

### 18 tilt VDD [c45] → BOTTOM red rail (+5 V) · NEVER 12 V [col 47]

### 19 tilt GND (next to VDD) [a46] → TOP blue rail (GND) [col 46]

### 20 tilt EN [j39] → BOTTOM blue rail (GND) [col 39]

### 21 tilt MS1 [j40] → BOTTOM red rail (+5 V) [col 40]

### 22 tilt MS2 [j41] → BOTTOM red rail (+5 V) [col 41]

### 23 tilt MS3 [j42] → BOTTOM red rail (+5 V) [col 42]

### 24 tilt RST [j43] → tilt SLP (short jumper) [j44]

### 25 Nano D2 [a14] → pan STEP [i33]

### 26 Nano D3 [a13] → pan DIR [h34]

### 27 Nano D4 [b12] → tilt STEP [h45]

### 28 Nano D5 [c11] → tilt DIR [i46]

### 29 pan motor black → pan 2B [b29]

### 30 pan motor green → pan 2A [b30]

### 31 pan motor red → pan 1A [b31]

### 32 pan motor blue → pan 1B [b32]

### 33 tilt motor black → tilt 2B [b41]

### 34 tilt motor green → tilt 2A [b42]

### 35 tilt motor red → tilt 1A [b43]

### 36 tilt motor blue → tilt 1B [b44]

### 37 multiplexer VIN → BOTTOM red rail (+5 V) [col 9]

### 38 multiplexer GND → BOTTOM blue rail (GND) [col 10]

### 39 multiplexer SDA → Nano A4 [j11]

### 40 multiplexer SCL → Nano A5 [j12]

### 41 multiplexer A0 → BOTTOM blue rail (GND) [col 13]

### 42 multiplexer A1 → BOTTOM blue rail (GND) [col 16]

### 43 multiplexer A2 → BOTTOM blue rail (GND) [col 18]

### 44 multiplexer SD0 → AS5600 SDA

### 45 multiplexer SC0 → AS5600 SCL

### 46 AS5600 VCC → BOTTOM red rail (+5 V) [col 51]

### 47 AS5600 GND → BOTTOM blue rail (GND) [col 52]

### 48 AS5600 DIR (if your board has it) → BOTTOM blue rail (GND) [col 53]

### 49 laser S → Nano D7 [a9]

### 50 laser − → TOP blue rail (GND) [col 7]

### 51 Nano D8 [c8] → hole b20 (top of resistor R1) [b20]

### 52 transistor E (emitter) [g19] → BOTTOM blue rail (GND) [col 19]

### 53 diode stripe + motor red strip [j24] → BOTTOM red rail (+5 V) [col 24]

### 54 vibration motor red (+) → hole g24 (+5 V strip) [g24]

### 55 vibration motor blue / black (−) → hole g21 (transistor C) [g21]

### 56 Nano USB-C → laptop (through the hub)

## Also on the board

C1 | 100 µF at col 25: long leg T+ (red), stripe T− (blue)
C2 | 100 µF at col 37: same way round

J pan: short jumper j31 ↔ j32 (RST–SLP)

J tilt: short jumper j43 ↔ j44

R1 | 1 kΩ, e20 ↔ f20 across the gap (brown-black-red)
Q1 | 2N2222 legs in j19 j20 j21, flat face toward you (E B C)
D1 | 1N4148, f21 ↔ f24, black stripe at f24

V Vref 0.55 V on both drivers (12 V OFF)

Rails: follow the RED / BLUE line printed

next to each rail row on YOUR board.

Beep-test: TOP red ↔ BOTTOM red = SILENT.

12 V must never reach 5 V, the Nano or VDD.

Power ON: USB, then 12 V switch.

Power OFF: 12 V switch, then USB.

# ZeroDrift MK2 · vibration motor

the “platform shake” demo: serial V1 = shake ON · V0 = OFF · Arduino pin D8 drives it through a transistor, never straight from the pin

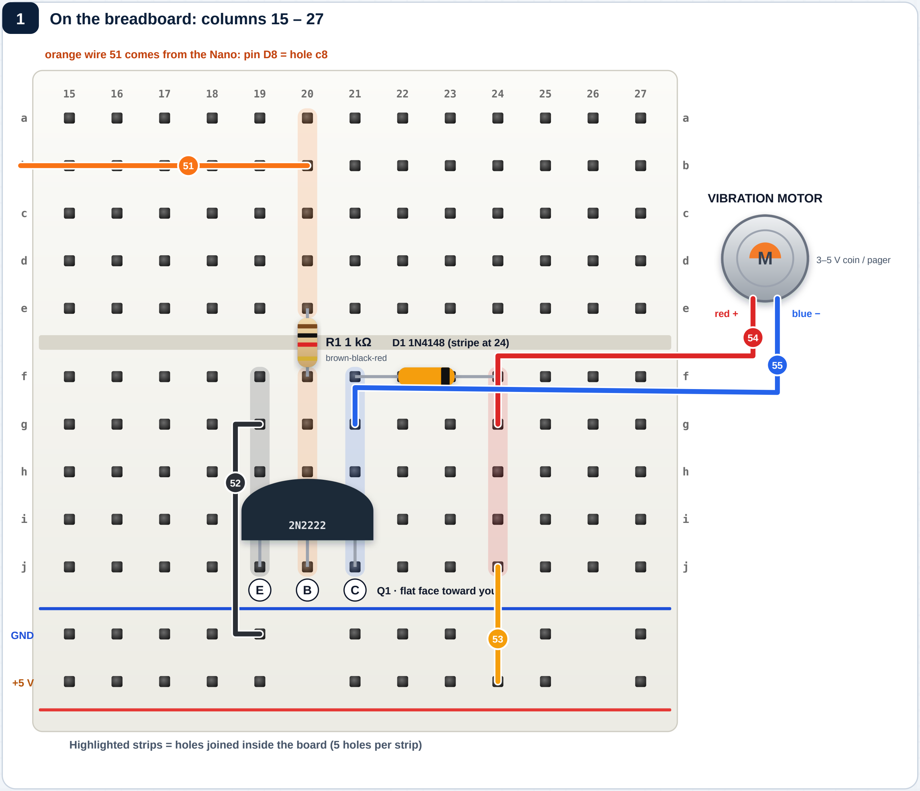
[picture p248: figure]
1 On the breadboard: columns 15 – 27; GND; brown-black-red; Q1 · flat face toward you; D1 1N4148 (stripe at 24); VIBRATION MOTOR; 3–5 V coin / pager; red +; blue −

### orange wire 51 comes from the Nano: pin D8 = hole c8

### Highlighted strips = holes joined inside the board (5 holes per strip)

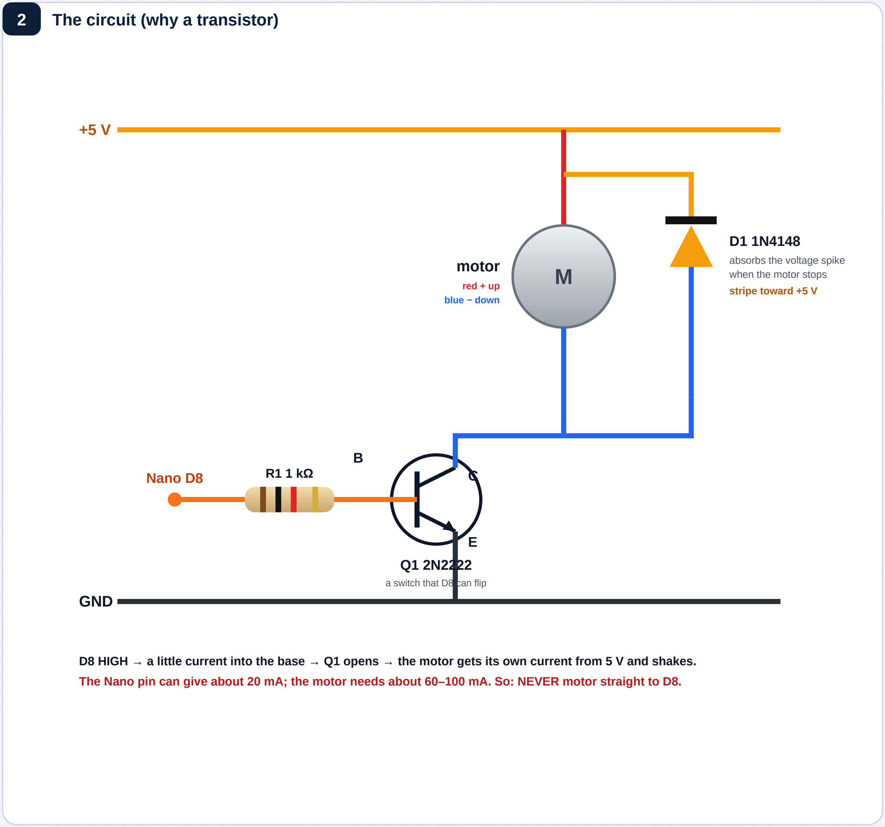
[picture p249: figure]
2 The circuit (why a transistor); GND; motor; red + up blue − down; absorbs the voltage spike when the motor stops stripe toward +5 V; a switch that D8 can flip; Nano D8

D8 HIGH → a little current into the base → Q1 opens → the motor gets its own current from 5 V and shakes. The Nano pin can give about 20 mA; the motor needs about 60–100 mA. So: NEVER motor straight to D8.

# 3 Where the vibration motor is fixed on the rig

## stiff base plate: plywood or acrylic, ~6 mm

## PAN

NEMA17

## camera + laser head

### breadboard

M

## VIBRATION MOTOR

### two thin wires to holes g24 (red) and g21 (blue)

# How to fix it

1

Put it on the BASE PLATE, 10–15 cm from the pan motor. The plate carries the whole rig, so the whole rig shakes.

2

Fix it flat with a cable tie AND a strip of double-sided foam
tape. Bolt only if it comes with a mounting ear.

3

Wires: 20–30 cm, run along the plate edge with tape. Keep them away from the pan shaft and the AS5600 magnet.

4

Plug the red wire into g24 and the other wire into g21 (close-up, panel 1).

5

Test with 12 V OFF: in the serial monitor type V1 → you feel a
buzz, V0 → it stops.

6

Demo moment: rig locked on the beacon → V1 → the lock box shakes but holds → V0.

# ZEROdrift · MK2 · connection diagram

## 12 V

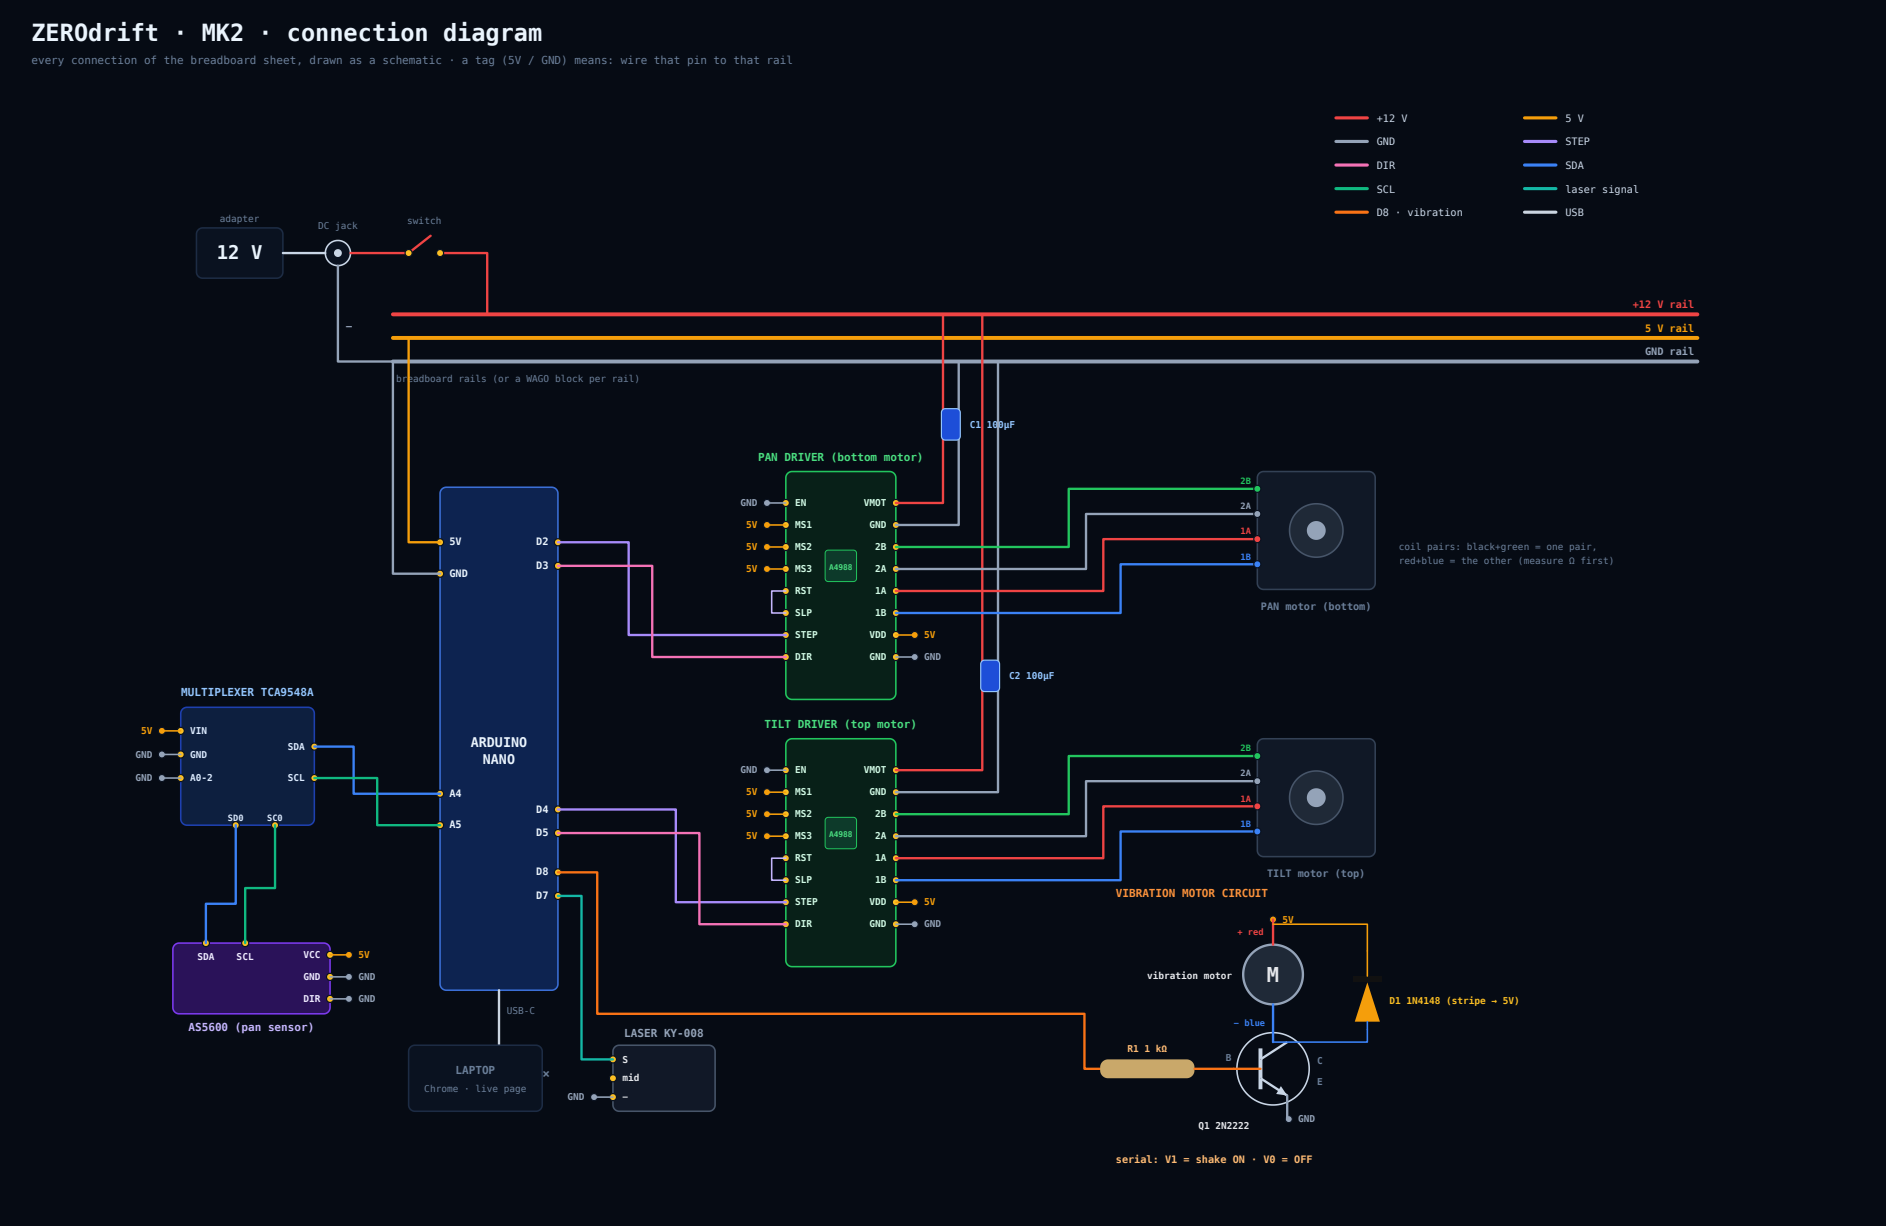
[picture p250: page 3]

every connection of the breadboard sheet, drawn as a schematic · a tag (5V / GND) means: wire that pin to that rail

breadboard rails (or a WAGO block per rail)

PAN DRIVER (bottom motor)

coil pairs: black+green = one pair,
red+blue = the other (measure Ω first)

TILT DRIVER (top motor)

serial: V1 = shake ON · V0 = OFF
