pranshukesavmishra/SIH-2026/docs/cad/renders/zerodrift_assembly.gif

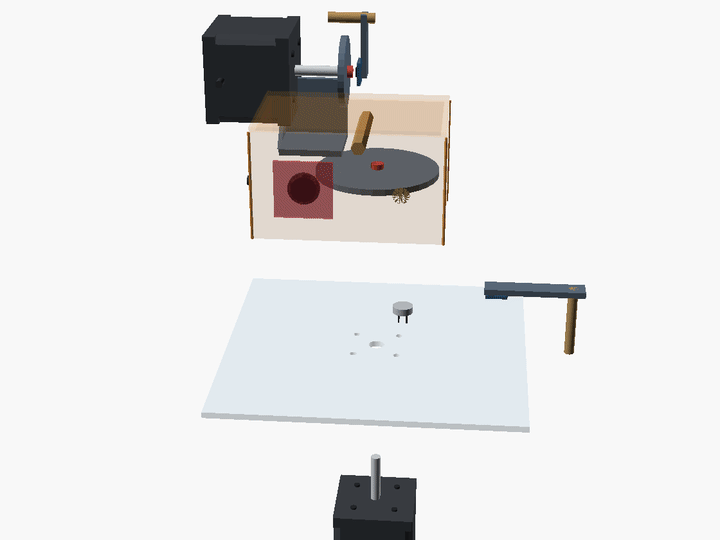
docs/cad/renders/zerodrift_assembly.gif
