pranshukesavmishra/SIH-2026/docs/mk3/img/easy_wiring.png

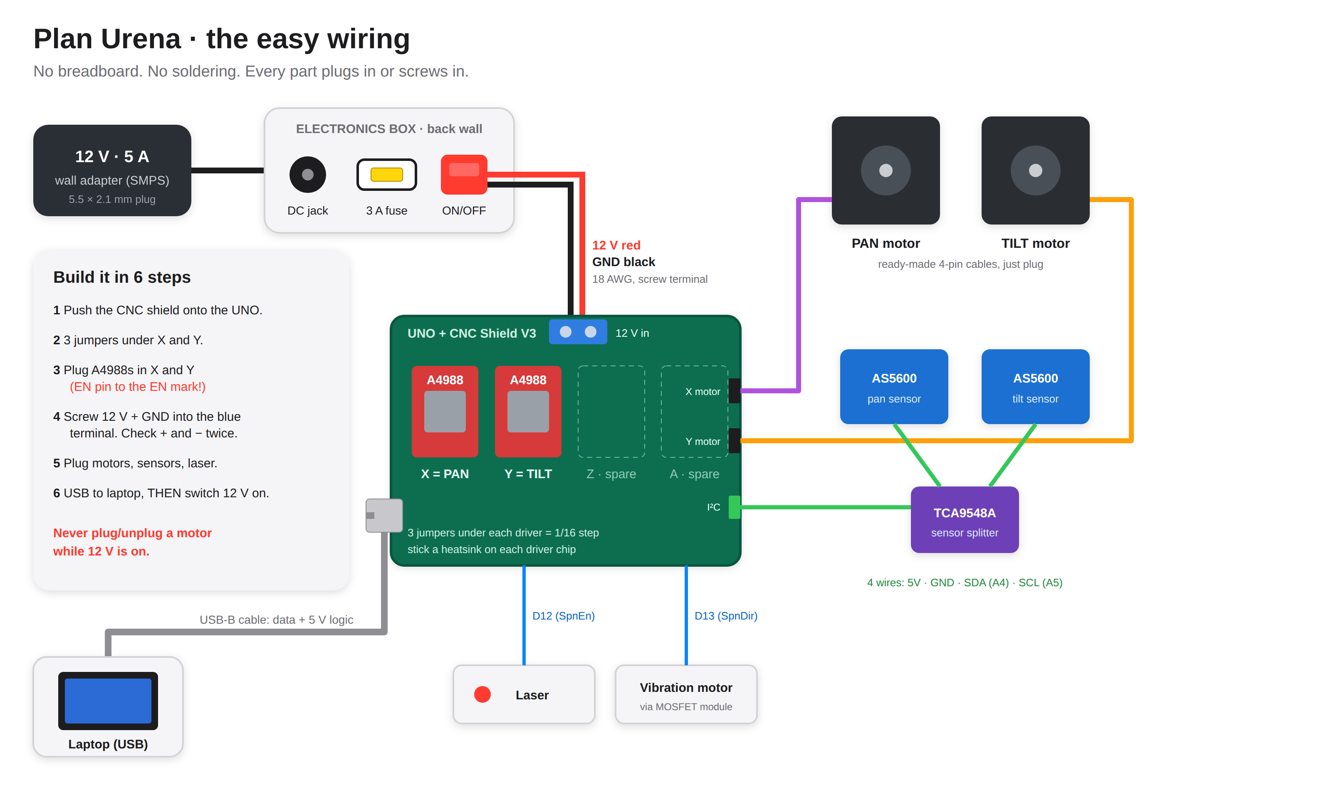
docs/mk3/img/easy_wiring.png
