pranshukesavmishra/SIH-2026/docs/submission/picture_guide/card_03.png

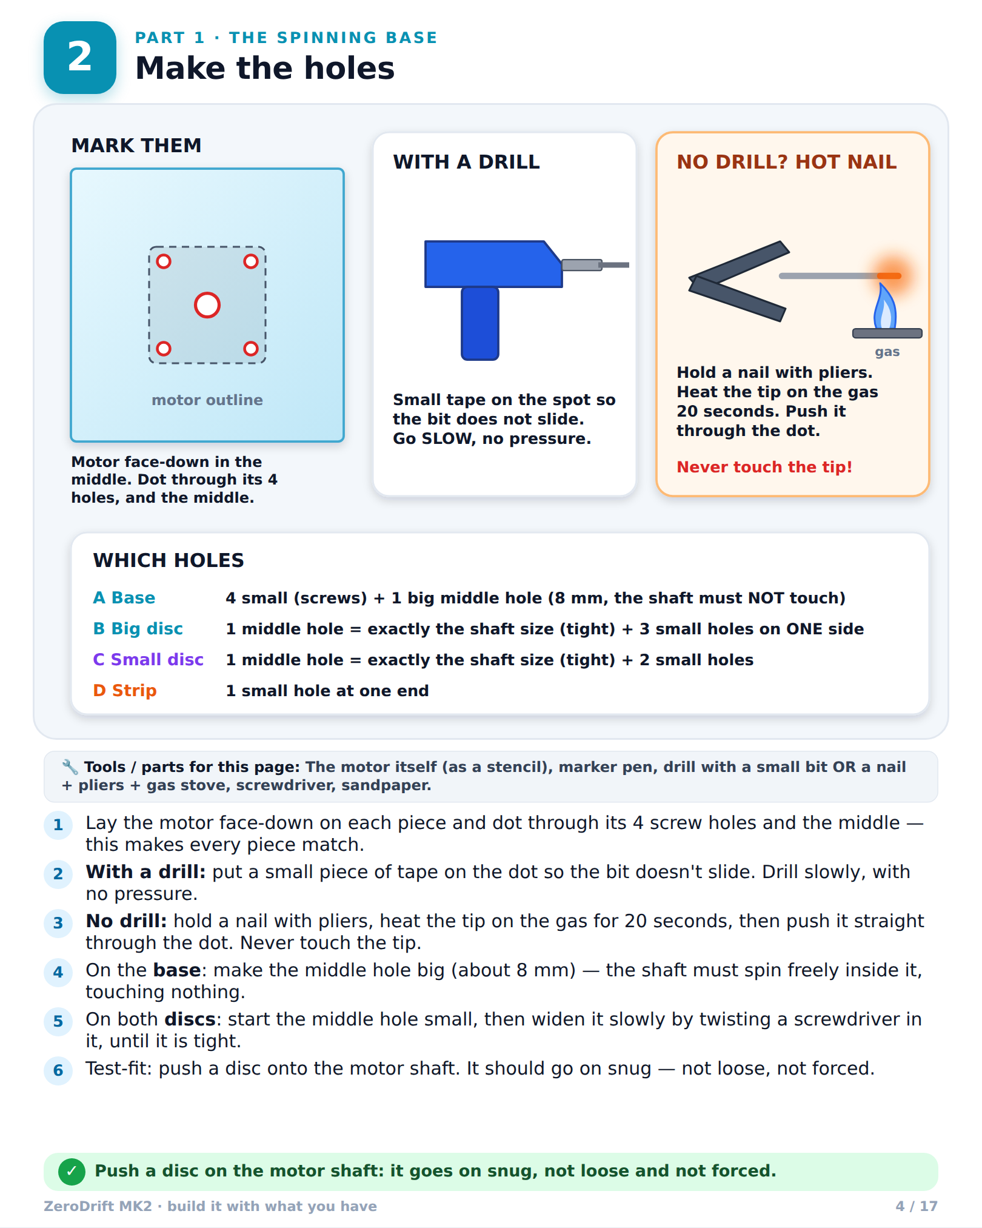
docs/submission/picture_guide/card_03.png
