pranshukesavmishra/SIH-2026/docs/submission/picture_guide/card_07.png

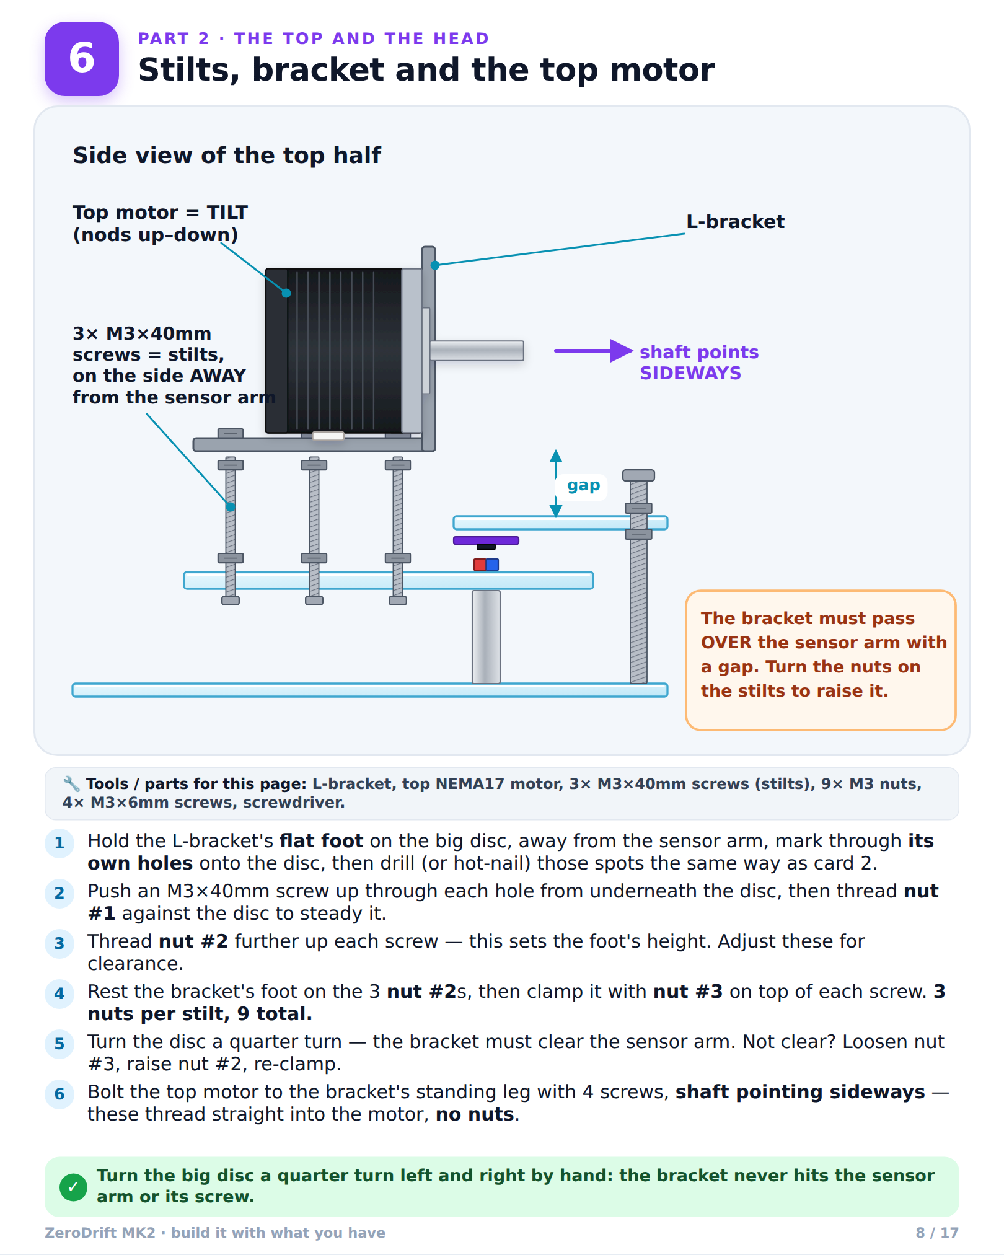
docs/submission/picture_guide/card_07.png
