pranshukesavmishra/SIH-2026/docs/submission/picture_guide/card_08.png

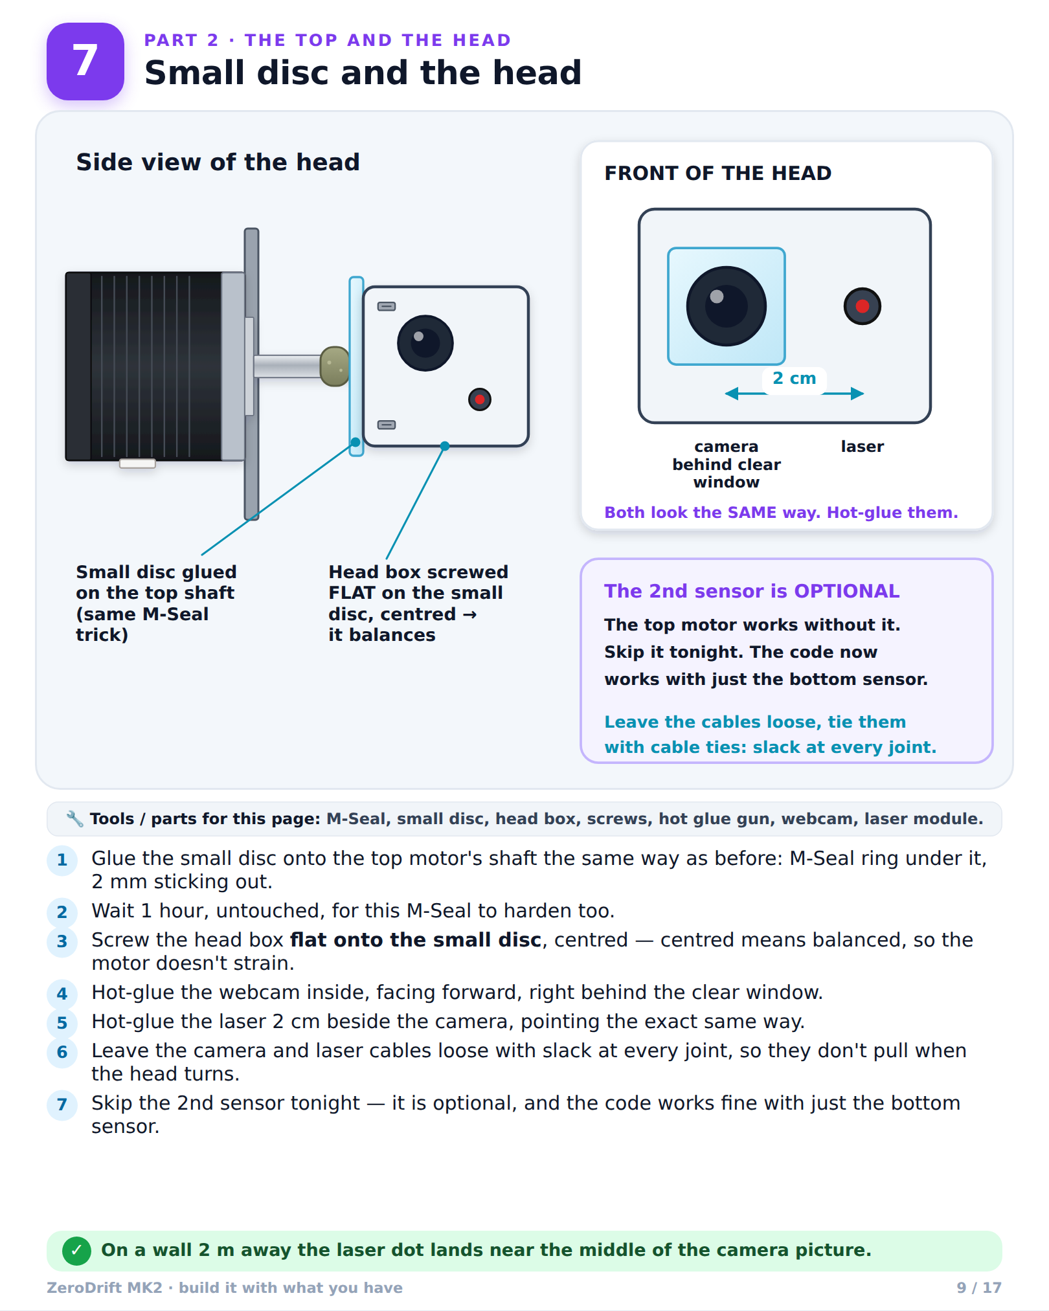
docs/submission/picture_guide/card_08.png
