pranshukesavmishra/SIH-2026/docs/submission/picture_guide/card_09.png

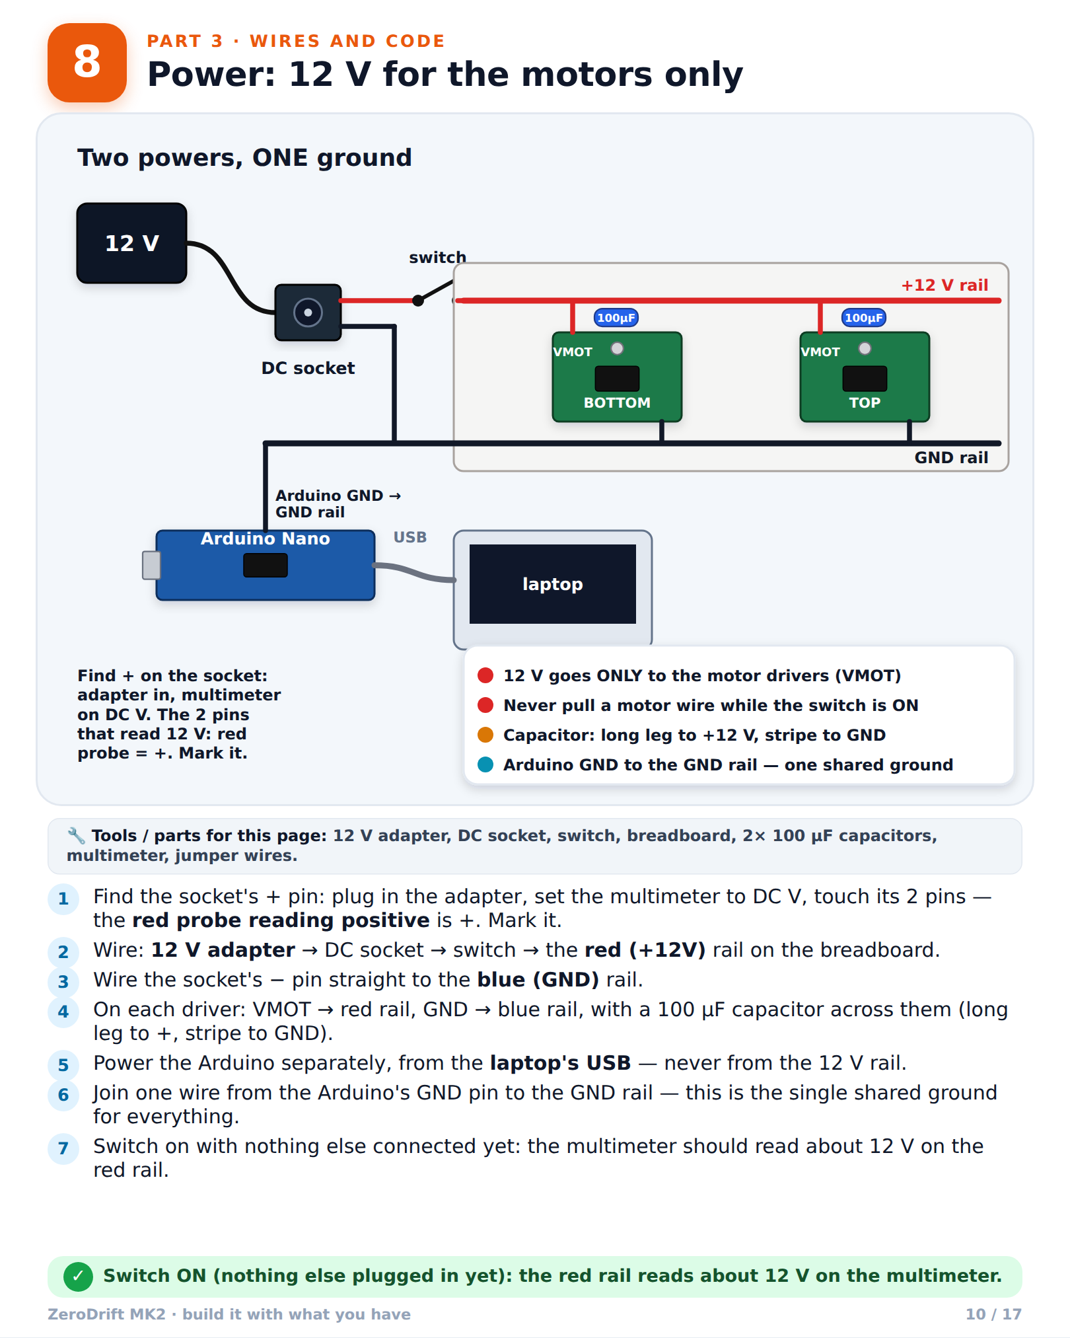
docs/submission/picture_guide/card_09.png
