pranshukesavmishra/SIH-2026/docs/submission/picture_guide/card_13.png

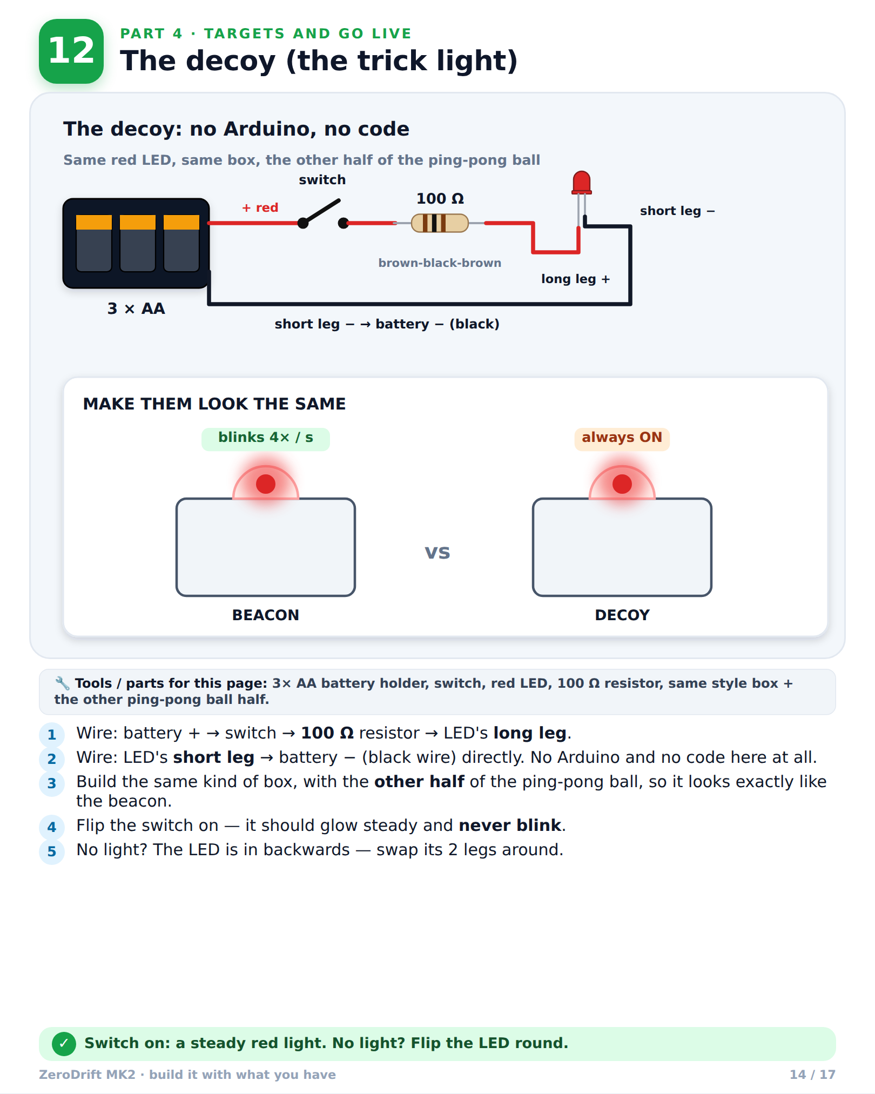
docs/submission/picture_guide/card_13.png
