pranshukesavmishra/SIH-2026/docs/submission/picture_guide/card_14.png

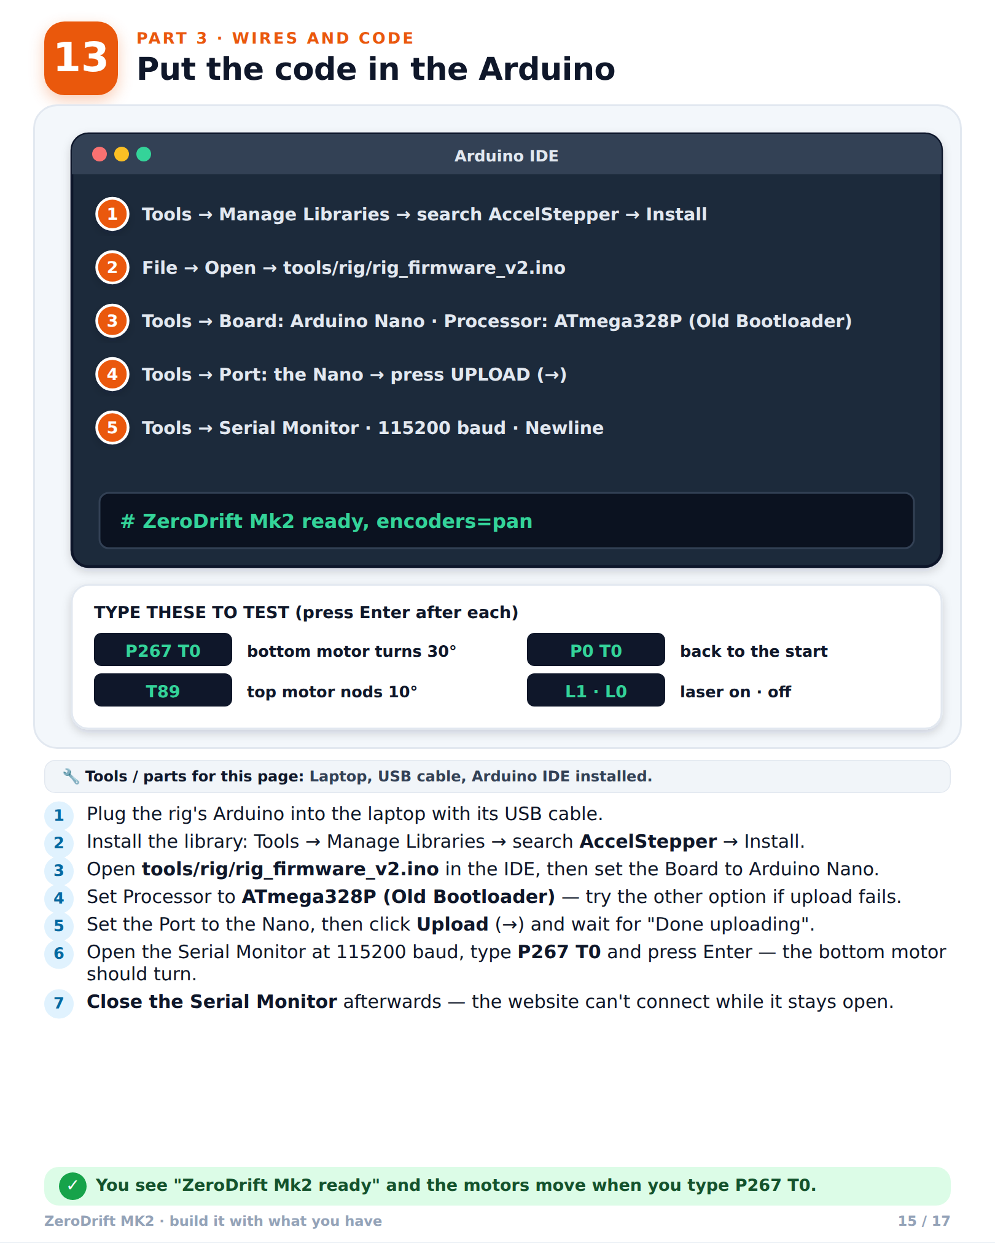
docs/submission/picture_guide/card_14.png
