pranshukesavmishra/SIH-2026/docs/submission/picture_guide/card_15.png

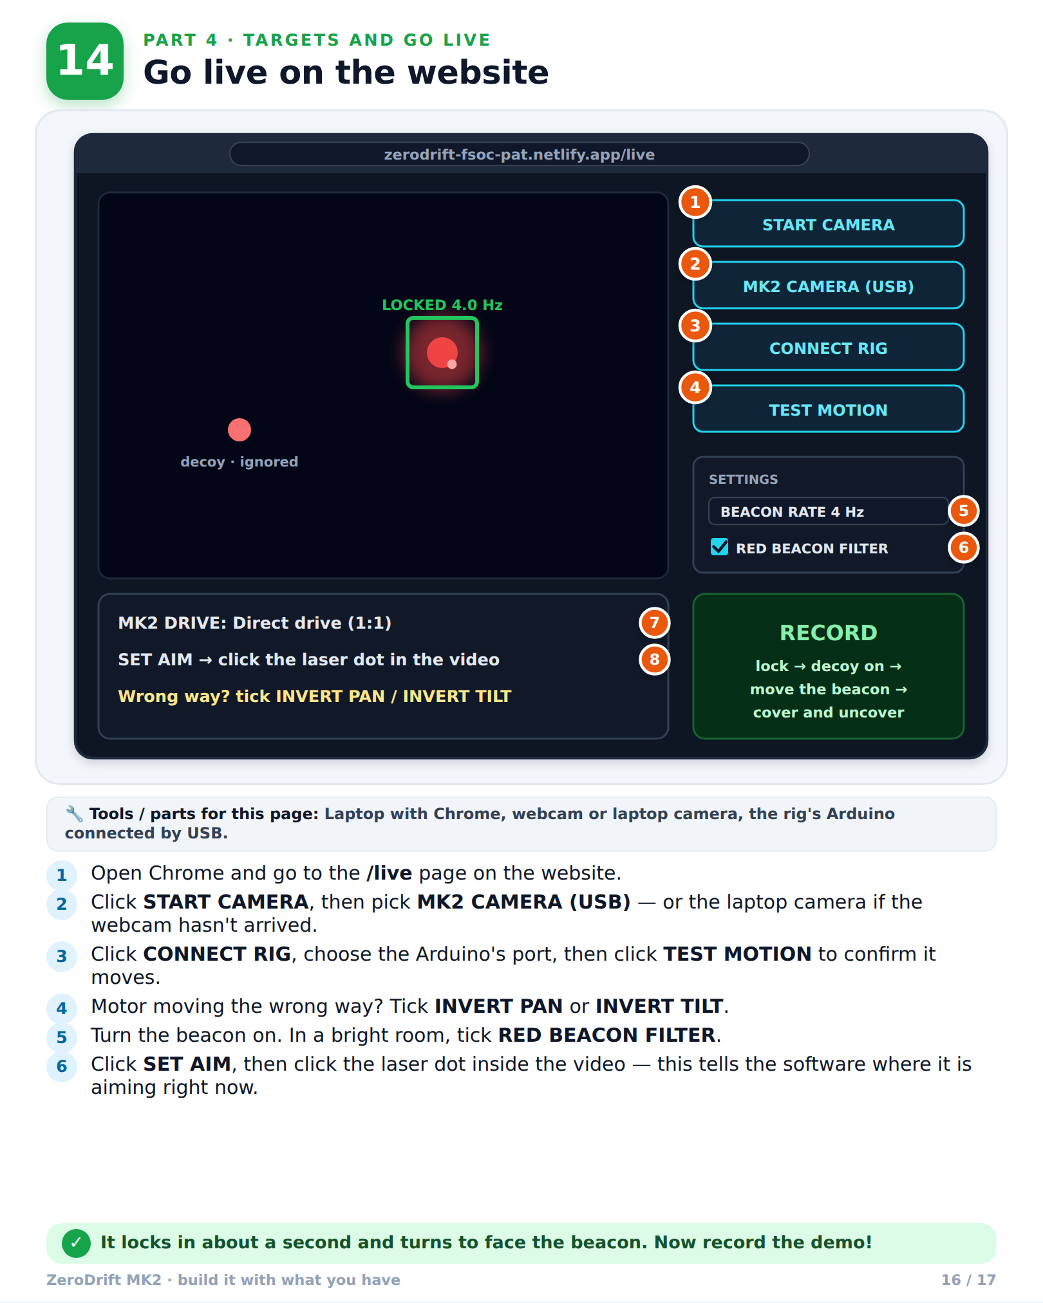
docs/submission/picture_guide/card_15.png
