pranshukesavmishra/SIH-2026/tools/rig/beacon_wiring.png

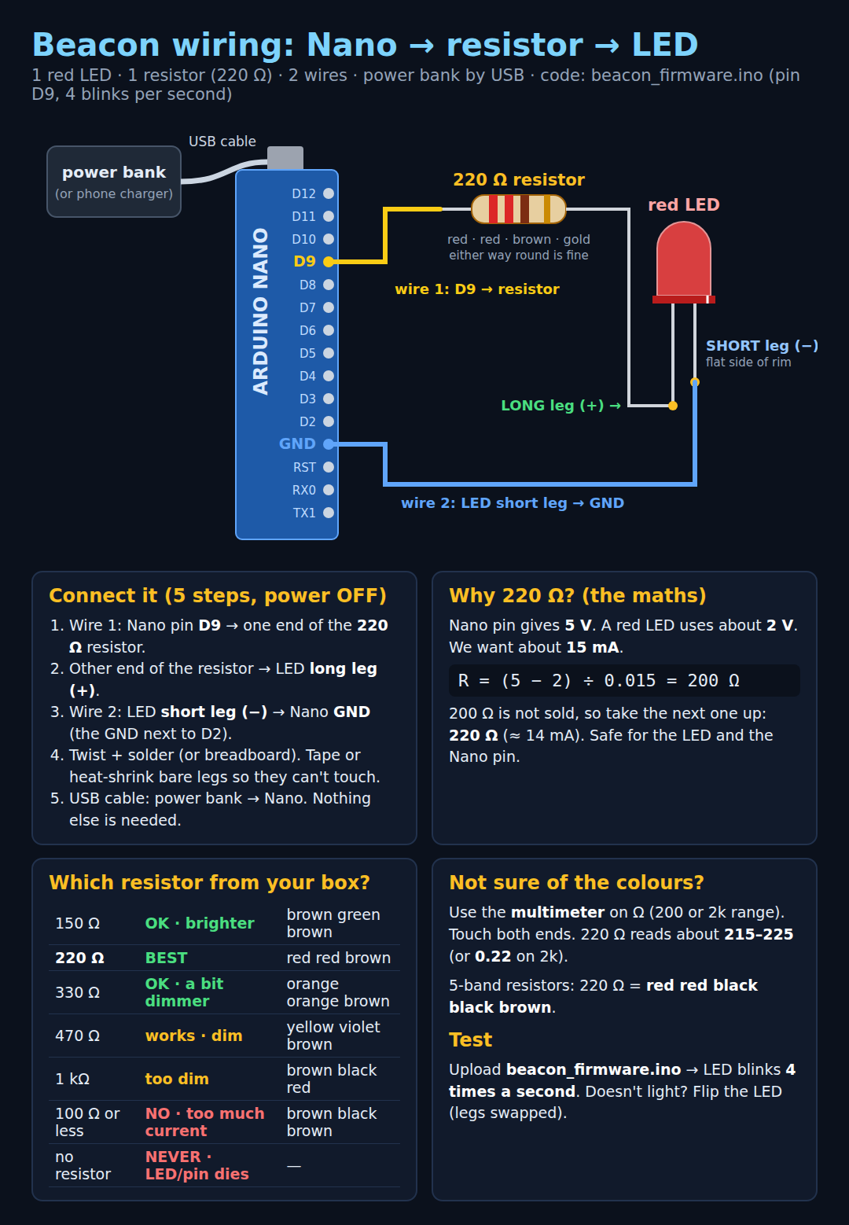
tools/rig/beacon_wiring.png
