pranshukesavmishra/SIH-2026/tools/rig/MK2_breadboard_wiring.png

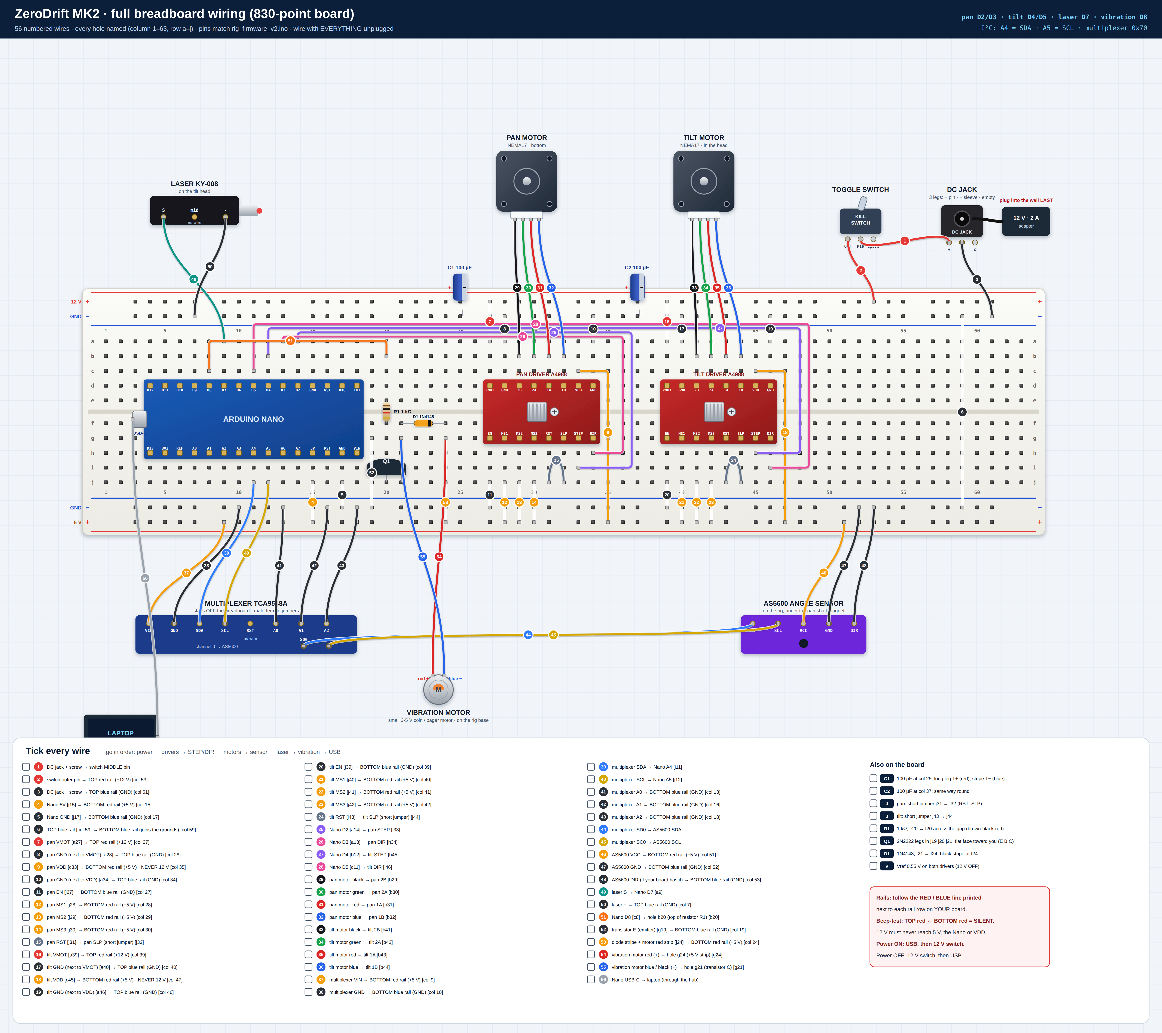
tools/rig/MK2_breadboard_wiring.png
