pranshukesavmishra/SIH-2026/docs/media/sop/test_record.jpg

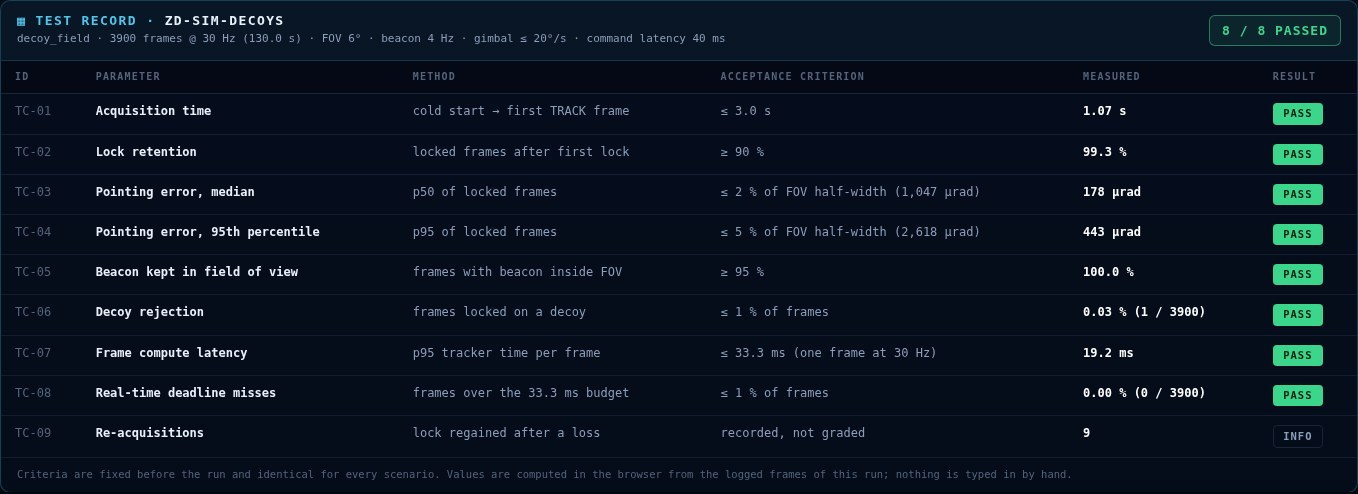
docs/media/sop/test_record.jpg
