pranshukesavmishra/SIH-2026/docs/mk3/img/parts/00_test_coupon.jpg

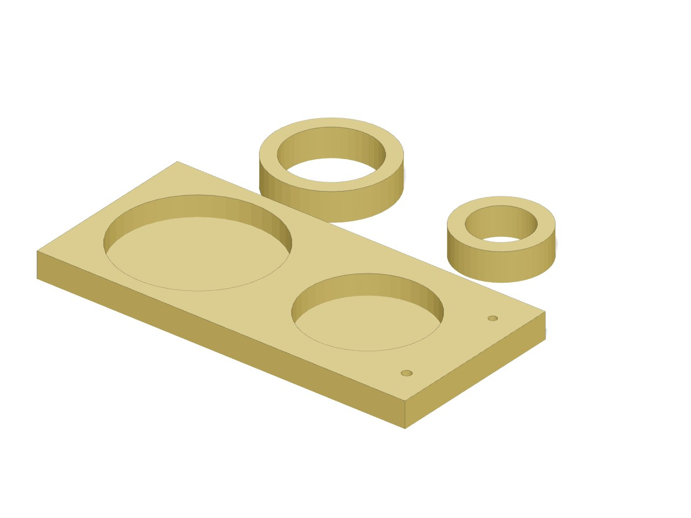
docs/mk3/img/parts/00_test_coupon.jpg
