pranshukesavmishra/SIH-2026/docs/submission/slide3_own_images/2_neural_verifier.png

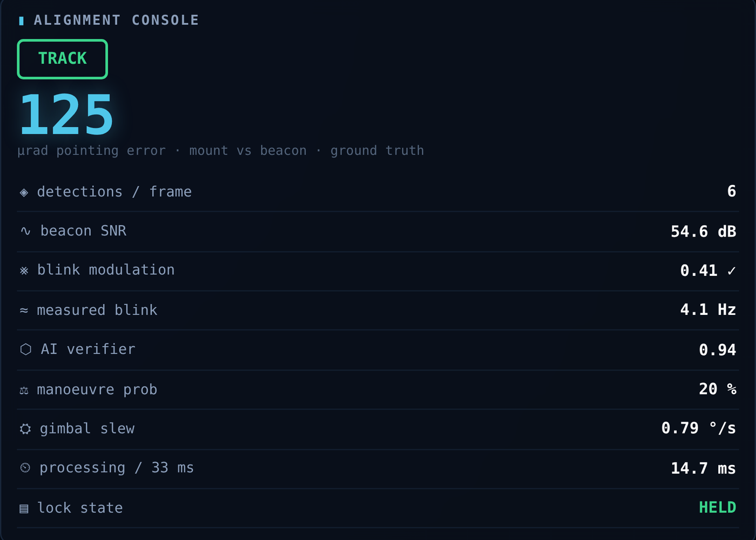
docs/submission/slide3_own_images/2_neural_verifier.png
