pranshukesavmishra/SIH-2026/tools/rig/MK2_wiring_no_breadboard.pdf

# ZeroDrift MK2 · wiring WITHOUT a breadboard

## 12 V · 2 A

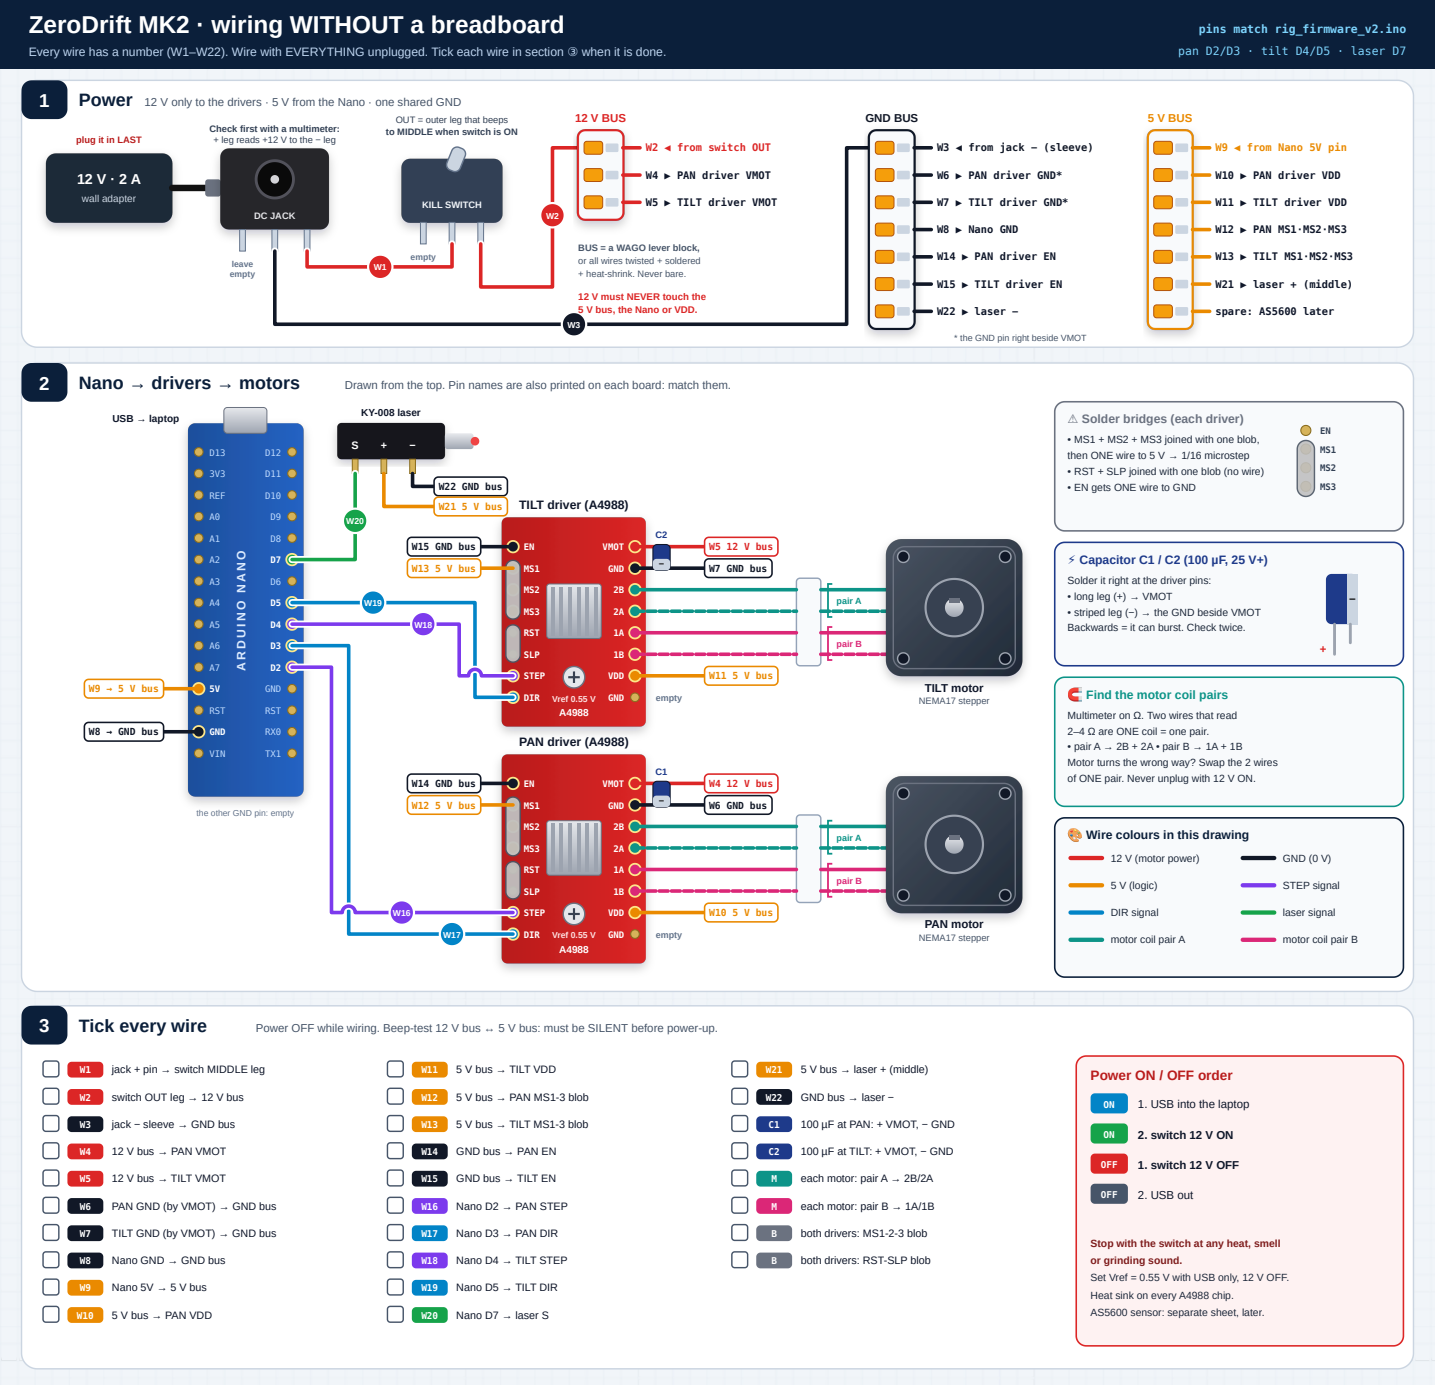
[picture p304: page 1]

Every wire has a number (W1–W22). Wire with EVERYTHING unplugged. Tick each wire in section ③ when it is done.

1 Power 12 V only to the drivers · 5 V from the Nano · one shared GND

OUT = outer leg that beeps
to MIDDLE when switch is ON

Check first with a multimeter:
+ leg reads +12 V to the − leg

plug it in LAST

BUS = a WAGO lever block,
or all wires twisted + soldered
+ heat-shrink. Never bare.

12 V must NEVER touch the
5 V bus, the Nano or VDD.

* the GND pin right beside VMOT

⚠ Solder bridges (each driver)

• MS1 + MS2 + MS3 joined with one blob,
then ONE wire to 5 V → 1/16 microstep
• RST + SLP joined with one blob (no wire)
• EN gets ONE wire to GND

Solder it right at the driver pins:
• long leg (+) → VMOT
• striped leg (−) → the GND beside VMOT
Backwards = it can burst. Check twice.

🧲 Find the motor coil pairs

Multimeter on Ω. Two wires that read
2–4 Ω are ONE coil = one pair.
• pair A → 2B + 2A • pair B → 1A + 1B
Motor turns the wrong way? Swap the 2 wires
of ONE pair. Never unplug with 12 V ON.

the other GND pin: empty

🎨 Wire colours in this drawing

Power ON / OFF order

Stop with the switch at any heat, smell
or grinding sound.
Set Vref = 0.55 V with USB only, 12 V OFF.
Heat sink on every A4988 chip.
AS5600 sensor: separate sheet, later.

B both drivers: RST-SLP blob
