pranshukesavmishra/SIH-2026/docs/mk3/firmware/rig_firmware_v3.ino

/*
 * ZeroDrift MK3 (Plan Urena) — tracker firmware for the 3D-printed belt gimbal.
 * Same protocol as Mk2 (the host and the Live page do not change); what changed:
 *   - 4:1 GT2 belts on both axes (20T motor pulley -> 80T axis pulley)
 *   - travel limits from the MK3 CAD clearance check: pan +/-150, tilt +/-40
 *   - runs on an UNO + CNC Shield V3 (default) or a hand-wired Nano (BOARD_CNC_SHIELD 0)
 *   - EN pin so the drivers can be switched off from firmware
 *   - faster slews, because every output degree now costs 4x the steps
 *   - banner still says "Mk2" so the Live page detects it; pick
 *     "Both belts 20T->80T (4:1)" in the Live page's drive menu.
 *
 * Derived from ZeroDrift Mini-Rig Mk2 firmware:
 * Arduino Nano/Uno + 2x A4988 + 2x NEMA17 + 2x AS5600 (via TCA9548A)
 *                   + laser + vibration injector.
 * (Tier B swaps the A4988s for TMC2209s and adds a 3:1 belt: change
 *  MICROSTEPS and *_GEAR_RATIO below, reflash, and nothing else moves.)
 *
 * Libraries (Arduino Library Manager): AccelStepper, Wire.
 * (Servo.h is only needed if you set FINE_STAGE to 1 — see below.)
 *
 * NO SERVOS in the default build. The Mk1 rig stripped two of them, and a
 * hobby servo's backlash is larger than the pointing error this rig is
 * supposed to measure. Resolution now comes from microstepping and an
 * optional belt reduction, both of which have no gear teeth to shear.
 *
 * ---------------------------------------------------------------------
 * PROTOCOL — see docs/HARDWARE_PROTOCOL.md. Read that before editing.
 *
 * THE WIRE IS MOTOR STEPS, and the host owns the conversion. This is not
 * the arrangement this file originally shipped with; it is the one
 * src/fsoc_pat/hil/mk2.py already implements, with a safety envelope and
 * a dry-run mode, and that driver is tested while this firmware is not.
 * Between a tested host and an untested sketch, the sketch moves.
 *
 * Host-side scale lives in mk2.py as DEFAULT_STEPS_PER_RAD = 200*16/2pi.
 * If you change MICROSTEPS below, change that constant to match, or every
 * angle the host commands is silently scaled.
 *
 *   P<int> T<int>    coarse absolute target, in motor steps from centre
 *   p<int> t<int>    fine-stage absolute angle, servo degrees (FINE_STAGE=1)
 *   L0               laser off
 *   L1               laser on, steady
 *   L<hz>            laser MODULATED at <hz>, e.g. L7.0
 *
 *   The laser is modulated so the camera can tell the laser's own dot
 *   apart from the beacon by frequency, exactly the way the beacon is
 *   told apart from the decoy. Beacon 4 Hz, laser 7 Hz: two sources,
 *   two signatures, one image. That is what lets the fine loop close on
 *   the dot-to-beacon pixel error and cancel parallax outright, instead
 *   of modelling it. See docs/TERMINAL_MK3.md section 0.
 *   V0 | V1          vibration injector off / on
 *   C                drive both stages back to 0,0 (the power-on / Z datum)
 *   Z                zero: call the current position 0,0
 *   ?                status query -> "S <panSteps> <tiltSteps> <src> <moving>"
 *   !                self-test (see selftest(), for bring-up)
 *
 * Every command is newline-terminated. Replies are newline-terminated.
 * ---------------------------------------------------------------------
 *
 * Encoder policy, stated plainly: the AS5600s are read only while both
 * steppers are at rest. An I2C transaction takes roughly a millisecond,
 * and at speed that is long enough to disturb AccelStepper's timing and
 * cause the very skipped step the encoders exist to catch. So during a
 * slew the status reply carries the commanded position (src=C), and on
 * arrival it carries the measured one (src=E). That is exactly the check
 * that matters -- "did the motor actually get where it was told" -- and
 * it costs nothing in step fidelity.
 */

#include <AccelStepper.h>
#include <Wire.h>
#if FINE_STAGE
#include <Servo.h>
#endif

// ---- Board. 1 = Arduino UNO + CNC Shield V3 (the Plan Urena build: no
// breadboard, drivers plug in). 0 = Nano wired by hand, same pins as Mk2.
#ifndef BOARD_CNC_SHIELD
#define BOARD_CNC_SHIELD 1
#endif

// ---- Pin map — verify against your actual wiring before first power-on ----
#if BOARD_CNC_SHIELD
// CNC Shield V3: X socket = pan, Y socket = tilt, one EN pin for all drivers.
const int PAN_STEP_PIN  = 2,  PAN_DIR_PIN  = 5;    // X.STEP, X.DIR
const int TILT_STEP_PIN = 3,  TILT_DIR_PIN = 6;    // Y.STEP, Y.DIR
const int ENABLE_PIN    = 8;                       // EN (LOW = motors powered)
const int LASER_PIN     = 12;                      // "SpnEn" pin
const int VIBRATION_PIN = 13;                      // "SpnDir" pin
#else
const int PAN_STEP_PIN  = 2,  PAN_DIR_PIN  = 3;
const int TILT_STEP_PIN = 4,  TILT_DIR_PIN = 5;
const int ENABLE_PIN    = 6;   // both drivers' EN pins: LOW = motors powered (A4988 default)
const int LASER_PIN     = 7;
const int VIBRATION_PIN = 8;
#endif
const int FINE_PAN_PIN  = 9,  FINE_TILT_PIN = 10;
// A4 = SDA, A5 = SCL on a Nano/Uno — wired to the TCA9548A.

// ---- Fine stage: OFF by default. See the header. ------------------------
#define FINE_STAGE 0

// ---- Mechanics ----------------------------------------------------------
// 200 full steps/rev (1.8 deg/step) x 16 microsteps = 3200 steps/rev.
// On an A4988, 1/16 is MS1=MS2=MS3=HIGH. CHECK YOUR BOARD'S SILKSCREEN:
// the truth table differs between vendors, and getting it wrong scales
// every angle you command -- silently, because the motor still turns.
// Whatever you set the jumpers to, set MICROSTEPS to match and reflash.
const float STEPS_PER_REV = 200.0;
const float MICROSTEPS    = 16.0;                 // TMC2209 at 1/32 -> 32.0
const float STEPS_PER_DEG = (STEPS_PER_REV * MICROSTEPS) / 360.0;   // 8.889

// Belt reduction, motor turns per output turn. 1.0 = direct drive.
// With a GT2 20T pulley on the motor and 60T on the output stage, set 3.0:
// it divides the commanded step size AND the motor's own inherent
// positioning error by three, which is why it is worth the build effort.
// This lives here, not on the host — the host is not allowed to know about
// mechanics. Change the pulleys, change this number, reflash, done.
const float PAN_GEAR_RATIO  = 4.0;    // MK3: 20T -> 80T
const float TILT_GEAR_RATIO = 4.0;    // MK3: 20T -> 80T

// ---- Soft limits. These protect the wiring loom and the head. -----------
// MK3 CAD (tools/mk3/mk3_cad.py) sweeps clear for pan +/-150 and tilt
// -45..+60. Which way is "+" depends on how the motor was wired, so tilt
// is kept symmetric at +/-40. Held in output degrees and converted to motor
// steps here, so the belt reduction does not silently widen the travel.
// The Live page and mk2.py clamp tighter (pan +/-90, tilt +/-18); this is
// the backstop for when a person in a serial terminal is talking.
const float PAN_LIMIT_DEG  = 150.0;   // MK3: cables have slack for +/-150
const float TILT_LIMIT_DEG = 40.0;    // MK3: CAD sweep is clear from -45 to +60
const long PAN_MAX_STEPS  = (long)(PAN_LIMIT_DEG  * STEPS_PER_DEG * PAN_GEAR_RATIO  + 0.5);
const long TILT_MAX_STEPS = (long)(TILT_LIMIT_DEG * STEPS_PER_DEG * TILT_GEAR_RATIO + 0.5);
const long PAN_MIN_STEPS  = -PAN_MAX_STEPS, TILT_MIN_STEPS = -TILT_MAX_STEPS;
#if FINE_STAGE
const int   FINE_CENTRE_US = 90;           // servo degrees at mechanical centre
const float FINE_RANGE_DEG = 30.0;         // +/- offset the fine stage may take
#endif

// ---- I2C addresses ------------------------------------------------------
const uint8_t TCA_ADDR      = 0x70;
const uint8_t AS5600_ADDR   = 0x36;
const uint8_t AS5600_RAWANG = 0x0C;        // 12-bit raw angle, high byte first
const uint8_t PAN_CHANNEL   = 0;
const uint8_t TILT_CHANNEL  = 1;

AccelStepper panStepper(AccelStepper::DRIVER, PAN_STEP_PIN, PAN_DIR_PIN);
AccelStepper tiltStepper(AccelStepper::DRIVER, TILT_STEP_PIN, TILT_DIR_PIN);
#if FINE_STAGE
Servo finePan, fineTilt;
#endif

// Laser modulation. Referenced against micros(), never delay() — the
// frequency has to actually be the number we claim, for the same reason
// the beacon's does.
float         laserHz          = 0.0;      // 0 = not modulating
bool          laserSteady      = false;
bool          laserPhaseOn     = false;
unsigned long laserHalfPeriodUs = 0;
unsigned long laserLastToggleUs = 0;

// Sensor direction. The AS5600 counts one way when it looks at the magnet
// from below and the other way from above, and the motor's "+" depends on
// its wiring. If the self-test ('!') says "direction reversed", flip the
// sign here and reflash.
const int PAN_ENC_DIR  = +1;
const int TILT_ENC_DIR = +1;
// Sensor turns per OUTPUT turn. MK3's pan axis is hollow (the cables run down
// it), so the pan AS5600 reads the pan MOTOR shaft instead: 4 turns per pan
// turn. That also makes it 4x finer. The tilt sensor reads the tilt axis itself
// (a magnet in the end of the right trunnion).
const float PAN_ENC_RATIO  = PAN_GEAR_RATIO;
const float TILT_ENC_RATIO = 1.0;

bool  encodersPresent = false;             // at least one AS5600 answered
bool  panEnc = false, tiltEnc = false;      // each axis on its own: tilt is optional
float panZeroDeg = 0.0, tiltZeroDeg = 0.0; // datum: raw sensor angle at boot / Z

// ------------------------------------------------------------------------
void tcaSelect(uint8_t channel) {
  Wire.beginTransmission(TCA_ADDR);
  Wire.write(1 << channel);
  Wire.endTransmission();
}

// Raw 0..4095 from the AS5600 on the given mux channel; -1 if it did not answer.
int readRaw(uint8_t channel) {
  tcaSelect(channel);
  Wire.beginTransmission(AS5600_ADDR);
  Wire.write(AS5600_RAWANG);
  if (Wire.endTransmission(false) != 0) return -1;
  if (Wire.requestFrom((uint8_t)AS5600_ADDR, (uint8_t)2) != 2) return -1;
  int hi = Wire.read(), lo = Wire.read();
  return ((hi << 8) | lo) & 0x0FFF;
}

// Measured OUTPUT angle from the datum, in degrees; NAN if no answer.
// The sensor only knows 0..360 of its own shaft, and a single move can be
// many sensor turns (MK3 pans +/-150 with the sensor geared 4:1). Counting
// wraps between reads would then be fooled. Instead take the one of
// (reading + k x 360) nearest to where the sensor should be: right unless
// the axis is off by more than half a sensor turn (45 deg of pan, 180 of tilt).
float readAxisDeg(uint8_t channel, int dir, float ratio, float zeroDeg, float commandedDeg) {
  int raw = readRaw(channel);
  if (raw < 0) return NAN;
  float a = dir * (raw * (360.0 / 4096.0) - zeroDeg);
  a += 360.0 * lround((commandedDeg * ratio - a) / 360.0);
  return a / ratio;
}

float clampf(float v, float lo, float hi) {
  return v < lo ? lo : (v > hi ? hi : v);
}

long clampStepsPan(long v)  { return v < PAN_MIN_STEPS  ? PAN_MIN_STEPS
                                  : (v > PAN_MAX_STEPS  ? PAN_MAX_STEPS  : v); }
long clampStepsTilt(long v) { return v < TILT_MIN_STEPS ? TILT_MIN_STEPS
                                  : (v > TILT_MAX_STEPS ? TILT_MAX_STEPS : v); }

bool moving() {
  return panStepper.distanceToGo() != 0 || tiltStepper.distanceToGo() != 0;
}

// ------------------------------------------------------------------------
void setup() {
  Serial.begin(115200);
  Wire.begin();
  Wire.setClock(400000);                   // fast mode: shortens the stall

  // Conservative speeds. A NEMA17 on an A4988 at 12V will happily be
  // commanded faster than it can actually accelerate a loaded gimbal, and
  // a skipped step is worse than a slow slew.
  // At 1/16 a degree costs 8.9 steps, so 1200 steps/s = 135 deg/s. An
  // Arduino Nano tops out near 4000 steps/s across both axes; if you move
  // to 1/32 or add the 3:1 belt, raise these proportionally or accept a
  // correspondingly slower slew.
  // MK3: 4:1 belts, so 35.6 motor steps per output degree. 2000 steps/s
  // = 56 deg/s at the output, and 2 x 2000 stays inside what a Nano can
  // step for both axes at once.
  panStepper.setMaxSpeed(2000);
  panStepper.setAcceleration(2000);
  tiltStepper.setMaxSpeed(2000);
  tiltStepper.setAcceleration(2000);

#if FINE_STAGE
  finePan.attach(FINE_PAN_PIN);
  fineTilt.attach(FINE_TILT_PIN);
  finePan.write(FINE_CENTRE_US);
  fineTilt.write(FINE_CENTRE_US);
#endif

  pinMode(ENABLE_PIN, OUTPUT);    digitalWrite(ENABLE_PIN, LOW);   // drivers on
  pinMode(LASER_PIN, OUTPUT);     digitalWrite(LASER_PIN, LOW);
  pinMode(VIBRATION_PIN, OUTPUT); digitalWrite(VIBRATION_PIN, LOW);

  // Probe the encoders once. If they are absent the rig still runs fully
  // open-loop and says so in every status reply, rather than pretending.
  int panRaw  = readRaw(PAN_CHANNEL);
  int tiltRaw = readRaw(TILT_CHANNEL);
  // Each axis stands alone, so a rig built with only the pan sensor (the
  // tilt one is optional) still reports measured pan instead of dropping
  // both axes to commanded positions.
  panEnc  = panRaw  >= 0;
  tiltEnc = tiltRaw >= 0;
  encodersPresent = panEnc || tiltEnc;
  // Datum: the steppers boot calling wherever they are 0, so the encoders
  // must too. Without this the first status reply is the magnet's absolute
  // angle (any of 0..360 deg) instead of 0.
  panZeroDeg  = max(0, panRaw)  * (360.0 / 4096.0);
  tiltZeroDeg = max(0, tiltRaw) * (360.0 / 4096.0);

  // The banner must start "# ZeroDrift Mk2": that is how the Live page and
  // mk2.py recognise a stepper rig. The protocol is Mk2's, so it is true.
  Serial.print(F("# ZeroDrift Mk2 ready, encoders="));
  Serial.print(panEnc && tiltEnc ? F("yes") : panEnc ? F("pan") : tiltEnc ? F("tilt") : F("no"));
  Serial.println(F(", belts=4:4"));
}

void loop() {
  static char buf[32];
  static int  n = 0;

  while (Serial.available()) {
    char c = Serial.read();
    if (c == '\r') continue;
    if (c == '\n' || n >= 31) { buf[n] = 0; n = 0; handleLine(buf); }
    else buf[n++] = c;
  }

  panStepper.run();
  tiltStepper.run();
  serviceLaser();
}

void serviceLaser() {
  if (laserHz <= 0.0) return;              // off or steady: nothing to do
  unsigned long now = micros();
  if (now - laserLastToggleUs >= laserHalfPeriodUs) {
    laserLastToggleUs = now;
    laserPhaseOn = !laserPhaseOn;
    digitalWrite(LASER_PIN, laserPhaseOn ? HIGH : LOW);
  }
}

// ------------------------------------------------------------------------
void handleLine(char *line) {
  switch (line[0]) {

    case 'P': {                            // coarse absolute, MOTOR STEPS
      long pan, tilt;
      int got = sscanf(line, "P%ld T%ld", &pan, &tilt);
      if (got >= 1) panStepper.moveTo(clampStepsPan(pan));
      if (got == 2) tiltStepper.moveTo(clampStepsTilt(tilt));
      break;
    }

    case 'T': {                            // tilt alone
      long tilt;
      if (sscanf(line, "T%ld", &tilt) == 1) tiltStepper.moveTo(clampStepsTilt(tilt));
      break;
    }

    case 'p': {                            // fine absolute, servo degrees
#if FINE_STAGE
      int pan, tilt;
      int got = sscanf(line, "p%d t%d", &pan, &tilt);
      if (got >= 1) finePan.write(constrain(pan, 20, 160));
      if (got == 2) fineTilt.write(constrain(tilt, 40, 140));
#endif
      break;                               // no fine stage: accept and ignore
    }

    case 't': {                            // fine tilt alone
#if FINE_STAGE
      int tilt;
      if (sscanf(line, "t%d", &tilt) == 1) fineTilt.write(constrain(tilt, 40, 140));
#endif
      break;
    }

    case 'L': {
      // "L0" off, "L1" steady on, anything else a modulation frequency.
      if (line[1] == '0' && line[2] == 0) {
        laserHz = 0.0; laserSteady = false;
        digitalWrite(LASER_PIN, LOW);
      } else if (line[1] == '1' && line[2] == 0) {
        laserHz = 0.0; laserSteady = true;
        digitalWrite(LASER_PIN, HIGH);
      } else {
        float hz = atof(line + 1);
        if (hz > 0.2) {                    // below this the dot reads as steady
          laserHz = hz;
          laserSteady = false;
          laserHalfPeriodUs = (unsigned long)(500000.0 / hz);
          laserLastToggleUs = micros();
          laserPhaseOn = true;
          digitalWrite(LASER_PIN, HIGH);
        }
      }
      break;
    }
    case 'V': digitalWrite(VIBRATION_PIN, line[1] == '1' ? HIGH : LOW); break;

    case 'C':                              // back to the datum (set at boot or by Z)
      panStepper.moveTo(0);
      tiltStepper.moveTo(0);
#if FINE_STAGE
      finePan.write(FINE_CENTRE_US);
      fineTilt.write(FINE_CENTRE_US);
#endif
      break;

    case 'Z': zeroHere(); break;
    case '?': reportStatus(); break;
    case '!': selftest(); break;

    default: break;                        // unknown: stay silent, keep moving
  }
}

void zeroHere() {
  panStepper.setCurrentPosition(0);
  tiltStepper.setCurrentPosition(0);
  if (panEnc)  panZeroDeg  = max(0, readRaw(PAN_CHANNEL))  * (360.0 / 4096.0);
  if (tiltEnc) tiltZeroDeg = max(0, readRaw(TILT_CHANNEL)) * (360.0 / 4096.0);
  Serial.println(F("# zeroed"));
}

void reportStatus() {
  float pan, tilt;
  char src;

  // Measured where a sensor exists and the axis is at rest; commanded
  // otherwise. src is E when at least one axis is a measurement.
  float p = NAN, t = NAN;
  if (!moving()) {
    if (panEnc)  p = readAxisDeg(PAN_CHANNEL,  PAN_ENC_DIR,  PAN_ENC_RATIO,  panZeroDeg,  commandedPan());
    if (tiltEnc) t = readAxisDeg(TILT_CHANNEL, TILT_ENC_DIR, TILT_ENC_RATIO, tiltZeroDeg, commandedTilt());
  }
  src  = (!isnan(p) || !isnan(t)) ? 'E' : 'C';
  pan  = isnan(p) ? commandedPan()  : p;
  tilt = isnan(t) ? commandedTilt() : t;

  // Reported in STEPS, same unit as the wire, so the host never has to
  // hold two scales in its head. The encoder measures degrees physically;
  // converting here keeps that detail where the mechanical constants are.
  Serial.print(F("S "));
  Serial.print((long)lround(pan  * STEPS_PER_DEG * PAN_GEAR_RATIO));  Serial.print(' ');
  Serial.print((long)lround(tilt * STEPS_PER_DEG * TILT_GEAR_RATIO)); Serial.print(' ');
  Serial.print(src);     Serial.print(' ');
  Serial.println(moving() ? '1' : '0');
}

float commandedPan()  { return panStepper.currentPosition()  / (STEPS_PER_DEG * PAN_GEAR_RATIO); }
float commandedTilt() { return tiltStepper.currentPosition() / (STEPS_PER_DEG * TILT_GEAR_RATIO); }

// Bring-up helper: exercises every actuator once, in an order where a
// failure tells you which subsystem is at fault. Run it with '!' the first
// time you power the rig, before running any of the tracking software.
void selftest() {
  Serial.println(F("# selftest: laser steady, then 7 Hz for 2 s"));
  laserHz = 0.0;
  digitalWrite(LASER_PIN, HIGH); delay(400); digitalWrite(LASER_PIN, LOW);
  handleLine((char *)"L7.0");
  unsigned long until = millis() + 2000;
  while (millis() < until) serviceLaser();
  handleLine((char *)"L0");

#if FINE_STAGE
  Serial.println(F("# selftest: fine stage"));
  finePan.write(FINE_CENTRE_US - 20); delay(400);
  finePan.write(FINE_CENTRE_US + 20); delay(400);
  finePan.write(FINE_CENTRE_US);      delay(300);
  fineTilt.write(FINE_CENTRE_US - 15); delay(400);
  fineTilt.write(FINE_CENTRE_US + 15); delay(400);
  fineTilt.write(FINE_CENTRE_US);      delay(300);
#endif

  Serial.println(F("# selftest: coarse pan +10 deg and back"));
  long before = panStepper.currentPosition();
  panStepper.moveTo(clampStepsPan(before + lround(10.0 * STEPS_PER_DEG * PAN_GEAR_RATIO)));
  while (panStepper.distanceToGo()) panStepper.run();
  delay(200);
  if (panEnc) {
    float moved = readAxisDeg(PAN_CHANNEL, PAN_ENC_DIR, PAN_ENC_RATIO, panZeroDeg, commandedPan())
                - before / (STEPS_PER_DEG * PAN_GEAR_RATIO);
    Serial.print(F("# encoder saw ")); Serial.print(moved, 2);
    Serial.println(F(" deg (expect ~10.00)"));
    if (moved < -5.0)     Serial.println(F("# encoder direction reversed: flip PAN_ENC_DIR"));
    else if (moved < 5.0) Serial.println(F("# pan did not turn: check belt, pulley grub screw, motor wires"));
  } else {
    Serial.println(F("# no pan encoder: cannot verify the move happened"));
  }
  panStepper.moveTo(before);
  while (panStepper.distanceToGo()) panStepper.run();

  Serial.println(F("# selftest: vibration 600 ms"));
  digitalWrite(VIBRATION_PIN, HIGH); delay(600); digitalWrite(VIBRATION_PIN, LOW);
  Serial.println(F("# selftest done"));
}
