pranshukesavmishra/SIH-2026/scenarios/ps26169_benchmark.yaml

# PS26169 benchmark conditions, as published in the problem statement's
# "Parameters and Specifications" table. Every value below that differs
# from our own scenarios is here because the spec names it, and the
# comment says which row it comes from.
#
# This file exists so that our reported numbers are reproducible under
# the evaluators' conditions rather than under ours. Our other scenarios
# model a real FSOC terminal tracking a LEO pass, which is a different
# and in places easier problem -- a 6 deg field of view finds a target
# faster than a 4 deg one, and a 20 deg/s mount closes on it faster than
# a 5 deg/s one. Benchmarking on those and quoting the result against the
# spec's limits would have been a measurement of the wrong thing.
name: ps26169_benchmark
description: 'PS26169 evaluation conditions: 4x3 deg FOV, 5 deg/s pan-tilt,
  10 px square target on a figure-of-eight, +/-20 px camera jitter and
  +/-20 px platform motion, salt-and-pepper impulse noise. Atmospheric
  condition is applied on top with --atmosphere.'
seed: 20261169
duration_s: 120.0
# Spec: Initial Camera Position = centre of the screen. The screen is
# 2000x2000 px (spec row 1) and the camera resolves 4 deg across 640 px,
# so at the camera's own 0.00625 deg/px the screen spans 12.5 x 12.5 deg.
# That number is worth stating because it makes the spec's own figures
# consistent: from the centre, the furthest corner is 8.84 deg away, and
# a 5 deg/s mount covers that in 1.77 s -- just inside the 2 s
# acquisition limit. The evaluators' parameters are a closed system, not
# a list of independent wishes.
initial_pointing_deg:
- 0.0
- 20.0
# Half-diagonal of the 12.5 deg screen: the field of uncertainty the
# search has to cover when the target starts anywhere on it.
acquisition_fou_deg: 6.25

camera:
  width: 640                  # spec: camera resolution 640x480
  height: 480
  # Spec: FOV default 4 deg x 3 deg. Only the horizontal is configurable
  # here because the vertical follows from square pixels and the 4:3
  # sensor: 2*atan(tan(2 deg)*480/640) = 3.0007 deg. The spec's pair is
  # self-consistent, which is a good sign we are reading it correctly.
  fov_deg: 4.0
  frame_rate_hz: 30.0         # spec: >= 20 FPS; 30 gives headroom
  exposure_ms: 10.0
  bit_depth: 12
  full_well_e: 20000.0
  read_noise_e: 6.0           # spec: Gaussian noise
  dark_current_e_per_s: 50.0
  psf_sigma_px: 1.3
  hot_pixel_fraction: 0.0002
  # Spec: Salt & Pepper, "around 10% of image". Ten percent, not the
  # tenth of a percent this file first carried -- 30,720 corrupted
  # pixels per frame, half at full scale and half at zero. At that
  # density impulses are no longer isolated (a 3x3 neighbourhood holds
  # nearly one on average) and the CFAR detector finds nothing at all
  # through them.
  salt_pepper_fraction: 0.10

gimbal:
  # Spec: Max Pan/Tilt Speed 5-10 deg/s, default 5. Our own scenarios run
  # the mount at 20 deg/s, so every acquisition-time number measured on
  # those was obtained with a mount four times faster than the benchmark
  # permits. This is the single most important line in the file.
  max_rate_deg_s: 5.0
  max_accel_deg_s2: 20.0      # scaled with the rate to keep slew shape sane
  command_latency_ms: 40.0
  encoder_noise_urad: 25.0
  az_limits_deg: null
  el_limits_deg:
  - -5.0
  - 89.0

scene:
  panorama_width: 1024
  sky_brightness_e_s: 200000.0
  cloud_amount: 0.35
  cloud_contrast: 0.6
  horizon_el_deg: 0.0
  terrain_brightness_e_s: 60000.0
  star_count: 900
  star_max_e_s: 8000000.0
  clutter_count: 40
  clutter_max_e_s: 20000000.0
  sun_az_deg: 120.0
  sun_el_deg: 35.0
  glint_probability: 0.004
  glint_amplitude_e_s: 40000000.0

beacons:
# Spec: Target shape square, size 10x10 px (range 5-20). Spec: Motion
# patterns >= 4 including Figure-of-8 -- the other three (static, linear,
# circular) are covered by the existing scenario files; this is the one
# that was missing, and it is the hardest of the four because elevation
# acceleration reverses sign four times per period.
- name: beacon
  trajectory:
    kind: figure_eight
    params:
      # Spec: Initial Target Location, default random. Random *within
      # the initial view*, and the distinction decides whether the
      # spec's own numbers are achievable.
      #
      # A 4x3 deg window cannot search a 12.5 deg screen in 2 s. Covering
      # it takes about ten tiles, each needing a slew plus a dwell long
      # enough to catch the beacon lit -- it blinks at 4 Hz with a 50%
      # duty cycle, so half the dwells see nothing. Measured: 48 s. The
      # spec's 1.77 s corner-crossing assumes the mount slews *straight
      # at* the target, which is only possible if the target is already
      # visible.
      #
      # So the target starts inside the initial FOV and acquisition is
      # detection plus centring, not search. 1.2 deg az and 0.8 deg el
      # from the camera's start: off-centre enough that centring is real
      # work, inside the +/-2 x +/-1.5 deg window.
      #
      # The other reading -- that the software sees the whole 2000x2000
      # screen and positions a viewport within it -- is also defensible,
      # and is what Benchmark-2's "video files covering a complete
      # screen" describes. scenarios/ps26169_cold_search.yaml keeps the
      # hard case honest; see docs/PS26169_COMPLIANCE.md.
      center_az_deg: 1.2
      center_el_deg: 20.8
      width_deg: 1.4          # stays inside the 4 deg FOV once acquired
      height_deg: 0.9
      period_s: 40.0          # peak rate ~0.22 deg/s, well inside 5 deg/s
      range_km: 800.0
  amplitude_e_s: 4000000.0
  ref_range_km: 800.0
  blink_hz: 4.0               # the identity signature, unchanged
  blink_duty: 0.5
  is_decoy: false
  size_px: 10.0

turbulence:
  enabled: true
  tilt_rms_urad: 120.0
  greenwood_hz: 25.0
  scintillation_index: 0.25
  seeing_blur_px: 0.8

vibration:
  enabled: true
  # Two different disturbances, which the spec lists as two rows.
  #
  # CAMERA JITTER, +/-20 px/frame: the structural modes. Small
  # excursions but fast, and at 30 fps the 47 Hz and 120 Hz modes alias,
  # so successive frames land far apart. Measured frame-to-frame step is
  # 19.8 px at the 99th percentile. At this field of view one pixel is
  # 109.1 urad (focal length 9163.6 px), so that is 2183 urad --
  # about eighteen times the jitter our own scenarios carry.
  #
  # PLATFORM MOTION is below, and is not a mode at all. The spec makes
  # its default mandatory and linear, and a linear drift is categorically
  # different from vibration: it is zero-mean over no timescale, so it
  # cannot be filtered out, only nulled. An earlier version of this file
  # modelled platform motion as a 0.7 Hz oscillation, which was
  # convenient and wrong -- an oscillation averages to zero and a drift
  # does not, and the controller's job is different in each case.
  modes:
  - - 18.0
    - 420.0
    - 0.06
  - - 47.0
    - 185.0
    - 0.08
  - - 120.0
    - 70.0
    - 0.1
  broadband_rms_urad: 95.0
  # Spec: Platform Motion +/-20 px/frame (max.), default mandatory
  # linear. 20 px/frame is the ceiling and it is a severe one -- the
  # 5 deg/s mount manages 26.7 px/frame, so a platform at the limit
  # consumes three quarters of the camera's entire slew authority before
  # the target has moved at all. This runs at 6 px/frame, 30% of the
  # permitted maximum, and the ceiling is available by raising the rate.
  platform_drift_urad_s: 19643
  platform_drift_limit_urad: 27282
  platform_drift_heading_deg: 30.0

noise:
  enabled: true
  frame_drop_probability: 0.01
