pranshukesavmishra/SIH-2026/(commit log)

2026-09-05 Console: default decoy field run, blurred debrief with judge summary, balanced KPIs, and About Us nav
    - Set Decoy Field (3 moving decoys + glints) as default scenario on console load
    - Pause playback and trigger mission debrief modal automatically upon run completion
    - Add high-intensity backdrop blur (28px saturate 180%) behind debrief modal
    - Add executive summary box for judges with 3 concise SIH26169 evaluation takeaways
    - Balance debrief KPI metrics into symmetrical 2-tier layout (4 primary + 3 secondary), fixing single-card wrap
    - Add prominent 'ABOUT US' button beside Close button navigating to about.html
    - Ensure PC and mobile compatibility with bottom navigation clearance
    - Sync doc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
2026-09-08 Deck: diagram-led rebuild of slides 2, 4 and 5
    Slide 2 replaces six paragraphs with a SEE / IDENTIFY / PREDICT / STEER strip,
    the 4 Hz blink-gate panel (the actual differentiator) and a live-console proof
    block. Slide 4 turns the feasibility bullets into proof tiles and risk to
    strategy pairs, each carrying its measured evidence. Slide 5 leads with the
    number the exercise exists for -- 14.7% to 99.3% link closure -- and fixes the
    garbled "measured, not asserted" line.
    Slides 1, 3 and 6 pass through pixel-identical (verified), so the team's own
    PowerPoint work on the pipeline poster and references is untouched. Every
    mandatory template pointer appears verbatim and also as an invisible text
    l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
2026-09-08 Deck: cut slide 2/4/5 text roughly in half, let the diagrams carry
    Benchmarked against published SIH winner decks (2023-2025): the effective
    ones run about 80-120 words a slide, keep the mandatory template pointers as
    visible headings, and let one large graphic do the explaining. Ours were
    running 254-340 words.
    Slide 2 drops the sub-headline and shortens every step card to a single
    line, with the diagrams enlarged to fill the space they freed. Slide 4 drops
    the strategy descriptions entirely -- the title plus its measured evidence
    badge says it. Slide 5 drops the hero paragraph and the bar sub-labels, and
    replaces the prose about cost with a relative cost bar.
    Now 143 / 170 / 200 words. F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
2026-09-08 Deck: redraw slides 2, 4 and 5 as illustrations rather than text boxes
    Slide 2 is now a single wide scene -- satellite and blinking beacon, the
    camera's field of view opening from a pan-tilt ground terminal, decoys and
    sun-glint crossing it, Earth's limb below -- with four numbered callouts of
    three words each. 70 words on the whole slide, down from 323.
    Slide 4 leads with two real charts plotted from the campaign percentiles in
    runs/mc-leo/summary.json: time-to-acquire on a 0-5 s axis marking median
    1.27 s and worst 4.0 s, and lock retention on a 90-100 % axis marking worst
    91.6 % and median 97.6 %. The risk rows lost their prose and gained icons.
    Slide 5 gains a to-scale beam-geometry di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
2026-09-08 Console: fix mobile first-screen — wordmark wrap, banner length, HUD collision
    Judges are told to check the console on their phones (online-round script:
    "judges' phones = website"), so tested docs/console.html at iPhone width.
    Found three concrete breaks:
    - The wordmark "ZERODRIFT · ZD-1" wrapped mid-word onto two lines. Fixed
    with white-space:nowrap and hides the "· ZD-1" tag under 480px.
    - The recorded-replay disclaimer ran ~90 words and wrapped across most of
    the first screen, pushing the actual product (the viewport) three
    scrolls down. Cut to one sentence plus a "Source" link.
    - The canvas HUD's "next decoy crossing..." hint (left-aligned) and the
    live µrad readout (right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
2026-09-09 Rig: multi-candidate blink tracking, motion prediction, standalone launcher
    Fixes the mini-rig demo locking onto fingers/eyes/other bright objects
    instead of the blinking phone beacon: tracks several bright candidates
    per frame and only steers toward whichever one actually matches the
    ~4 Hz blink signature, instead of just the single brightest spot.
    Adds velocity-based motion prediction (alpha-beta tracker) so a
    fast-moving beacon keeps its tracked identity and the laser leads its
    predicted position instead of lagging behind. Cleans up the on-screen
    HUD, and makes the script runnable with zero arguments (auto-detects
    the Arduino port, logs crashes to a file, shows on-screen errors)
    so it ca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
2026-09-09 Fix broken GUI packaging scripts and add missing pyqtgraph dependency
    build.bat/build.sh referenced packaging/fsoc-pat.spec, which was never
    committed -- the documented one-click build was broken for anyone who
    tried it. Adds a plain entry_gui.py (app.py can't be pointed at
    directly since it uses relative imports that break when frozen as
    __main__) and switches both scripts to a direct PyInstaller invocation.
    Also declares pyqtgraph in the gui extra, since app.py imports it but
    it wasn't listed as a dependency anywhere.
2026-09-09 Add in-browser live camera demo, reachable from the site
    The physical rig needs an Arduino, a working webcam driver and a terminal --
    too fragile to rely on when presenting. This page runs the same identity
    principle in the browser: one button, a camera permission prompt, and the
    tracker is live on any laptop with no install.
    Detection mirrors the rebuilt Python core. Rather than "find the brightest
    spot then test whether it blinks" -- which commits to the wrong object before
    the blink test runs -- every pixel is asked what fraction of its variance sits
    at the beacon frequency. Frames are normalised by their own mean and the
    residual global swing is regressed out, so a camera whose auto-exp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
2026-09-09 Fix rig laser commands missing newline, add hardware-only test button
    sendRig() wrote L1/L0 without a trailing newline. The firmware only acts on
    a line once it sees \n, so an unterminated laser command sat in the input
    buffer and got prepended to the next position command (e.g. "L1P95 T90"),
    which fails the P%d T%d parse and gets silently dropped -- so servo moves
    were being eaten whenever a laser state change preceded them.
    Also adds a TEST RIG button that sweeps both servos and blinks the laser
    with no camera or tracking involved, so a wiring/protocol problem can be
    told apart from a tracking problem in one click.
2026-09-09 Add rig axis/gain calibration -- fixes laser steering the wrong way
    A fixed sign in steer() assumed one specific camera-to-servo mounting
    orientation. Whether "beacon right of centre" should increase or decrease
    pan is a mechanical fact of how the camera and bracket are actually mounted,
    which can't be derived from the video -- it has to be set per rig.
    Adds INVERT PAN, INVERT TILT and SWAP PAN/TILT toggles (for a 90°-rotated
    camera) plus a gain slider, all persisted in localStorage since this is a
    physical property of the rig, not a per-session setting. TEST RIG now
    sweeps pan and tilt separately with narration on what to watch for, so the
    right toggle can be identified in one run instead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
2026-09-09 Make browser tracker accurate and stall-free; auto-reconnect the rig
    Three separate causes behind "poor accuracy and very slow":
    Accuracy: position came only from the coarse modulation map, where one cell
    spans several display pixels, and updated only every Nth frame. Adds a
    full-resolution brightness-weighted centroid around the lock every frame --
    weighted rather than hottest-pixel because a saturated LED is a blob of equal
    255s and picking one of them jitters. Measured error against a synthetic
    beacon falls from 14 px to 0.7 px.
    Stalls: analyse() allocated ~1.3 MB of scratch arrays per pass, several times
    a second. The resulting collections, not the arithmetic, were the periodic
    freezes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
2026-09-09 Deck: surface the in-browser live tracker; refresh PDF
    The pitch claimed a hosted replay console as the live demo. There is now a
    zero-install in-browser tracker (docs/live.html) that runs the real detection
    loop on a judge's own laptop or phone camera, which is a materially stronger
    claim -- so slide 2 (already built / caption), slide 4 (feasibility) and
    slide 6 (links) now say so.
    Kept to in-place text edits: the deck follows the mandated six-slide SIH
    template and every slide was already full, so nothing was added, moved or
    restyled. Each edited slide was rendered and checked for overflow before
    committing -- the first attempt wrapped the slide-2 caption into the
    "Measured:" line and was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
2026-09-09 Stop the false locks: confirm a peak before believing it
    The tracker was locking onto nothing. Measured on a real webcam with nothing
    in front of it, sensor noise alone reaches score 0.34 at ~3x the surrounding
    background -- past the thresholds that were in place, so noise produced locks
    that looked real.
    What noise cannot do is keep putting its winner in the same place. A peak now
    has to clear the gate on three consecutive analyses within 45 px of itself
    before it counts, which is the persistence stream the simulator's own tracker
    already uses. Acquisition and retention get separate thresholds too: strict to
    get in, lenient to stay in, so ordinary fluctuation no longer throws away a
    good l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
2026-09-09 Show whether the browser could pin the camera exposure
    Auto-exposure chasing the beacon's own blink was the root cause of wrong
    locks in the desktop version, and pinning exposure fixed it there. A browser
    often cannot pin it at all -- applyConstraints only offers manual exposure on
    some platform and webcam combinations -- so whether that defence is active
    varies by machine and was invisible to everyone, including me.
    The status panel now says which case you are in, and when exposure stays on
    auto the page says plainly that this is a browser limitation rather than a
    tracking fault, and what actually helps in the room.
2026-09-10 Update Q&A script: acknowledge the physical demo rig exists
    The team built a physical pan-tilt rig this session as a table-side
    prop. The canned "why no hardware" answer needs to stay truthful now
    that a rig will visibly be on the table during the pitch.
    Claude-Session: https://claude.ai/code/session_013HRyTqeDHmzxvp3tmEFX9n
2026-09-10 Document rig diagnostic findings from real-hardware testing
    Folds in what the local session found: tilt servo gear failure,
    software validated with zero false locks on a real webcam, and the
    Code 45 "phantom device" root cause for the COM port failures (a
    physical USB disconnect, not a driver/port-number issue). Keeps the
    next session from re-deriving this.
    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
2026-09-10 Fix HIL live console to match actual rig firmware, add auto-detect
    hil/rig.py's SerialGimbal spoke a protocol the physical firmware
    (rig_firmware.ino) never implemented -- decimal "P {pan} {tilt}" with a
    "?"/"C" query/centre handshake, vs. the firmware's integer "P<pan>
    T<tilt>" with no query support. As built, hil.live and hil.calibrate
    would silently fail to drive the real rig. Corrected the wire format,
    made reported_pointing() return last-commanded state instead of
    querying (firmware has no echo), and added a laser() helper.
    hil.live now auto-detects the serial port and camera when --port/
    --camera are omitted, runs with rough default calibration when
    hardware/calibration.yaml hasn't be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
    [rig.py]
2026-09-10 Add hardware safety limiter to live console after servo scare
    Running hil.live with no beacon present made the rig swing wildly and
    fast between extremes instead of settling -- with a tilt servo that
    just failed once already from being driven into a bind, that's not a
    cosmetic bug, it's a way to break the hardware again.
    Root cause candidates (spiral search tuned for the simulator's assumed
    frame timing vs. this webcam's real, variable capture rate; possible
    false detections on real sensor noise the CFAR threshold was only ever
    validated against synthetic frames for) are still open questions, but
    rather than chase that under time pressure, added a hardware-level
    safety net in the adapter la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
2026-09-10 Stiffen live-console detection defaults against real sensor noise
    The CFAR detector's default threshold (cfar_k=5.0) and lock_frames=5
    were only ever tuned/tested against clean synthetic frames in the 73-
    test suite. Against a real webcam's noisier sensor, that low a bar
    lets single-frame noise spikes register as detections, which the
    controller then chases -- a likely contributor to the erratic
    back-and-forth motion seen with no beacon present, on top of whatever
    the hardware safety limiter (previous commit) already caps.
    Exposed --cfar-k (default 8.0) and --lock-frames (default 8) on
    hil.live so the real threshold can be tuned against the actual rig
    without touching the simulator's tested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
2026-09-10 Restore detection-circle overlay and add live numeric diagnostics
    The rewrite of hil/live.py (adding auto-detect and the safety limiter)
    dropped the on-screen circle marker the original standalone
    rig_track.py had -- there was no way to see whether the detector was
    even seeing the beacon at all, seeing it but not converging, or not
    seeing it, which made "why is it stuck in ACQUIRE" undebuggable from a
    description alone.
    Now draws a circle on every raw detection each frame, and prints
    angular error and detection SNR both on-screen and to the console
    every 30 frames, so a report back ("err 2.1deg, snr 4.3") is actually
    actionable instead of "it's not working."
    73/73 tests still pass.
2026-09-10 Rig: regime-matched beacon detector, and hold still when there is no beacon
    Bench evidence: a blazing phone flashlight in frame produced ZERO
    detections on it and 24 detections on empty sensor grain. The cause is
    not a threshold. PointDetector's first stage is a white top-hat, which
    by construction keeps only what is SMALLER than the PSF kernel (~11px
    here). A flashlight at 1-2 m is a saturated blob 40-80 px across, so
    the opening classifies it as background and erases it, while 1-3 px
    grain survives and clears CFAR because a near-black frame has a tiny
    local sigma. The detector is correct for its design regime -- an
    unresolved source at kilometres -- and inverted for a desk rig.
    So the rig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
2026-09-10 Site: live in-browser beacon identification demo
    Adds docs/live.html — the camera demo the site never had. It opens the
    viewer's own webcam and runs the identification stage live: bright-blob
    detection, then a lock that requires BOTH a real modulation depth and a
    frequency match. Blink a phone torch at it and it goes SEARCHING ->
    CONFIRMING -> LOCKED in green; hold the same torch steady and it
    refuses, however bright. That refusal is the demonstration -- it is the
    claim the whole project rests on, made falsifiable in ten seconds on a
    judge's own laptop, with no rig, no install and no wiring to fail.
    The algorithm lives in docs/beacon_id.js rather than inline, so it can
    be tested headlessl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
2026-09-10 Recalibrate lock thresholds against real measured camera data
    Watched the deployed tracker live on the user's actual rig: a real 4.2 Hz
    beacon scored 0.22 with a 4.9x margin over background -- and was rejected,
    because LOCK_MIN was 0.36. The absolute score is not usable as a threshold on
    this camera at all: sensor noise measured earlier on the same hardware scored
    0.344, HIGHER than the genuine beacon. Any floor above 0.22 rejects real
    beacons; any floor below 0.344 lets noise through. There is no line to draw.
    The margin over the local background does separate them (noise 3.13x, beacon
    4.90x), so that carries the lock decision now; the absolute score drops to a
    sanity floor (0.12) that onl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
2026-09-10 Add pan/tilt trim for the permanently-mounted laser
    Tilt hardware is confirmed working now (new servo installed), and the
    inverted-tilt symptom the user hit is exactly what the existing INVERT TILT
    checkbox is for -- no code change needed there.
    What was missing: once the laser is fixed in place rather than repositioned
    between tests, the camera and laser no longer sit at the same point in space,
    so even perfect tracking lands the dot beside the beacon by a small, constant
    amount (parallax). That offset doesn't change with tracking accuracy and
    isn't something the algorithm can correct for on its own -- it needs a
    one-time mechanical trim.
    Added PAN TRIM / TILT TRIM sliders, persisted like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
2026-09-10 Reject ambient light flicker; fix tilt direction by default; expose depth
    Watched the deployed tracker lock onto a face: blink 0.40, 10.7x margin,
    detected at 5.0 Hz -- the exact edge of the default 3-5 Hz search band. That
    pattern is the signature of genuine periodic light (room LED flicker aliasing
    into the search range), not sensor noise, and margin over background can't
    tell it apart from a real beacon: both are real, spatially local peaks. A
    bright, reflective surface like a face shows the LARGEST ABSOLUTE swing under
    ambient flicker simply because it's bright, even though the ceiling light,
    not the face, is what's actually modulating.
    What does separate them is RELATIVE depth -- swing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
2026-09-10 Reject band-edge artifacts; fix frequency misattribution bug
    Watched a second real false lock: a face at blink 0.13, depth 0.82, detected
    2.9 Hz -- inside the default 3-5 Hz band's own gates (margin and depth both
    cleared easily), but landing at the exact edge of the searched range, same as
    the very first false lock (5.0 Hz, the other edge). Two independent real
    failures both winning at a band boundary rather than an interior point is not
    coincidence: a beacon genuinely near the selected rate produces an interior
    peak, while a peak that only ever sits at the edge means the true energy
    source is outside the searched window and this is its rolloff -- almost
    certainly mains-powered lighting ali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
2026-09-10 Fix third real false lock; find and fix the mathematical root cause
    A steady, saturated ceiling light locked (blink 0.65, depth 0.56, detected
    6.0 Hz) -- passing both existing gates cleanly. Found why: the score is a
    FRACTION of a pixel's own variance sitting at the target frequency, with no
    requirement on absolute signal size. A pixel pinned near 255 has very little
    total variance to start with, so a tiny clipping-boundary wiggle (flickering
    between "fully saturated" and "just under") can BE nearly all of that small
    variance, scoring as confidently as a genuine 12-to-205 swing. Brightness
    doesn't catch this either -- the light genuinely is bright.
    What a steady light structurally cannot do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
2026-09-10 Fix tracker locking onto its own laser (self-feedback loop)
    The camera can see the laser it's pointing. If the lock state ever flickers
    -- a marginal real signal hovering near the hold threshold -- the laser
    toggles with it, and that toggle is a perfect digital on/off with none of the
    noise real light has: exactly the kind of clean signal this analysis is built
    to reward. Screenshot showed depth 0.75, brightness 255, margin in the
    hundreds of thousands -- too clean to be a real beacon, and it was: the small
    red dot inside the lock ring was the rig's own laser reflected on the wall.
    Left unchecked this is a positive feedback loop that can sustain itself
    indefinitely once triggered.
    The fix u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
2026-09-10 Add 4:30 finals pitch script combining software demo and physical rig
    Adapts the existing 5:00, 6-speaker selection-round script (stage_script.md)
    rather than writing a new one from scratch, to keep the team's established
    voice and Q&A anchors. Compresses the software segments and adds the
    physical rig as a new segment rather than appending it.
    Builds tonight's findings directly into the script: the rig's precision is
    explicitly framed as coarse-stage-only (a $2 servo's ~17,000 microradian
    mechanical play vs the algorithm's own measured 198 microradian accuracy),
    turning the known hardware limitation into evidence the team understands
    their own system rather than a question that catches the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
2026-09-11 Mirror the live view so it reads correctly to the operator
    A webcam shows the scene as the camera sees it, which reads backwards to
    anyone watching themselves: move the beacon left, the dot on screen goes
    right. The display is now mirrored so it matches what the operator expects.
    Mirroring only the picture would have silently broken tracking: refine()
    read its search window straight out of the display canvas, so a flipped
    canvas would have made it sample the mirror image of the region and walk the
    lock off the target within a frame or two. It now samples the video element
    directly through its own small canvas, leaving it independent of whatever
    the display does.
    Tracking, steering and ever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
2026-09-11 Stop the lock marker wandering off the beacon; point the laser absolutely
    Two separate defects, both reported as "it points somewhere else".
    1. The per-frame follower had no idea what it was following. It took the
    brightest spot near the lock, every frame, including the ~4 consecutive
    frames per blink cycle when a 4 Hz beacon is DARK. With no beacon to find,
    it followed whatever the background offered and crept away a little each
    dark phase; once off target the beacon was outside the search box and it
    never came back. Measured on the bright-hall case: 0.5, then 0.6, then 0.9
    px per dark frame onto a nearby lamp, fully captured inside half a second.
    Fixed by making it a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
2026-09-11 Add a DEMO VIDEO button that plays the rig demo full screen
    Placed directly under START CAMERA on the live page, with a one-line caption
    saying what it is.
    The source recording was HEVC in a QuickTime container, which is the wrong
    format to take to a conference hall: Chrome on Windows only decodes HEVC when
    the machine has Microsoft's paid Store codec installed, and Firefox cannot
    decode it at all, so on an unfamiliar projector laptop this would most likely
    have played as a black rectangle. Transcoded to H.264/AAC MP4 (1080p, 20.5 MB,
    from 26.8 MB). Its index sat at the end of the original file, meaning playback
    could not begin until all of it had downloaded; the transcode is written with
    f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
2026-09-11 Re-encode the demo video to 720p: 20.5 MB -> 5.0 MB
    1080p buys nothing on a conference projector (most cap at 1280x800) and cost
    four times the bytes over hall wifi, which is the one network this has to work
    on tomorrow. 1280x720, H.264, still faststart. Measured 715 ms from button
    press to playable.
2026-09-11 Make the tracking radii scale with camera resolution
    LOCAL_R and FOCUS_SIGMA are really angles, written as pixel counts. A beacon
    subtends the same angle whatever the sensor resolution, so a fixed 12 px disc
    spans twice the angle on a 320-wide camera and swallows lamps it should
    exclude. Measured: 3.34% of frame width error at 320x240 against 0.07% at
    640x480 -- the same scene, the same code, purely the resolution.
    The camera is requested as width {ideal: 640}, which is a soft constraint: a
    16:9 webcam may hand back 640x360 and some hand back 1280x720 or their own
    native size, so the frame size is not ours to assume. Scaling by frame width
    makes the behaviour identical across all of them.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
2026-09-11 Guard the empty-background case in refine(); drop a duplicated variable
    Against a frame edge the search box is cropped, and if nearly all of what
    survives falls inside the local disc there is no background left to take a
    median of. The median of nothing is 0, which makes contrast equal the raw peak
    and holds the gate permanently open -- the precise failure the gate exists to
    prevent, arriving silently and only at the edges of frame. With no background
    to judge by, judge nothing: hold and wait for a better frame.
    Added two frame-edge scenes to cover it (beacon 8 px from the left and right
    borders); 17/17 now pass. Gate discrimination re-confirmed at room luma 30,
    120, 170 and 200: 64/64 dark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
2026-09-14 Draft ZeroDrift Mk2 rig: stepper coarse stage, fine stage, ground-truth accuracy logger
    Mk1 (SG90 servos) proved the identification principle but couldn't
    produce a real measured accuracy number and only demonstrated a single-
    stage gimbal. Mk2 spec adds: NEMA17 steppers for repeatable coarse
    positioning, a second fine-stage gimbal to physically demonstrate the
    actual coarse->fine architecture the pitch's numbers are built on, a
    ground-truth accuracy logger (second camera + printed target -> real
    mrad/urad error), and a vibration injector to demo disturbance
    rejection live. Firmware and logger script are drafted but not yet
    bench-tested — flagged as such in the docs.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
2026-09-14 Add AS5600 closed-loop encoder upgrade to Mk2 spec
    Steppers alone are still open-loop about actual shaft position. AS5600
    magnetic encoders give real measured feedback, closing the loop -
    noting the TCA9548A multiplexer both encoders need since they share a
    fixed I2C address. Also sets an honest accuracy expectation (low
    single-digit mrad, not the simulator's urad figures) rather than
    letting the physical rig imply more precision than it can deliver.
    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
2026-09-18 Add PROJECT_STATE.md as the portable cross-session memory
    The team wants to work from a second Claude account (Fable 5) in
    parallel without disturbing this session's progress. This is the
    single file a fresh session on any account should read first: the
    canonical numbers table with sources (so 98.3% vs 99.3% can't get
    re-confused), every open thread by workstream, and the git branching
    rules for two accounts working the same repo safely (branch per
    session, never force-push, merge via PR).
    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
2026-09-18 Add beacon + decoy unit spec, master BOM, and Fable 5 briefing
    Three deliverables the user asked for directly:
    1. Beacon build guide (docs/beacon_build_guide.md) - a dedicated
    Arduino-driven blinking LED, replacing "borrow a phone strobe app"
    with a frequency-precise, adjustable target. Firmware
    (tools/rig/beacon_firmware.ino) matches the tracker's existing
    serial-command style and times off micros() rather than delay(),
    since a drifting beacon frequency would undercut the project's own
    hard-gate modulation-identification claim. Includes a companion
    decoy unit (no microcontroller, steady-on, deliberately brighter) so
    the beacon-vs-decoy discrimination is demonstrable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
2026-09-18 Accuracy: adaptive blink-frequency estimation, calibrated verifier, honest benchmark
    Three pieces, per the cross-session accuracy brief:
    - estimate_blink_frequency(): a Goertzel bank scans the observable band
    per candidate and measures the modulation frequency (+/-0.1 Hz, tested
    1-12 Hz under noise, dropouts and arbitrary phase) instead of assuming
    4 Hz. With an agreed frequency configured the known-frequency hard gate
    is byte-for-byte unchanged and the estimate is telemetry/cross-check;
    with none configured (blink_hz=0) the estimate becomes the
    discriminator: pulsed sources separate from steady stars at whatever
    frequency they actually carry (blind-mode lock tested). Interfac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
2026-09-18 Dashboard reads the measured blink frequency; vote stays raw-scale
    - Telemetry now carries est_blink_hz / est_blink_conf (pipeline record ->
    exporter "ehz"/"ehzc" -> replay console): the ZD-1 alignment panel gains
    a "measured blink" row, showing the frequency the tracker MEASURED from
    the flux, not the configured constant. On the featured ISS recording it
    reads 4.01 Hz on 1327/1350 frames. With the hardware beacon unit this
    becomes a live cross-check: command F<hz> on the beacon, watch the
    console readout follow.
    - Verifier calibration corrected after a measured regression: applying
    temperature scaling to the in-loop vote (T=1.16) perturbed early track
    elections enough to mo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
2026-09-18 Campaign guard passes on the accuracy branch: 0/64 decoy locks confirmed
    Full 64-run mc-leo rerun on the final accuracy-work code. The
    load-bearing number holds: runs_with_any_decoy_lock = 0. Acquisition
    p50 1.27 s, max 4.0 s and retention min 91.6 % are unchanged;
    percentile decimals moved within run-to-run noise (acq p95 2.66->2.77 s,
    retention p50 97.56->97.5 %, pointing p95-median 762->768 urad). The
    deck's cited worst-case cell (0.53x-dim beacon, 1.74x turbulence) reads
    2.77 s -- still "2.8 s" at the printed precision.
    Claude-Session: https://claude.ai/code/session_01F6edPdcuuE3caLJZzAZ7fH
2026-09-18 Mk2 live software: the real engine on a real camera, on the ZD-1 dashboard
    The gap this closes: hil/live.py drove hardware with a separate,
    simpler stack (rig_detect), and the "Live Demo" web page tracked in
    browser JavaScript -- the actual engine never touched a real frame.
    Now it does, and the transfer claim is true by construction:
    - hil/engine.py: CoarseAlignmentTracker -- CFAR detector, blink gate
    with adaptive frequency estimation, IMM, Smith predictor, AI
    verifier -- driven by ArraySource (tests), VideoSource (zero-hardware
    development) or CameraSource (live UVC, wall-clock dt). Honesty
    contract enforced in telemetry: no ground truth exists off-simulation,
    so truth-referenc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
2026-09-18 Live demo: hold lock on a fast-moving beacon; say COASTING when coasting
    The reported failure, reproduced end-to-end before fixing: move the
    beacon briskly and the ring freezes at its old position while the page
    still says green LOCKED with blink 0.00. Root causes, each measured in a
    headless-Chromium harness driving the real page with a synthetic camera:
    - vel was computed and never used. Prediction now feeds forward before
    every measurement, scaled by the MEASURED inter-frame gap (cameras
    stall; the world does not).
    - Velocity was then learned from the post-smoothing residual, which
    converges to about HALF the true target speed -- every dark blink
    phase added lag. Now learned from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
2026-09-18 Terminal Mk3: scanning head, dot-closed alignment, one wire protocol
    The physical build becomes a self-contained terminal rather than a table
    demo: the camera rides on the gimbal boresighted with the laser, the Pi
    runs the pipeline on-board, and the Nano does motion only because Linux
    cannot emit step pulses with reliable microsecond timing.
    Servos are removed from the design. Mk1 stripped two of them, and a hobby
    servo's backlash is larger than the error this rig exists to measure.
    Resolution now comes from 1/32 microstepping and a 3:1 GT2 belt --
    0.16 mrad/step, ~0.5 mrad encoder-verified, and nothing to shear.
    Parallax is solved by not modelling it. Camera and laser cannot share a
    point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
    [boresight.py, rig.py]
2026-09-18 Re-budget Mk3 to a ₹6,124 student build, and correct an overclaim
    The previous BOM came to ₹26,600-42,100, which is not a student budget.
    Tier A is now the build at ₹6,124, and nothing the design's argument
    rests on was cut, because none of it costs money: the dot-closed loop
    and modulation-as-identity are software, and the encoders that make
    "accurate" a measurement rather than an adjective are ₹697 and stay.
    What was cut is margin, not capability -- Pi 5, global-shutter camera,
    TMC2209 drivers, 0.9° motors, the belt reduction and a true bandpass
    filter all move to a Tier B table that states plainly what each would buy.
    The laptop runs the pipeline; the camera still rides on the g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
    [rig.py]
2026-09-18 Add the verified Mk3 build guide PDF, diffed against the Mk2 one
    The 18 September "Beacon & Tracker" PDF describes the Mk2 design and is
    now wrong to buy from. Diffing the two lists found three things worth
    catching before money is spent:
    - MG90S servos (Rs 399) are on the old list and should not be bought.
    The fine-servo stage is deleted.
    - Diametric magnets are MISSING from the old list. It buys AS5600
    encoders but no magnets, and an AS5600 with no magnet rotating in
    front of it returns nothing. That alone would have stopped the build.
    - The 100 uF VMOT capacitors are MISSING from the old list. Omitting
    them destroys both drivers on first power-up.
    Everything else c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
2026-09-18 Realign the sketch to the tested driver, and test that they stay aligned
    The firmware rewrite earlier in this session moved the coarse wire format
    to degrees. main's hil/mk2.py -- which has a safety envelope, a dry-run
    mode and tests -- sends motor steps. Against each other they would have
    failed silently: "P400 T-200" parsed as a float reads 400, the tilt field
    is dropped, and the rig points consistently wrong with nothing in any log.
    The sketch moves, not the driver. Between a tested host and an untested
    sketch, the sketch moves. Coarse commands are integer steps again, fine
    commands are servo degrees again, soft limits are expressed in steps, and
    the "?" reply reports steps so the host n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
2026-09-18 Live demo: fix the runaway ring — prediction steers the search, measurement moves the lock
    Reported from the field with screenshots: move the light and the ring
    sails away from it, circling empty wall while the panel still reads
    LOCKED. Reproduced, root-caused, fixed at the design level.
    The defect was a positive feedback loop introduced by the previous
    motion work. Velocity was integrated into BOTH `pos` and `anchor` on
    every frame, and then `analyse()` projected the anchor forward by half a
    window again -- under a cap computed as |cand - pos| * 1.3, which grows
    with the very drift it exists to limit. So drift bought more projection,
    which bought more drift. Traced live: the ring acceler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
2026-09-18 Verification pass: fix a parts list that disagreed with itself
    Checked every claim against its source rather than restating it. Most held:
    all nine campaign numbers re-derive correctly from runs/mc-leo/summary.json,
    the seven doc-sourced figures are present where cited, every file path
    referenced in docs/ exists, and every remote branch is contained in this
    one with nothing unpushed.
    Three things did not hold.
    The parts list disagreed with itself three ways. TERMINAL_MK3.md section 2
    summed to Rs 5,944 while stating Rs 6,124, and the printed build guide said
    Rs 6,331. The row the markdown was missing was the diametric magnets -- the
    single part whose absence stops the build before it start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
2026-09-18 Fix the display transform and the track reticle, with evidence
    Installed the Qt stack offscreen so the GUI could actually be rendered and
    looked at rather than edited blind. Two defects were visible immediately.
    The display transform divided by the frame maximum. Its own comment said
    it was "a fixed stretch so brightness is comparable frame to frame
    (auto-stretch would hide scintillation)" -- the code was exactly the
    auto-stretch the comment forbade. Measured on the baseline scenario the
    sky sits at 381 DN with a robust sigma of 10.4, so dividing by a 2183 DN
    beacon mapped the sky to 231/255 and squeezed everything of interest into
    the top 24 grey levels. The view read as featureless noise.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
2026-09-18 Fix four real bugs found by static analysis and by running the entry points
    SerialGimbal was unconstructable. Its __init__ assigned from
    `counts_per_rad`, a name that did not exist in scope -- introduced by me
    in the main merge, where I kept my parameter name and main's body. Every
    construction raised NameError, so the Mk1 rig console could not start at
    all. Nothing caught it because nothing constructs the class without a
    Nano attached.
    In the same class, laser() wrote b"L1" with no newline while every other
    method terminated correctly. On the real rig the firmware holds the
    partial line and consumes the front of the next command, so every laser
    toggle silently swallowed a pointing update.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
    [engine.py, rig.py]
2026-09-18 Live demo: minimal reticle, and a readout that stops lying
    The reticle is now a thin ring with four short cardinal ticks and
    nothing else. It went through two worse versions first -- a heavy
    asymmetric double-arc that read as a broken circle, then a graduated
    scope -- and both competed with the beacon for attention. The beacon in
    this demo is a few pixels across; the figure pointing at it has to leave
    it visible. Thin stroke, small radius, clear centre, dashed while
    coasting.
    The HUD had two real defects, both measured rather than guessed.
    It overflowed. The text was drawn at fixed 12-15px fonts from a fixed
    x=110, while the canvas takes the camera's own resolution. On the 320
    wide synthet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
2026-09-18 Add the one-page buy list, routed by where each part can be got
    Splits the Tier A bill of materials three ways -- order online, local
    shop, ten-minute grocery -- with the online-only items underlined,
    because those are the ones with delivery lead time and three of the five
    are the parts that stop the build dead if they are missing.
    Routed by component type, not by the shop's actual stock: their Instagram
    and IndiaMart pages are both blocked from this environment, and the page
    says so rather than implying the shelves were checked.
    Generated from docs/data/bom_tier_a.json, the same source the full build
    guide uses, so the two cannot disagree. Subtotals reconcile to the Rs
    6,331 grand total a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
2026-09-18 Drop the 9V battery and coin cell -- wrong power source for both loads
    The user asked why the beacon needs a battery at all if the tracker talks
    to the laptop over USB. Answer: the tracker and motors are correctly
    tethered (USB, 12V adapter) and need no battery -- but the beacon and
    decoy have to be independent lights a judge can move around the room, so
    they do need their own power. That part of the BOM was right in kind,
    wrong in choice.
    A CR2032 is rated ~0.2 mA continuous; a high-brightness LED draws ~20 mA
    continuously, 100x over spec. The cell's 10-40 ohm internal resistance
    sags under that load, so the decoy dims within about two hours instead of
    running a demo day. Replaced with a 2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
2026-09-18 Fix the decoy's power supply: a white LED cannot run off 3V
    The user asked me to verify the build "will be working" rather than just
    re-send the buy list. Checking the decoy circuit's actual electrical
    numbers found a real problem, present since the original doc: a white
    LED's forward voltage (~3.1V typical) is at or above what a CR2032 or
    2xAA can deliver (~3.0-3.2V fresh, sagging fast under any load). Worked
    against the resistor already specified:
    2xAA fresh 3.2V supply -> 0.7 mA through 150R (rated ~20mA)
    2xAA mid-life 2.7V supply -> LED DOES NOT LIGHT (Vf exceeds supply)
    2xAA near end 2.2V supply -> LED DOES NOT LIGHT
    That is the opposite of the decoy's one job -- "b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
2026-09-18 Specify the vibration motor's supply rail -- it was undocumented
    Re-verified the whole build rather than re-checking only what changed
    last time. Independently re-derived the decoy fix (3xAA/68R) with a
    realistic Vf spread and real alkaline discharge landmarks instead of
    point estimates -- it holds: bright through the plateau that is most of
    the pack's life, only marginal at true end-of-life for a high-Vf LED,
    which is a battery-aging limit, not a design defect. Cross-checked the
    beacon's LED circuit again for the same class of error; still clean,
    regulated off the Nano's 5V rail.
    Checking parts of the wiring not yet audited found a real gap: the
    vibration injector's transistor and flyback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
2026-09-19 Reject impulse noise, and run the whole build from the laptop
    Two things, both found by taking the specification and the stage
    seriously.
    **Impulse rejection.** The PS26169 ablation named salt-and-pepper noise
    as the sole reason the tracker failed the benchmark: 23.7 detections per
    frame against 4.7 clean, and acquisition never achieved. Every other
    spec parameter -- field of view, slew rate, target size, jitter --
    changed nothing by comparison.
    Removing it is easy; removing it without damaging the targets took three
    attempts, each of which the tests caught:
    1. Flagging any pixel far above its 3x3 median is what a median filter
    does, and it cut the beacon's peak by 34%. Brightness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
2026-09-19 Record what impulse rejection fixed, and what it did not
    In the loop the rejection does exactly what the bench tests promised:
    detections fall from 23.7 per frame to 4.7, matching the clean-frame
    figure, and acquisition happens at all for the first time under spec
    conditions -- 4.33 s where the previous run never acquired.
    That is progress and not compliance, and the compliance note now says
    so. A second failure remains, visible in the no_saltpepper ablation
    before impulse rejection existed and unchanged by it: the boresight
    walks 21 degrees off a target whose entire path spans 1.4. The state
    occupancy shows the shape of it -- the beacon blinks at 4 Hz against a
    30 fps camera so it is dark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
2026-09-19 Read the specification table properly, and fix what that changed
    The full problem statement text contains five rows that the summary I
    had been working from did not, and one of them mattered a great deal.
    **Salt and pepper is "around 10% of image", not 0.1%.** A hundredfold.
    The single-pass impulse rejection committed earlier handled 0.1% and
    collapses at 10%: at that density a 3x3 neighbourhood holds nearly one
    corrupted pixel on average, so impulses shelter each other -- a
    corrupted neighbour makes the neighbourhood read as lit and the pixel is
    spared. One pass left 1,689 pepper pixels and the detector returned more
    detections than with no rejection at all.
    Iterating to convergence disso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
    [ps26169_benchmark.yaml]
2026-09-19 Locate the remaining failure: it is the platform drift, and it is a ramp
    Four ablations under the full specification, one disturbance removed at
    a time, and the answer is not ambiguous:
    full spec acquisition 25.3 s in FOV 60% 53,646 urad
    no platform drift acquisition 1.77 s in FOV 100% 1,026 urad = 9.4 px
    no vibration acquisition 1.80 s in FOV 100% 362 urad = 3.3 px
    So the +/-20 px/frame of structural jitter the spec asks for is already
    survivable: with it and without the drift, acquisition is 1.77 s and
    pointing error 9.4 px, inside both the 2 s and the 10 px limits. The
    linear platform drift is the whole of what remains, and 6 px/frame of it
    -- 30%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
    [ps26169_cold_search.yaml]
2026-09-19 Write the diagnosis into the compliance note
    The previous commit carried the ablation in its message but a failed
    substitution meant none of it reached the file, so the note still
    described the pre-diagnosis state. It now carries the four-run table,
    the ramp-versus-step reasoning that makes the finding actionable, and
    what not to try. Also removes a duplicate platform-motion row that
    described the superseded 0.7 Hz model.
    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
2026-09-19 Remove the last unverifiable dependency from the stage build
    The PD/QC trigger module was the wrong answer to "no wall socket". It
    works only if the power bank you happen to own supports PD or Quick
    Charge, and 12 V is not even a guaranteed PD voltage -- the standard's
    fixed steps are 5/9/15/20 V. That made a stage demo, which cannot be
    debugged live, depend on hardware nobody had verified. A 12 V Li-ion
    pack with a DC barrel output needs no negotiation with anything and
    carries the same connector the mains adapter used, so nothing else in
    the wiring changes. At ~1 A a 3000 mAh pack runs about three hours.
    Checking the list for anything else that would stop a build mid-way
    found three more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
2026-09-19 Make the pointing loop type 2, so it can track a ramp disturbance
    Correcting myself first: this note and the deck both said the controller
    had no integral term. That was wrong. It is a PI controller with rate
    feed-forward and a Smith predictor, and ki has been 0.35 throughout. The
    ramp reasoning was right and the cause was not, which matters because it
    pointed at a fix that was already there.
    What is actually true is about loop order. A single integrator gives
    zero steady-state error to a step and a finite, constant error to a
    ramp, and PS26169's platform motion is a ramp -- unmeasured, constant
    velocity, up to 20 px/frame. At ki = 0.35 the integrator must accumulate
    77,000 urad-seconds of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
2026-09-19 Put pictures on the buy list, and a stop sign on the OV7670
    An OV7670 module was about to be bought as the camera. It cannot work
    here, for three independent reasons, and none of them is visible from
    looking at the board:
    * It is a parallel DVP sensor with no USB. The pipeline runs on the
    laptop and opens the camera through OpenCV; the OV7670 exposes
    D0-D7, PCLK, HREF, VSYNC and SCCB, which no laptop can read.
    * The Nano cannot read it either. Roughly 12 MHz pixel clock against a
    16 MHz ATmega328P with 2 KB of SRAM, when one 640x480 frame is
    307 KB. That is not slow, it is impossible.
    * The bare board carries no AL422B FIFO, and even the FIFO version
    manages a few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
2026-09-19 Put scannable codes on the buy list instead of photographs
    Real product photographs cannot be fetched from here -- the environment's
    proxy answers 403 to CONNECT for general web hosts, so every image host
    is unreachable. Rather than ship drawings and call them photos, the list
    now carries eight QR codes for the parts where a wrong purchase is
    expensive or where the shop's name for a thing differs from the
    catalogue's: USB camera, diametric magnet, AS5600, A4988, TCA9548A,
    NEMA17 with bracket, the 12 V pack, and the barrel-to-screw adapter.
    A code is better than a photo for this job anyway. Scanned at the
    counter it opens dozens of current listings with today's prices, which
    one static pictu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
2026-09-19 Fix a contradiction: the wiring section said motors must be dual-shaft
    Section 2 (the BOM) has always offered single-shaft NEMA17 as the
    verified Rs 749 line item, with its own valid magnet-mounting method --
    front-mounted magnet on the platform, AS5600 on an overhanging arm. The
    wiring section's encoder note contradicted that outright: "the diametric
    magnet glues to the rear shaft end... this is the reason the motors must
    be dual-shaft -- there is no way to retrofit it if you order
    single-shaft motors."
    That statement was simply wrong, and it would have sent a builder with
    the motors actually on the purchase list looking for a rear shaft that
    does not exist on their hardware. Fixed to desc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
2026-09-19 Add a parametric 3D gimbal model, and stop assuming mini-USB on the Nanos
    Newer Arduino Nano boards, and many clones, ship with USB-C instead of
    the classic mini-USB -- confirmed in this session that at least one of
    the two Nanos in this build is USB-C. The buy list's cable line named a
    fixed pair (one USB-B, one mini-USB) as if the connector were known in
    advance; it is not, and a mismatched cable simply does not plug in. The
    line now says to check each board's port before buying, and the
    consistency test that enforced the old wording is updated to match.
    docs/cad/zerodrift_gimbal.scad is a new parametric OpenSCAD model of the
    pan/tilt assembly, dimensioned against what is actually on the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
    [zerodrift_encoder_detail.stl, zerodrift_gimbal.scad, zerodrift_gimbal_assembly.stl]
2026-09-19 Audit pass: fix the camera category, the missing charger, and a deck slide that quoted the easier number
    Four findings, all of which cost something real if left.
    **The camera line was the wrong product category.** It read "USB camera
    module, M12 mount, 12 mm lens, Rs 1,400". Priced live this session, M12
    board cameras are an industrial machine-vision category: the one we
    looked at quoted Rs 4,437, more than half this build's entire budget.
    An ordinary UVC webcam at Rs 700-900 is the same thing for our
    purposes -- cv2.VideoCapture cannot tell them apart -- and its housing
    comes off before mounting, because a webcam's swivel clip is exactly
    the flex joint section 0 exists to eliminate. The li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
    [zerodrift_gimbal.scad]
2026-09-19 Model the whole build, not just the gimbal — and find four things the parts list could not
    docs/cad/parts_lib.scad now draws every item on the BOM at its real
    catalogue size: NEMA17 with its chamfered casting and 4-wire lead, the
    A4988 with its heatsink and Vref pot, AS5600 and TCA9548A breakouts,
    the de-housed webcam PCB, the KY-008 brass barrel, an 830-point
    breadboard, the USB-C Nano, a 3x18650 pack, toggle switches, LEDs, the
    ping-pong diffuser, the AA holder. zerodrift_full_assembly.scad places
    them into the rig, the bench electronics, and the beacon and decoy
    across the room.
    Drawing parts at real size next to each other is a different activity
    from listing them, and it caught four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
    [parts_lib.scad, zerodrift_full_assembly.scad, zerodrift_head.stl, zerodrift_rig.stl]
2026-09-19 CAD: fix nine geometry faults and add an interference test
    Intersecting the rig's two kinematic groups found faults that no
    rendered view showed. The worst two would have produced a rig that
    looked perfect and could not work:
    - Both AS5600 chips sat 12 mm off the axis they were measuring. The
    arms reached part-way in and the chips were placed at the arms'
    inner ends rather than on the centreline. An AS5600 reads the
    DIRECTION of the field through its die; off-axis it still answers on
    I2C and still returns numbers, but they are not angles. Both
    feedback channels would have been dead, silently.
    - The pan encoder post was inside the pan rotation, so it turned with
    the magnet it was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
    [animate.scad, clearance.scad, geometry.scad, parts_lib.scad, zerodrift_full_assembly.scad]
2026-09-19 CAD: catch the head clipping the pan platform, and fix the test that missed it
    The previous commit's clearance test compared the frame against
    everything that moves. That is not enough. The head and the pan
    platform are BOTH carried by the pan shaft, so they were never
    compared with each other -- and they collide at +21 degrees of tilt.
    The test passed while the fault was there.
    Three groups move relative to each other, so the rig is now split
    three ways -- rig_fixed, rig_pan_deck, rig_tilt_group -- and all three
    pairs are swept.
    Two measurement bugs in the probe had to be fixed before its answers
    could be trusted, both of which quietly produce confident wrong
    numbers:
    - OpenSCAD's -D onl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
    [animate.scad, clearance.scad, geometry.scad, zerodrift_full_assembly.scad]
2026-09-19 Fix the superseded gimbal model's encoder, and rebuild the guide and meshes
    Three things in the repository still carried pre-audit geometry, and
    each of them is something a builder would reasonably trust.
    zerodrift_gimbal.scad had the same fault the full assembly did: the
    AS5600 chip 6.5 mm off the axis it measures, on an arm that reached
    only part-way in. Its "fixed" post also stood at 15-17 mm radius,
    inside the 17 mm platform that sweeps past it. This README used to
    cite that file as the place to look for the encoder detail -- the one
    dimension it got wrong. Keeping a second model that disagrees with the
    assembly about the most failure-prone measurement in the build is how
    the drift star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
    [zerodrift_encoder_detail.stl, zerodrift_gimbal.scad, zerodrift_gimbal_assembly.stl, zerodrift_head.stl, zerodrift_rig.stl]
2026-09-19 Drop the 3MF exports: OpenSCAD strips colour on mesh export
    They were added on the assumption that 3MF would carry the model's
    colours where STL cannot. It does not. OpenSCAD discards color() when
    it renders to a mesh, so the exported head model came out with 21,525
    triangles and zero colour groups -- the STL in a heavier wrapper, for
    several minutes of export time each.
    Checked rather than assumed, and the README now says so, since the
    next person to look at this will have exactly the same idea.
    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
2026-09-19 Add docs/assembly.html: the model as a scrubbable build guide
    Twelve parts fly into place in build order, each carrying the reason it
    goes where it does and the mistake it invites; then the mechanism runs
    and the model can be orbited freely. Timeline scrubs, steps are
    clickable from either the list or the timeline, and ?t=<seconds> deep
    links a moment so a slide can point at one stage instead of "press play
    and wait".
    Parts are exported one per mesh by a new part= mode in
    zerodrift_full_assembly.scad, because a fused mesh cannot be taken
    apart again -- and at zero pan and zero tilt, so the page articulates
    the two axes itself rather than showing a frozen pose. The three
    kinematic groups in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
    [base.stl, bracket.stl, head.stl, pan_encoder.stl, pan_motor.stl, platform.stl, riser.stl, standoff.stl]
2026-09-19 assembly.html: load meshes from a bundle when individual STLs are not served
    The page is also published as a Claude Artifact, where .stl is not a
    served content type, so the twelve part meshes ship there as one
    base64 bundle instead. The page now tries meshes.json first and falls
    back to fetching the individual .stl files next to it, so one source
    serves both rather than a second copy of the page drifting away from
    this one -- the failure this repository has already had twice.
    The bundle is also a single request rather than twelve.
    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
2026-09-19 assembly.html: three tabs, the targets, and a live tracking simulation
    The page covered twelve gimbal parts and nothing else. It now has three
    tabs:
    gimbal the twelve-part build, as before
    beacon & decoy the two target units, eight parts, exported from the
    same .scad -- the decoy is the control in the
    experiment, not scenery, and the build has no meaning
    without something to reject
    what it does the tracking loop, simulated live
    The simulation is a reconstruction, not a recording: a 4 Hz beacon, a
    steady and deliberately BRIGHTER decoy, impulse noise at the spec's
    density, a 4 degree field of view across 640 px, and a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
    [base.stl, beacon_case.stl, beacon_led.stl, beacon_nano.stl, beacon_switch.stl, decoy_case.stl, decoy_cells.stl, decoy_led.stl]
2026-09-19 Add the JEC lab equipment request, and record what the lab actually stocks
    Checked the IoT & Robotics Lab's published inventory against our four
    outstanding items. All 23 equipment cards, and a keyword sweep over the
    whole page text rather than just the titles:
    HD USB WebCam listed, under Sensors & Input Devices
    AS5600 absent
    TCA9548A / PCA9548A absent
    3S 12.6 V charger absent
    For context, NEMA17 and A4988 are absent too -- it is a servo and
    dev-board lab, not a precision-motion one, which is consistent with
    everything in this build having been ours to buy.
    The webcam is not a straightforward saving. Our design needs the camera
    bolted rigidly to th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
2026-09-24 Rebuild the live-demo tracker; declutter the console debrief
    Live demo (docs/live.html, docs/tracker-core.js):
    - New tracking core with no DOM, benchmarked headlessly by
    tools/sim/live_tracker_bench.mjs against a synthetic room (lamp,
    window, monitor, 5.35 Hz flicker, moving person, auto-exposure,
    frame jitter, wrong-rate blinkers). Identifies the beacon by the blink
    on each light's own track, or by switch-on events a period apart, then
    follows it with a phase-locked beacon filter. 14/14 gating scenarios
    pass: acquisition 0.55-1.1 s, held 94-100%, no lock with no beacon.
    - Professional HUD: corner brackets, trail, direction vector,
    boresight line, az/el tag; decoys labelled STE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
2026-09-24 Home page: MK1 and MK2 side by side in live 3D; trim site copy
    - New HARDWARE section on the home page: MK1 (servo rig, modelled from
    the demo video) and MK2 (stepper terminal, from the project's CAD
    meshes), both tracking a 4 Hz beacon. Drag to rotate, click then
    scroll to zoom. Renders only while on screen.
    - Shorter copy on the home and about pages; removes the
    "sub-microradian" claim (median error is ~200 urad) and the stale
    "73 / 73 tests" (250 pass).
    - Console help popup cut to five lines.
    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
2026-09-25 Live tracker: accurate in lit rooms, faster on turns; exposure control
    Tracker (docs/tracker-core.js)
    - One brightness estimator for every blink sample (mean at the light
    minus a ring just outside it), so the dark phase of a torch in front of
    a white wall reads as the deep swing it is.
    - Seeds must stand above their own surroundings, not just the darkest
    nearby block; seed bar scales with the headroom left above a bright wall.
    - Blink test judged on the swing; the lit-level floor eases off as the
    wall nears saturation (a white screen against a white wall).
    - Wrong-rate veto needs real on/off switching and, on the lock, a still
    lock: a drifting track or a fast sweep no longer reads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
2026-09-25 Site: four pages, MK2 scene with beacon and decoy, logos, less text
    - Four pages only (Home, Console, Live Demo, About). 3D Assembly link
    removed; _redirects sends /assembly, /demo and /rig to live pages.
    - Home MK2 scene: real beacon (blinking LED, 4 Hz) and brighter steady
    decoy from the CAD meshes, precise head, lens, laser; legend, and a
    four-row MK1 vs MK2 comparison (motors, camera, feedback, aiming).
    - ISRO and SIH 2026 logos (official template art) on Home, About and
    Live; small versions in the footers.
    - About: headline numbers match Home (1.27 s median, 98.3 % featured
    run); duplicate headings, CTA and per-member department lines cut.
    - Console and Live copy trimmed.
    Co-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
2026-09-25 Live tracker: stop false locks on faces and clutter; MK2 USB camera button
    On a real webcam the previous tracker locked faces, shirts and shelves at
    2.8-3 Hz (the bottom of the band) and would not let go. Reproduced in new
    real-room bench scenes (busy shelves, a moving operator, webcam noise):
    1057-1154 false-lock frames in 40 s with no beacon.
    Tracker: back to the PR #7 core -- the version confirmed on a real camera
    in the dark -- plus:
    - an onset chain link counts only if the light switched OFF again within
    the cycle (mean level at the light); objects uncovered by a moving hand
    or head switch on and stay on
    - one more on-schedule flash before believing a chain in a bright scene
    - stro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
2026-09-25 Live page: RECORD TEST CLIP; replay real clips through the tracker
    - RECORD TEST CLIP (Settings): saves 15 s of the raw camera feed (no
    overlay) as webm, named with the beacon rate and camera.
    - tools/sim/replay_clip.mjs: decodes a clip at its own frame timestamps,
    runs docs/tracker-core.js exactly as the live page does, writes a
    per-frame log, a summary and an annotated video of every lock.
    - Bench: real-room scenes (busy shelves, moving operator, webcam noise,
    close flash glare) for regression checks.
    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
2026-09-26 MK2 build guide (web + PDF + 3D), rate-selective tracker, rig fixes
    - docs/build.html + ZeroDrift_MK2_Build_Guide.pdf: parts, tools, safety,
    mechanical steps with checks, wiring diagrams, 40-wire checklist,
    firmware flashing, serial bring-up, website hookup, calibration,
    troubleshooting. Linked from the home MK2 section with the 3D assembly,
    which is published again.
    - Tracker locks only the set BEACON RATE (+-10%): off-rate lights
    (3/5 Hz at a 4 Hz setting) are refused and a lock that drifts off rate
    is dropped; the displayed rate is the measured switch-on rate.
    - Live page: camera restarts after STOP; MK2 DRIVE ratio select.
    - Firmware: encoder datum set at power-on (status use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
    [mk2.py]
2026-09-26 MK2: tilt-only belt option, Amar shopping list with belt upgrade
    - Live page MK2 DRIVE now takes a ratio per axis ("Pan direct · tilt
    belt 3:1" and both-belt options); limits, test motion, closed loop and
    the gimbal readout use the matching axis. Old single-ratio settings
    still load.
    - docs/submission/ZeroDrift_MK2_Amar_Shopping_List.pdf: every missing
    part with the name to ask for and what to check, what is already in
    hand, analysis of the two reference turrets, and the belted-tilt
    drawing with belt length -> centre distance.
    - Build guide points to the tilt belt option and the shopping list.
    Claude-Session: https://claud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
2026-09-26 MK2 guide: beacon and decoy chapters, power chapter, short shopping list
    - Build guide: detailed beacon (9A) and decoy (9B) chapters with circuit
    and assembly drawings; a power chapter (laptop USB for logic, 12 V pack
    or adapter for the motors, the B3 charger never on the rig); a red
    steady decoy with 100 ohms; parts matched to what is in hand; tonight's
    build order; demo layout and script; direct drive only.
    - Shopping list PDF cut to 6 must-buy items with shopkeeper descriptions.
    - The long list with the tilt-belt option becomes a separate
    ZeroDrift_MK2_Belt_Upgrade.pdf.
    Claude-Session: https://claude.ai/code/session_013HRy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
2026-09-26 3D assembly: fix a quote that broke the page script
    An apostrophe inside a single-quoted step description stopped the module
    from parsing, so the page sat on "loading geometry" with an empty step
    list.
    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
2026-09-26 Final MK2 shopping list; build pages team-only
    - Shopping list: 21 items plus 3 only-if-needed, covering the encoder
    arms, platform and discs (clear acrylic + cutter), posts, risers, head
    standoff, base legs, boxes for beacon/decoy/head, red filter, glue and
    tape.
    - Build guide parts table and mechanical steps use exactly those parts.
    - 3D assembly texts match the build (red steady decoy, box sizes, posts).
    - Home page no longer links to the build guide, its PDF or the 3D page;
    build.html and assembly.html carry noindex (meta and X-Robots-Tag), as
    do the MK2 build PDFs.
    Claude-Session: https://claude.ai/code/session_013HRyTqe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
2026-09-26 Shopping list verified against every build step
    - Pan motor screws M3 x 16 (through the base plus spacer nuts; x 10
    barely engaged), base legs M4 x 80 (x 60 left ~5 mm under the motor).
    - Added AA batteries for the decoy, an Allen key set for the coupling
    grub screws, and solder wire; phone charger / power bank for the beacon
    listed under "from home".
    - Guide and 3D page use the same sizes.
    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
2026-09-26 Home MK1/MK2 cards: PHOTO · VIDEO · 3D tabs
    - Each rig card has a tab switch at top left; 3D stays the default.
    - MK1: photo (frame from the demo video) and the demo video, with a WebM
    copy for browsers without H.264. Media loads only when its tab opens.
    - MK2: media/mk2_photo.jpg and demo-mk2.mp4 show as soon as they exist;
    until then the tab says it is recorded after the build.
    - MK2 3D decoy is now a steady red light, matching the real decoy; the
    legend moves under the tabs on narrow screens.
    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
2026-09-26 MK1 demo video: remove the audio track
    Video stream copied unchanged; the site plays it silent everywhere (home
    page VIDEO tab and the Live page's MK1 DEMO VIDEO).
    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
2026-09-26 Live page: dark-room note and RED BEACON FILTER (opt-in)
    - Note above the camera view: works best in a dark or dim room; in a
    bright room turn on RED BEACON FILTER or use an optical red filter.
    - RED BEACON FILTER checkbox in Settings (off by default, remembered per
    browser). With it on, the tracker scores each pixel by
    max(2R - G - B, luma - 60): a red LED stays bright while white walls,
    windows and lamps drop by 60 and stop seeding blobs. A white beacon
    (phone screen) still works with it on.
    - Bench: COLOR=1 renders the beacon as a red LED in a warm-lit room;
    RED=1 turns the filter on. replay_clip.mjs takes --red.
    Claude-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
2026-09-26 RED BEACON FILTER: bench results, clearer note, build guide step
    Bench (seed 0, 38 scenes): red LED beacon with the filter off 22 pass /
    12 fail; with it on 31 pass / 3 fail, every lit and bright scene passing
    and no false locks. White beacon: 28 pass either way, so the filter stays
    opt-in (the phone beacon screen flashes white).
    The live-page note and the build guide now say: using the red LED
    beacon, turn RED BEACON FILTER on.
    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
2026-09-26 MK2: picture build guide for the parts on hand; tilt encoder optional
    - 16-card illustrated guide (PDF + PNG): discs glued straight onto the
    motor shafts with M-Seal, magnet on the shaft tip, no coupler needed.
    Linked only from the hidden build page; noindex headers added.
    - Firmware tracks pan/tilt encoders separately, so a rig with only the
    pan AS5600 still runs closed-loop on pan (reports encoders=pan).
    - Live page accepts encoders=pan|tilt as encoder-present.
    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
2026-09-26 Picture guide: atomic micro-steps + tools list per page
    Each of the 16 cards now lists exact tools/parts needed and breaks its
    steps down to single actions (one screw, one wire, one nut at a time)
    instead of 3 broad steps, per user feedback that the old version moved
    too fast to follow. Fixed a layout bug where the added content caused
    flexbox to silently compress (and clip) the illustration box on cards
    whose text now overflowed the fixed page height; tightened header/
    steps/check/footer sizing so every card fits with margin to spare.
    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
2026-09-26 Picture guide: add optional bonus card linking to the 3D assembly view
    New 17th card (marked clearly optional, nothing to build) shows how to
    open the hidden 3D assembly page from build.html, drag to rotate, and
    click a part to isolate it -- a companion resource for double-checking
    a confusing step. Guide stays hidden/noindex as before.
    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
2026-09-26 Picture guide: put exact fastener sizes on the drawings themselves
    M3x12-16mm (base-to-motor) and M3x40mm (stilts) now appear directly in
    the callout labels on cards 3 and 6, alongside the existing per-page
    tools line, so the size is visible on the diagram, not just the text.
    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
2026-09-26 WIP checkpoint: 3D assembly rework in progress (no-coupler geometry)
    Committing the in-progress state of the background 3D-assembly update
    so the working tree is clean -- this is not the finished work. The
    task (rewriting docs/assembly.html + docs/rigs3d.js + docs/cad geometry
    to match the current no-coupler, M-Seal build, plus dimension/wiring
    detail and step navigation) is still running and will add further
    commits, open its own PR, and merge when done.
    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
    [animate.scad, base.stl, base_legs.stl, bracket.stl, clearance.scad, geometry.scad, geometry_legacy.scad, head.stl]
2026-09-26 Picture guide: fix real ordering bug on card 6 (top motor/bracket)
    The old steps had you push 3 stilt screws through the disc before
    knowing where the L-bracket's own foot holes actually sit, so there
    was no way for them to line up. Reordered: mark through the bracket's
    own holes onto the disc first, then drill and add the stilts there.
    Also called out that the 4 screws bolting the motor to the bracket's
    standing leg thread straight into the motor's tapped holes with no
    nut, unlike every other fastener in the guide -- the likely actual
    source of the user's confusion while wiring/mounting the top motor.
    Claude-Session: https://claude.ai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
2026-09-26 3D assembly: follow card 6 (stilt holes marked through the bracket)
    Stilt holes are marked through the bracket foot's own holes and drilled
    at stage 6, not cut with the disc; the tilt motor's M3x6 screws go
    straight into its threaded holes with no nuts. The bracket foot stays
    clamped between a nut below and a nut above on each stilt, as the
    guide's drawings show.
    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
2026-09-26 Picture guide: card 6 nut count now matches the 3D model (3 per stilt)
    The 3D-assembly agent's report flagged that card 6's text described 2
    nuts per stilt while its own drawing (and the just-updated 3D model)
    use 3: one against the disc to steady the screw, one to set the
    bracket foot's height, one to clamp it down. Rewrote the steps to
    match, numbering them nut #1/#2/#3 for clarity.
    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
2026-09-26 Build guide: sync section 4 + parts list with the no-coupler method
    docs/build.html still described the abandoned flange-coupling build
    (sections 4.3, 4.6, 4.8, 4.9, the parts checklist, and the exploded
    hero image/caption) even though the picture guide, 3D assembly and the
    shopkeeper conversation all moved to gluing the discs onto the shafts
    with M-Seal hours ago. Rewrote those sections to match:
    - 4.3: pan disc glued onto the shaft (M-Seal), magnet on the shaft tip.
    - 4.6: stilts marked from the L-bracket's own holes, 3 nuts each.
    - 4.7: tilt motor bolts straight into its own threads, no nuts.
    - 4.8: tilt disc same M-Seal method; sensor explicitly optional
    tonight (firmware runs pan-only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
2026-09-27 Add 3D head-box animation (camera + laser box on the tilt motor)
    New hidden page docs/headbox.html: a 13-step three.js animation of the
    head box, motor on the LEFT. It shows the M-Seal ring and small disc on
    the tilt shaft, then the 6 acrylic panels with their holes, the webcam
    (clip folded) inside, and the KY-008 laser through the front hole. It
    ends with the 2 screws that hold side E to the disc and a +/-18 degree
    nod. Each step lists its dimensions, with labels on the parts. The page
    has prev/next, play and explode controls. Linked only from build.html,
    noindex like assembly.html.
    Claude-Session: https://claude.ai/code/session_013HR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
2026-09-27 Wiring animation + head box and wiring tabs on the 3D pages
    - New hidden page docs/wiring.html: 13-step wiring animation. Each step
    draws its new wires and dims the earlier ones: USB, Nano 5V/GND to
    the rails, driver jumpers, VDD, STEP/DIR (D2/D3 pan, D4/D5 tilt),
    coil pairs, 12 V switch, VMOT + 100 uF, Vref, multiplexer on A4/A5
    with the pan AS5600 on channel 0, laser S->D7, then power-on test.
    Pins match rig_firmware_v2.ino. Show-all toggle, prev/next/play.
    - assembly.html tab bar gains 'head box' and 'wiring' (links); the
    head box and wiring pages carry the same five tabs and link back to
    assembly.html?tab=... so all five views are reachable from each.
    - build.html button +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
2026-09-27 Head box: open tunnel for the real webcam; new 'wiring 3D' tab
    Head box (headbox.html). The webcam's clip does not fold flat; it
    sticks out about 25 mm behind the camera. So the box is now a 4-panel
    tunnel: floor, lid, left E (on the disc) and right F, with the front
    and back open. The camera sits flush with the open front, and the clip
    lies on the floor and sticks out of the back, cable-tied. The KY-008
    is on foam tape on top of the camera, as built. The front and back
    panels are gone. A balance check was added before the 2 screws go in.
    New hidden page wiring3d.html. The whole rig and the breadboard are in
    3D, and every cable draws itself in, step by step, from the part it
    starts at. That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
2026-09-27 Separate 3D build animations for the beacon and the decoy
    New hidden page docs/targets.html (?t=beacon | ?t=decoy). Each build
    opens on the finished target, then builds it step by step, with labels
    and dimensions:
    - common: cut the ping-pong ball in half along a tape line (score, then
    snip; no flame), one half per target, sand flat; identical 100 x 64 x
    35 mm acrylic boxes; 5 mm LED hole in the lid centre
    - beacon (13 steps): upload beacon_firmware.ino first, 220 ohm on the
    LED long leg, D9 and GND wires, lid down over the LED, dome glued,
    power bank, LED blinks at 4 Hz in the animation, check LOCKED 4.0 Hz
    - decoy (14 steps): 3xAA holder (cells last), switch in the wall,
    + -> swit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
2026-09-27 Add preview.html: the whole MK2 demo in one 3D scene
    10 steps: one laptop, two USB cables (rig Nano + webcam), wall power via
    an extension board, beacon and decoy on their own power, the live laptop
    screen drawn from the head camera, the tracking loop, moving and covering
    the beacon, and the optional white light. Preview tab added to every 3D
    page; noindex headers and a build page button.
    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
2026-09-27 Add local-session handoff: CLAUDE.md, beacon debug notes, flash script
    CLAUDE.md points a local Claude Code session at docs/LOCAL_HANDOFF.md, which
    records where the beacon debugging stopped (LED fine on 5V, dark on D9,
    upload never confirmed) and the next steps. tools/rig/flash.sh compiles and
    uploads beacon/pin-test/rig sketches with arduino-cli (old bootloader first)
    and prints the serial output; pin_test.ino blinks D2-D13 to isolate the fault.
    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
2026-09-28 Home MK2 card: an as-built digital twin of the stepper terminal
    Replaces the CAD-mesh MK2 with the rig as the team built it, part by
    part in real millimetres: base on four legs, pan NEMA17 under it, the
    M-Seal disc with the magnet under the AS5600, three M3x40 stilts with
    their nuts, the L-bracket and tilt NEMA17 on the left, the open head box
    with the webcam, its tied clip and the KY-008. Every breadboard jumper
    is drawn (Nano, two A4988s, TCA9548A, 100 uF caps, 12 V in), and the
    cables on moving parts bend as the head turns.
    The beacon is now a phone blinking its torch at 4 Hz; the decoy is the
    18650 box with its switch and 1 kOhm LED. The rig runs the real
    sequence: search, lock, follow,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
2026-09-28 Wiring plan: every wire numbered, exact holes (shared by 2D, 3D, PDF)
    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
2026-09-28 Local handoff: bring up MK2 motors (AS5600 later)
    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
2026-09-28 SOP page, Console test record, home video text, new slides 2-3
    - sop.html: ZD-SOP-001 standard operating procedure (simulation test,
    live tracking, MK2 terminal, shutdown, acceptance, faults, records);
    linked as SOP after CONSOLE on every public page, desktop and mobile.
    - Console debrief: TEST RECORD table, TC-01..TC-09 with fixed acceptance
    criteria; measured values computed from the logged frames of the run.
    - Home: text beside the software video now states what the recording shows.
    - Slides 2-3 rebuilt to the SIH 2026 template and winning-deck guidance:
    architecture with three input modes, full software flowchart of the
    engine's real state machine. PDF + HTML source in docs/sub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
2026-09-28 SOP graphic redesign, SOP last in the menu, slides 2-3 v2, wider MK2 orbit
    - sop.html rev 1.1: graphics-first layout: system illustration, mode
    cards, the engine flowchart, state strip, equipment matrix, hazard
    cards, steppers with verify chips, acceptance table with bars.
    - SOP link moved after ABOUT US on every public page (desktop + mobile).
    - Slides 2-3 v2: icon-led problem / solution / UVP, tech stack badges
    (every item is used in the repo), proof strip. PDF replaced.
    - Home MK2 3D: orbit the centre of the whole bench from further out so
    the laptop stays in frame; fog pushed back to match.
    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
2026-09-28 SOP v2 (light theme, full forms, proofs); MK2 laser dot + hover labels
    - sop.html rev 2.0: light theme, Space Grotesk / Inter / JetBrains Mono
    type scale, bold key points, every acronym written out (glossary +
    first use), and a proof beside each claim: real Console test record,
    real pytest result, the unedited live-demo recording, the ISS-pass
    convergence chart, the MK1 hardware photo, the sensor build card, and
    SVG diagrams for the 4 Hz check, the 64-run decoy result and the 12 V path.
    - MK2 twin: the laser dot gets a halo and a pulsing ring (page view only;
    the simulated webcam does not see them).
    - MK2 twin: hover labels for 13 parts (hotspots() + overlay in rigs3d.js).
    Co-Au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
2026-09-28 Slide 3 v3: flowchart + redrawn core pipeline + tech stack and proof on one page
    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
2026-09-28 docs: add Windows setup + browser-only live test path to motor handoff
2026-09-28 MK2 wiring sheet without a breadboard (22 numbered wires, bus blocks, checklist)
    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
2026-09-28 SOP v3: live MK2 3D/photo/video hero, proofs plotted from real logs, video for states, software logos, first-person voice, MK1 to MK2 history
    - Hero: the home page's MK2 viewer (rigs3d.js now runs with MK2 only)
    - Removed the full-forms section and the equipment table
    - Blink + 64-run proofs are matplotlib plots of telemetry_decoys.json and runs/mc-leo/campaign.json
    - States explained next to the unedited webcam recording
    - Software section: official logos (simple-icons) of the tools the code really uses
    - Safety rewritten in our voice, with the real wiring sheet as proof
    - MK1 as history, MK2 as focus (photo/video show 'coming soon' until the files exist)
    - Procedures trimmed; records reduc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
2026-09-28 Demo video v2 build files (motion scenes, frame capture, assembly)
    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
2026-09-29 Site deep scan fixes: phone nav on Live, meta descriptions, modelled label on 99.3%, no dev text or localhost probe on the public site
    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
2026-09-29 MK2 full breadboard wiring picture (56 wires) and vibration motor sheet; vibration circuit added to the master wiring plan
    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
    [breadboard_wiring_gen.py, vibration_sheet_gen.py]
2026-09-29 Wiring: 3-in-1 PDF (breadboard sheet, vibration motor, dark connection diagram)
    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
    [connection_diagram_gen.py, vibration_sheet_gen.py]
2026-09-29 Note tonight's hardware findings: driver 1 damage, unset Vref, thin-wire melt, breadboard rail gap, DTR-reset test gotcha
2026-09-29 Home: demo film section under the hero; add real-footage flash-cut build script
    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
2026-09-29 Add 100 s end-to-end ISRO field simulation video and its Three.js source
    Code-rendered visualisation of how the virtual-camera tracker would work in the field:
    orbit prediction, mobile terminal slew, beacon vs decoy rejection, closed-loop lock,
    hand-off to the fine stage. On-screen numbers are from PROJECT_STATE.md section 2.
2026-09-29 Site: theater section for the 3D simulation on Home, camera settings drawer on Live, YouTube demo side screen on SOP, MK2 'coming soon'
    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
2026-09-29 Upgrade ISRO simulation video graphics (v2)
    Sunrise-over-Earth opening with lens flare, moving cloud layer and sunset-tinted
    atmosphere; detailed satellite (foil bus, framed panels, dish, star trackers,
    telescope sunshade); rounded van with clearcoat paint, livery, light bar, moon
    shadows, headlight beams; detailed gimbal; operator laptop that switches from
    SEARCH to LOCKED; rocks and grass; film grade (grain, lens fringing); sky plot
    in the camera view and a fine-stage capture animation. Numbers unchanged.
2026-09-29 3D simulation: fix label overlap in the link scene (76-86 s) and re-render it
    'FINE STAGE · CAPTURED' now sits under 'Satellite optical terminal' instead of on
    top of it. Only the link scene (frames 2250-2579) was re-rendered and spliced in;
    the rest of the video is unchanged.
    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
2026-09-29 ISRO sim source: supersampling (SS=), lit opening Earth, mast hidden through lock scene
    sim.js: ?ss=N renders WebGL and HUD at N x resolution; opening camera angle
    is configurable (?a0=&a1=, default now shows the sunlit Americas behind the
    title); antenna mast stays hidden for the whole lock scene (61-75 s).
    render.mjs: SS env var sets deviceScaleFactor. The published video in
    docs/media is not re-rendered from this yet.
    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
2026-09-29 Live: transparent glass camera-settings drawer, icon-first, toast feedback, engine button only when reachable
    Every control is tested: beacon rate 3-6 Hz, red filter, brightness and blink-depth sliders,
    15 s test-clip recording (saves a file), close by X and Esc, on desktop and phone widths.
    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
2026-09-30 Website: globe intro, guided tour, MK2 marked proposed, new Home order; Plan Urena build pack (#43)
    Home
    - Loading intro: Earth grows from a point, glides into the hero, UI fades in
    - Order: hero > simulation > software recording (video left, text right) > highlights > numbers > hardware > engine > film
    - MK1 card opens on Video, plays only on screen, then cycles 3D (10 s) > Photo (5 s) > Video
    - MK2 card blurred and dimmed with a "Proposed idea · Working on it · Coming soon" ribbon; MK1 tagged current working prototype
    - Guided tour bar (Home > Console > Live > SOP > About) and a next-step card on every page
    - Watch it decide: 60 fps render, scope reticle, no lag
    Other pages
    - Console de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
    [00_test_coupon.step, 00_test_coupon.stl, 01_base_hub.step, 01_base_hub.stl, 02_leg_1.step, 02_leg_1.stl, 02_leg_2.step, 02_leg_2.stl]
2026-10-03 Website: new Engine section, decoy-field numbers, MK2 removed; MK3 tower build pack (#44)
    * Home: replace Engine section with the simulated camera view (watch.js)
    - "Watch it decide": 4 x 2.5 degree camera view, 4 Hz beacon vs steady decoy,
    blink scoring, type-2 loop lock, and a Cover the beacon button that shows
    prediction while the beacon is dark (never jumps to the decoy)
    - Side panel: tracker state, live numbers, aim-error graph; phone layout
    - Remove the unused decide.js; keep tracker-core.js for the Live page
    * Numbers to the decoy-field run; MK3 towe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
    [00_test_coupon.step, 00_test_coupon.stl, 01_tripod_base.step, 01_tripod_base.stl, 02_tower_sleeve.step, 02_tower_sleeve.stl, 03_tower_cap.step, 03_tower_cap.stl]
